BehrensG/ETH3CDAQ1/hardware/project/ETH3CADC1/ETH3CADC1.kicad_pcb

## KiCad design hardware/project/ETH3CADC1/ETH3CADC1.kicad_pcb (2021-01-28)

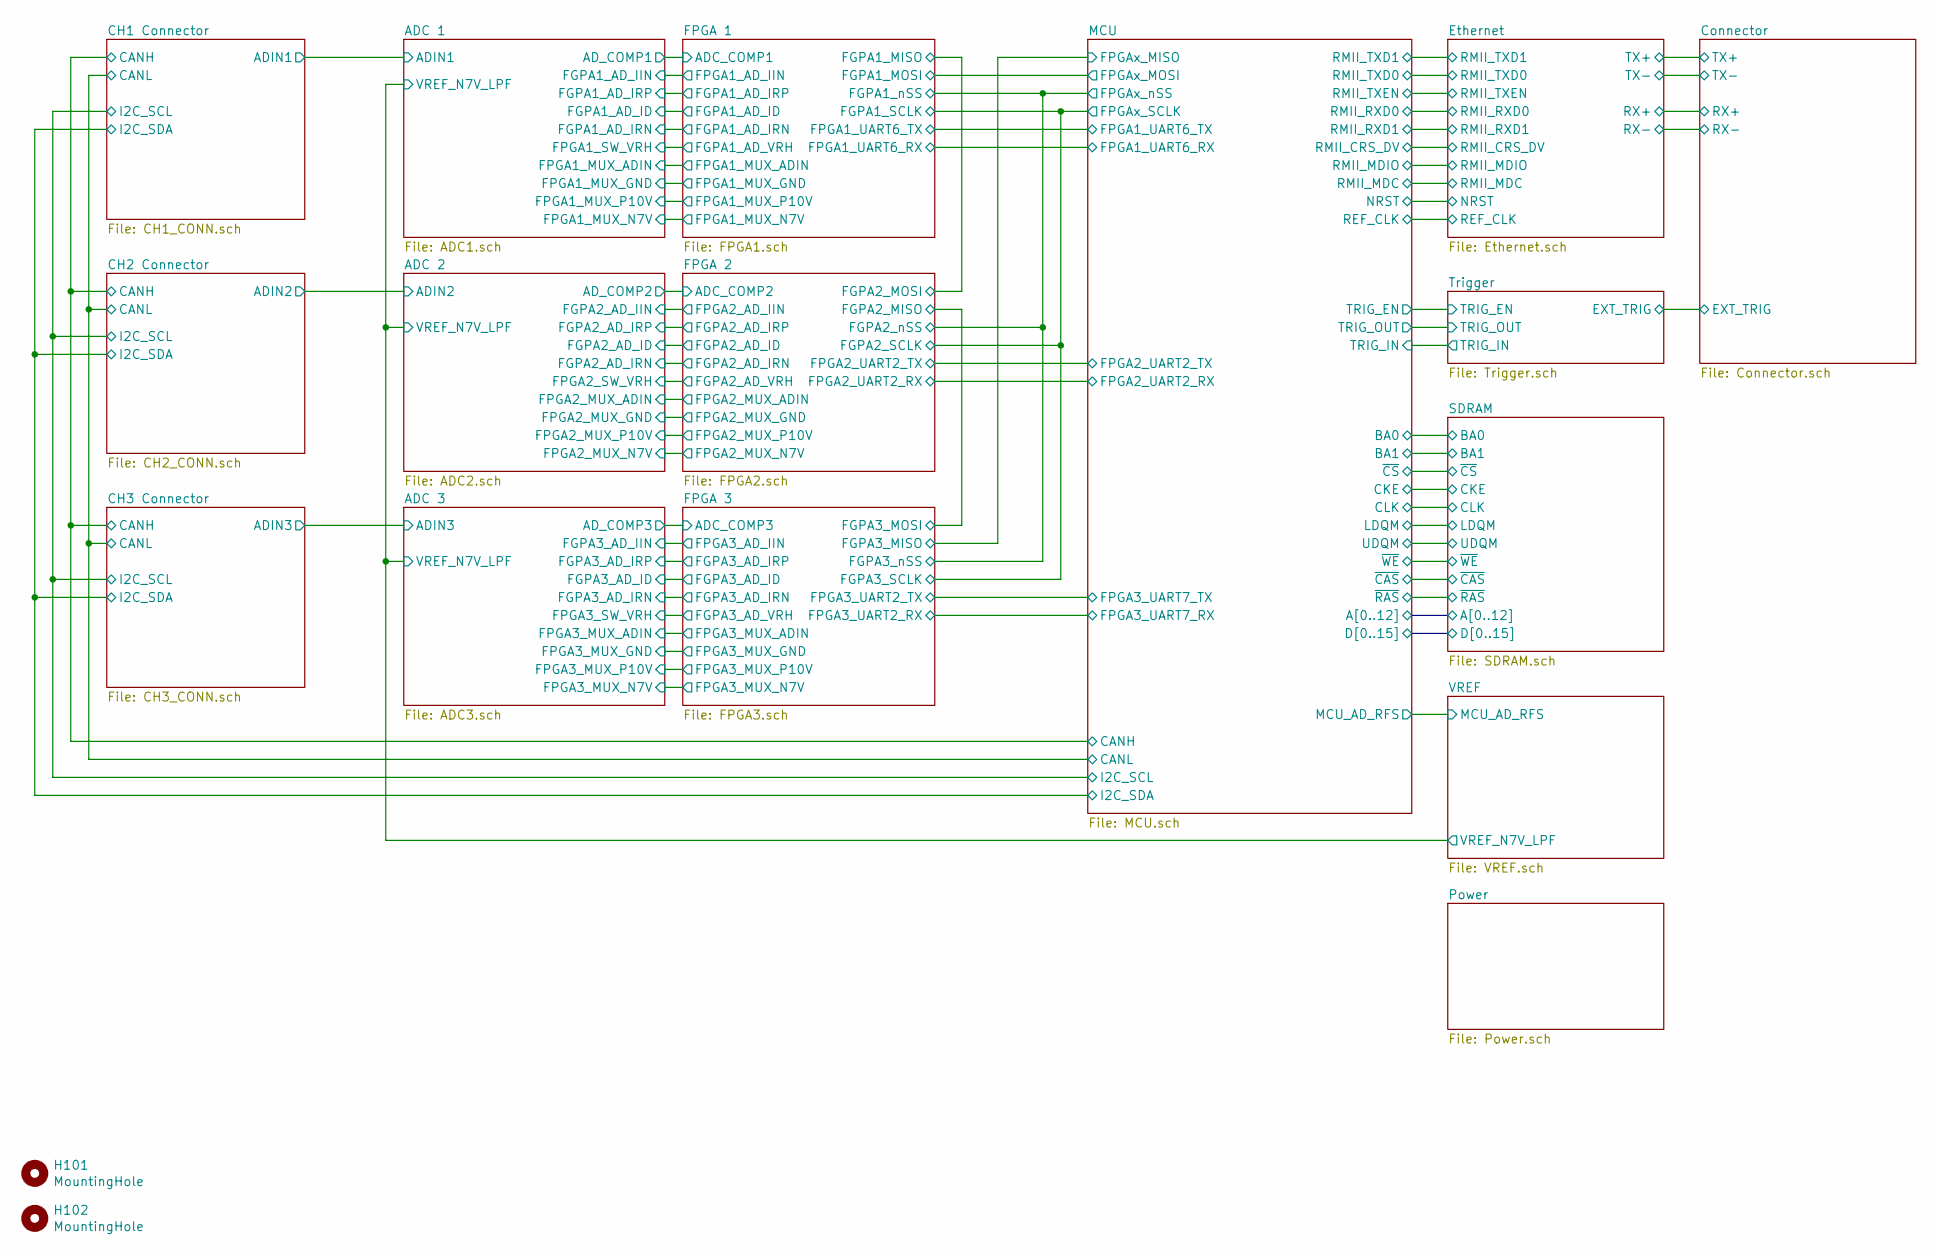
[picture p1: schematic ETH3CADC1.sch]

Parts:
H101, H102: MountingHole; MountingHole_3.2mm_M3_DIN965_Pad

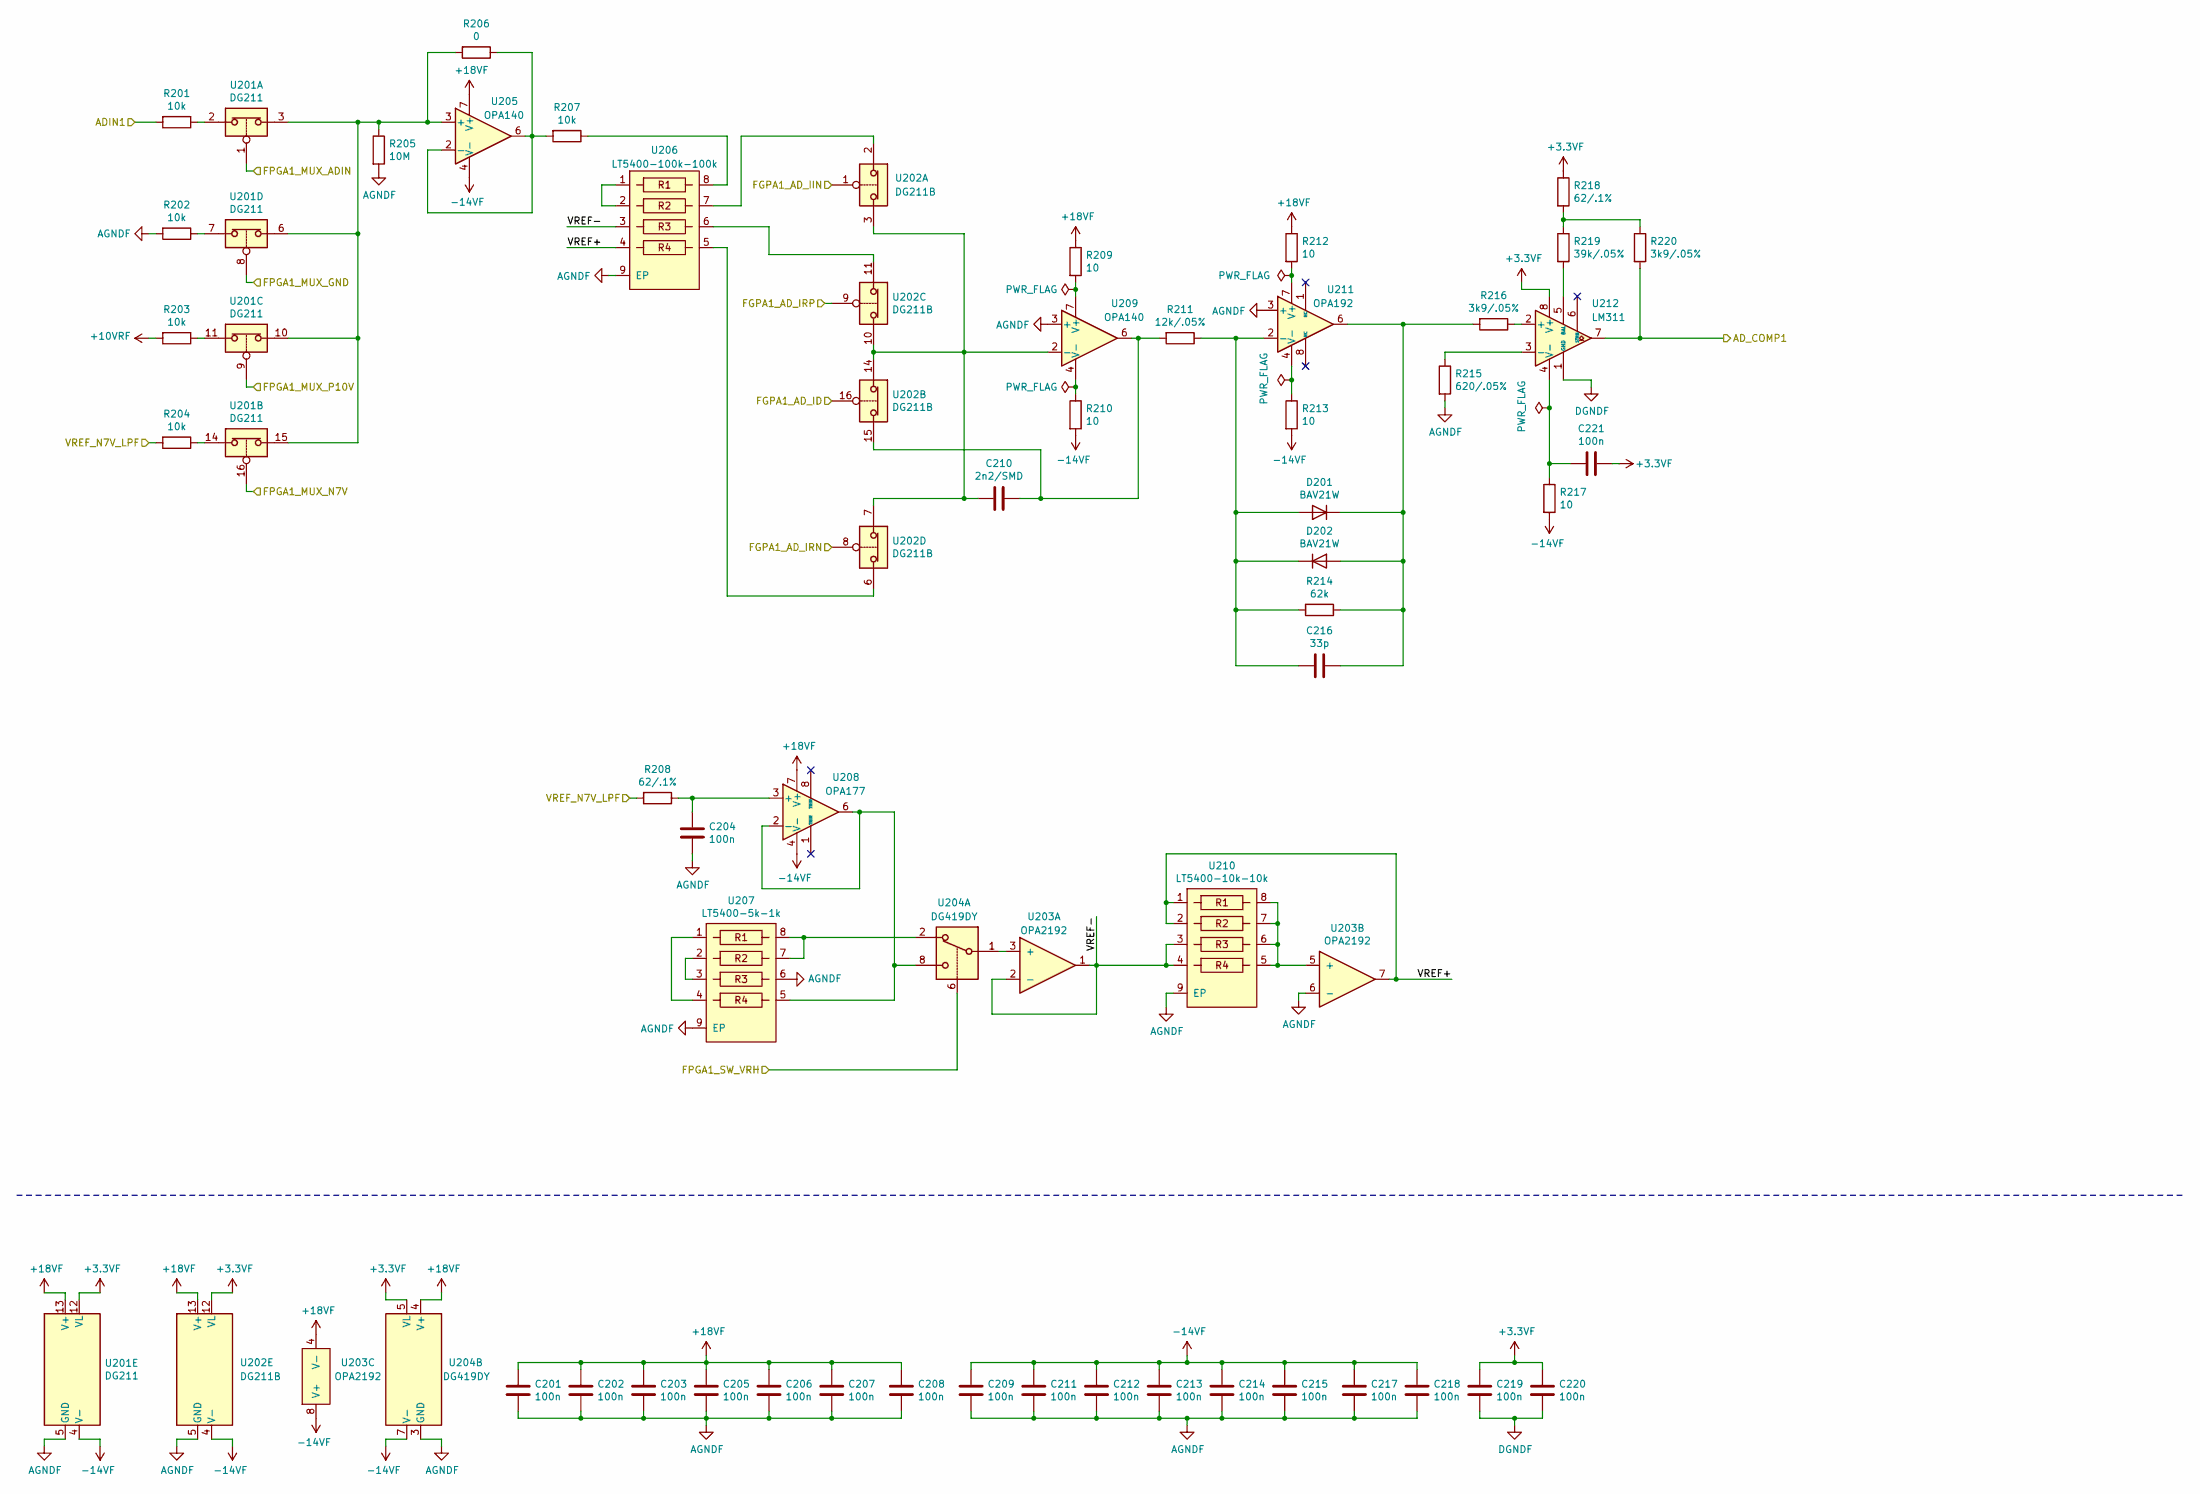
[picture p2: schematic ADC1.sch, ADC]

Parts:
C201, C202, C203, C204, C205, C206, C207, C208, C209, C211, C212, C213, C214, C215, C217, C218, C219, C220, C221: 100n; C_0402_1005Metric_Pad0.74x0.62mm_HandSolder
C210: 2n2/SMD; C_0603_1608Metric_Pad1.08x0.95mm_HandSolder
C216: 33p; C_0402_1005Metric_Pad0.74x0.62mm_HandSolder
D201, D202: BAV21W; D_SOD-123
R201, R202, R203, R204, R207: 10k; R_0402_1005Metric_Pad0.72x0.64mm_HandSolder
R205: 10M; R_0603_1608Metric_Pad0.98x0.95mm_HandSolder
R206: 0; R_0402_1005Metric_Pad0.72x0.64mm_HandSolder
R208, R218: 62/.1%; R_0603_1608Metric_Pad0.98x0.95mm_HandSolder
R209, R210, R212, R213, R217: 10; R_0402_1005Metric_Pad0.72x0.64mm_HandSolder
R211: 12k/.05%; R_0603_1608Metric_Pad0.98x0.95mm_HandSolder
R214: 62k; R_0402_1005Metric_Pad0.72x0.64mm_HandSolder
R215: 620/.05%; R_0603_1608Metric_Pad0.98x0.95mm_HandSolder
R216, R220: 3k9/.05%; R_0603_1608Metric_Pad0.98x0.95mm_HandSolder
R219: 39k/.05%; R_0603_1608Metric_Pad0.98x0.95mm_HandSolder
U201: DG211; TSSOP-16_4.4x5mm_P0.65mm
U202: DG211B; TSSOP-16_4.4x5mm_P0.65mm
U203: OPA2192; SOIC-8_3.9x4.9mm_P1.27mm
U204: DG419DY; SOIC-8_3.9x4.9mm_P1.27mm
U205, U209: OPA140; SOIC-8_3.9x4.9mm_P1.27mm
U206: LT5400-100k-100k; MSOP-8-1EP_3x3mm_P0.65mm_EP1.73x1.85mm_ThermalVias
U207: LT5400-5k-1k; MSOP-8-1EP_3x3mm_P0.65mm_EP1.73x1.85mm_ThermalVias
U208: OPA177; SOIC-8_3.9x4.9mm_P1.27mm
U210: LT5400-10k-10k; MSOP-8-1EP_3x3mm_P0.65mm_EP1.73x1.85mm_ThermalVias
U211: OPA192; SOIC-8_3.9x4.9mm_P1.27mm
U212: LM311; SOIC-8_3.9x4.9mm_P1.27mm

Connections:
+10VRF: R203.2; also elsewhere on the board
+18VF: C201.1, C202.1, C203.1, C205.1, C206.1, C207.1, C208.1, R209.1, R212.1, U201.13 (V+), U202.13 (V+), U203.4 (V-), U204.4 (V+), U205.7 (V+), U208.7 (V+); also elsewhere on the board
-14VF: C209.1, C211.1, C212.1, C213.1, C214.1, C215.1, C217.1, C218.1, R210.2, R213.2, R217.2, U201.4 (V-), U202.4 (V-), U203.8 (V+), U204.7 (V-), U205.4 (V-), U208.4 (V-); also elsewhere on the board
/ADC 1/ADIN1: R201.2; also elsewhere on the board
/ADC 1/FGPA1_AD_ID: U202.16; also elsewhere on the board
/ADC 1/FGPA1_AD_IIN: U202.1; also elsewhere on the board
/ADC 1/FGPA1_AD_IRN: U202.8; also elsewhere on the board
/ADC 1/FGPA1_AD_IRP: U202.9; also elsewhere on the board
/ADC 1/FPGA1_MUX_ADIN: U201.1; also elsewhere on the board
/ADC 1/FPGA1_MUX_GND: U201.8; also elsewhere on the board
/ADC 1/FPGA1_MUX_N7V: U201.16; also elsewhere on the board
/ADC 1/FPGA1_MUX_P10V: U201.9; also elsewhere on the board
/ADC 1/VREF+: U203.7, U206.4, U210.1, U210.2
/ADC 1/VREF-: U203.1, U203.2 (-), U206.3, U210.3, U210.4
/ADC 1/VREF_N7V_LPF: R204.2, R208.2; also elsewhere on the board
/FPGA 1/ADC_COMP1: R220.2, U212.7; also elsewhere on the board
/FPGA 1/FGPA1_AD_VRH: U204.6; also elsewhere on the board
AGNDF: C201.2, C202.2, C203.2, C204.2, C205.2, C206.2, C207.2, C208.2, C209.2, C211.2, C212.2, C213.2, C214.2, C215.2, C217.2, C218.2, C219.2, C220.2, R202.2, R205.2, R215.2, U201.5 (GND), U202.5 (GND), U203.6 (-), U204.3 (GND), U206.9 (EP), U207.6, U207.9 (EP), U209.3 (+), U210.9 (EP), U211.3 (+), U212.1 (GND); also elsewhere on the board
unnamed: C204.1, R208.1, U208.3 (+)
unnamed: C210.1, R211.2, U202.15, U209.6
unnamed: C210.2, U202.3, U202.7, U202.10, U202.14, U209.2 (-)
unnamed: C216.1, D201.1 (K), D202.2 (A), R214.1, R216.2, U211.6
unnamed: C216.2, D201.2 (A), D202.1 (K), R211.1, R214.2, U211.2 (-)
unnamed: C221.2, R217.1, U212.4 (V-)
unnamed: R201.1, U201.2
unnamed: R202.1, U201.7
unnamed: R203.1, U201.11
unnamed: R204.1, U201.14
unnamed: R205.1, R206.2, U201.3, U201.6, U201.10, U201.15, U205.3 (+)
unnamed: R206.1, R207.2, U205.2 (-), U205.6
unnamed: R207.1, U206.8
unnamed: R209.2, U209.7 (V+)
unnamed: R210.1, U209.4 (V-)
unnamed: R212.2, U211.7 (V+)
unnamed: R213.1, U211.4 (V-)
unnamed: R215.1, U212.3 (-)
unnamed: R216.1, U212.2 (+)
unnamed: R218.2, R219.1, R220.1
unnamed: R219.2, U212.5 (BAL)
unnamed: U202.2, U206.7
unnamed: U202.6, U206.5
unnamed: U202.11, U206.6
unnamed: U203.3 (+), U204.1
unnamed: U203.5 (+), U210.5, U210.6, U210.7, U210.8
unnamed: U204.2, U207.7, U207.8
unnamed: U204.8, U207.5, U208.2 (-), U208.6
unnamed: U206.1, U206.2
unnamed: U207.1, U207.4
unnamed: U207.2, U207.3

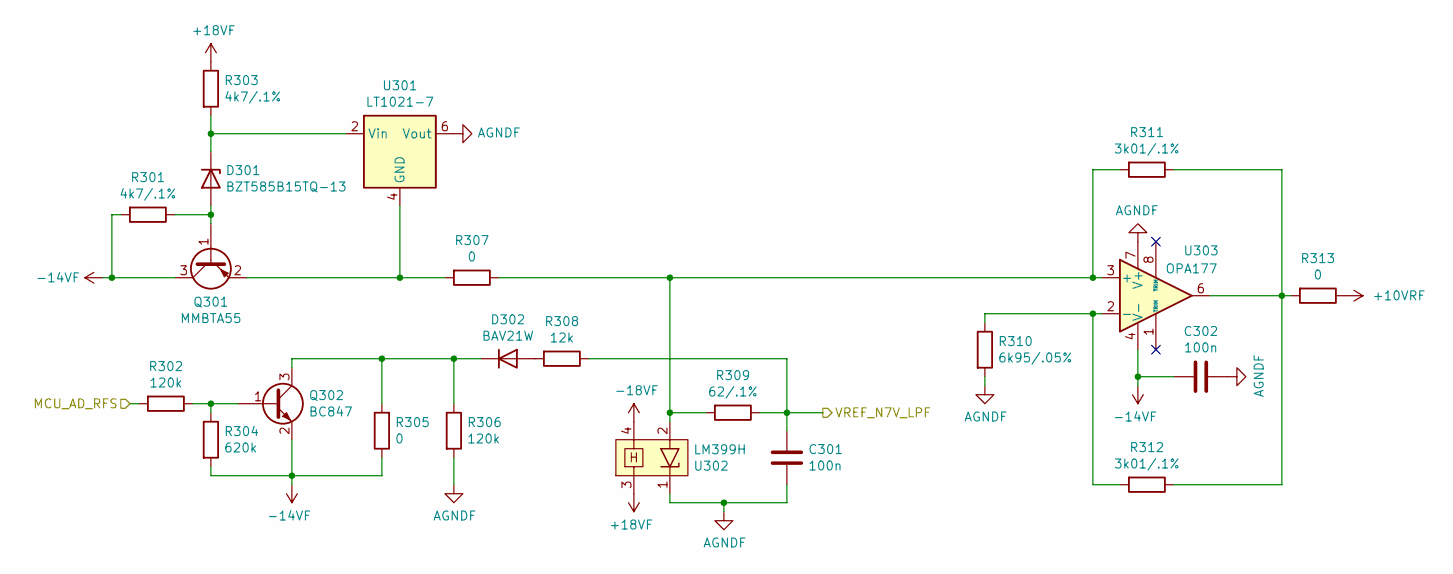
[picture p3: schematic VREF.sch]

Parts:
C301, C302: 100n; C_0402_1005Metric_Pad0.74x0.62mm_HandSolder
D301: BZT585B15TQ-13; D_SOD-523
D302: BAV21W; D_SOD-123
Q301: MMBTA55; SOT-23
Q302: BC847; SOT-23
R301, R303: 4k7/.1%; R_0603_1608Metric_Pad0.98x0.95mm_HandSolder
R302, R306: 120k; R_0402_1005Metric_Pad0.72x0.64mm_HandSolder
R304: 620k; R_0402_1005Metric_Pad0.72x0.64mm_HandSolder
R305, R307: 0; R_0402_1005Metric_Pad0.72x0.64mm_HandSolder
R308: 12k; R_0402_1005Metric_Pad0.72x0.64mm_HandSolder
R309: 62/.1%; R_0603_1608Metric_Pad0.98x0.95mm_HandSolder
R310: 6k95/.05%; R_0603_1608Metric_Pad0.98x0.95mm_HandSolder
R311, R312: 3k01/.1%; R_0603_1608Metric_Pad0.98x0.95mm_HandSolder
R313: 0; R_0603_1608Metric_Pad0.98x0.95mm_HandSolder
U301: LT1021-7; SOIC-8_3.9x4.9mm_P1.27mm
U302: LM399H; LMx99
U303: OPA177; SOIC-8_3.9x4.9mm_P1.27mm

Connections:
+10VRF: R313.1; also elsewhere on the board
+18VF: R303.1, U302.3; also elsewhere on the board
-14VF: C302.2, Q301.3 (C), Q302.2 (E), R301.2, R304.2, R305.1, U303.4 (V-); also elsewhere on the board
-18VF: U302.4; also elsewhere on the board
/ADC 1/VREF_N7V_LPF: C301.1, R308.1, R309.1; also elsewhere on the board
/MCU/MCU_AD_RFS: R302.2; also elsewhere on the board
AGNDF: C301.2, C302.1, R306.2, R310.2, U301.6 (Vout), U302.1, U303.7 (V+); also elsewhere on the board
unnamed: D301.1 (K), R303.2, U301.2 (Vin)
unnamed: D301.2 (A), Q301.1 (B), R301.1
unnamed: D302.1 (K), Q302.3 (C), R305.2, R306.1
unnamed: D302.2 (A), R308.2
unnamed: Q301.2 (E), R307.2, U301.4 (GND)
unnamed: Q302.1 (B), R302.1, R304.1
unnamed: R307.1, R309.2, R311.2, U302.2, U303.3 (+)
unnamed: R310.1, R312.2, U303.2 (-)
unnamed: R311.1, R312.1, R313.2, U303.6

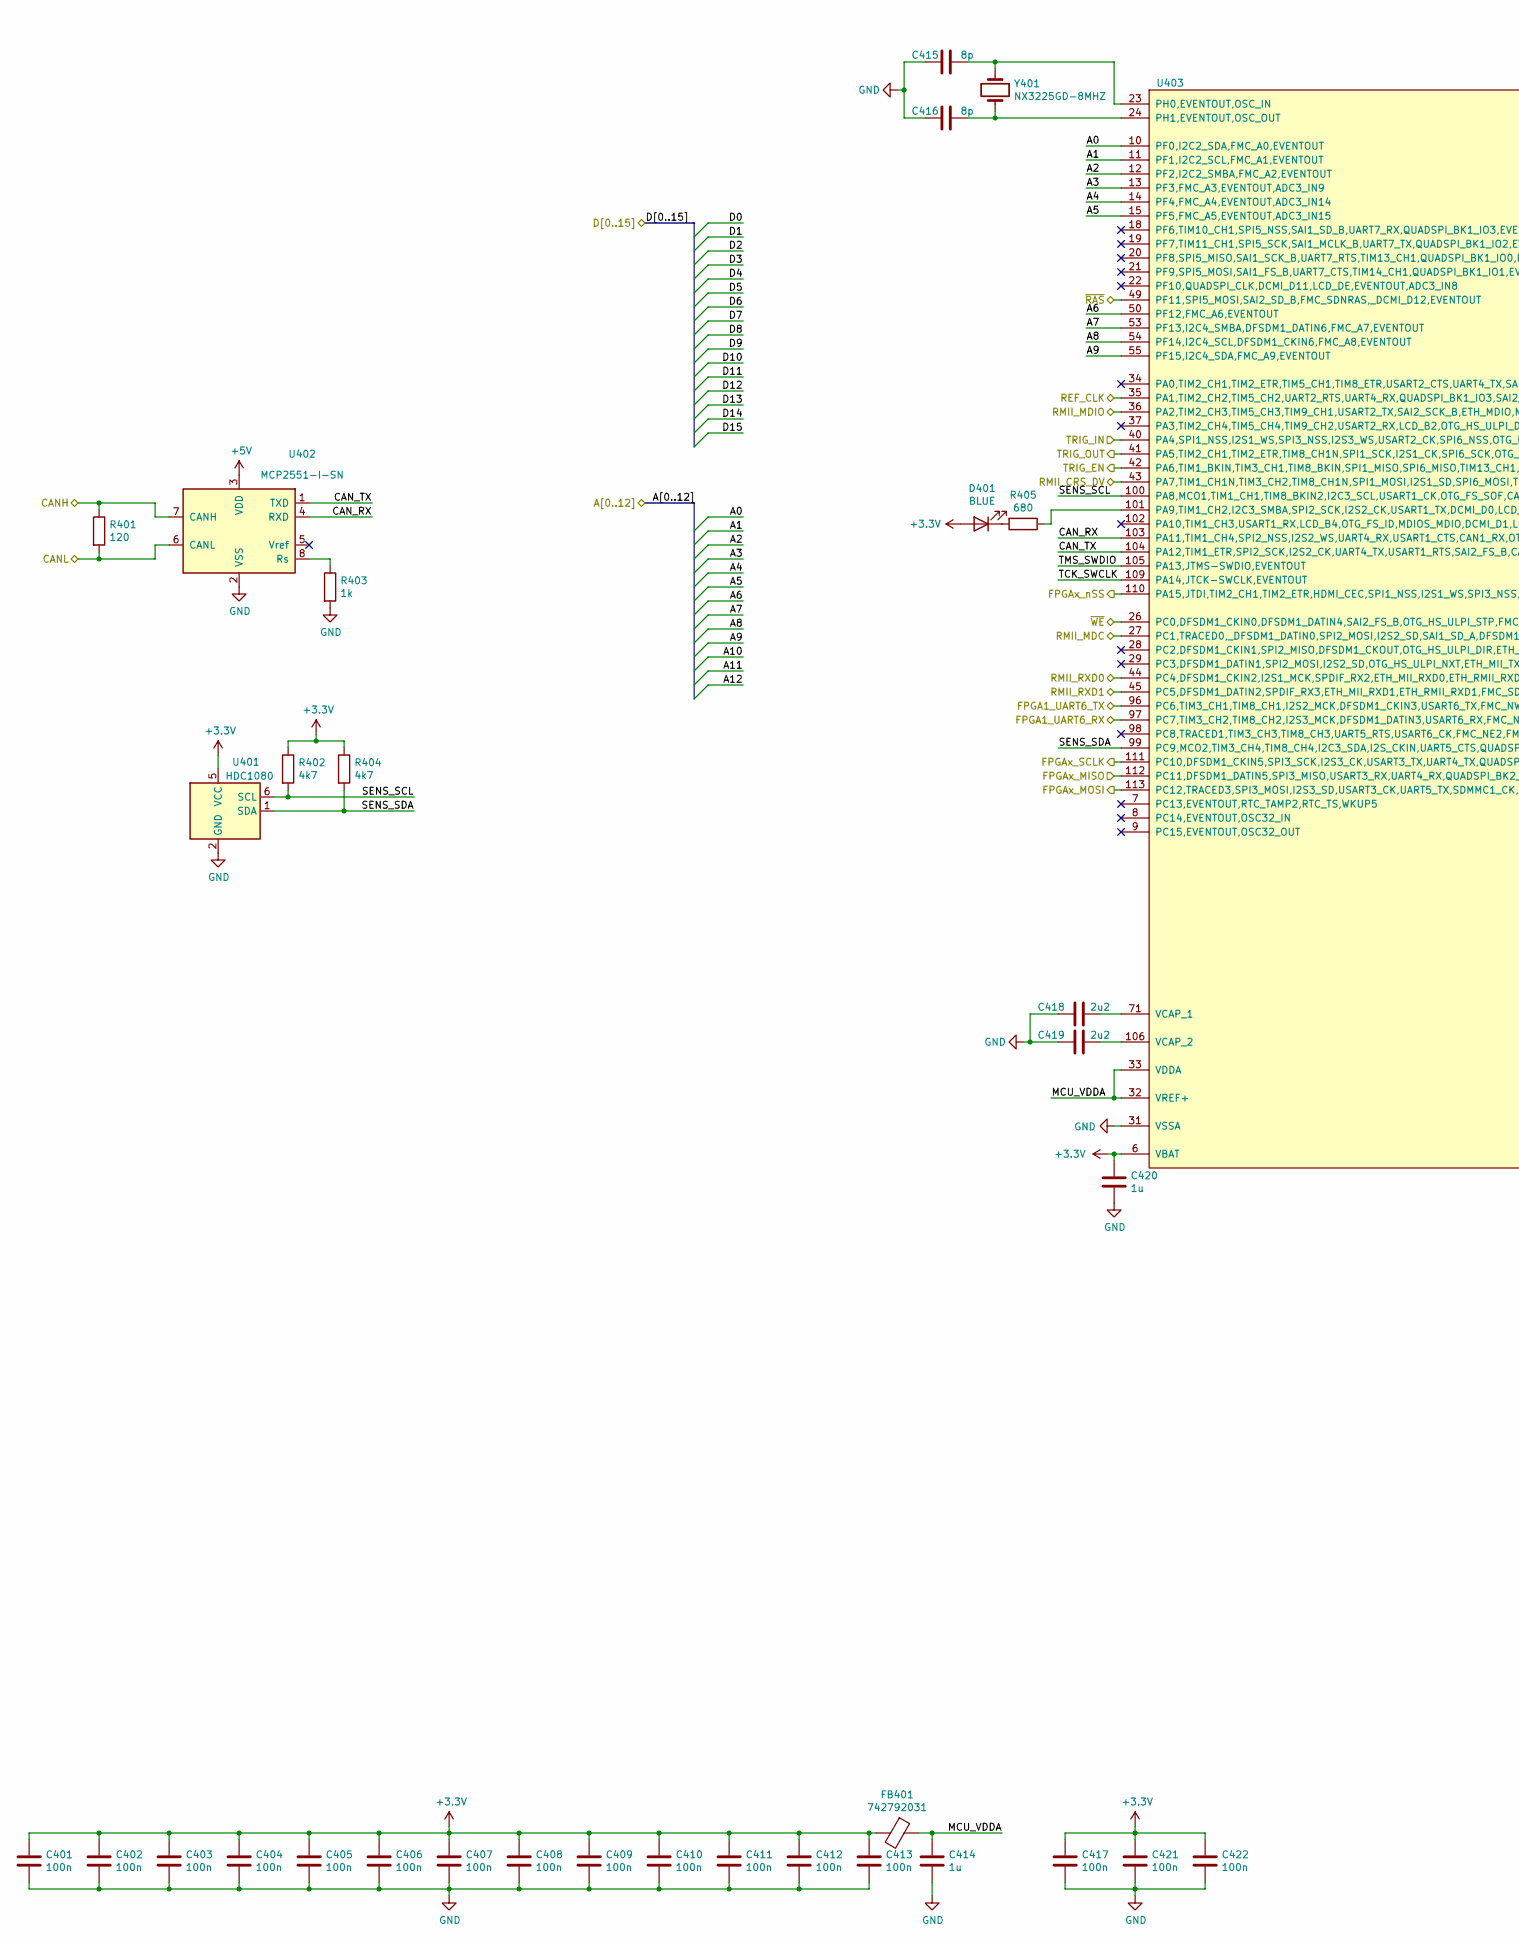
[picture p4: schematic MCU.sch, part in row 1, column 1]

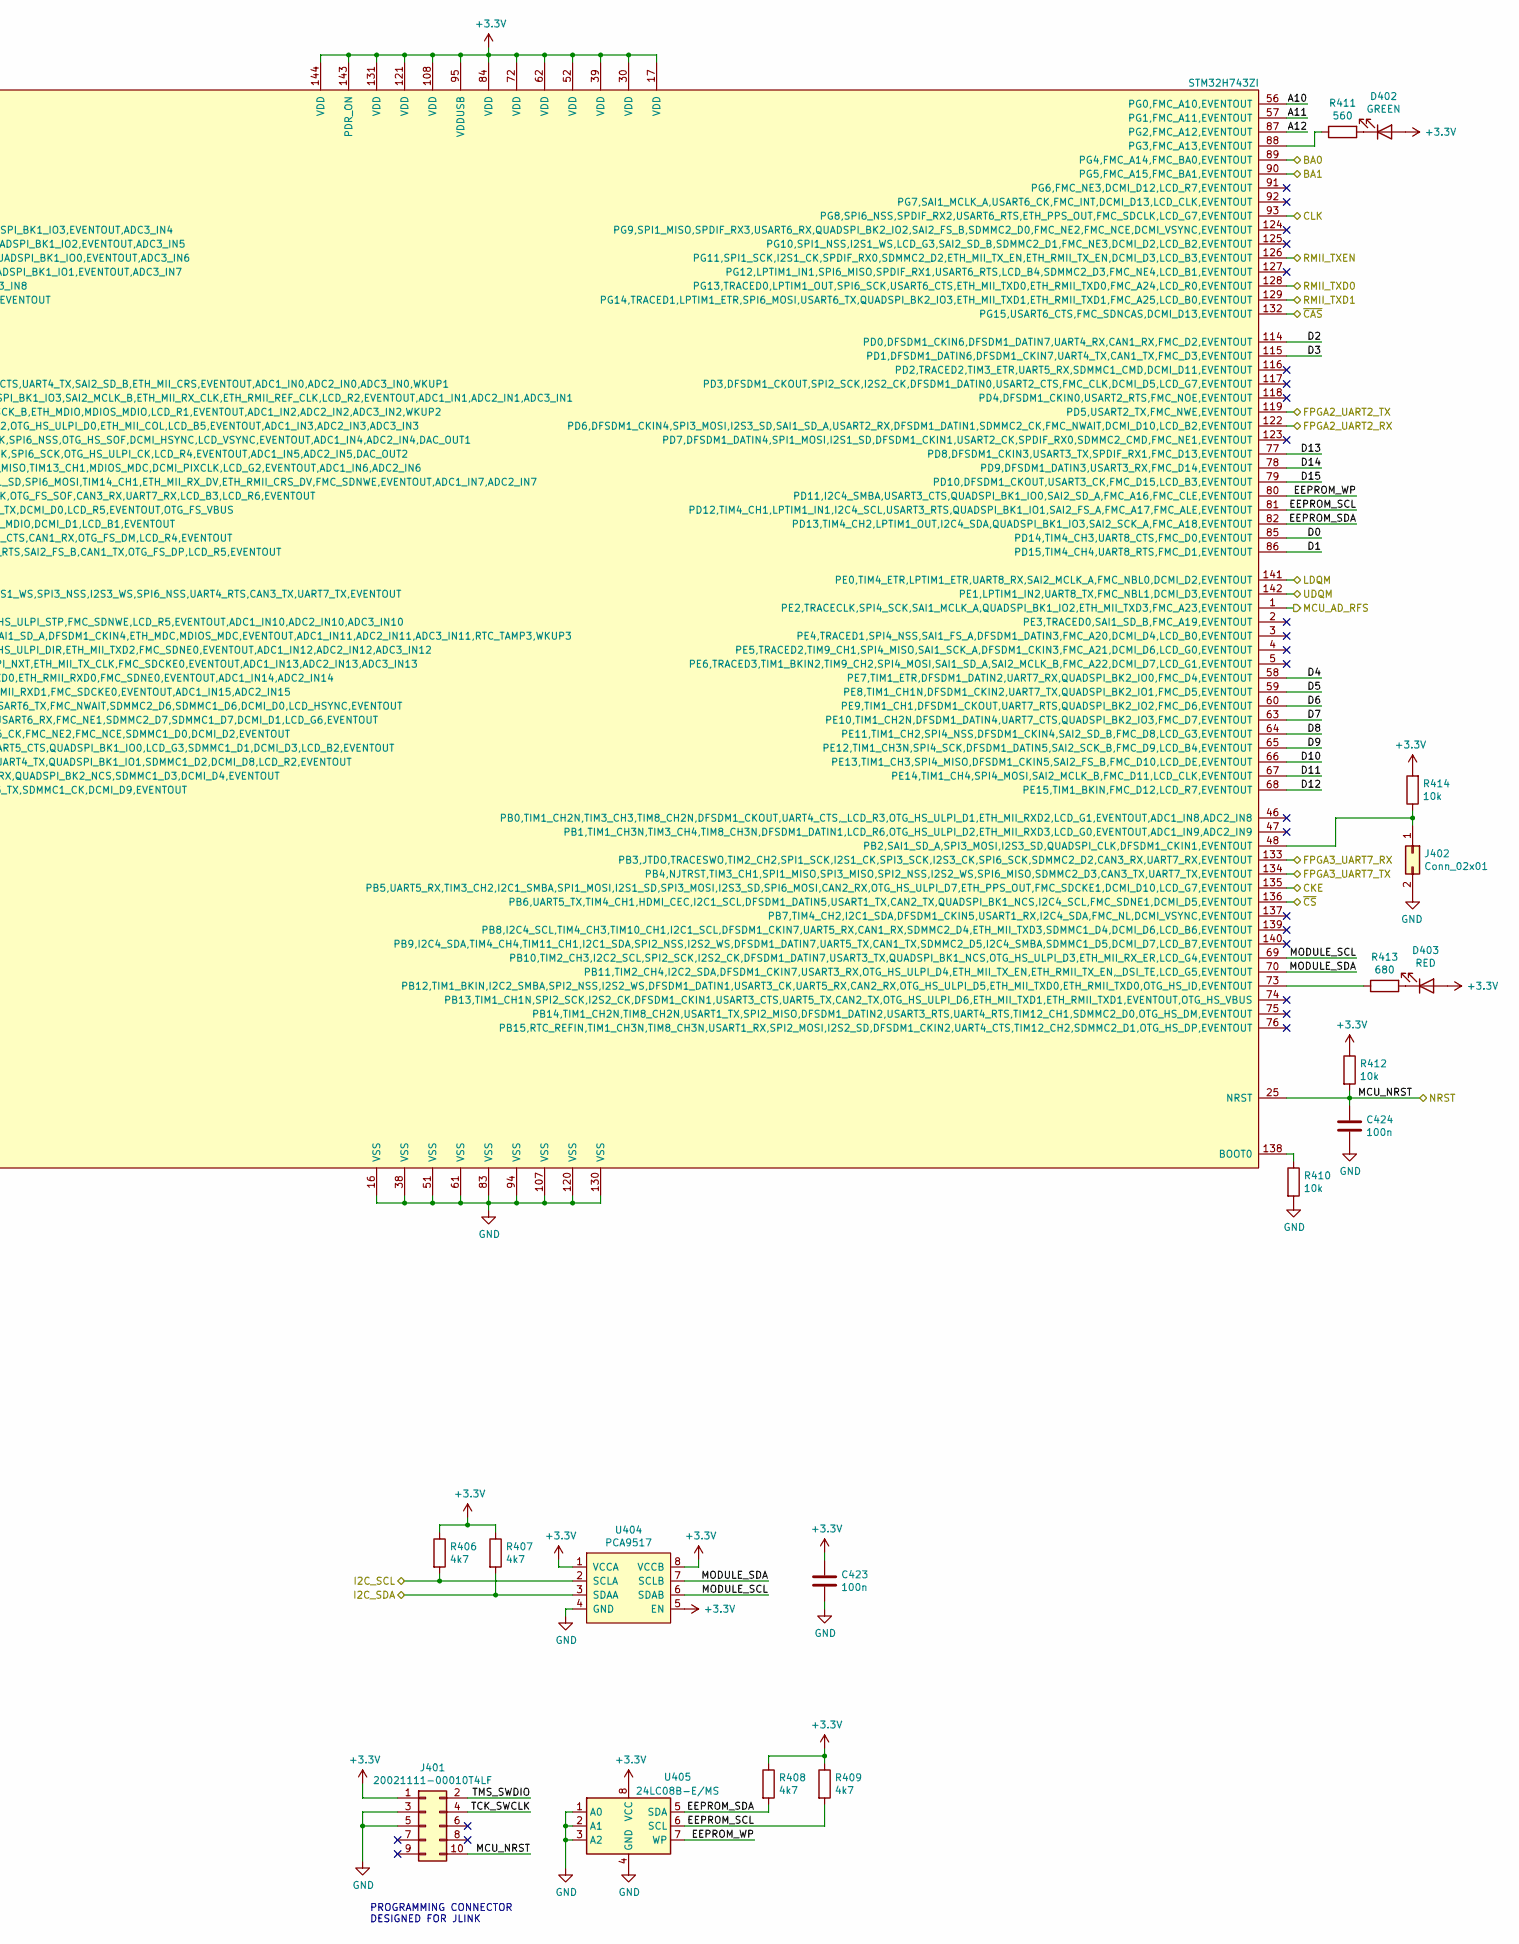
[picture p5: schematic MCU.sch, part in row 1, column 2]

Parts:
C401, C402, C403, C404, C405, C406, C407, C408, C409, C410, C411, C412, C413, C417, C421, C422, C423, C424: 100n; C_0402_1005Metric_Pad0.74x0.62mm_HandSolder
C414, C420: 1u; C_0402_1005Metric_Pad0.74x0.62mm_HandSolder
C415, C416: 8p; C_0402_1005Metric_Pad0.74x0.62mm_HandSolder
C418, C419: 2u2; C_0402_1005Metric_Pad0.74x0.62mm_HandSolder
D401: BLUE; LED_0603_1608Metric_Pad1.05x0.95mm_HandSolder
D402: GREEN; LED_0603_1608Metric_Pad1.05x0.95mm_HandSolder
D403: RED; LED_0603_1608Metric_Pad1.05x0.95mm_HandSolder
FB401: 742792031; L_0603_1608Metric_Pad1.05x0.95mm_HandSolder
J401: 20021111-00010T4LF; PinHeader_2x05_P1.27mm_Vertical
J402: Conn_02x01; PinHeader_1x02_P2.54mm_Vertical
R401: 120; R_0402_1005Metric_Pad0.72x0.64mm_HandSolder
R402, R404, R406, R407, R408, R409: 4k7; R_0402_1005Metric_Pad0.72x0.64mm_HandSolder
R403: 1k; R_0402_1005Metric_Pad0.72x0.64mm_HandSolder
R405, R413: 680; R_0402_1005Metric_Pad0.72x0.64mm_HandSolder
R410, R412, R414: 10k; R_0402_1005Metric_Pad0.72x0.64mm_HandSolder
R411: 560; R_0402_1005Metric_Pad0.72x0.64mm_HandSolder
U401: HDC1080; Texas_PWSON-N6
U402: MCP2551-I-SN; SOIC-8_3.9x4.9mm_P1.27mm
U403: STM32H743ZI; TQFP-144_20x20mm_P0.5mm
U404: PCA9517; MSOP-8_3x3mm_P0.65mm
U405: 24LC08B-E/MS; MSOP-8_3x3mm_P0.65mm
Y401: NX3225GD-8MHZ; NX3225GD

Connections:
+5V: U402.3 (VDD); also elsewhere on the board
/CH1 Connector/CANH: R401.1, U402.7 (CANH); also elsewhere on the board
/CH1 Connector/CANL: R401.2, U402.6 (CANL); also elsewhere on the board
/CH1 Connector/I2C_SCL: R406.2, U404.2 (SCLA); also elsewhere on the board
/CH1 Connector/I2C_SDA: R407.2, U404.3 (SDAA); also elsewhere on the board
/Ethernet/NRST: C424.1, J401.10, R412.2, U403.25 (NRST); also elsewhere on the board
/Ethernet/REF_CLK: U403.35 (PA1,TIM2_CH2,TIM5_CH2,UART2_RTS,UART4_R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); also elsewhere on the board
/Ethernet/RMII_CRS_DV: U403.43 (PA7,TIM1_CH1N,TIM3_CH2,TIM8_CH1N,SPI1_M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); also elsewhere on the board
/Ethernet/RMII_MDC: U403.27 (PC1,TRACED0,_DFSDM1_DATIN0,SPI2_MOSI,I2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); also elsewhere on the board
/Ethernet/RMII_MDIO: U403.36 (PA2,TIM2_CH3,TIM5_CH3,TIM9_CH1,USART2_T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); also elsewhere on the board
/Ethernet/RMII_RXD0: U403.44 (PC4,DFSDM1_CKIN2,I2S1_MCK,SPDIF_RX2,ETH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); also elsewhere on the board
/Ethernet/RMII_RXD1: U403.45 (PC5,DFSDM1_DATIN2,SPDIF_RX3,ETH_MII_RXD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); also elsewhere on the board
/Ethernet/RMII_TXD0: U403.128 (PG13,TRACED0,LPTIM1_OUT,SPI6_SCK,USART6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); also elsewhere on the board
/Ethernet/RMII_TXD1: U403.129 (PG14,TRACED1,LPTIM1_ETR,SPI6_MOSI,USART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); also elsewhere on the board
/Ethernet/RMII_TXEN: U403.126 (PG11,SPI1_SCK,I2S1_CK,SPDIF_RX0,SDMMC2_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); also elsewhere on the board
/FPGA 1/FGPA1_MOSI: U403.113 (PC12,TRACED3,SPI3_MOSI,I2S3_SD,USART3_C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); also elsewhere on the board
/FPGA 1/FGPA1_SCLK: U403.111 (PC10,DFSDM1_CKIN5,SPI3_SCK,I2S3_CK,USAR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); also elsewhere on the board
/FPGA 1/FGPA1_nSS: U403.110 (PA15,JTDI,TIM2_CH1,TIM2_ETR,HDMI_CEC,SP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); also elsewhere on the board
/FPGA 1/FPGA1_UART6_RX: U403.97 (PC7,TIM3_CH2,TIM8_CH2,I2S3_MCK,DFSDM1_D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); also elsewhere on the board
/FPGA 1/FPGA1_UART6_TX: U403.96 (PC6,TIM3_CH1,TIM8_CH1,I2S2_MCK,DFSDM1_C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); also elsewhere on the board
/FPGA 2/FPGA2_UART2_RX: U403.122 (PD6,DFSDM1_CKIN4,SPI3_MOSI,I2S3_SD,SAI1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); also elsewhere on the board
/FPGA 2/FPGA2_UART2_TX: U403.119 (PD5,USART2_TX,FMC_NWE,EVENTOUT); also elsewhere on the board
/FPGA 3/FGPA3_MISO: U403.112 (PC11,DFSDM1_DATIN5,SPI3_MISO,USART3_RX,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); also elsewhere on the board
/FPGA 3/FPGA3_UART2_RX: U403.133 (PB3,JTDO,TRACESWO,TIM2_CH2,SPI1_SCK,I2S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); also elsewhere on the board
/FPGA 3/FPGA3_UART2_TX: U403.134 (PB4,NJTRST,TIM3_CH1,SPI1_MISO,SPI3_MISO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); also elsewhere on the board
/MCU/A0: U403.10 (PF0,I2C2_SDA,FMC_A0,EVENTOUT); also elsewhere on the board
/MCU/A1: U403.11 (PF1,I2C2_SCL,FMC_A1,EVENTOUT); also elsewhere on the board
/MCU/A2: U403.12 (PF2,I2C2_SMBA,FMC_A2,EVENTOUT); also elsewhere on the board
/MCU/A3: U403.13 (PF3,FMC_A3,EVENTOUT,ADC3_IN9); also elsewhere on the board
/MCU/A4: U403.14 (PF4,FMC_A4,EVENTOUT,ADC3_IN14); also elsewhere on the board
/MCU/A5: U403.15 (PF5,FMC_A5,EVENTOUT,ADC3_IN15); also elsewhere on the board
/MCU/A6: U403.50 (PF12,FMC_A6,EVENTOUT); also elsewhere on the board
/MCU/A7: U403.53 (PF13,I2C4_SMBA,DFSDM1_DATIN6,FMC_A7,EVE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); also elsewhere on the board
/MCU/A8: U403.54 (PF14,I2C4_SCL,DFSDM1_CKIN6,FMC_A8,EVENT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); also elsewhere on the board
/MCU/A9: U403.55 (PF15,I2C4_SDA,FMC_A9,EVENTOUT); also elsewhere on the board
/MCU/A10: U403.56 (PG0,FMC_A10,EVENTOUT); also elsewhere on the board
/MCU/A11: U403.57 (PG1,FMC_A11,EVENTOUT); also elsewhere on the board
/MCU/A12: U403.87 (PG2,FMC_A12,EVENTOUT); also elsewhere on the board
/MCU/BA0: U403.89 (PG4,FMC_A14,FMC_BA0,EVENTOUT); also elsewhere on the board
/MCU/BA1: U403.90 (PG5,FMC_A15,FMC_BA1,EVENTOUT); also elsewhere on the board
/MCU/CAN_RX: U402.4 (RXD), U403.103 (PA11,TIM1_CH4,SPI2_NSS,I2S2_WS,UART4_RX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)
/MCU/CAN_TX: U402.1 (TXD), U403.104 (PA12,TIM1_ETR,SPI2_SCK,I2S2_CK,UART4_TX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)
/MCU/CKE: U403.135 (PB5,UART5_RX,TIM3_CH2,I2C1_SMBA,SPI1_MO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); also elsewhere on the board
/MCU/CLK: U403.93 (PG8,SPI6_NSS,SPDIF_RX2,USART6_RTS,ETH_P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); also elsewhere on the board
/MCU/D0: U403.85 (PD14,TIM4_CH3,UART8_CTS,FMC_D0,EVENTOUT); also elsewhere on the board
/MCU/D1: U403.86 (PD15,TIM4_CH4,UART8_RTS,FMC_D1,EVENTOUT); also elsewhere on the board
/MCU/D2: U403.114 (PD0,DFSDM1_CKIN6,DFSDM1_DATIN7,UART4_RX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); also elsewhere on the board
/MCU/D3: U403.115 (PD1,DFSDM1_DATIN6,DFSDM1_CKIN7,UART4_TX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); also elsewhere on the board
/MCU/D4: U403.58 (PE7,TIM1_ETR,DFSDM1_DATIN2,UART7_RX,QUA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); also elsewhere on the board
/MCU/D5: U403.59 (PE8,TIM1_CH1N,DFSDM1_CKIN2,UART7_TX,QUA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); also elsewhere on the board
/MCU/D6: U403.60 (PE9,TIM1_CH1,DFSDM1_CKOUT,UART7_RTS,QUA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); also elsewhere on the board
/MCU/D7: U403.63 (PE10,TIM1_CH2N,DFSDM1_DATIN4,UART7_CTS,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); also elsewhere on the board
/MCU/D8: U403.64 (PE11,TIM1_CH2,SPI4_NSS,DFSDM1_CKIN4,SAI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); also elsewhere on the board
/MCU/D9: U403.65 (PE12,TIM1_CH3N,SPI4_SCK,DFSDM1_DATIN5,S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); also elsewhere on the board
/MCU/D10: U403.66 (PE13,TIM1_CH3,SPI4_MISO,DFSDM1_CKIN5,SA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); also elsewhere on the board
/MCU/D11: U403.67 (PE14,TIM1_CH4,SPI4_MOSI,SAI2_MCLK_B,FMC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); also elsewhere on the board
/MCU/D12: U403.68 (PE15,TIM1_BKIN,FMC_D12,LCD_R7,EVENTOUT); also elsewhere on the board
/MCU/D13: U403.77 (PD8,DFSDM1_CKIN3,USART3_TX,SPDIF_RX1,FM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); also elsewhere on the board
/MCU/D14: U403.78 (PD9,DFSDM1_DATIN3,USART3_RX,FMC_D14,EVE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); also elsewhere on the board
/MCU/D15: U403.79 (PD10,DFSDM1_CKOUT,USART3_CK,FMC_D15,LCD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); also elsewhere on the board
/MCU/EEPROM_SCL: R409.2, U403.81 (PD12,TIM4_CH1,LPTIM1_IN1,I2C4_SCL,USART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), U405.6 (SCL)
/MCU/EEPROM_SDA: R408.2, U403.82 (PD13,TIM4_CH2,LPTIM1_OUT,I2C4_SDA,QUADS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), U405.5 (SDA)
/MCU/EEPROM_WP: U403.80 (PD11,I2C4_SMBA,USART3_CTS,QUADSPI_BK1_I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), U405.7 (WP)
/MCU/LDQM: U403.141 (PE0,TIM4_ETR,LPTIM1_ETR,UART8_RX,SAI2_M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); also elsewhere on the board
/MCU/MCU_AD_RFS: U403.1 (PE2,TRACECLK,SPI4_SCK,SAI1_MCLK_A,QUADS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); also elsewhere on the board
/MCU/MCU_VDDA: C414.1, FB401.1, U403.32 (VREF+), U403.33 (VDDA)
/MCU/MODULE_SCL: U403.69 (PB10,TIM2_CH3,I2C2_SCL,SPI2_SCK,I2S2_CK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), U404.6 (SDAB)
/MCU/MODULE_SDA: U403.70 (PB11,TIM2_CH4,I2C2_SDA,DFSDM1_CKIN7,USA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), U404.7 (SCLB)
/MCU/SENS_SCL: R402.2, U401.6 (SCL), U403.100 (PA8,MCO1,TIM1_CH1,TIM8_BKIN2,I2C3_SCL,U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)
/MCU/SENS_SDA: R404.2, U401.1 (SDA), U403.99 (PC9,MCO2,TIM3_CH4,TIM8_CH4,I2C3_SDA,I2S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)
/MCU/TCK_SWCLK: J401.4, U403.109 (PA14,JTCK-SWCLK,EVENTOUT)
/MCU/TMS_SWDIO: J401.2, U403.105 (PA13,JTMS-SWDIO,EVENTOUT)
/MCU/TRIG_EN: U403.42 (PA6,TIM1_BKIN,TIM3_CH1,TIM8_BKIN,SPI1_M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); also elsewhere on the board
/MCU/TRIG_IN: U403.40 (PA4,SPI1_NSS,I2S1_WS,SPI3_NSS,I2S3_WS,U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); also elsewhere on the board
/MCU/TRIG_OUT: U403.41 (PA5,TIM2_CH1,TIM2_ETR,TIM8_CH1N,SPI1_SC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); also elsewhere on the board
/MCU/UDQM: U403.142 (PE1,LPTIM1_IN2,UART8_TX,FMC_NBL1,DCMI_D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); also elsewhere on the board
/MCU/~CAS: U403.132 (PG15,USART6_CTS,FMC_SDNCAS,DCMI_D13,EVE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); also elsewhere on the board
/MCU/~CS: U403.136 (PB6,UART5_TX,TIM4_CH1,HDMI_CEC,I2C1_SCL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); also elsewhere on the board
/MCU/~RAS: U403.49 (PF11,SPI5_MOSI,SAI2_SD_B,FMC_SDNRAS,_DC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); also elsewhere on the board
/MCU/~WE: U403.26 (PC0,DFSDM1_CKIN0,DFSDM1_DATIN4,SAI2_FS_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); also elsewhere on the board
AGNDF: C401.2, C402.2, C403.2, C404.2, C405.2, C406.2, C407.2, C408.2, C409.2, C410.2, C411.2, C412.2, C413.2, C414.2, C415.2, C416.2, C417.2, C418.2, C419.2, C420.2, C421.2, C422.2, C423.2, C424.2, J401.3, J401.5, J402.2, R403.2, R410.2, U401.2 (GND), U402.2 (VSS), U403.16 (VSS), U403.31 (VSSA), U403.38 (VSS), U403.51 (VSS), U403.61 (VSS), U403.83 (VSS), U403.94 (VSS), U403.107 (VSS), U403.120 (VSS), U403.130 (VSS), U404.4 (GND), U405.1 (A0), U405.2 (A1), U405.3 (A2), U405.4 (GND); also elsewhere on the board
unnamed: C415.1, U403.23 (PH0,EVENTOUT,OSC_IN), Y401.1
unnamed: C416.1, U403.24 (PH1,EVENTOUT,OSC_OUT), Y401.2
unnamed: C418.1, U403.71 (VCAP_1)
unnamed: C419.1, U403.106 (VCAP_2)
unnamed: D401.1 (K), R405.2
unnamed: D402.1 (K), R411.2
unnamed: D403.1 (K), R413.2
unnamed: J402.1, R414.1, U403.48 (PB2,SAI1_SD_A,SPI3_MOSI,I2S3_SD,QUADSPI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)
unnamed: R403.1, U402.8 (Rs)
unnamed: R405.1, U403.101 (PA9,TIM1_CH2,I2C3_SMBA,SPI2_SCK,I2S2_CK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)
unnamed: R410.1, U403.138 (BOOT0)
unnamed: R411.1, U403.88 (PG3,FMC_A13,EVENTOUT)
unnamed: R413.1, U403.73 (PB12,TIM1_BKIN,I2C2_SMBA,SPI2_NSS,I2S2_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)

Notes on the sheet:
PROGRAMMING CONNECTOR DESIGNED FOR JLINK
