BehrensG/ETH3CDAQ1/hardware/project/ETH3CADC1/ETH3CADC1.kicad_pcb

## KiCad design hardware/project/ETH3CADC1/ETH3CADC1.kicad_pcb (continued)

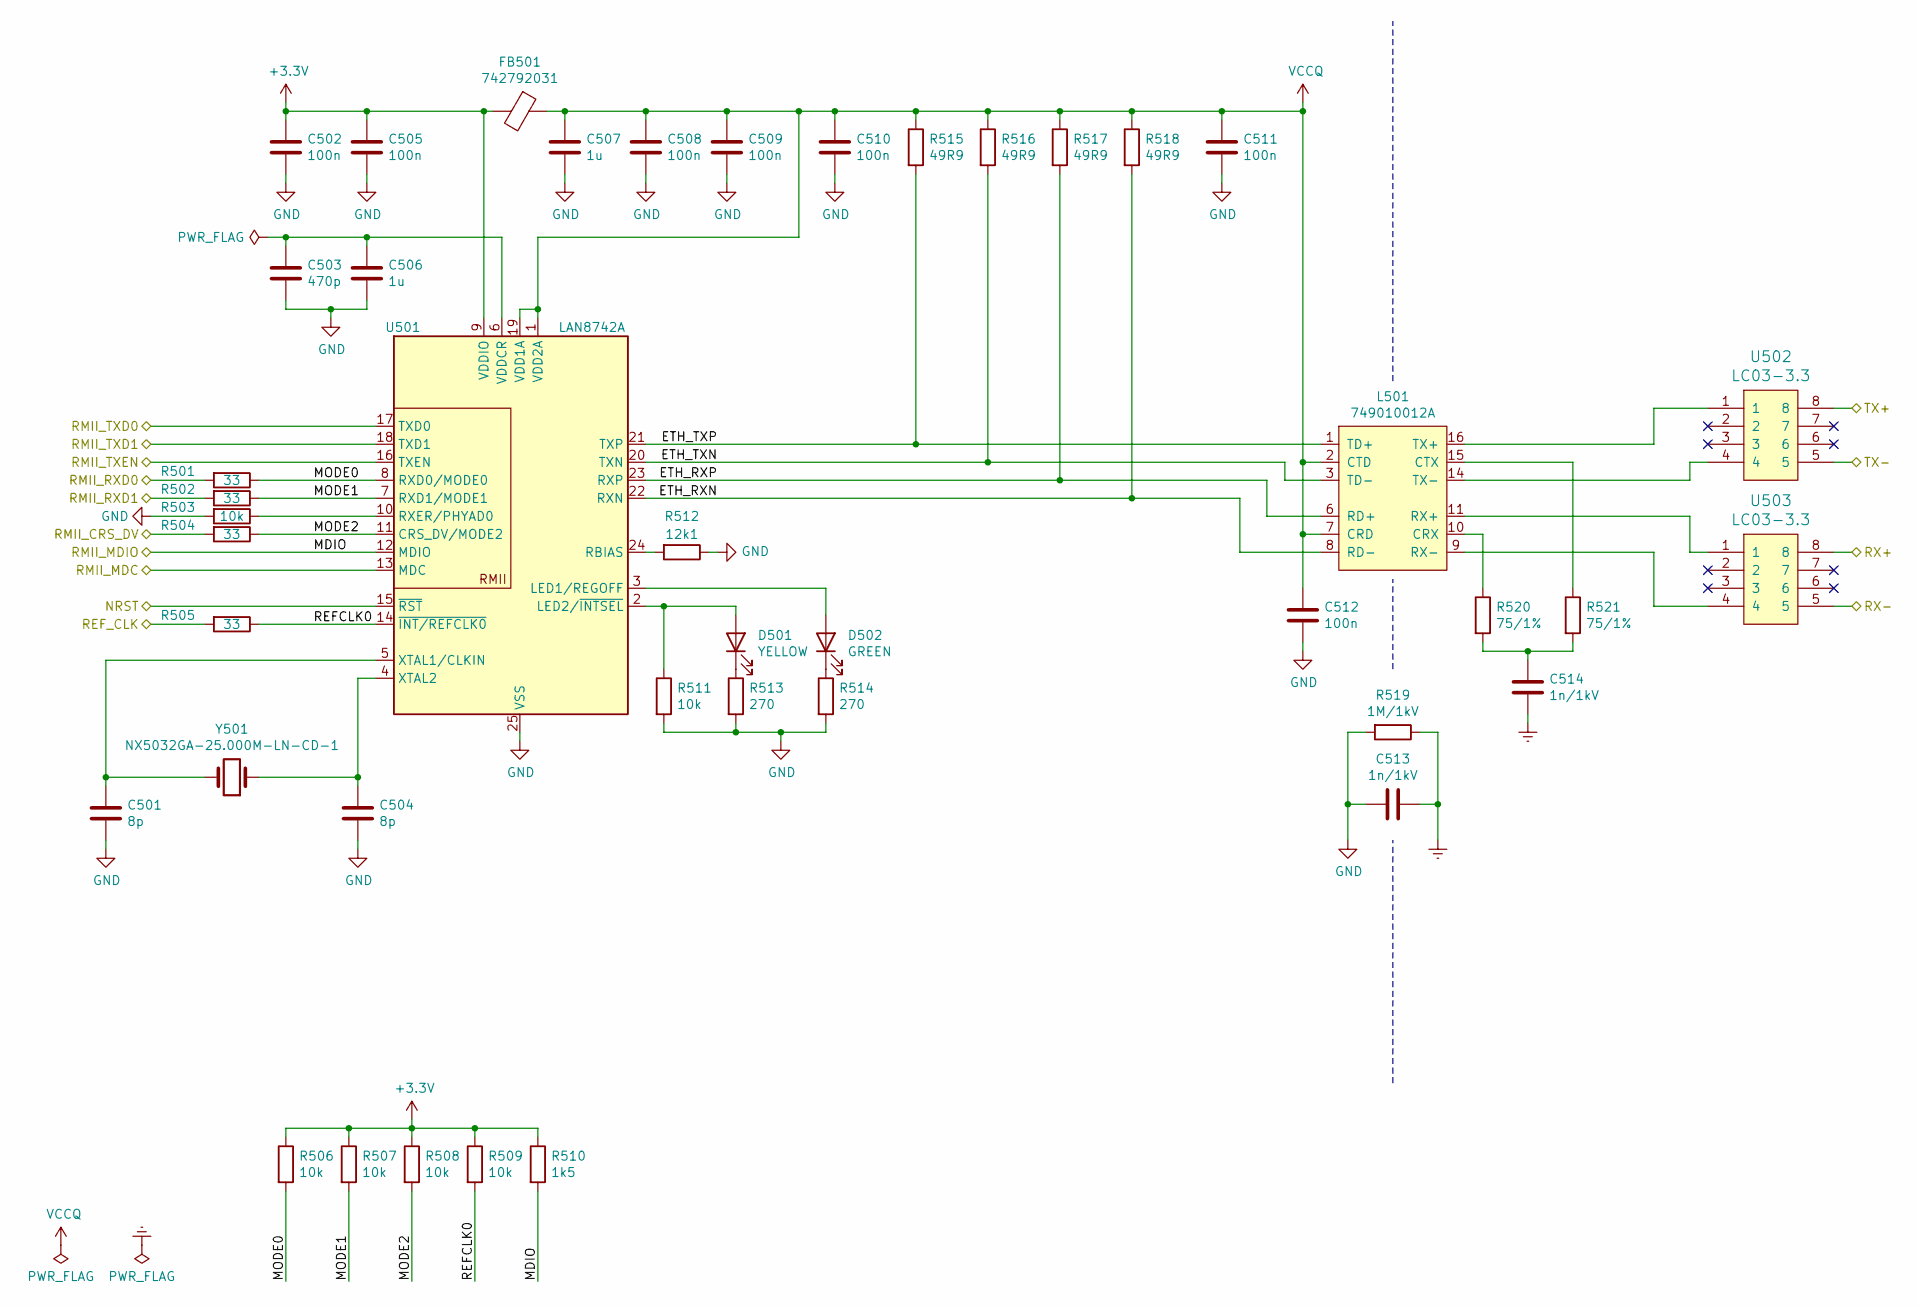
[picture p6: schematic Ethernet.sch]

Parts:
C501, C504: 8p; C_0402_1005Metric_Pad0.74x0.62mm_HandSolder
C502, C505, C508, C509, C510, C511, C512: 100n; C_0402_1005Metric_Pad0.74x0.62mm_HandSolder
C503: 470p; C_0402_1005Metric_Pad0.74x0.62mm_HandSolder
C506, C507: 1u; C_0402_1005Metric_Pad0.74x0.62mm_HandSolder
C513, C514: 1n/1kV; C_1206_3216Metric_Pad1.33x1.80mm_HandSolder
D501: YELLOW; LED_0603_1608Metric_Pad1.05x0.95mm_HandSolder
D502: GREEN; LED_0603_1608Metric_Pad1.05x0.95mm_HandSolder
FB501: 742792031; L_0603_1608Metric_Pad1.05x0.95mm_HandSolder
L501: 749010012A
R501, R502, R504, R505: 33; R_0402_1005Metric_Pad0.72x0.64mm_HandSolder
R503, R506, R507, R508, R509, R511: 10k; R_0402_1005Metric_Pad0.72x0.64mm_HandSolder
R510: 1k5; R_0402_1005Metric_Pad0.72x0.64mm_HandSolder
R512: 12k1; R_0402_1005Metric_Pad0.72x0.64mm_HandSolder
R513, R514: 270; R_0402_1005Metric_Pad0.72x0.64mm_HandSolder
R515, R516, R517, R518: 49R9; R_0402_1005Metric_Pad0.72x0.64mm_HandSolder
R519: 1M/1kV; R_1206_3216Metric_Pad1.30x1.75mm_HandSolder
R520, R521: 75/1%; R_0603_1608Metric_Pad0.98x0.95mm_HandSolder
U501: LAN8742A; QFN-24-1EP_4x4mm_P0.5mm_EP2.6x2.6mm_ThermalVias
U502, U503: LC03-3.3; SO8E
Y501: NX5032GA-25.000M-LN-CD-1; NX5032GA

Connections:
/Connector/RX+: U503.8; also elsewhere on the board
/Connector/RX-: U503.5; also elsewhere on the board
/Connector/TX+: U502.8; also elsewhere on the board
/Connector/TX-: U502.5; also elsewhere on the board
/Ethernet/ETH_RXN: L501.8 (RD-), R518.2, U501.22 (RXN)
/Ethernet/ETH_RXP: L501.6 (RD+), R517.2, U501.23 (RXP)
/Ethernet/ETH_TXN: L501.3 (TD-), R516.2, U501.20 (TXN)
/Ethernet/ETH_TXP: L501.1 (TD+), R515.2, U501.21 (TXP)
/Ethernet/MODE0: R501.1, R506.2, U501.8 (RXD0/MODE0)
/Ethernet/MODE1: R502.1, R507.2, U501.7 (RXD1/MODE1)
/Ethernet/MODE2: R504.1, R508.2, U501.11 (CRS_DV/MODE2)
/Ethernet/NRST: U501.15 (~RST); also elsewhere on the board
/Ethernet/REFCLK0: R505.1, R509.2, U501.14 (~INT/REFCLK0)
/Ethernet/REF_CLK: R505.2; also elsewhere on the board
/Ethernet/RMII_CRS_DV: R504.2; also elsewhere on the board
/Ethernet/RMII_MDC: U501.13 (MDC); also elsewhere on the board
/Ethernet/RMII_MDIO: R510.2, U501.12 (MDIO); also elsewhere on the board
/Ethernet/RMII_RXD0: R501.2; also elsewhere on the board
/Ethernet/RMII_RXD1: R502.2; also elsewhere on the board
/Ethernet/RMII_TXD0: U501.17 (TXD0); also elsewhere on the board
/Ethernet/RMII_TXD1: U501.18 (TXD1); also elsewhere on the board
/Ethernet/RMII_TXEN: U501.16 (TXEN); also elsewhere on the board
AGNDF: C501.2, C502.2, C503.2, C504.2, C505.2, C506.2, C507.2, C508.2, C509.2, C510.2, C511.2, C512.2, C513.2, R503.2, R511.2, R512.1, R513.2, R514.2, R519.2, U501.25 (VSS); also elsewhere on the board
Earth: C513.1, C514.2, R519.1; also elsewhere on the board
unnamed: C501.1, U501.5 (XTAL1/CLKIN), Y501.2
unnamed: C503.1, C506.1, U501.6 (VDDCR)
unnamed: C504.1, U501.4 (XTAL2), Y501.1
unnamed: C514.1, R520.2, R521.2
unnamed: D501.1 (K), R513.1
unnamed: D501.2 (A), R511.1, U501.2 (LED2/~INTSEL)
unnamed: D502.1 (K), R514.1
unnamed: D502.2 (A), U501.3 (LED1/REGOFF)
unnamed: L501.9 (RX-), U503.4
unnamed: L501.10 (CRX), R520.1
unnamed: L501.11 (RX+), U503.1
unnamed: L501.14 (TX-), U502.4
unnamed: L501.15 (CTX), R521.1
unnamed: L501.16 (TX+), U502.1
unnamed: R503.1, U501.10 (RXER/PHYAD0)
unnamed: R512.2, U501.24 (RBIAS)
VCCQ: C507.1, C508.1, C509.1, C510.1, C511.1, C512.1, FB501.1, L501.2 (CTD), L501.7 (CRD), R515.1, R516.1, R517.1, R518.1, U501.1 (VDD2A), U501.19 (VDD1A)

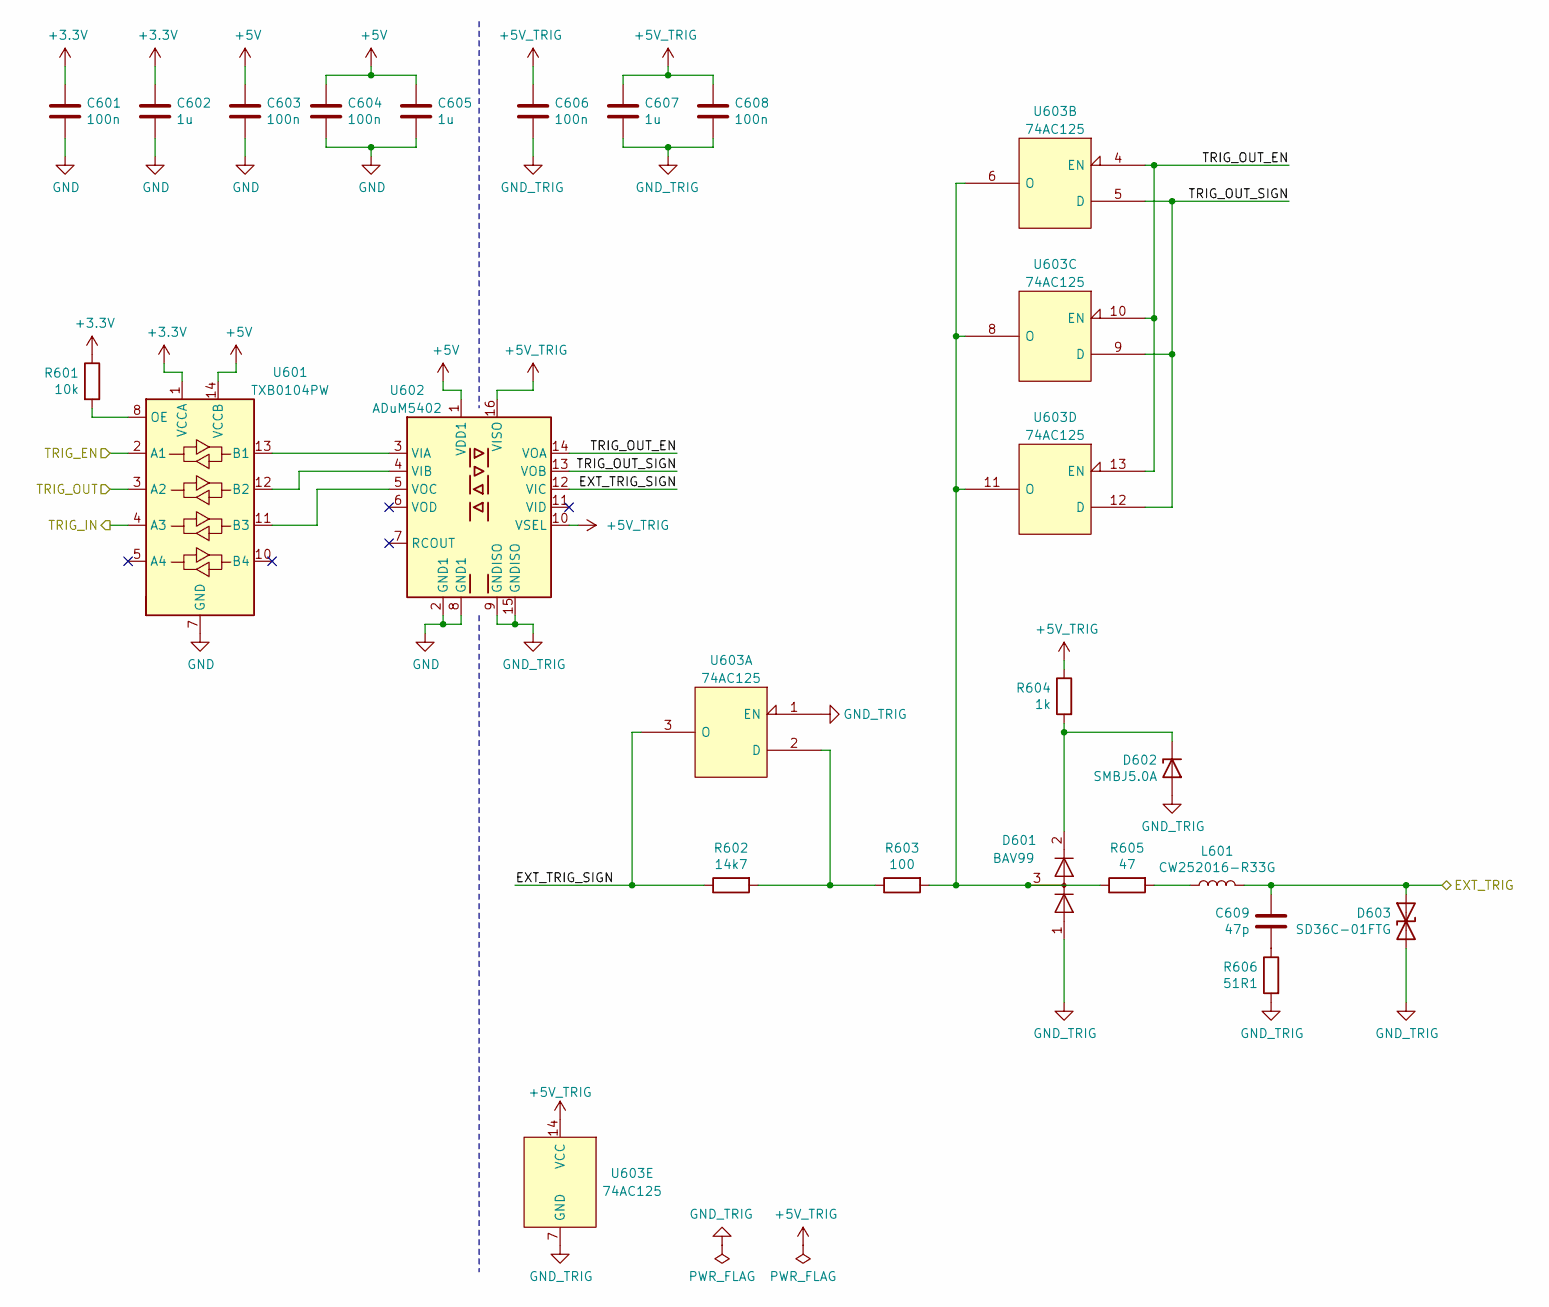
[picture p7: schematic Trigger.sch]

Parts:
C601, C603, C604, C606, C608: 100n; C_0402_1005Metric_Pad0.74x0.62mm_HandSolder
C602, C605, C607: 1u; C_0402_1005Metric_Pad0.74x0.62mm_HandSolder
C609: 47p; C_0603_1608Metric_Pad1.08x0.95mm_HandSolder
D601: BAV99; SOT-23
D602: SMBJ5.0A; D_SMB
D603: SD36C-01FTG; D_SOD-323_HandSoldering
L601: CW252016-R33G; CW252016
R601: 10k; R_0402_1005Metric_Pad0.72x0.64mm_HandSolder
R602: 14k7; R_0603_1608Metric_Pad0.98x0.95mm_HandSolder
R603: 100; R_0603_1608Metric_Pad0.98x0.95mm_HandSolder
R604: 1k; R_0603_1608Metric_Pad0.98x0.95mm_HandSolder
R605: 47; R_0603_1608Metric_Pad0.98x0.95mm_HandSolder
R606: 51R1; R_0603_1608Metric_Pad0.98x0.95mm_HandSolder
U601: TXB0104PW; TSSOP-14_4.4x5mm_P0.65mm
U602: ADuM5402; SOIC-16W_7.5x10.3mm_P1.27mm
U603: 74AC125; TSSOP-14_4.4x5mm_P0.65mm

Connections:
+5V: C603.1, C604.1, C605.1, U601.14 (VCCB), U602.1 (VDD1); also elsewhere on the board
+5V_TRIG: C606.1, C607.1, C608.1, R604.1, U602.10 (VSEL), U602.16 (VISO), U603.14 (VCC)
/Connector/EXT_TRIG: C609.1, D603.1 (A1), L601.1; also elsewhere on the board
/MCU/TRIG_EN: U601.2 (A1); also elsewhere on the board
/MCU/TRIG_IN: U601.4 (A3); also elsewhere on the board
/MCU/TRIG_OUT: U601.3 (A2); also elsewhere on the board
/Trigger/EXT_TRIG_SIGN: R602.1, U602.12 (VIC), U603.3 (O)
/Trigger/TRIG_OUT_EN: U602.14 (VOA), U603.4 (EN), U603.10 (EN), U603.13 (EN)
/Trigger/TRIG_OUT_SIGN: U602.13 (VOB), U603.5 (D), U603.9 (D), U603.12 (D)
AGNDF: C601.2, C602.2, C603.2, C604.2, C605.2, U601.7 (GND), U602.2 (GND1), U602.8 (GND1); also elsewhere on the board
GND_TRIG: C606.2, C607.2, C608.2, D601.1 (K), D602.2 (A), D603.2 (A2), R606.2, U602.9 (GNDISO), U602.15 (GNDISO), U603.1 (EN), U603.7 (GND); also elsewhere on the board
unnamed: C609.2, R606.1
unnamed: D601.2 (A), D602.1 (K), R604.2
unnamed: D601.3 (K), R603.2, R605.1, U603.6 (O), U603.8 (O), U603.11 (O)
unnamed: L601.2, R605.2
unnamed: R601.2, U601.8 (OE)
unnamed: R602.2, R603.1, U603.2 (D)
unnamed: U601.11 (B3), U602.5 (VOC)
unnamed: U601.12 (B2), U602.4 (VIB)
unnamed: U601.13 (B1), U602.3 (VIA)

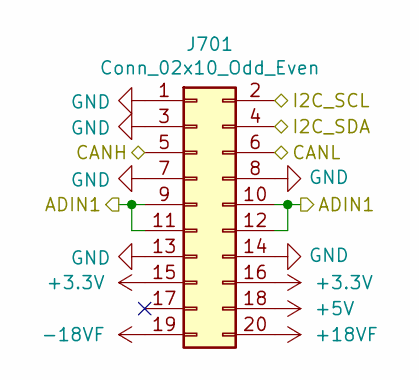
[picture p8: schematic CH1_CONN.sch]

Parts:
J701: Conn_02x10_Odd_Even; PinSocket_2x10_P2.54mm_Vertical

Connections:
+5V: J701.18; also elsewhere on the board
+18VF: J701.20; also elsewhere on the board
-18VF: J701.19; also elsewhere on the board
/ADC 1/ADIN1: J701.9, J701.10, J701.11, J701.12; also elsewhere on the board
/CH1 Connector/CANH: J701.5; also elsewhere on the board
/CH1 Connector/CANL: J701.6; also elsewhere on the board
/CH1 Connector/I2C_SCL: J701.2; also elsewhere on the board
/CH1 Connector/I2C_SDA: J701.4; also elsewhere on the board
AGNDF: J701.1, J701.3, J701.7, J701.8, J701.13, J701.14; also elsewhere on the board

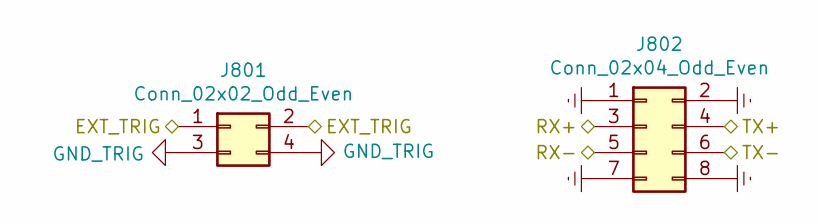
[picture p9: schematic Connector.sch]

Parts:
J801: Conn_02x02_Odd_Even; PinSocket_2x02_P2.54mm_Vertical
J802: Conn_02x04_Odd_Even; PinSocket_2x04_P2.54mm_Vertical

Connections:
/Connector/EXT_TRIG: J801.1, J801.2; also elsewhere on the board
/Connector/RX+: J802.3; also elsewhere on the board
/Connector/RX-: J802.5; also elsewhere on the board
/Connector/TX+: J802.4; also elsewhere on the board
/Connector/TX-: J802.6; also elsewhere on the board
Earth: J802.1, J802.2, J802.7, J802.8; also elsewhere on the board
GND_TRIG: J801.3, J801.4; also elsewhere on the board

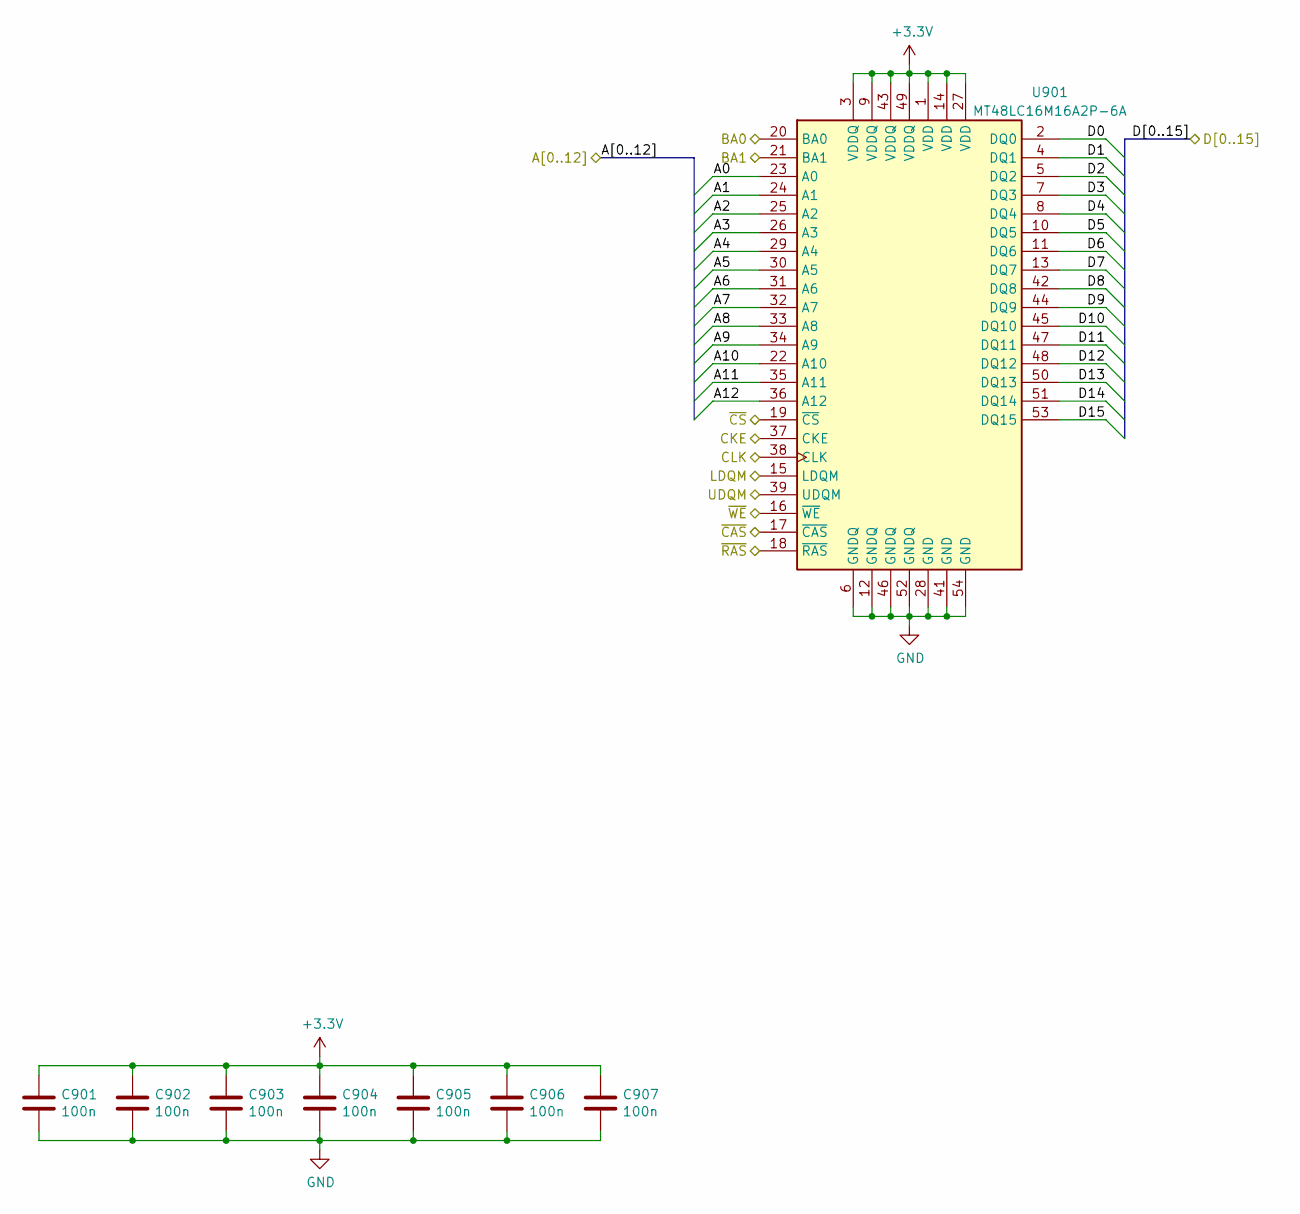
[picture p10: schematic SDRAM.sch]

Parts:
C901, C902, C903, C904, C905, C906, C907: 100n; C_0402_1005Metric_Pad0.74x0.62mm_HandSolder
U901: MT48LC16M16A2P-6A; TSSOP-54

Connections:
/MCU/A0: U901.23 (A0); also elsewhere on the board
/MCU/A1: U901.24 (A1); also elsewhere on the board
/MCU/A2: U901.25 (A2); also elsewhere on the board
/MCU/A3: U901.26 (A3); also elsewhere on the board
/MCU/A4: U901.29 (A4); also elsewhere on the board
/MCU/A5: U901.30 (A5); also elsewhere on the board
/MCU/A6: U901.31 (A6); also elsewhere on the board
/MCU/A7: U901.32 (A7); also elsewhere on the board
/MCU/A8: U901.33 (A8); also elsewhere on the board
/MCU/A9: U901.34 (A9); also elsewhere on the board
/MCU/A10: U901.22 (A10); also elsewhere on the board
/MCU/A11: U901.35 (A11); also elsewhere on the board
/MCU/A12: U901.36 (A12); also elsewhere on the board
/MCU/BA0: U901.20 (BA0); also elsewhere on the board
/MCU/BA1: U901.21 (BA1); also elsewhere on the board
/MCU/CKE: U901.37 (CKE); also elsewhere on the board
/MCU/CLK: U901.38 (CLK); also elsewhere on the board
/MCU/D0: U901.2 (DQ0); also elsewhere on the board
/MCU/D1: U901.4 (DQ1); also elsewhere on the board
/MCU/D2: U901.5 (DQ2); also elsewhere on the board
/MCU/D3: U901.7 (DQ3); also elsewhere on the board
/MCU/D4: U901.8 (DQ4); also elsewhere on the board
/MCU/D5: U901.10 (DQ5); also elsewhere on the board
/MCU/D6: U901.11 (DQ6); also elsewhere on the board
/MCU/D7: U901.13 (DQ7); also elsewhere on the board
/MCU/D8: U901.42 (DQ8); also elsewhere on the board
/MCU/D9: U901.44 (DQ9); also elsewhere on the board
/MCU/D10: U901.45 (DQ10); also elsewhere on the board
/MCU/D11: U901.47 (DQ11); also elsewhere on the board
/MCU/D12: U901.48 (DQ12); also elsewhere on the board
/MCU/D13: U901.50 (DQ13); also elsewhere on the board
/MCU/D14: U901.51 (DQ14); also elsewhere on the board
/MCU/D15: U901.53 (DQ15); also elsewhere on the board
/MCU/LDQM: U901.15 (LDQM); also elsewhere on the board
/MCU/UDQM: U901.39 (UDQM); also elsewhere on the board
/MCU/~CAS: U901.17 (~CAS); also elsewhere on the board
/MCU/~CS: U901.19 (~CS); also elsewhere on the board
/MCU/~RAS: U901.18 (~RAS); also elsewhere on the board
/MCU/~WE: U901.16 (~WE); also elsewhere on the board
AGNDF: C901.2, C902.2, C903.2, C904.2, C905.2, C906.2, C907.2, U901.6 (GNDQ), U901.12 (GNDQ), U901.28 (GND), U901.41 (GND), U901.46 (GNDQ), U901.52 (GNDQ), U901.54 (GND); also elsewhere on the board

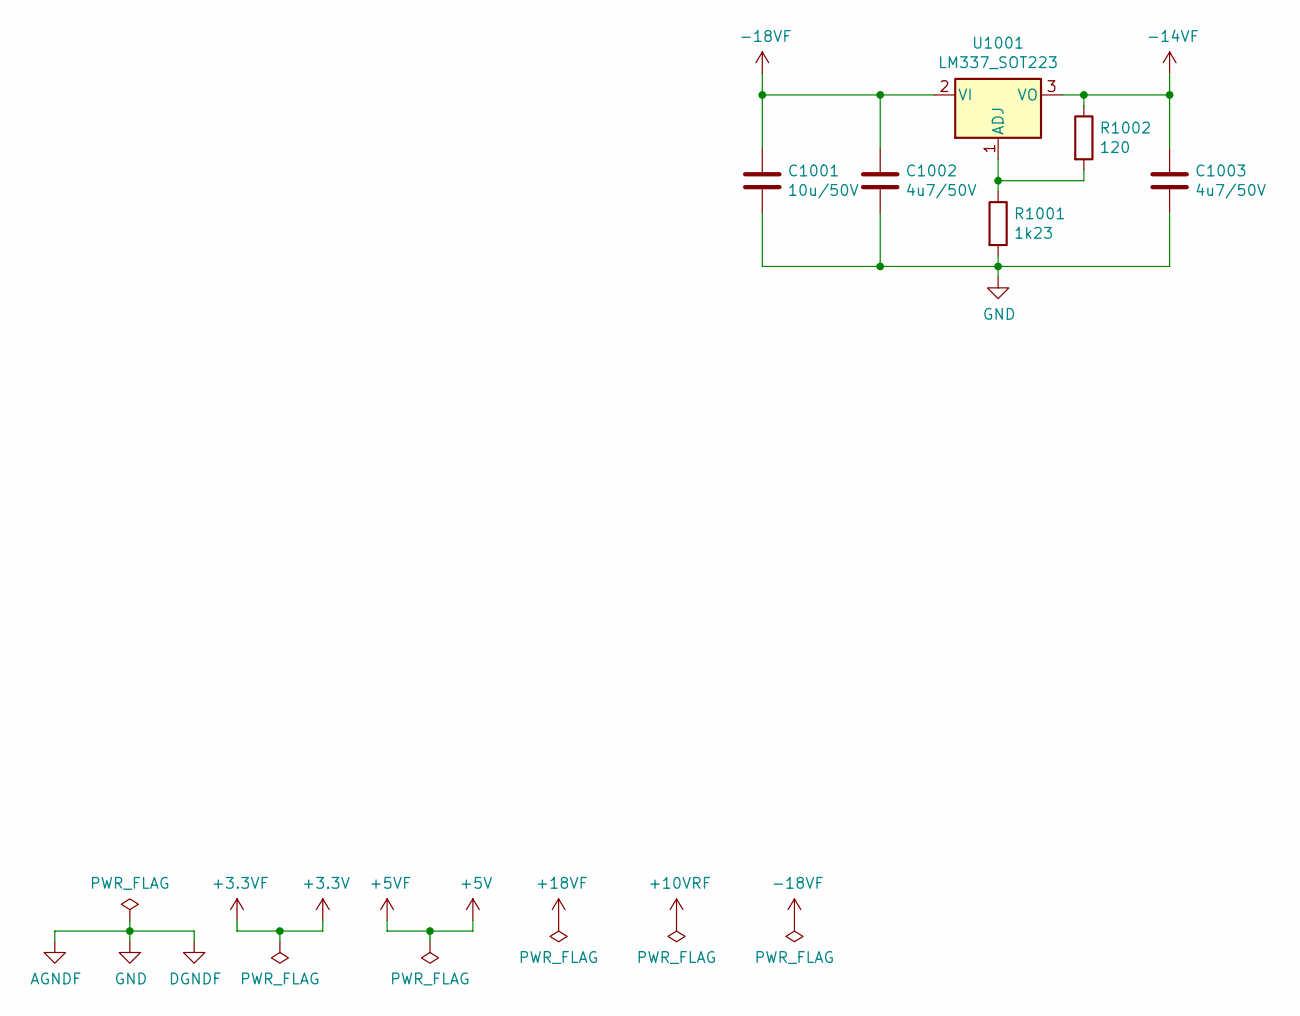
[picture p11: schematic Power.sch]

Parts:
C1001: 10u/50V; C_0805_2012Metric_Pad1.18x1.45mm_HandSolder
C1002, C1003: 4u7/50V; C_0805_2012Metric_Pad1.18x1.45mm_HandSolder
R1001: 1k23; R_0402_1005Metric_Pad0.72x0.64mm_HandSolder
R1002: 120; R_0402_1005Metric_Pad0.72x0.64mm_HandSolder
U1001: LM337_SOT223; SOT-223-3_TabPin2

Connections:
-14VF: C1003.1, R1002.1, U1001.3 (VO); also elsewhere on the board
-18VF: C1001.1, C1002.1, U1001.2 (VI); also elsewhere on the board
AGNDF: C1001.2, C1002.2, C1003.2, R1001.2; also elsewhere on the board
unnamed: R1001.1, R1002.2, U1001.1 (ADJ)

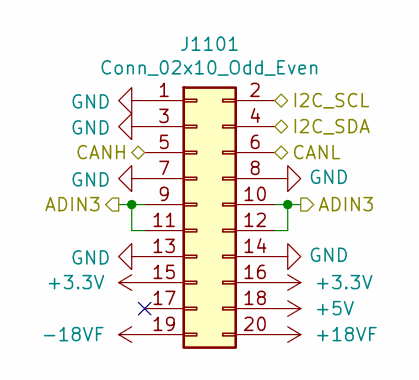
[picture p12: schematic CH3_CONN.sch]

Parts:
J1101: Conn_02x10_Odd_Even; PinSocket_2x10_P2.54mm_Vertical

Connections:
+5V: J1101.18; also elsewhere on the board
+18VF: J1101.20; also elsewhere on the board
-18VF: J1101.19; also elsewhere on the board
/ADC 3/ADIN3: J1101.9, J1101.10, J1101.11, J1101.12; also elsewhere on the board
/CH1 Connector/CANH: J1101.5; also elsewhere on the board
/CH1 Connector/CANL: J1101.6; also elsewhere on the board
/CH1 Connector/I2C_SCL: J1101.2; also elsewhere on the board
/CH1 Connector/I2C_SDA: J1101.4; also elsewhere on the board
AGNDF: J1101.1, J1101.3, J1101.7, J1101.8, J1101.13, J1101.14; also elsewhere on the board

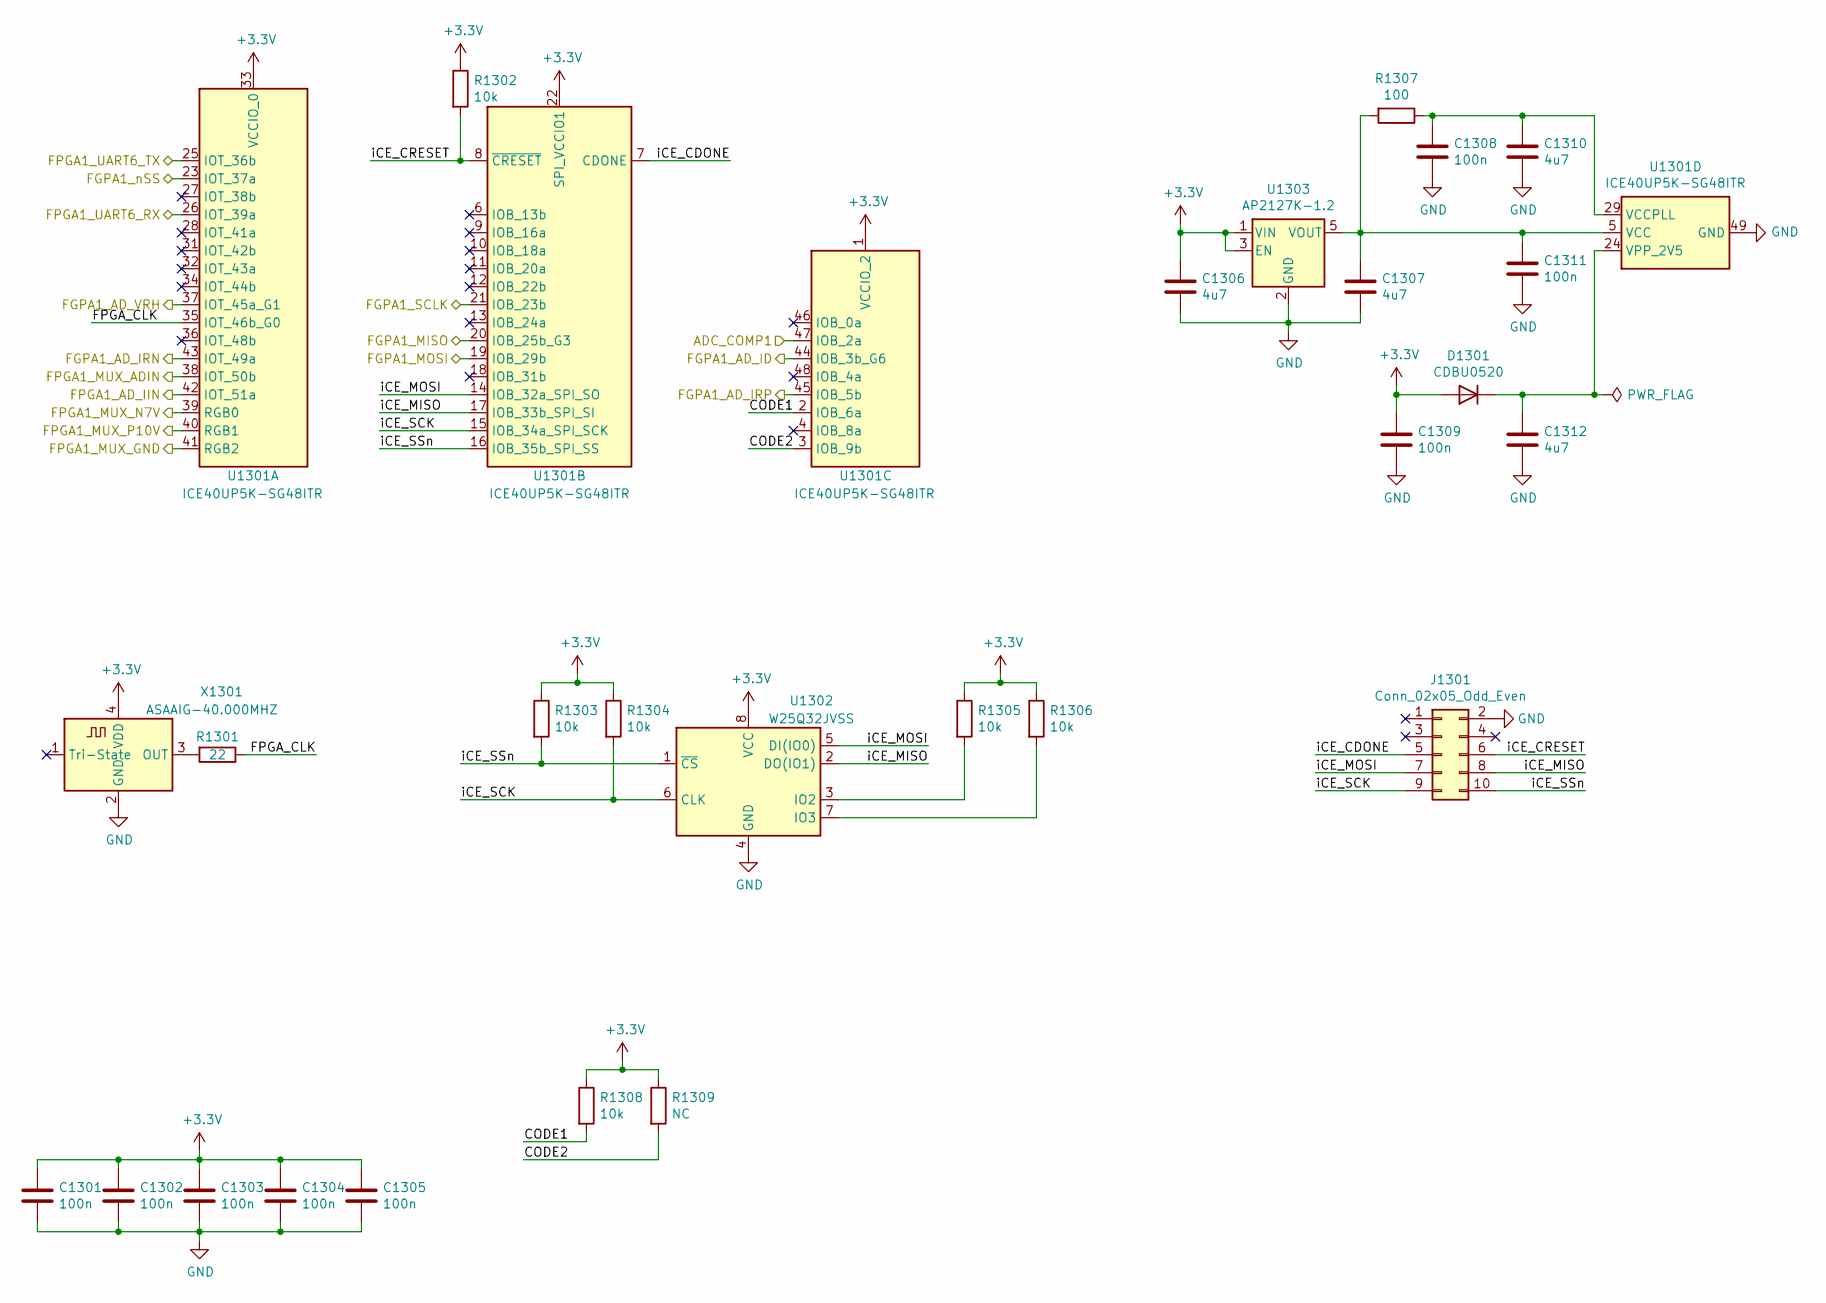
[picture p13: schematic FPGA1.sch]

Parts:
C1301, C1302, C1303, C1304, C1305, C1308, C1309, C1311: 100n; C_0402_1005Metric_Pad0.74x0.62mm_HandSolder
C1306, C1307, C1310, C1312: 4u7; C_0603_1608Metric_Pad1.08x0.95mm_HandSolder
D1301: CDBU0520; D_SOD-523
J1301: Conn_02x05_Odd_Even; PinHeader_2x05_P1.27mm_Vertical
R1301: 22; R_0402_1005Metric_Pad0.72x0.64mm_HandSolder
R1302, R1303, R1304, R1305, R1306, R1308: 10k; R_0402_1005Metric_Pad0.72x0.64mm_HandSolder
R1307: 100; R_0402_1005Metric_Pad0.72x0.64mm_HandSolder
R1309: NC; R_0402_1005Metric_Pad0.72x0.64mm_HandSolder
U1301: ICE40UP5K-SG48ITR; QFN-48-1EP_7x7mm_P0.5mm_EP5.6x5.6mm_ThermalVias
U1302: W25Q32JVSS; SOIC-8_5.23x5.23mm_P1.27mm
U1303: AP2127K-1.2; SOT-23-5
X1301: ASAAIG-40.000MHZ; ASAAIG

Connections:
/ADC 2/FGPA2_AD_ID: U1301.44 (IOB_3b_G6); also elsewhere on the board
/ADC 2/FGPA2_AD_IIN: U1301.42 (IOT_51a); also elsewhere on the board
/ADC 2/FGPA2_AD_IRN: U1301.43 (IOT_49a); also elsewhere on the board
/ADC 2/FGPA2_AD_IRP: U1301.45 (IOB_5b); also elsewhere on the board
/ADC 2/FPGA2_MUX_ADIN: U1301.38 (IOT_50b); also elsewhere on the board
/ADC 2/FPGA2_MUX_GND: U1301.41 (RGB2); also elsewhere on the board
/ADC 2/FPGA2_MUX_N7V: U1301.39 (RGB0); also elsewhere on the board
/ADC 2/FPGA2_MUX_P10V: U1301.40 (RGB1); also elsewhere on the board
/FPGA 1/FGPA1_MISO: U1301.19 (IOB_29b); also elsewhere on the board
/FPGA 1/FGPA1_SCLK: U1301.21 (IOB_23b); also elsewhere on the board
/FPGA 1/FGPA1_nSS: U1301.23 (IOT_37a); also elsewhere on the board
/FPGA 2/ADC_COMP2: U1301.47 (IOB_2a); also elsewhere on the board
/FPGA 2/FGPA2_AD_VRH: U1301.37 (IOT_45a_G1); also elsewhere on the board
/FPGA 2/FGPA2_MISO: U1301.20 (IOB_25b_G3); also elsewhere on the board
/FPGA 2/FPGA2_UART2_RX: U1301.26 (IOT_39a); also elsewhere on the board
/FPGA 2/FPGA2_UART2_TX: U1301.25 (IOT_36b); also elsewhere on the board
/FPGA 2/FPGA_CLK: R1301.1, U1301.35 (IOT_46b_G0)
/FPGA 2/iCE_CRESET: J1301.6, R1302.2, U1301.8 (~CRESET)
/FPGA 2/iCE_SSn: J1301.10, R1303.2, U1301.16 (IOB_35b_SPI_SS), U1302.1 (~CS)
AGNDF: C1301.2, C1302.2, C1303.2, C1304.2, C1305.2, C1306.2, C1307.2, C1308.2, C1309.2, C1310.2, C1311.2, C1312.2, J1301.2, U1301.49 (GND), U1302.4 (GND), U1303.2 (GND), X1301.2 (GND); also elsewhere on the board
unnamed: C1312.1, D1301.1 (K), U1301.24 (VPP_2V5)
unnamed: R1301.2, X1301.3 (OUT)

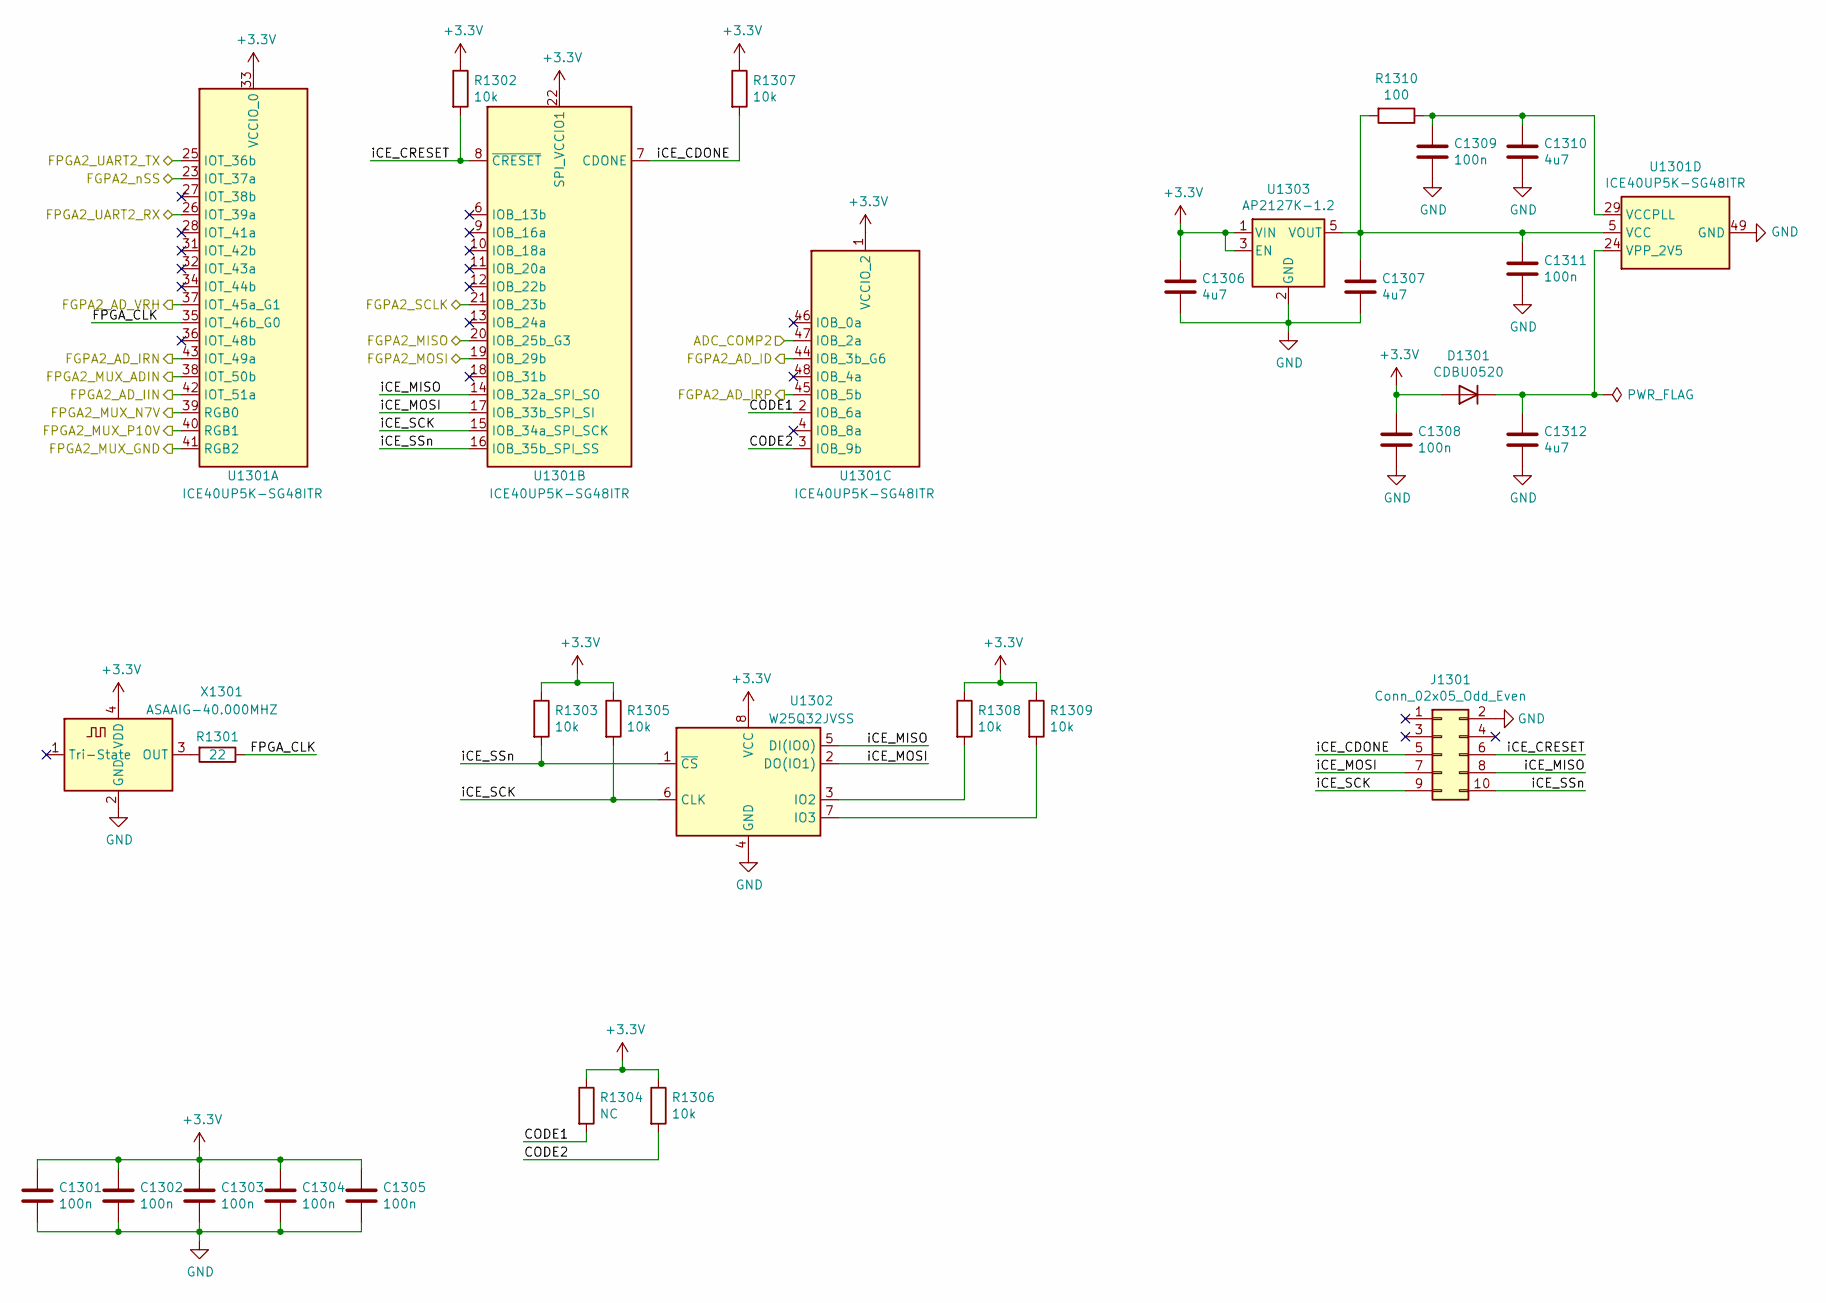
[picture p14: schematic FPGA2.sch]

Parts:
C1301, C1302, C1303, C1304, C1305, C1308, C1309, C1311: 100n; C_0402_1005Metric_Pad0.74x0.62mm_HandSolder
C1306, C1307, C1310, C1312: 4u7; C_0603_1608Metric_Pad1.08x0.95mm_HandSolder
D1301: CDBU0520; D_SOD-523
J1301: Conn_02x05_Odd_Even; PinHeader_2x05_P1.27mm_Vertical
R1301: 22; R_0402_1005Metric_Pad0.72x0.64mm_HandSolder
R1302, R1303, R1305, R1306, R1307, R1308, R1309: 10k; R_0402_1005Metric_Pad0.72x0.64mm_HandSolder
R1304: NC; R_0402_1005Metric_Pad0.72x0.64mm_HandSolder
R1310: 100; R_0402_1005Metric_Pad0.72x0.64mm_HandSolder
U1301: ICE40UP5K-SG48ITR; QFN-48-1EP_7x7mm_P0.5mm_EP5.6x5.6mm_ThermalVias
U1302: W25Q32JVSS; SOIC-8_5.23x5.23mm_P1.27mm
U1303: AP2127K-1.2; SOT-23-5
X1301: ASAAIG-40.000MHZ; ASAAIG

Connections:
/ADC 2/FGPA2_AD_ID: U1301.44 (IOB_3b_G6); also elsewhere on the board
/ADC 2/FGPA2_AD_IIN: U1301.42 (IOT_51a); also elsewhere on the board
/ADC 2/FGPA2_AD_IRN: U1301.43 (IOT_49a); also elsewhere on the board
/ADC 2/FGPA2_AD_IRP: U1301.45 (IOB_5b); also elsewhere on the board
/ADC 2/FPGA2_MUX_ADIN: U1301.38 (IOT_50b); also elsewhere on the board
/ADC 2/FPGA2_MUX_GND: U1301.41 (RGB2); also elsewhere on the board
/ADC 2/FPGA2_MUX_N7V: U1301.39 (RGB0); also elsewhere on the board
/ADC 2/FPGA2_MUX_P10V: U1301.40 (RGB1); also elsewhere on the board
/FPGA 1/FGPA1_MISO: U1301.19 (IOB_29b); also elsewhere on the board
/FPGA 1/FGPA1_SCLK: U1301.21 (IOB_23b); also elsewhere on the board
/FPGA 1/FGPA1_nSS: U1301.23 (IOT_37a); also elsewhere on the board
/FPGA 2/ADC_COMP2: U1301.47 (IOB_2a); also elsewhere on the board
/FPGA 2/FGPA2_AD_VRH: U1301.37 (IOT_45a_G1); also elsewhere on the board
/FPGA 2/FGPA2_MISO: U1301.20 (IOB_25b_G3); also elsewhere on the board
/FPGA 2/FPGA2_UART2_RX: U1301.26 (IOT_39a); also elsewhere on the board
/FPGA 2/FPGA2_UART2_TX: U1301.25 (IOT_36b); also elsewhere on the board
/FPGA 2/FPGA_CLK: R1301.1, U1301.35 (IOT_46b_G0)
/FPGA 2/iCE_CRESET: J1301.6, R1302.2, U1301.8 (~CRESET)
/FPGA 2/iCE_SSn: J1301.10, R1303.2, U1301.16 (IOB_35b_SPI_SS), U1302.1 (~CS)
AGNDF: C1301.2, C1302.2, C1303.2, C1304.2, C1305.2, C1306.2, C1307.2, C1308.2, C1309.2, C1310.2, C1311.2, C1312.2, J1301.2, U1301.49 (GND), U1302.4 (GND), U1303.2 (GND), X1301.2 (GND); also elsewhere on the board
unnamed: C1312.1, D1301.1 (K), U1301.24 (VPP_2V5)
unnamed: R1301.2, X1301.3 (OUT)
