BehrensG/ETH3CDAQ1/hardware/project/ETH3CADC1/ETH3CADC1.kicad_pcb

## KiCad design hardware/project/ETH3CADC1/ETH3CADC1.kicad_pcb (continued)

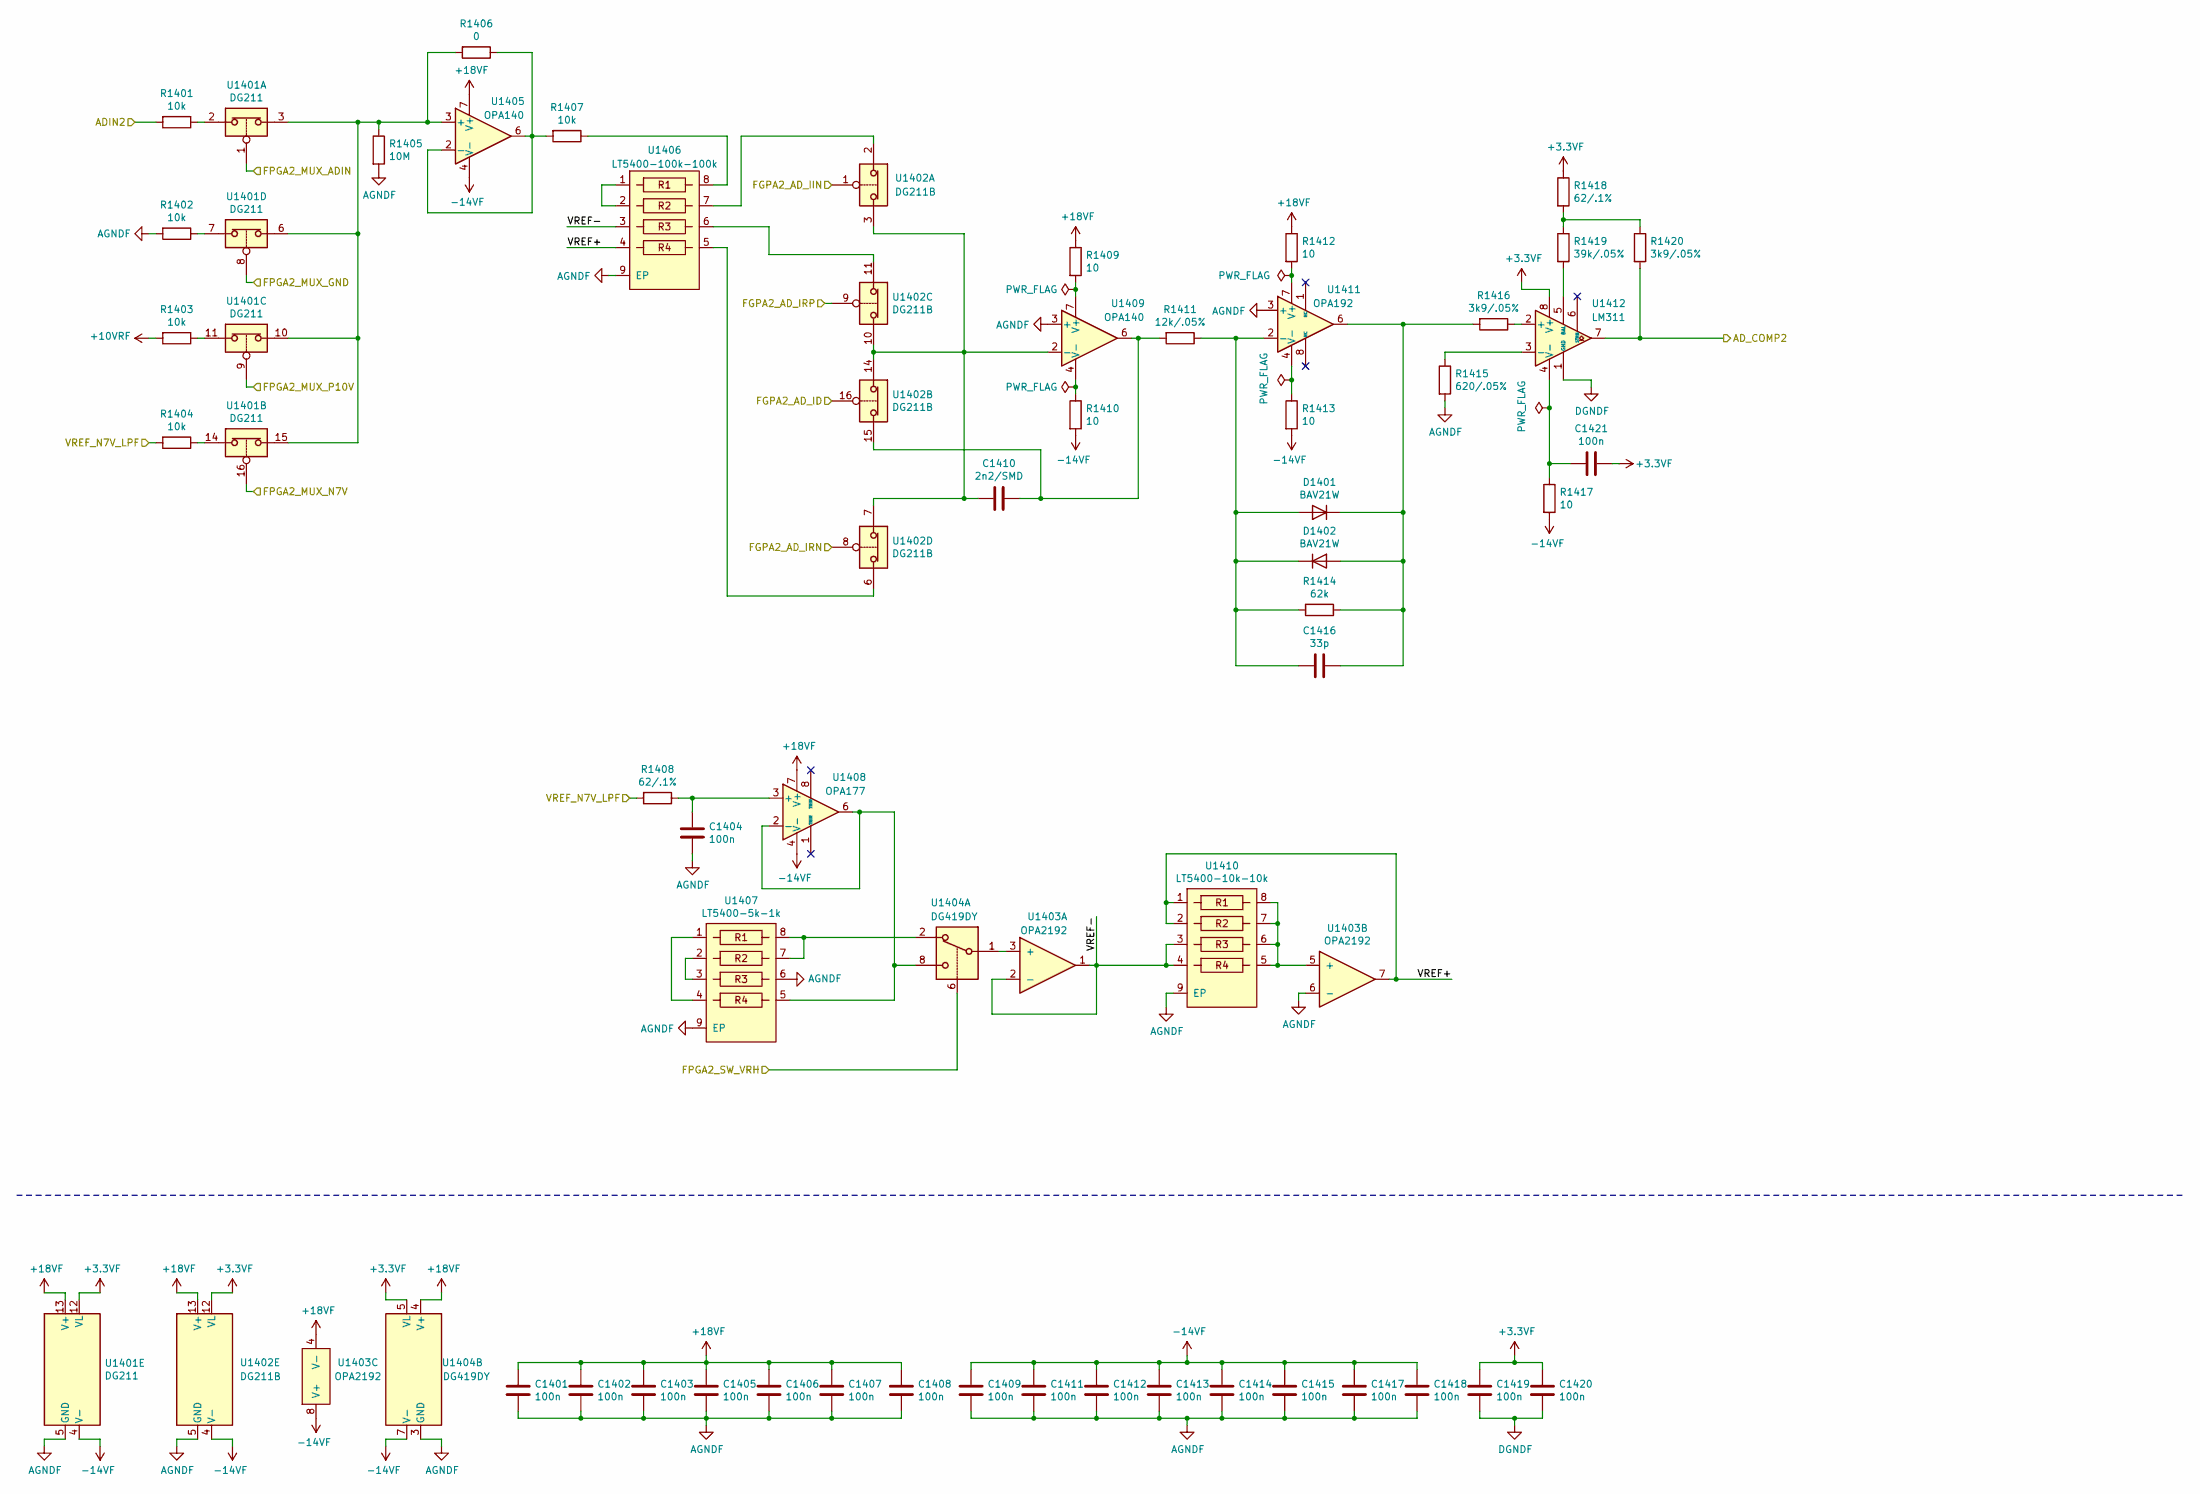
[picture p15: schematic ADC2.sch, ADC]

Parts:
C1401, C1402, C1403, C1404, C1405, C1406, C1407, C1408, C1409, C1411, C1412, C1413, C1414, C1415, C1417, C1418, C1419, C1420, C1421: 100n; C_0402_1005Metric_Pad0.74x0.62mm_HandSolder
C1410: 2n2/SMD; C_0603_1608Metric_Pad1.08x0.95mm_HandSolder
C1416: 33p; C_0402_1005Metric_Pad0.74x0.62mm_HandSolder
D1401, D1402: BAV21W; D_SOD-123
R1401, R1402, R1403, R1404, R1407: 10k; R_0402_1005Metric_Pad0.72x0.64mm_HandSolder
R1405: 10M; R_0603_1608Metric_Pad0.98x0.95mm_HandSolder
R1406: 0; R_0402_1005Metric_Pad0.72x0.64mm_HandSolder
R1408, R1418: 62/.1%; R_0603_1608Metric_Pad0.98x0.95mm_HandSolder
R1409, R1410, R1412, R1413, R1417: 10; R_0402_1005Metric_Pad0.72x0.64mm_HandSolder
R1411: 12k/.05%; R_0603_1608Metric_Pad0.98x0.95mm_HandSolder
R1414: 62k; R_0402_1005Metric_Pad0.72x0.64mm_HandSolder
R1415: 620/.05%; R_0603_1608Metric_Pad0.98x0.95mm_HandSolder
R1416, R1420: 3k9/.05%; R_0603_1608Metric_Pad0.98x0.95mm_HandSolder
R1419: 39k/.05%; R_0603_1608Metric_Pad0.98x0.95mm_HandSolder
U1401: DG211; TSSOP-16_4.4x5mm_P0.65mm
U1402: DG211B; TSSOP-16_4.4x5mm_P0.65mm
U1403: OPA2192; SOIC-8_3.9x4.9mm_P1.27mm
U1404: DG419DY; SOIC-8_3.9x4.9mm_P1.27mm
U1405, U1409: OPA140; SOIC-8_3.9x4.9mm_P1.27mm
U1406: LT5400-100k-100k; MSOP-8-1EP_3x3mm_P0.65mm_EP1.73x1.85mm_ThermalVias
U1407: LT5400-5k-1k; MSOP-8-1EP_3x3mm_P0.65mm_EP1.73x1.85mm_ThermalVias
U1408: OPA177; SOIC-8_3.9x4.9mm_P1.27mm
U1410: LT5400-10k-10k; MSOP-8-1EP_3x3mm_P0.65mm_EP1.73x1.85mm_ThermalVias
U1411: OPA192; SOIC-8_3.9x4.9mm_P1.27mm
U1412: LM311; SOIC-8_3.9x4.9mm_P1.27mm

Connections:
+10VRF: R1403.2; also elsewhere on the board
+18VF: C1401.1, C1402.1, C1403.1, C1405.1, C1406.1, C1407.1, C1408.1, R1409.1, R1412.1, U1401.13 (V+), U1402.13 (V+), U1403.4 (V-), U1404.4 (V+), U1405.7 (V+), U1408.7 (V+); also elsewhere on the board
-14VF: C1409.1, C1411.1, C1412.1, C1413.1, C1414.1, C1415.1, C1417.1, C1418.1, R1410.2, R1413.2, R1417.2, U1401.4 (V-), U1402.4 (V-), U1403.8 (V+), U1404.7 (V-), U1405.4 (V-), U1408.4 (V-); also elsewhere on the board
/ADC 1/VREF_N7V_LPF: R1404.2, R1408.2; also elsewhere on the board
/ADC 2/ADIN2: R1401.2; also elsewhere on the board
/ADC 2/FGPA2_AD_ID: U1402.16; also elsewhere on the board
/ADC 2/FGPA2_AD_IIN: U1402.1; also elsewhere on the board
/ADC 2/FGPA2_AD_IRN: U1402.8; also elsewhere on the board
/ADC 2/FGPA2_AD_IRP: U1402.9; also elsewhere on the board
/ADC 2/FPGA2_MUX_ADIN: U1401.1; also elsewhere on the board
/ADC 2/FPGA2_MUX_GND: U1401.8; also elsewhere on the board
/ADC 2/FPGA2_MUX_N7V: U1401.16; also elsewhere on the board
/ADC 2/FPGA2_MUX_P10V: U1401.9; also elsewhere on the board
/ADC 2/VREF+: U1403.7, U1406.4, U1410.1, U1410.2
/ADC 2/VREF-: U1403.1, U1403.2 (-), U1406.3, U1410.3, U1410.4
/FPGA 2/ADC_COMP2: R1420.2, U1412.7; also elsewhere on the board
/FPGA 2/FGPA2_AD_VRH: U1404.6; also elsewhere on the board
AGNDF: C1401.2, C1402.2, C1403.2, C1404.2, C1405.2, C1406.2, C1407.2, C1408.2, C1409.2, C1411.2, C1412.2, C1413.2, C1414.2, C1415.2, C1417.2, C1418.2, C1419.2, C1420.2, R1402.2, R1405.2, R1415.2, U1401.5 (GND), U1402.5 (GND), U1403.6 (-), U1404.3 (GND), U1406.9 (EP), U1407.6, U1407.9 (EP), U1409.3 (+), U1410.9 (EP), U1411.3 (+), U1412.1 (GND); also elsewhere on the board
unnamed: C1404.1, R1408.1, U1408.3 (+)
unnamed: C1410.1, R1411.2, U1402.15, U1409.6
unnamed: C1410.2, U1402.3, U1402.7, U1402.10, U1402.14, U1409.2 (-)
unnamed: C1416.1, D1401.1 (K), D1402.2 (A), R1414.1, R1416.2, U1411.6
unnamed: C1416.2, D1401.2 (A), D1402.1 (K), R1411.1, R1414.2, U1411.2 (-)
unnamed: C1421.2, R1417.1, U1412.4 (V-)
unnamed: R1401.1, U1401.2
unnamed: R1402.1, U1401.7
unnamed: R1403.1, U1401.11
unnamed: R1404.1, U1401.14
unnamed: R1405.1, R1406.2, U1401.3, U1401.6, U1401.10, U1401.15, U1405.3 (+)
unnamed: R1406.1, R1407.2, U1405.2 (-), U1405.6
unnamed: R1407.1, U1406.8
unnamed: R1409.2, U1409.7 (V+)
unnamed: R1410.1, U1409.4 (V-)
unnamed: R1412.2, U1411.7 (V+)
unnamed: R1413.1, U1411.4 (V-)
unnamed: R1415.1, U1412.3 (-)
unnamed: R1416.1, U1412.2 (+)
unnamed: R1418.2, R1419.1, R1420.1
unnamed: R1419.2, U1412.5 (BAL)
unnamed: U1402.2, U1406.7
unnamed: U1402.6, U1406.5
unnamed: U1402.11, U1406.6
unnamed: U1403.3 (+), U1404.1
unnamed: U1403.5 (+), U1410.5, U1410.6, U1410.7, U1410.8
unnamed: U1404.2, U1407.7, U1407.8
unnamed: U1404.8, U1407.5, U1408.2 (-), U1408.6
unnamed: U1406.1, U1406.2
unnamed: U1407.1, U1407.4
unnamed: U1407.2, U1407.3

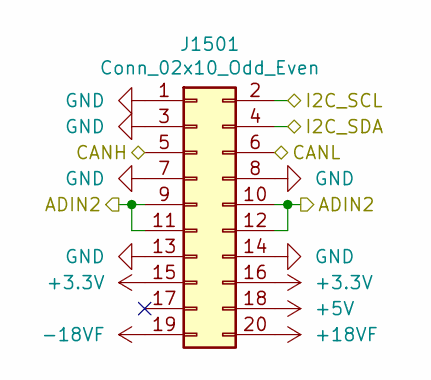
[picture p16: schematic CH2_CONN.sch]

Parts:
J1501: Conn_02x10_Odd_Even; PinSocket_2x10_P2.54mm_Vertical

Connections:
+5V: J1501.18; also elsewhere on the board
+18VF: J1501.20; also elsewhere on the board
-18VF: J1501.19; also elsewhere on the board
/ADC 2/ADIN2: J1501.9, J1501.10, J1501.11, J1501.12; also elsewhere on the board
/CH1 Connector/CANH: J1501.5; also elsewhere on the board
/CH1 Connector/CANL: J1501.6; also elsewhere on the board
/CH1 Connector/I2C_SCL: J1501.2; also elsewhere on the board
/CH1 Connector/I2C_SDA: J1501.4; also elsewhere on the board
AGNDF: J1501.1, J1501.3, J1501.7, J1501.8, J1501.13, J1501.14; also elsewhere on the board

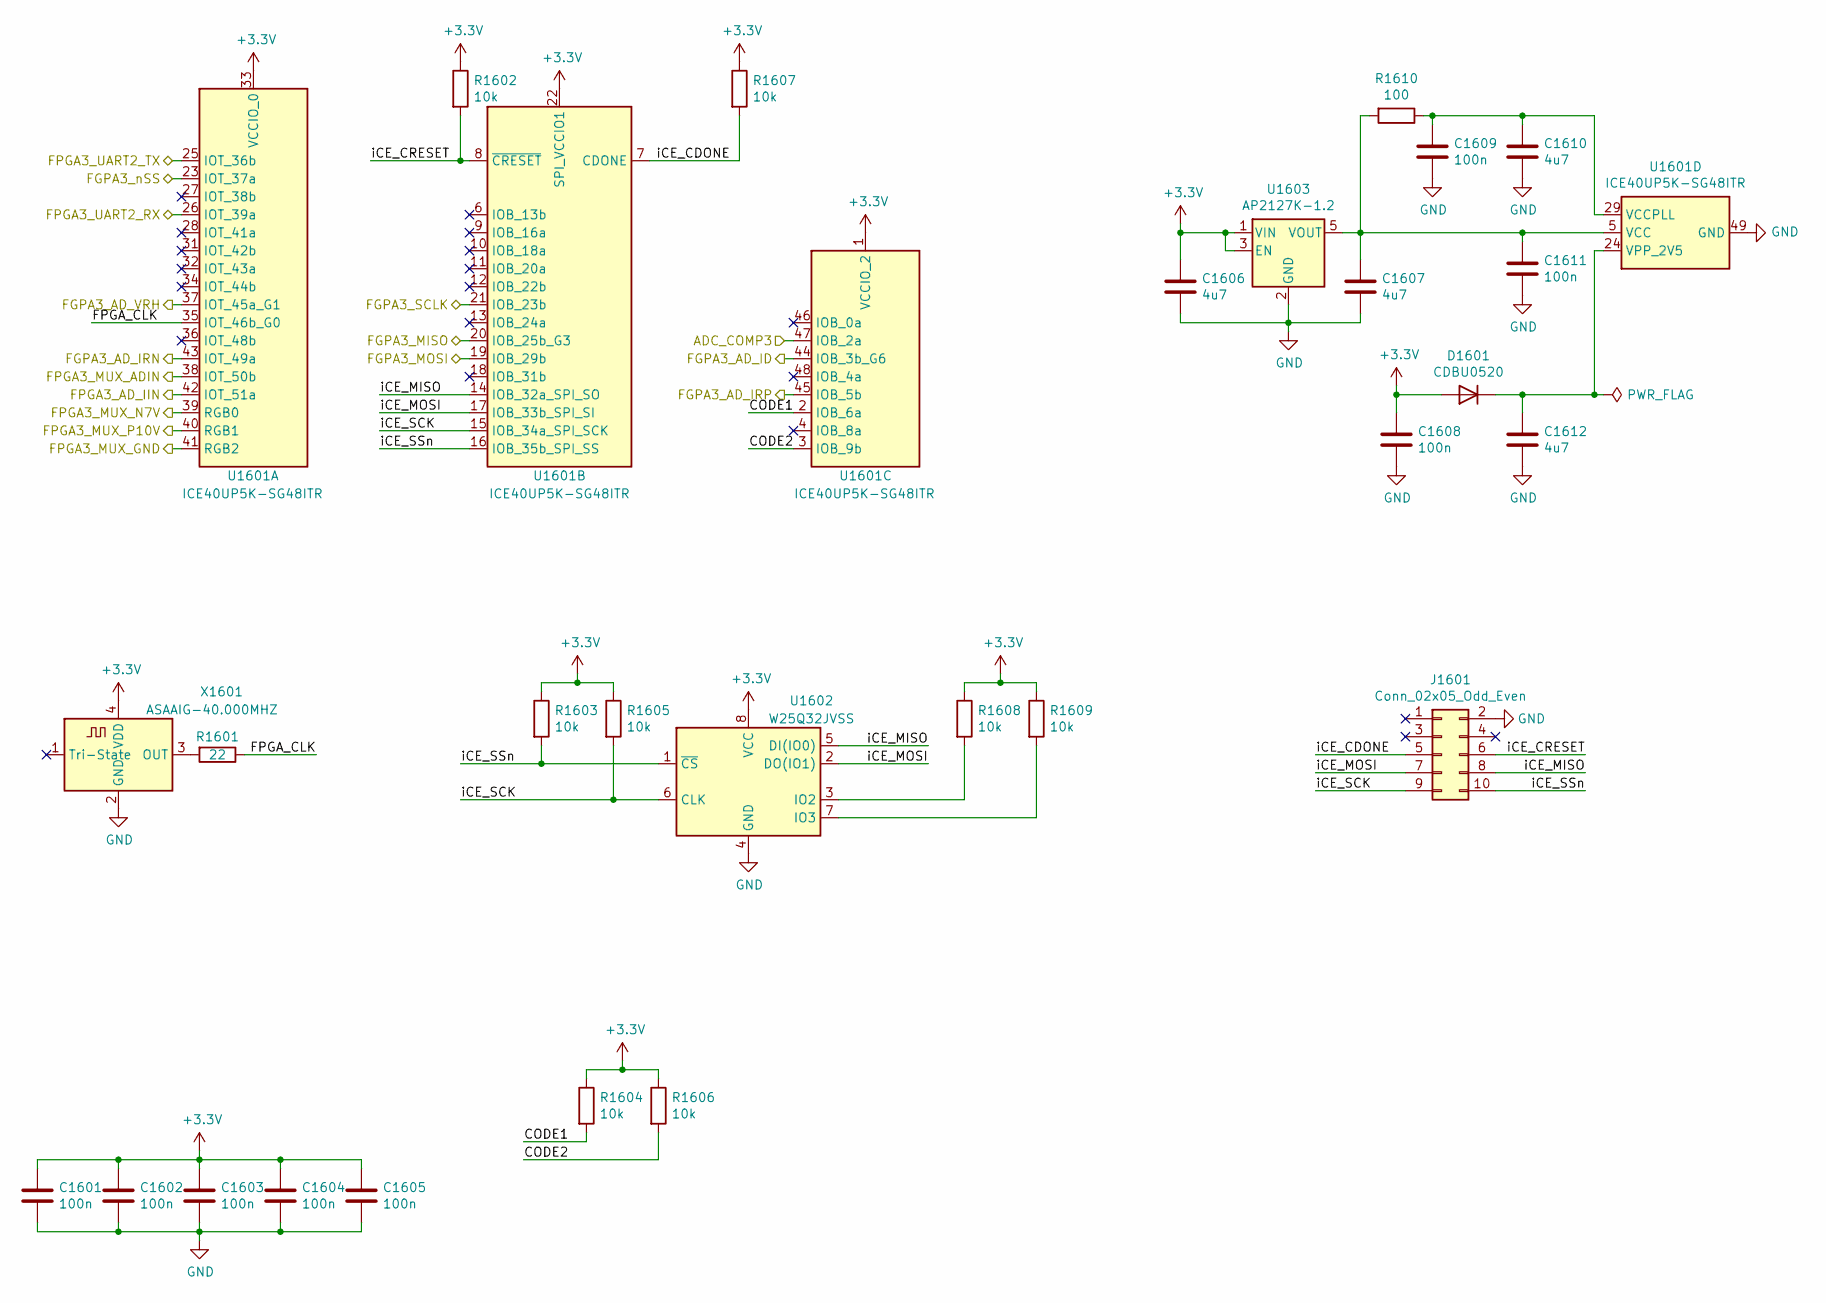
[picture p17: schematic FPGA3.sch]

Parts:
C1601, C1602, C1603, C1604, C1605, C1608, C1609, C1611: 100n; C_0402_1005Metric_Pad0.74x0.62mm_HandSolder
C1606, C1607, C1610, C1612: 4u7; C_0603_1608Metric_Pad1.08x0.95mm_HandSolder
D1601: CDBU0520; D_SOD-523
J1601: Conn_02x05_Odd_Even; PinHeader_2x05_P1.27mm_Vertical
R1601: 22; R_0402_1005Metric_Pad0.72x0.64mm_HandSolder
R1602, R1603, R1604, R1605, R1606, R1607, R1608, R1609: 10k; R_0402_1005Metric_Pad0.72x0.64mm_HandSolder
R1610: 100; R_0402_1005Metric_Pad0.72x0.64mm_HandSolder
U1601: ICE40UP5K-SG48ITR; QFN-48-1EP_7x7mm_P0.5mm_EP5.6x5.6mm_ThermalVias
U1602: W25Q32JVSS; SOIC-8_5.23x5.23mm_P1.27mm
U1603: AP2127K-1.2; SOT-23-5
X1601: ASAAIG-40.000MHZ; ASAAIG

Connections:
/ADC 3/FGPA3_AD_ID: U1601.44 (IOB_3b_G6); also elsewhere on the board
/ADC 3/FGPA3_AD_IIN: U1601.42 (IOT_51a); also elsewhere on the board
/ADC 3/FGPA3_AD_IRN: U1601.43 (IOT_49a); also elsewhere on the board
/ADC 3/FGPA3_AD_IRP: U1601.45 (IOB_5b); also elsewhere on the board
/ADC 3/FPGA3_MUX_ADIN: U1601.38 (IOT_50b); also elsewhere on the board
/ADC 3/FPGA3_MUX_GND: U1601.41 (RGB2); also elsewhere on the board
/ADC 3/FPGA3_MUX_N7V: U1601.39 (RGB0); also elsewhere on the board
/ADC 3/FPGA3_MUX_P10V: U1601.40 (RGB1); also elsewhere on the board
/FPGA 1/FGPA1_SCLK: U1601.21 (IOB_23b); also elsewhere on the board
/FPGA 1/FGPA1_nSS: U1601.23 (IOT_37a); also elsewhere on the board
/FPGA 2/FGPA2_MISO: U1601.19 (IOB_29b); also elsewhere on the board
/FPGA 3/ADC_COMP3: U1601.47 (IOB_2a); also elsewhere on the board
/FPGA 3/CODE1: R1604.2, U1601.2 (IOB_6a)
/FPGA 3/CODE2: R1606.2, U1601.3 (IOB_9b)
/FPGA 3/FGPA3_AD_VRH: U1601.37 (IOT_45a_G1); also elsewhere on the board
/FPGA 3/FGPA3_MISO: U1601.20 (IOB_25b_G3); also elsewhere on the board
/FPGA 3/FPGA3_UART2_RX: U1601.26 (IOT_39a); also elsewhere on the board
/FPGA 3/FPGA3_UART2_TX: U1601.25 (IOT_36b); also elsewhere on the board
/FPGA 3/FPGA_CLK: R1601.1, U1601.35 (IOT_46b_G0)
/FPGA 3/iCE_CDONE: J1601.5, R1607.2, U1601.7 (CDONE)
/FPGA 3/iCE_CRESET: J1601.6, R1602.2, U1601.8 (~CRESET)
/FPGA 3/iCE_MISO: J1601.8, U1601.14 (IOB_32a_SPI_SO), U1602.5 (DI(IO0))
/FPGA 3/iCE_MOSI: J1601.7, U1601.17 (IOB_33b_SPI_SI), U1602.2 (DO(IO1))
/FPGA 3/iCE_SCK: J1601.9, R1605.2, U1601.15 (IOB_34a_SPI_SCK), U1602.6 (CLK)
/FPGA 3/iCE_SSn: J1601.10, R1603.2, U1601.16 (IOB_35b_SPI_SS), U1602.1 (~CS)
AGNDF: C1601.2, C1602.2, C1603.2, C1604.2, C1605.2, C1606.2, C1607.2, C1608.2, C1609.2, C1610.2, C1611.2, C1612.2, J1601.2, U1601.49 (GND), U1602.4 (GND), U1603.2 (GND), X1601.2 (GND); also elsewhere on the board
unnamed: C1607.1, C1611.1, R1610.2, U1601.5 (VCC), U1601.30 (VCC), U1603.5 (VOUT)
unnamed: C1609.1, C1610.1, R1610.1, U1601.29 (VCCPLL)
unnamed: C1612.1, D1601.1 (K), U1601.24 (VPP_2V5)
unnamed: R1601.2, X1601.3 (OUT)
unnamed: R1608.2, U1602.3 (IO2)
unnamed: R1609.2, U1602.7 (IO3)

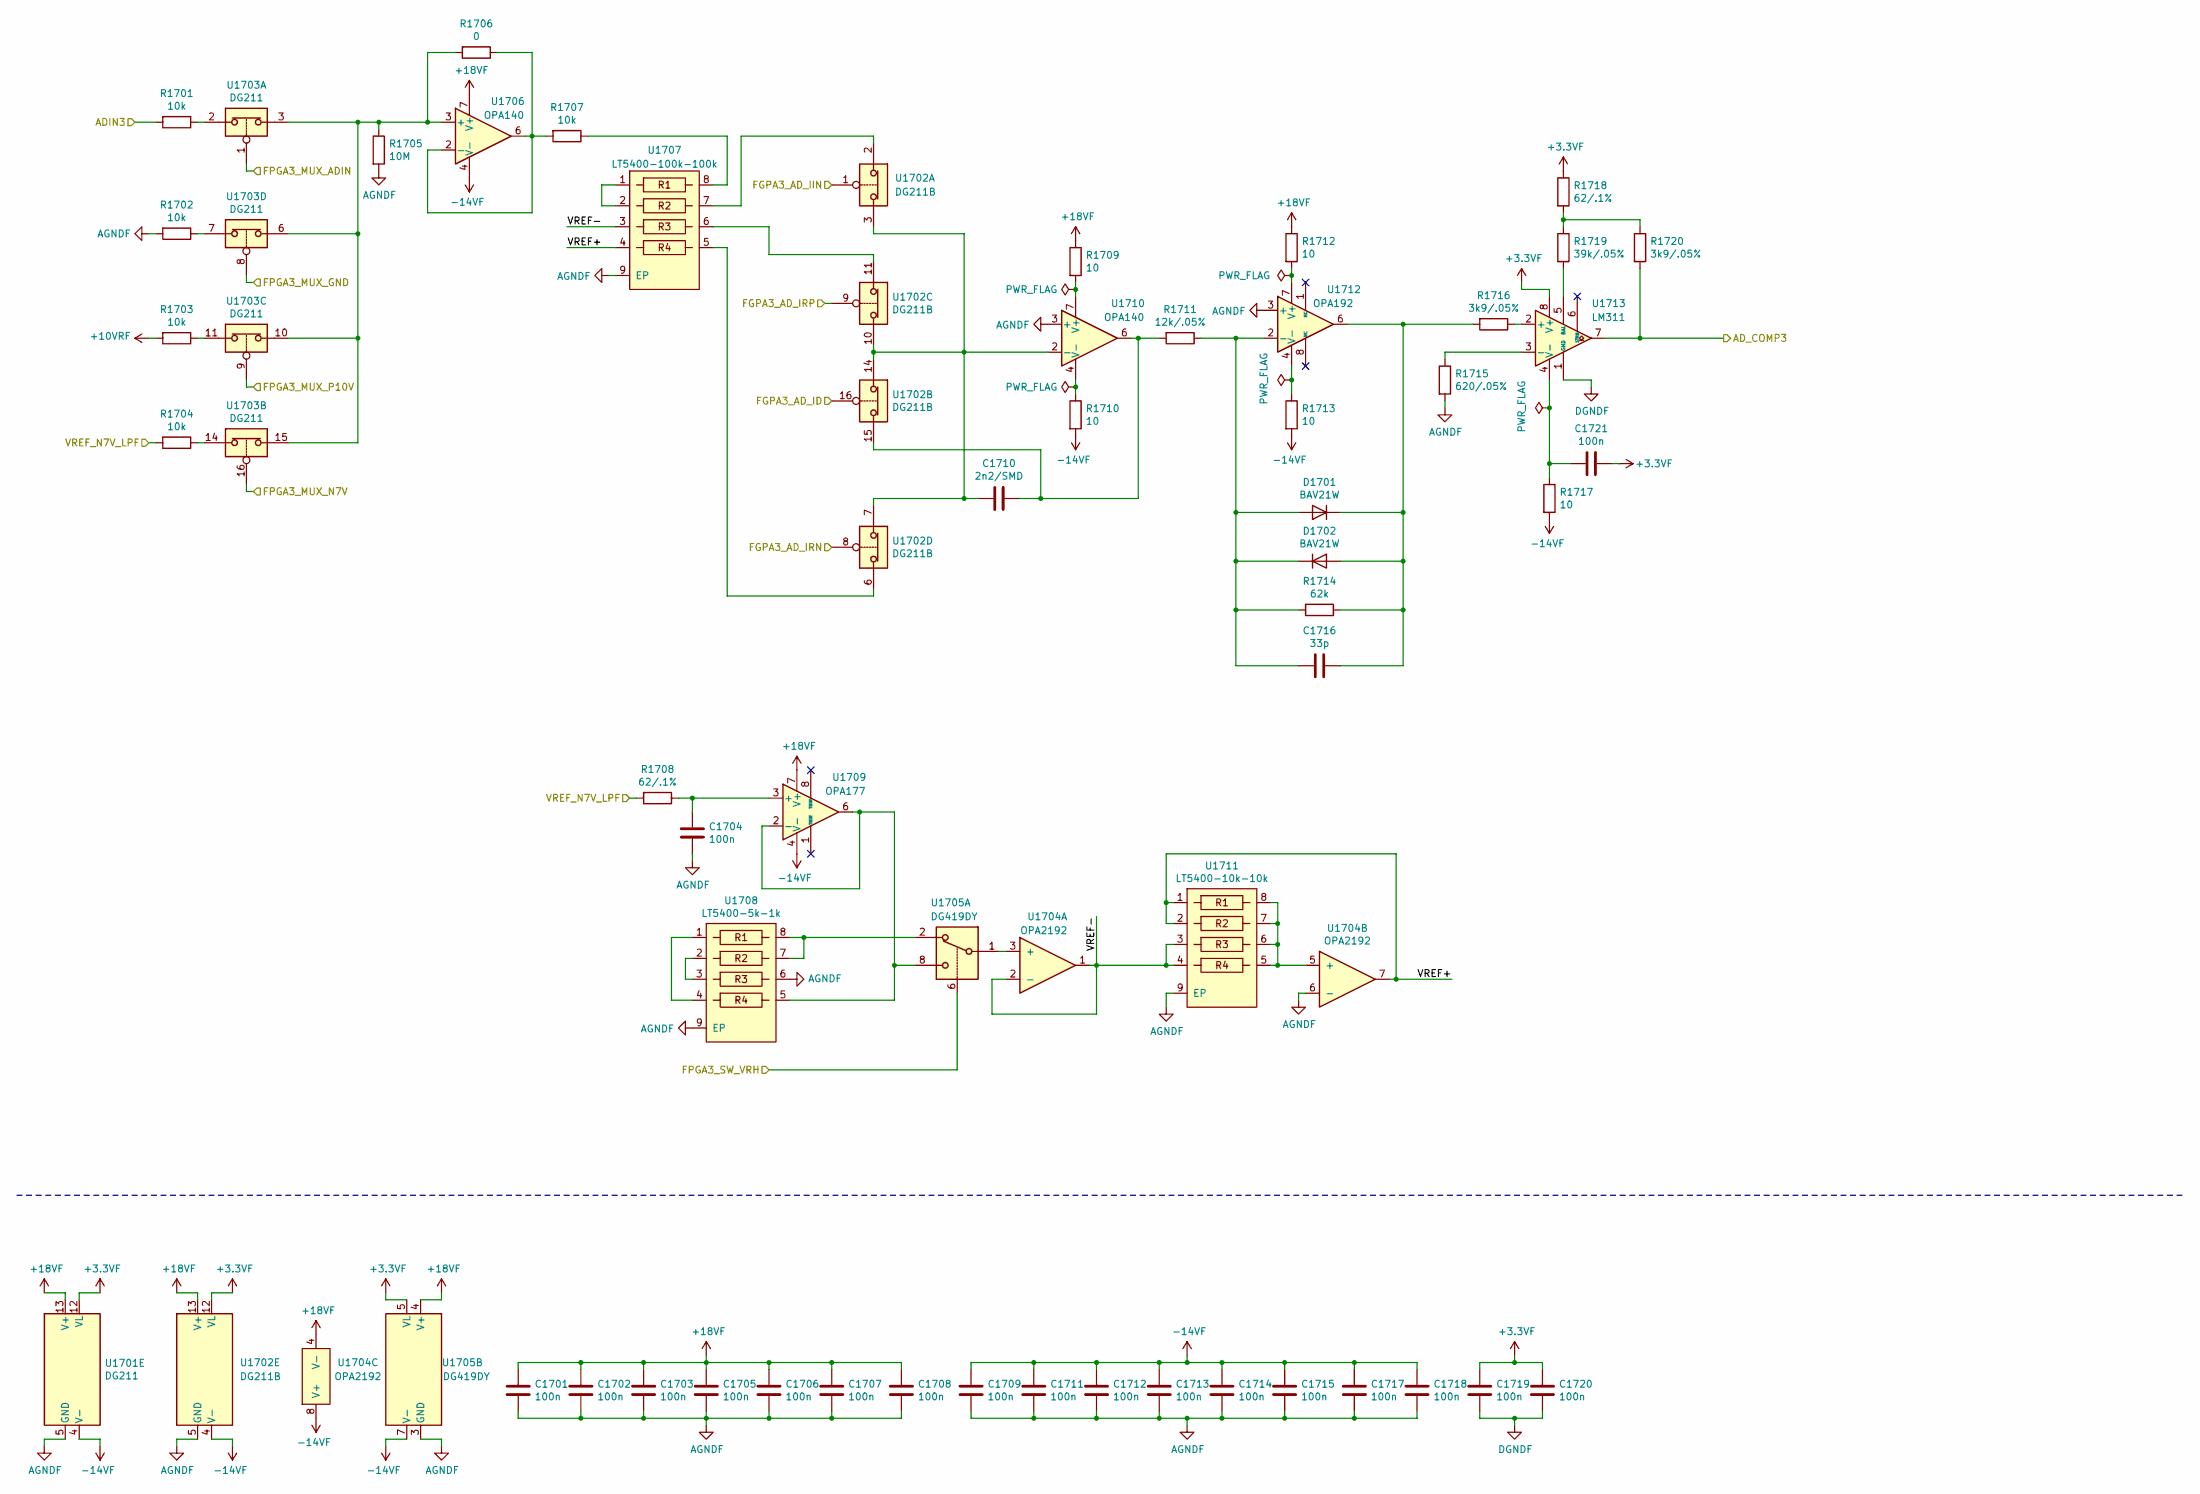
[picture p18: schematic ADC3.sch, ADC]

Parts:
C1701, C1702, C1703, C1704, C1705, C1706, C1707, C1708, C1709, C1711, C1712, C1713, C1714, C1715, C1717, C1718, C1719, C1720, C1721: 100n; C_0402_1005Metric_Pad0.74x0.62mm_HandSolder
C1710: 2n2/SMD; C_0603_1608Metric_Pad1.08x0.95mm_HandSolder
C1716: 33p; C_0402_1005Metric_Pad0.74x0.62mm_HandSolder
D1701, D1702: BAV21W; D_SOD-123
R1701, R1702, R1703, R1704, R1707: 10k; R_0402_1005Metric_Pad0.72x0.64mm_HandSolder
R1705: 10M; R_0603_1608Metric_Pad0.98x0.95mm_HandSolder
R1706: 0; R_0402_1005Metric_Pad0.72x0.64mm_HandSolder
R1708, R1718: 62/.1%; R_0603_1608Metric_Pad0.98x0.95mm_HandSolder
R1709, R1710, R1712, R1713, R1717: 10; R_0402_1005Metric_Pad0.72x0.64mm_HandSolder
R1711: 12k/.05%; R_0603_1608Metric_Pad0.98x0.95mm_HandSolder
R1714: 62k; R_0402_1005Metric_Pad0.72x0.64mm_HandSolder
R1715: 620/.05%; R_0603_1608Metric_Pad0.98x0.95mm_HandSolder
R1716, R1720: 3k9/.05%; R_0603_1608Metric_Pad0.98x0.95mm_HandSolder
R1719: 39k/.05%; R_0603_1608Metric_Pad0.98x0.95mm_HandSolder
U1701, U1703: DG211; TSSOP-16_4.4x5mm_P0.65mm
U1702: DG211B; TSSOP-16_4.4x5mm_P0.65mm
U1704: OPA2192; SOIC-8_3.9x4.9mm_P1.27mm
U1705: DG419DY; SOIC-8_3.9x4.9mm_P1.27mm
U1706, U1710: OPA140; SOIC-8_3.9x4.9mm_P1.27mm
U1707: LT5400-100k-100k; MSOP-8-1EP_3x3mm_P0.65mm_EP1.73x1.85mm_ThermalVias
U1708: LT5400-5k-1k; MSOP-8-1EP_3x3mm_P0.65mm_EP1.73x1.85mm_ThermalVias
U1709: OPA177; SOIC-8_3.9x4.9mm_P1.27mm
U1711: LT5400-10k-10k; MSOP-8-1EP_3x3mm_P0.65mm_EP1.73x1.85mm_ThermalVias
U1712: OPA192; SOIC-8_3.9x4.9mm_P1.27mm
U1713: LM311; SOIC-8_3.9x4.9mm_P1.27mm

Connections:
+10VRF: R1703.2; also elsewhere on the board
+18VF: C1701.1, C1702.1, C1703.1, C1705.1, C1706.1, C1707.1, C1708.1, R1709.1, R1712.1, U1701.13 (V+), U1702.13 (V+), U1704.4 (V-), U1705.4 (V+), U1706.7 (V+), U1709.7 (V+); also elsewhere on the board
-14VF: C1709.1, C1711.1, C1712.1, C1713.1, C1714.1, C1715.1, C1717.1, C1718.1, R1710.2, R1713.2, R1717.2, U1701.4 (V-), U1702.4 (V-), U1704.8 (V+), U1705.7 (V-), U1706.4 (V-), U1709.4 (V-); also elsewhere on the board
/ADC 1/VREF_N7V_LPF: R1704.2, R1708.2; also elsewhere on the board
/ADC 3/ADIN3: R1701.2; also elsewhere on the board
/ADC 3/FGPA3_AD_ID: U1702.16; also elsewhere on the board
/ADC 3/FGPA3_AD_IIN: U1702.1; also elsewhere on the board
/ADC 3/FGPA3_AD_IRN: U1702.8; also elsewhere on the board
/ADC 3/FGPA3_AD_IRP: U1702.9; also elsewhere on the board
/ADC 3/FPGA3_MUX_ADIN: U1703.1; also elsewhere on the board
/ADC 3/FPGA3_MUX_GND: U1703.8; also elsewhere on the board
/ADC 3/FPGA3_MUX_N7V: U1703.16; also elsewhere on the board
/ADC 3/FPGA3_MUX_P10V: U1703.9; also elsewhere on the board
/ADC 3/VREF+: U1704.7, U1707.4, U1711.1, U1711.2
/ADC 3/VREF-: U1704.1, U1704.2 (-), U1707.3, U1711.3, U1711.4
/FPGA 3/ADC_COMP3: R1720.2, U1713.7; also elsewhere on the board
/FPGA 3/FGPA3_AD_VRH: U1705.6; also elsewhere on the board
AGNDF: C1701.2, C1702.2, C1703.2, C1704.2, C1705.2, C1706.2, C1707.2, C1708.2, C1709.2, C1711.2, C1712.2, C1713.2, C1714.2, C1715.2, C1717.2, C1718.2, C1719.2, C1720.2, R1702.2, R1705.2, R1715.2, U1701.5 (GND), U1702.5 (GND), U1704.6 (-), U1705.3 (GND), U1707.9 (EP), U1708.6, U1708.9 (EP), U1710.3 (+), U1711.9 (EP), U1712.3 (+), U1713.1 (GND); also elsewhere on the board
unnamed: C1704.1, R1708.1, U1709.3 (+)
unnamed: C1710.1, R1711.2, U1702.15, U1710.6
unnamed: C1710.2, U1702.3, U1702.7, U1702.10, U1702.14, U1710.2 (-)
unnamed: C1716.1, D1701.1 (K), D1702.2 (A), R1714.1, R1716.2, U1712.6
unnamed: C1716.2, D1701.2 (A), D1702.1 (K), R1711.1, R1714.2, U1712.2 (-)
unnamed: C1721.2, R1717.1, U1713.4 (V-)
unnamed: R1701.1, U1703.2
unnamed: R1702.1, U1703.7
unnamed: R1703.1, U1703.11
unnamed: R1704.1, U1703.14
unnamed: R1705.1, R1706.2, U1703.3, U1703.6, U1703.10, U1703.15, U1706.3 (+)
unnamed: R1706.1, R1707.2, U1706.2 (-), U1706.6
unnamed: R1707.1, U1707.8
unnamed: R1709.2, U1710.7 (V+)
unnamed: R1710.1, U1710.4 (V-)
unnamed: R1712.2, U1712.7 (V+)
unnamed: R1713.1, U1712.4 (V-)
unnamed: R1715.1, U1713.3 (-)
unnamed: R1716.1, U1713.2 (+)
unnamed: R1718.2, R1719.1, R1720.1
unnamed: R1719.2, U1713.5 (BAL)
unnamed: U1702.2, U1707.7
unnamed: U1702.6, U1707.5
unnamed: U1702.11, U1707.6
unnamed: U1704.3 (+), U1705.1
unnamed: U1704.5 (+), U1711.5, U1711.6, U1711.7, U1711.8
unnamed: U1705.2, U1708.7, U1708.8
unnamed: U1705.8, U1708.5, U1709.2 (-), U1709.6
unnamed: U1707.1, U1707.2
unnamed: U1708.1, U1708.4
unnamed: U1708.2, U1708.3

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
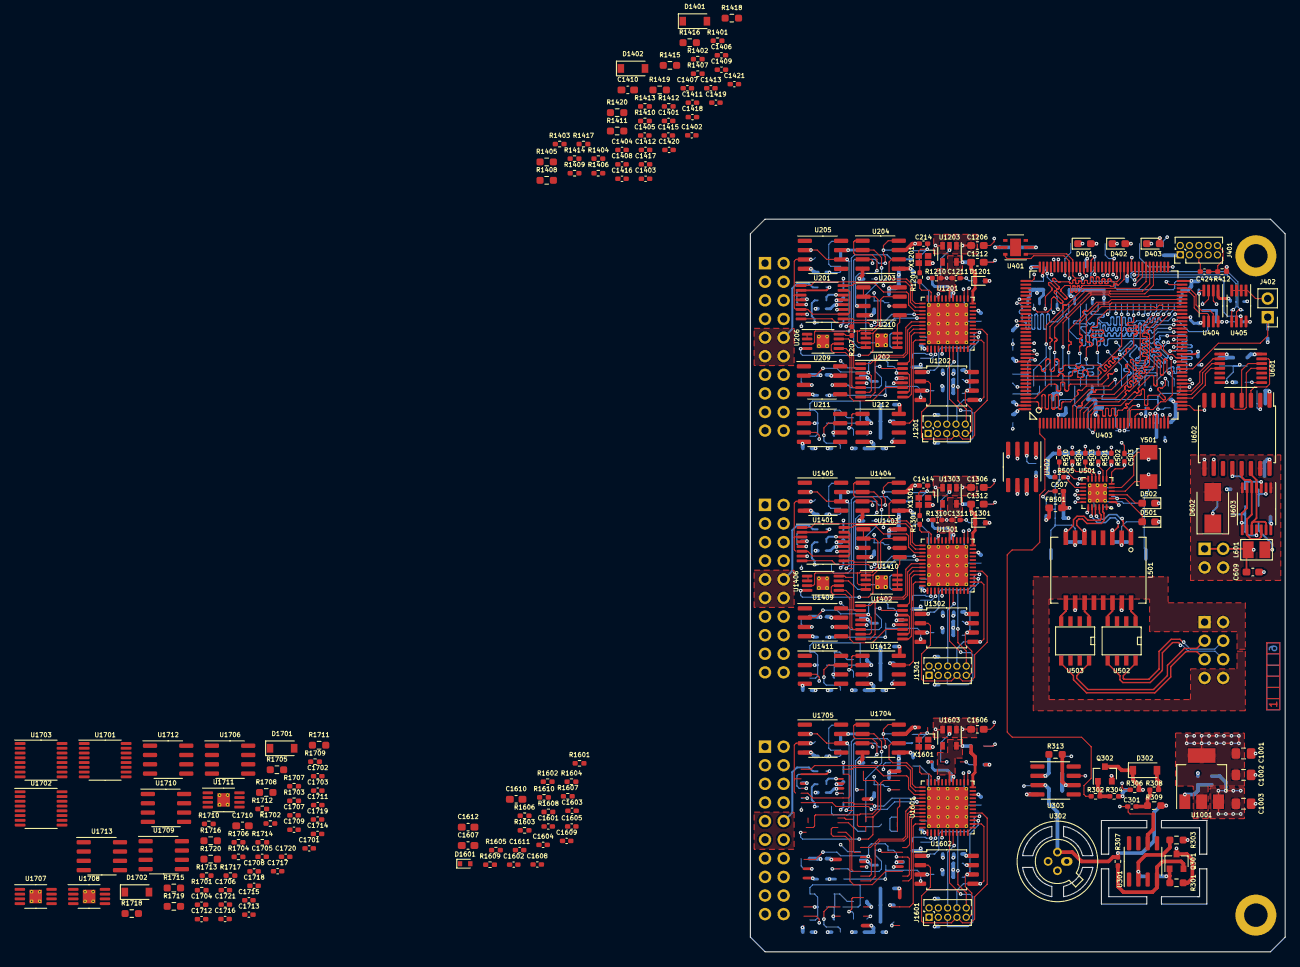
[picture p19: board ETH3CADC1.kicad_pcb from above]

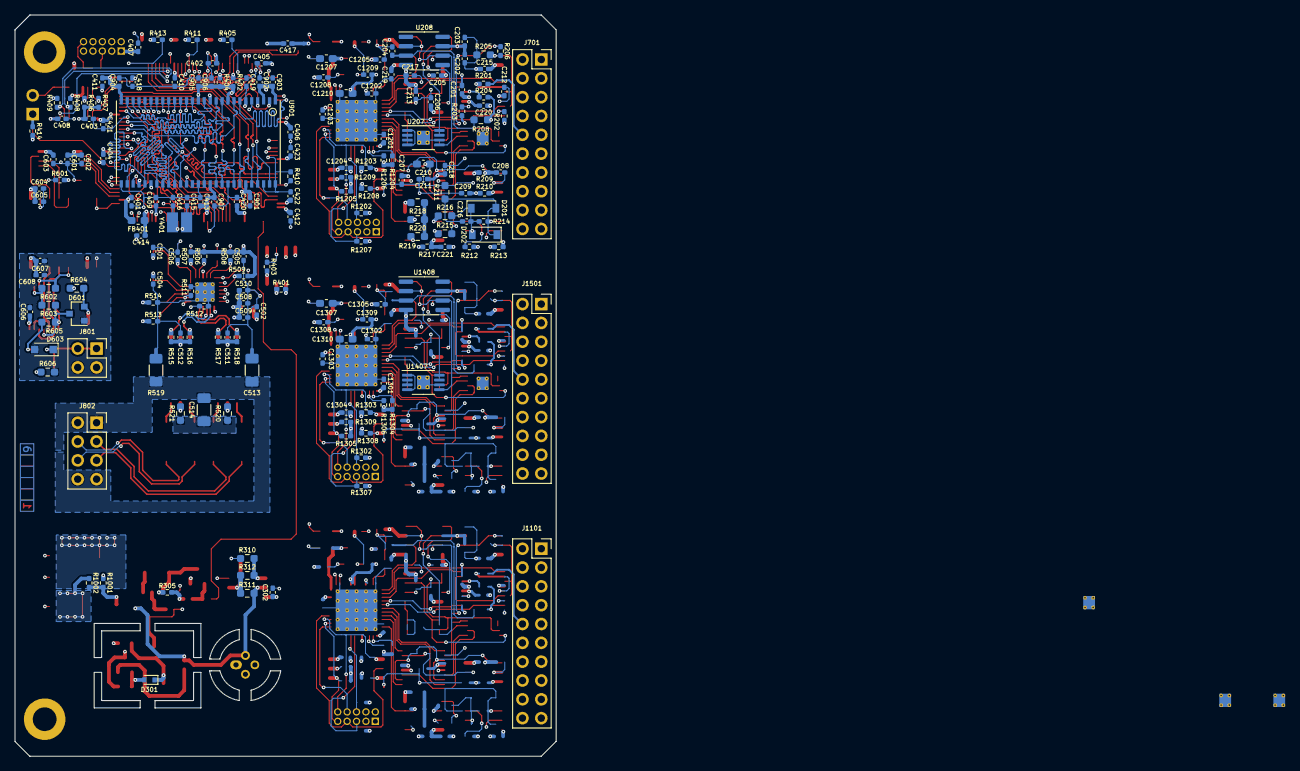
[picture p20: board ETH3CADC1.kicad_pcb from below]

Board: 6 copper layers, 73.0 x 100.0 mm, 408 parts (181 on the bottom side), 334 nets.

Other parts of the board:
C1201, C1202, C1203, C1204, C1205, C1208, C1209, C1211: 100n; C_0402_1005Metric_Pad0.74x0.62mm_HandSolder
C1206, C1207, C1210, C1212: 4u7; C_0603_1608Metric_Pad1.08x0.95mm_HandSolder
D1201: CDBU0520; D_SOD-523
J1201: Conn_02x05_Odd_Even; PinHeader_2x05_P1.27mm_Vertical
R1201: 22; R_0402_1005Metric_Pad0.72x0.64mm_HandSolder
R1202, R1203, R1204, R1205, R1207, R1208, R1209: 10k; R_0402_1005Metric_Pad0.72x0.64mm_HandSolder
R1206: NC; R_0402_1005Metric_Pad0.72x0.64mm_HandSolder
R1210: 100; R_0402_1005Metric_Pad0.72x0.64mm_HandSolder
U1201: ICE40UP5K-SG48ITR; QFN-48-1EP_7x7mm_P0.5mm_EP5.6x5.6mm_ThermalVias
U1202: W25Q32JVSS; SOIC-8_5.23x5.23mm_P1.27mm
U1203: AP2127K-1.2; SOT-23-5
X1201: ASAAIG-40.000MHZ; ASAAIG

Their connections:
/ADC 1/FGPA1_AD_ID: U1201.44; also elsewhere on the board
/ADC 1/FGPA1_AD_IIN: U1201.42; also elsewhere on the board
/ADC 1/FGPA1_AD_IRN: U1201.43; also elsewhere on the board
/ADC 1/FGPA1_AD_IRP: U1201.45; also elsewhere on the board
/ADC 1/FPGA1_MUX_ADIN: U1201.38; also elsewhere on the board
/ADC 1/FPGA1_MUX_GND: U1201.41; also elsewhere on the board
/ADC 1/FPGA1_MUX_N7V: U1201.39; also elsewhere on the board
/ADC 1/FPGA1_MUX_P10V: U1201.40; also elsewhere on the board
/FPGA 1/ADC_COMP1: U1201.47; also elsewhere on the board
/FPGA 1/CODE1: R1204.2, U1201.2
/FPGA 1/CODE2: R1206.2, U1201.3
/FPGA 1/FGPA1_AD_VRH: U1201.37; also elsewhere on the board
/FPGA 1/FGPA1_MISO: U1201.20; also elsewhere on the board
/FPGA 1/FGPA1_MOSI: U1201.19; also elsewhere on the board
/FPGA 1/FGPA1_SCLK: U1201.21; also elsewhere on the board
/FPGA 1/FGPA1_nSS: U1201.23; also elsewhere on the board
/FPGA 1/FPGA1_UART6_RX: U1201.26; also elsewhere on the board
/FPGA 1/FPGA1_UART6_TX: U1201.25; also elsewhere on the board
/FPGA 1/FPGA_CLK: R1201.1, U1201.35
/FPGA 1/iCE_CDONE: J1201.5, R1207.2, U1201.7
/FPGA 1/iCE_CRESET: J1201.6, R1202.2, U1201.8
/FPGA 1/iCE_MISO: J1201.8, U1201.14, U1202.5
/FPGA 1/iCE_MOSI: J1201.7, U1201.17, U1202.2
/FPGA 1/iCE_SCK: J1201.9, R1205.2, U1201.15, U1202.6
/FPGA 1/iCE_SSn: J1201.10, R1203.2, U1201.16, U1202.1
AGNDF: C1201.2, C1202.2, C1203.2, C1204.2, C1205.2, C1206.2, C1207.2, C1208.2, C1209.2, C1210.2, C1211.2, C1212.2, J1201.2, U1201.49, U1202.4, U1203.2, X1201.2; also elsewhere on the board
unnamed: C1207.1, C1211.1, R1210.2, U1201.5, U1201.30, U1203.5
unnamed: C1209.1, C1210.1, R1210.1, U1201.29
unnamed: C1212.1, D1201.1, U1201.24
unnamed: R1201.2, X1201.3
unnamed: R1208.2, U1202.3
unnamed: R1209.2, U1202.7
