BehrensG/ETH3CDAQ1/hardware/project/ETH3CDAQ1_BASE/ETH3CDAQ1_BASE.kicad_pcb

## KiCad design hardware/project/ETH3CDAQ1_BASE/ETH3CDAQ1_BASE.kicad_pcb (2021-01-10)

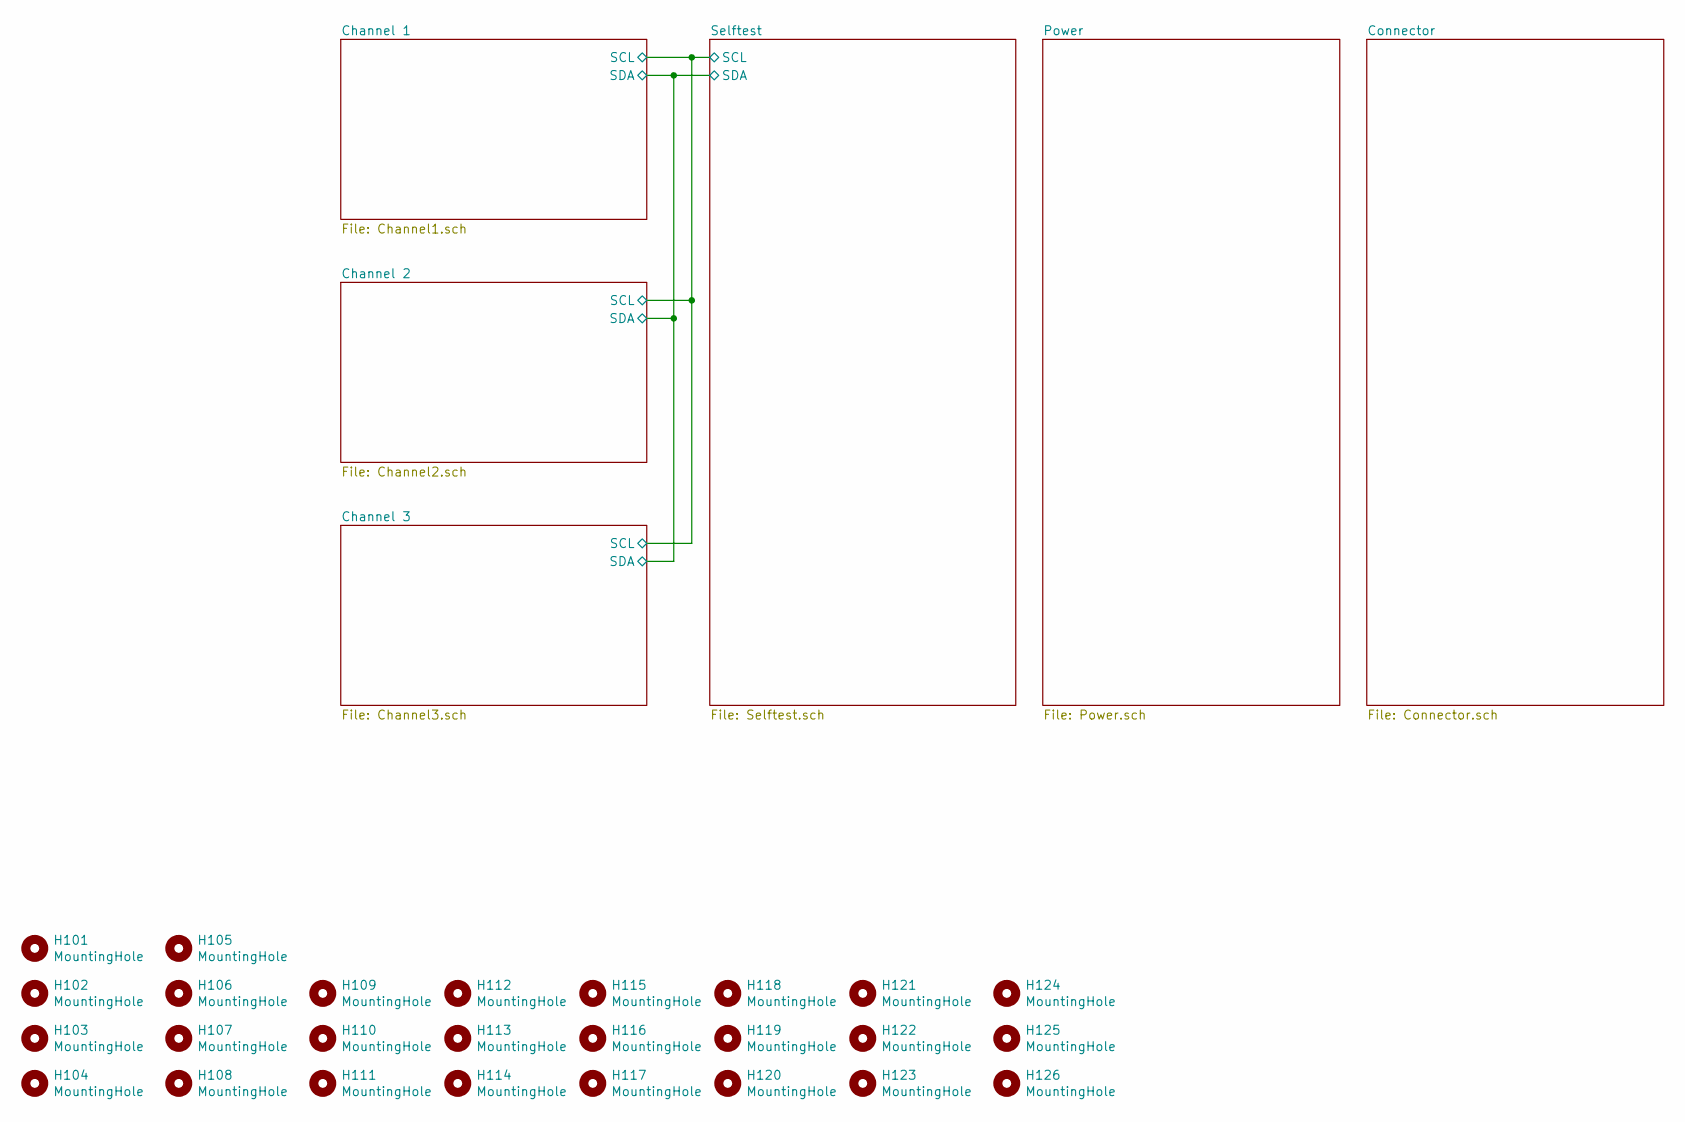
[picture p21: schematic ETH3CDAQ1_BASE.sch]

Parts:
H101, H105: MountingHole; MountingHole_3.2mm_M3_DIN965_Pad
H102, H103, H104, H106, H107, H108, H109, H110, H111, H112, H113, H114, H115, H116, H117, H118, H119, H120, H121, H122, H123, H124, H125, H126: MountingHole; MountingHole_2.7mm_M2.5_DIN965_Pad
