BehrensG/ETH3CDAQ1/hardware/project/ETH3CDAQ1_BASE/ETH3CDAQ1_BASE.kicad_pcb

## KiCad design hardware/project/ETH3CDAQ1_BASE/ETH3CDAQ1_BASE.kicad_pcb (continued)

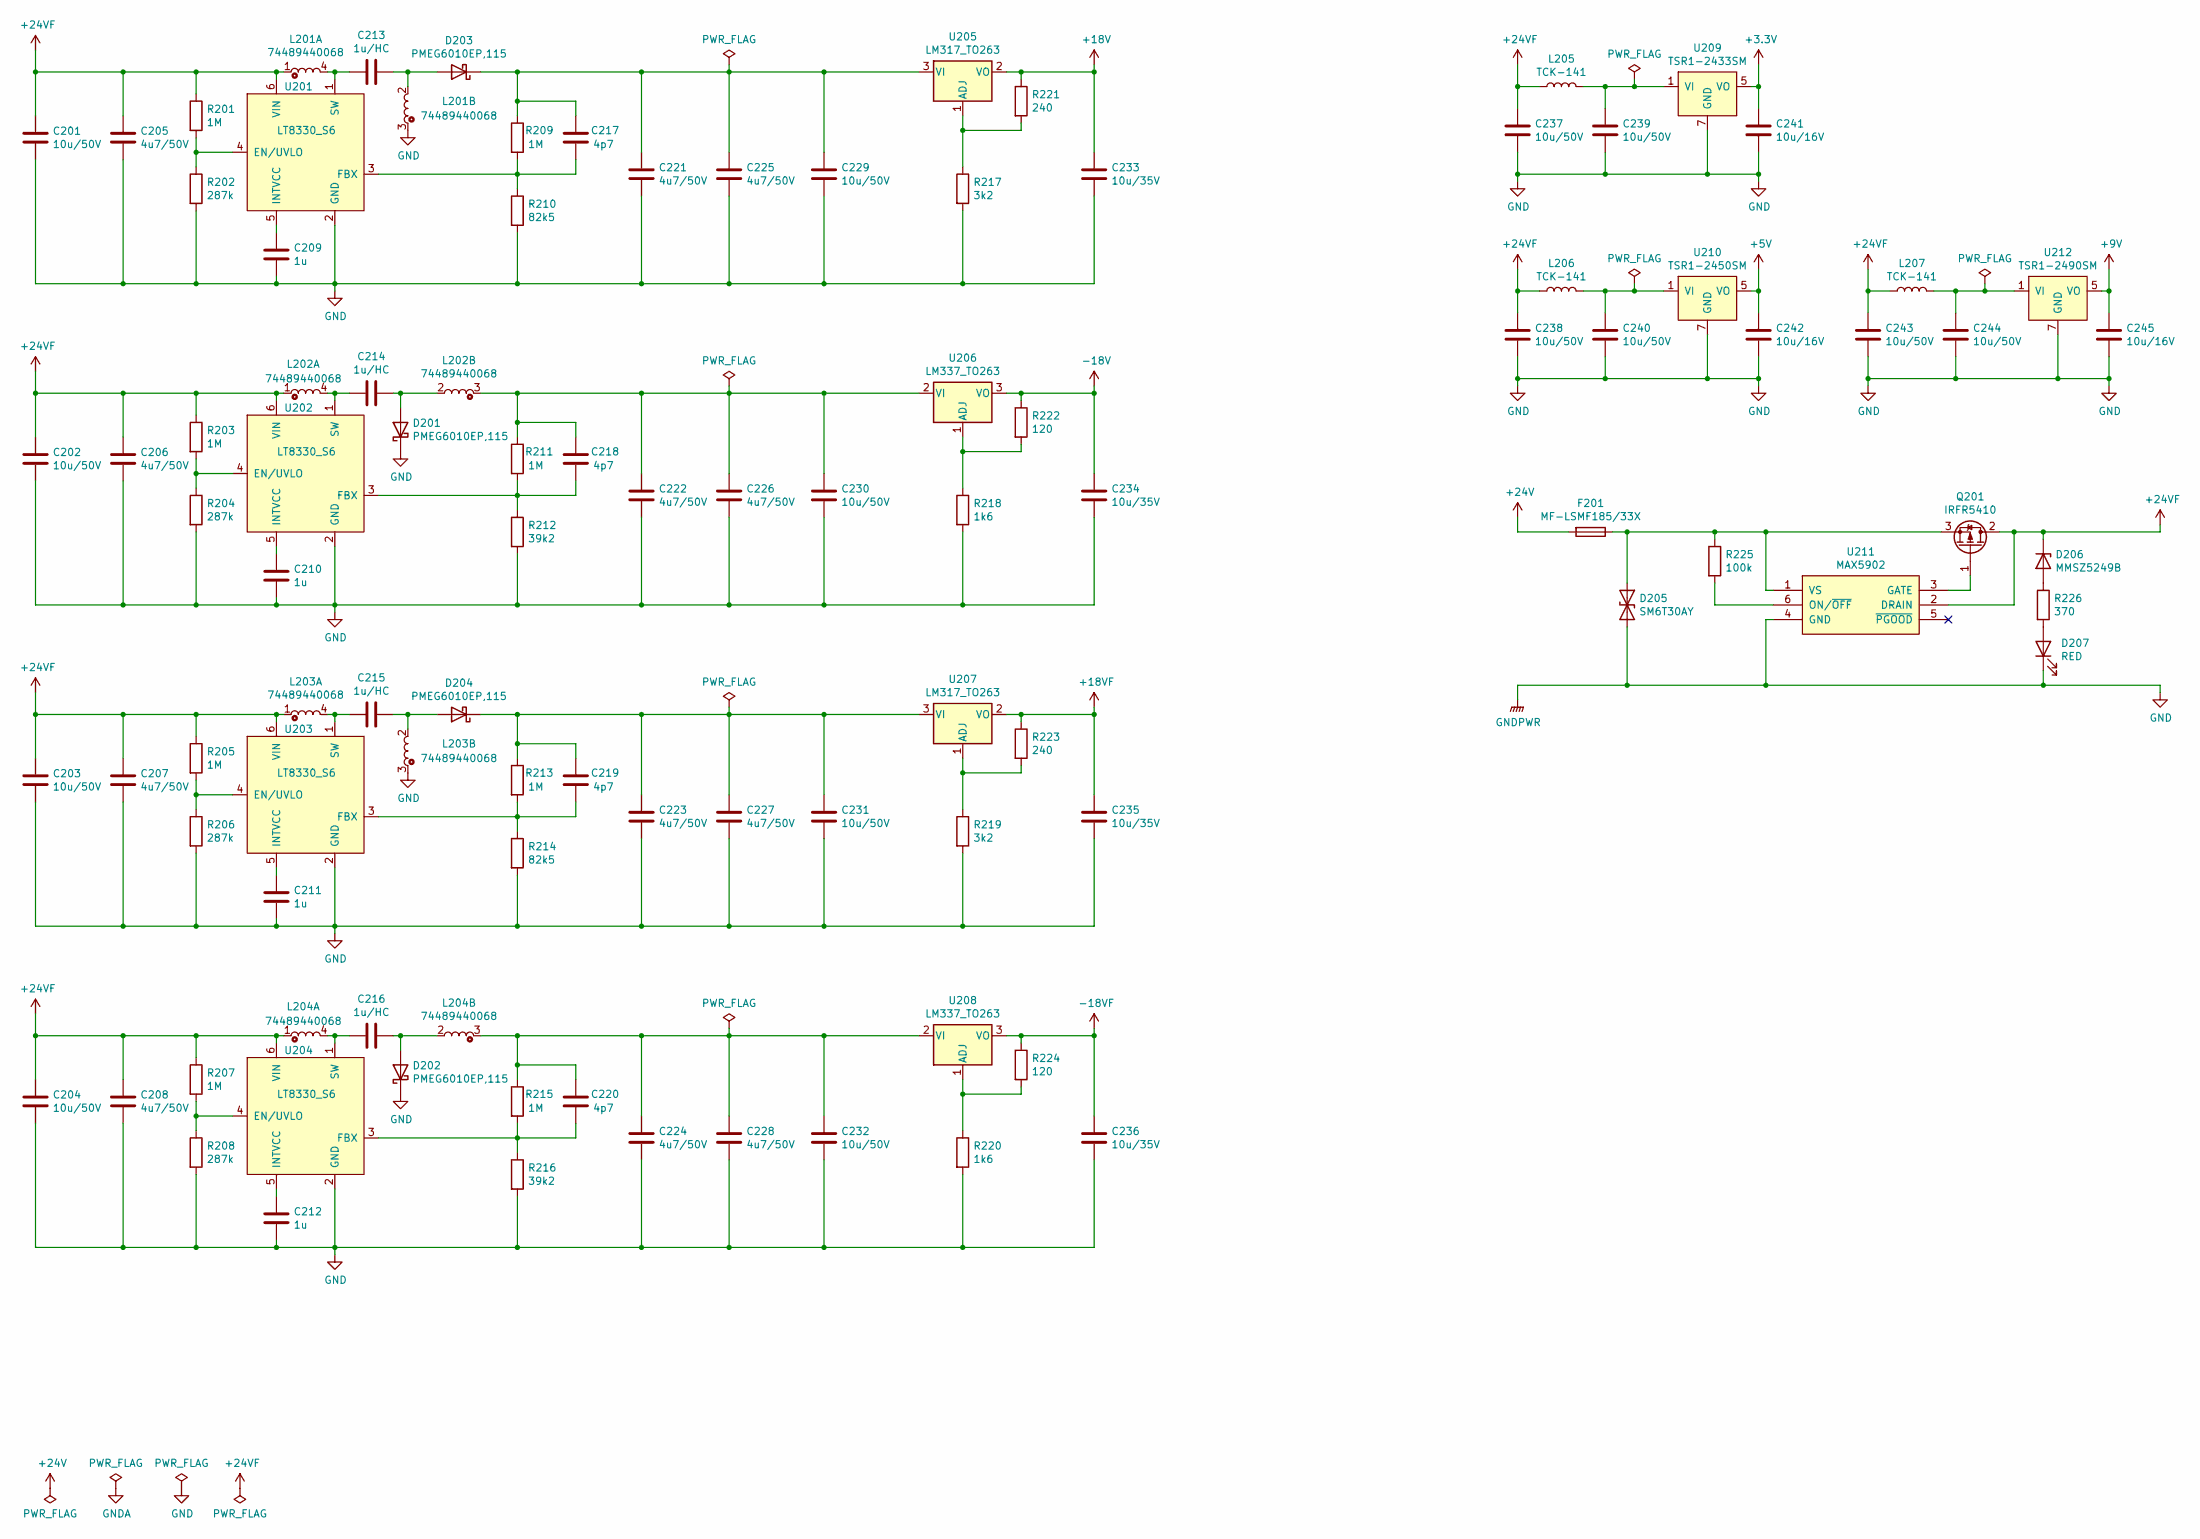
[picture p22: schematic Power.sch, Power float]

Parts:
C201, C202, C203, C204, C229, C230, C231, C232, C237, C238, C239, C240, C243, C244: 10u/50V; C_1206_3216Metric_Pad1.33x1.80mm_HandSolder
C205, C206, C207, C208, C221, C222, C223, C224, C225, C226, C227, C228: 4u7/50V; C_1206_3216Metric_Pad1.33x1.80mm_HandSolder
C209, C210, C211, C212: 1u; C_0603_1608Metric_Pad1.08x0.95mm_HandSolder
C213, C214, C215, C216: 1u/HC; C_1206_3216Metric_Pad1.33x1.80mm_HandSolder
C217, C218, C219, C220: 4p7; C_0603_1608Metric_Pad1.08x0.95mm_HandSolder
C233, C234, C235, C236: 10u/35V; C_1206_3216Metric_Pad1.33x1.80mm_HandSolder
C241, C242, C245: 10u/16V; C_1206_3216Metric_Pad1.33x1.80mm_HandSolder
D201, D202, D203, D204: PMEG6010EP,115; D_SOD-128
D205: SM6T30AY; DO_214AA_REV
D206: MMSZ5249B; D_SOD-123
D207: RED; LED_0603_1608Metric_Pad1.05x0.95mm_HandSolder
F201: MF-LSMF185/33X; Fuse_SMD2920
L201, L202, L203, L204: 74489440068
L205, L206, L207: TCK-141
Q201: IRFR5410; TO-252-2_Rectifier
R201, R203, R205, R207, R209, R211, R213, R215: 1M; R_0603_1608Metric_Pad0.98x0.95mm_HandSolder
R202, R204, R206, R208: 287k; R_0603_1608Metric_Pad0.98x0.95mm_HandSolder
R210, R214: 82k5; R_0603_1608Metric_Pad0.98x0.95mm_HandSolder
R212, R216: 39k2; R_0603_1608Metric_Pad0.98x0.95mm_HandSolder
R217, R219: 3k2; R_0603_1608Metric_Pad1.05x0.95mm_HandSolder
R218, R220: 1k6; R_0603_1608Metric_Pad1.05x0.95mm_HandSolder
R221, R223: 240; R_0603_1608Metric_Pad1.05x0.95mm_HandSolder
R222, R224: 120; R_0603_1608Metric_Pad1.05x0.95mm_HandSolder
R225: 100k; R_0603_1608Metric_Pad0.98x0.95mm_HandSolder
R226: 370; R_0603_1608Metric_Pad0.98x0.95mm_HandSolder
U201, U202, U203, U204: LT8330_S6; TSOT-23-6_HandSoldering
U205, U207: LM317_TO263; TO-263-3_TabPin2
U206, U208: LM337_TO263; TO-263-2
U209: TSR1-2433SM; TSR1SM
U210: TSR1-2450SM; TSR1SM
U211: MAX5902; SOT-23-6_Handsoldering
U212: TSR1-2490SM; TSR1SM

Connections:
+3V3: C241.1, U209.5 (VO); also elsewhere on the board
+5V: C242.1, U210.5 (VO); also elsewhere on the board
+9V: C245.1, U212.5 (VO); also elsewhere on the board
+18V: C233.1, R221.1, U205.2 (VO); also elsewhere on the board
+18VF: C235.1, R223.1, U207.2 (VO); also elsewhere on the board
+24V: F201.2; also elsewhere on the board
+24VF: C201.1, C202.1, C203.1, C204.1, C205.1, C206.1, C207.1, C208.1, C237.1, C238.1, C243.1, D206.1 (K), L201.1, L202.1, L203.1, L204.1, L205.1, L206.1, L207.1, Q201.2 (D), R201.1, R203.1, R205.1, R207.1, U201.6 (VIN), U202.6 (VIN), U203.6 (VIN), U204.6 (VIN), U211.2 (DRAIN)
-18V: C234.1, R222.1, U206.3 (VO); also elsewhere on the board
-18VF: C236.1, R224.1, U208.3 (VO); also elsewhere on the board
GND: C201.2, C202.2, C203.2, C204.2, C205.2, C206.2, C207.2, C208.2, C209.2, C210.2, C211.2, C212.2, C221.2, C222.2, C223.2, C224.2, C225.2, C226.2, C227.2, C228.2, C229.2, C230.2, C231.2, C232.2, C233.2, C234.2, C235.2, C236.2, C237.2, C238.2, C239.2, C240.2, C241.2, C242.2, C243.2, C244.2, C245.2, D201.1 (K), D202.1 (K), D205.2 (A2), D207.1 (K), L201.3, L203.3, R202.2, R204.2, R206.2, R208.2, R210.2, R212.2, R214.2, R216.2, R217.2, R218.2, R219.2, R220.2, U201.2 (GND), U202.2 (GND), U203.2 (GND), U204.2 (GND), U209.7 (GND), U209.9 (GND), U210.7 (GND), U210.9 (GND), U211.4 (GND), U212.7 (GND), U212.9 (GND); also elsewhere on the board
unnamed: C209.1, U201.5 (INTVCC)
unnamed: C210.1, U202.5 (INTVCC)
unnamed: C211.1, U203.5 (INTVCC)
unnamed: C212.1, U204.5 (INTVCC)
unnamed: C213.1, D203.2 (A), L201.2
unnamed: C213.2, L201.4, U201.1 (SW)
unnamed: C214.1, D201.2 (A), L202.2
unnamed: C214.2, L202.4, U202.1 (SW)
unnamed: C215.1, D204.2 (A), L203.2
unnamed: C215.2, L203.4, U203.1 (SW)
unnamed: C216.1, D202.2 (A), L204.2
unnamed: C216.2, L204.4, U204.1 (SW)
unnamed: C217.1, C221.1, C225.1, C229.1, D203.1 (K), R209.1, U205.3 (VI)
unnamed: C217.2, R209.2, R210.1, U201.3 (FBX)
unnamed: C218.1, C222.1, C226.1, C230.1, L202.3, R211.1, U206.2 (VI)
unnamed: C218.2, R211.2, R212.1, U202.3 (FBX)
unnamed: C219.1, C223.1, C227.1, C231.1, D204.1 (K), R213.1, U207.3 (VI)
unnamed: C219.2, R213.2, R214.1, U203.3 (FBX)
unnamed: C220.1, C224.1, C228.1, C232.1, L204.3, R215.1, U208.2 (VI)
unnamed: C220.2, R215.2, R216.1, U204.3 (FBX)
unnamed: C239.1, L205.2, U209.1 (VI)
unnamed: C240.1, L206.2, U210.1 (VI)
unnamed: C244.1, L207.2, U212.1 (VI)
unnamed: D205.1 (A1), F201.1, Q201.3 (S), R225.1, U211.1 (VS)
unnamed: D206.2 (A), R226.1
unnamed: D207.2 (A), R226.2
unnamed: Q201.1 (G), U211.3 (GATE)
unnamed: R201.2, R202.1, U201.4 (EN/UVLO)
unnamed: R203.2, R204.1, U202.4 (EN/UVLO)
unnamed: R205.2, R206.1, U203.4 (EN/UVLO)
unnamed: R207.2, R208.1, U204.4 (EN/UVLO)
unnamed: R217.1, R221.2, U205.1 (ADJ)
unnamed: R218.1, R222.2, U206.1 (ADJ)
unnamed: R219.1, R223.2, U207.1 (ADJ)
unnamed: R220.1, R224.2, U208.1 (ADJ)
unnamed: R225.2, U211.6 (ON/~OFF)

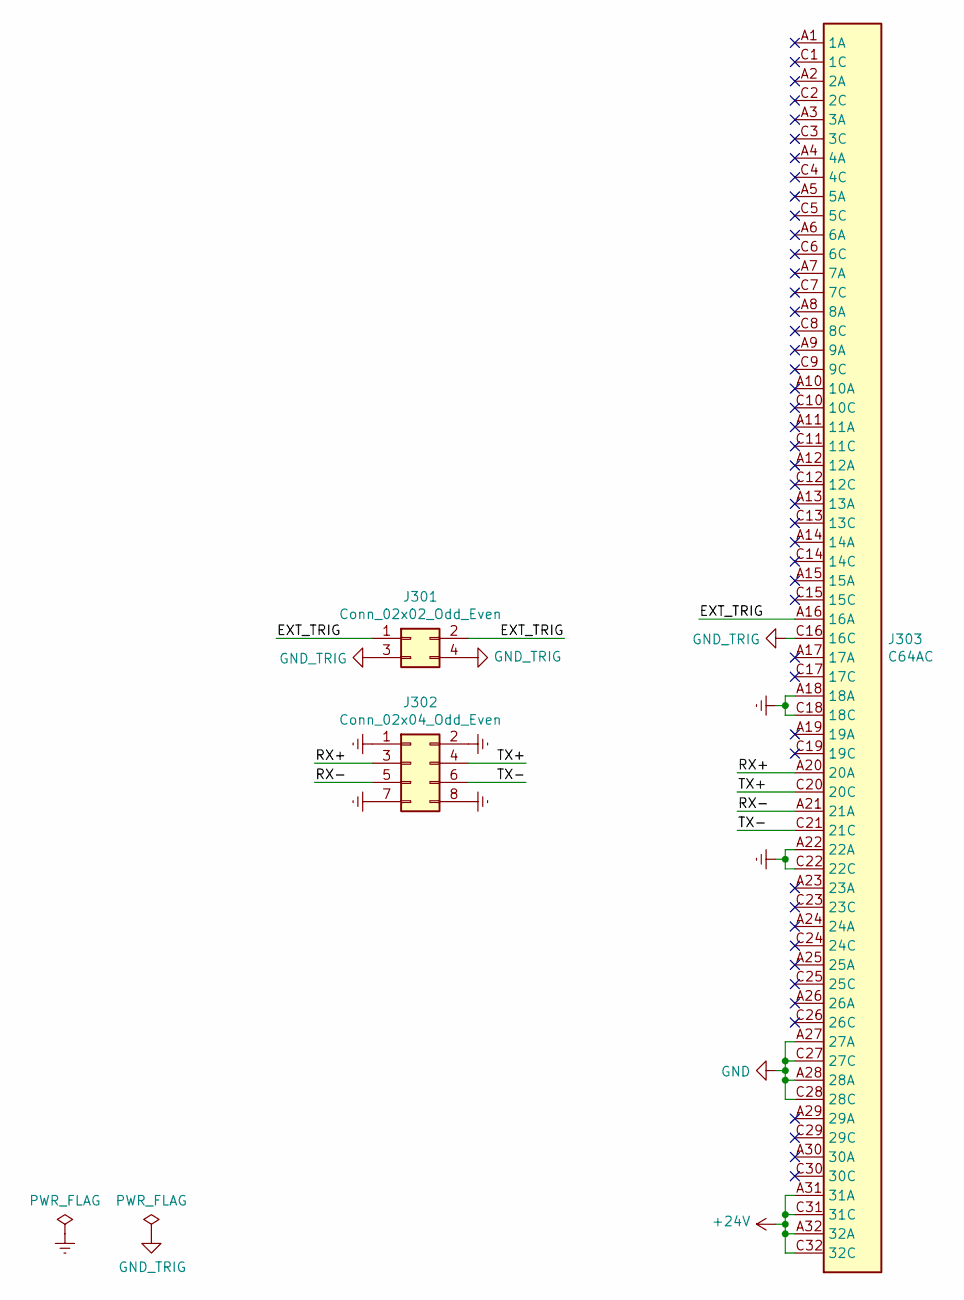
[picture p23: schematic Connector.sch]

Parts:
J301: Conn_02x02_Odd_Even; PinHeader_2x02_P2.54mm_Vertical
J302: Conn_02x04_Odd_Even; PinHeader_2x04_P2.54mm_Vertical
J303: C64AC; Socket_DIN41612-CaseC1-AC-Male-64Pin-2rows

Connections:
+24V: J303.A31 (31A), J303.A32 (32A), J303.C31 (31C), J303.C32 (32C); also elsewhere on the board
/Connector/EXT_TRIG: J301.1, J301.2, J303.A16 (16A)
/Connector/RX+: J302.3, J303.A20 (20A)
/Connector/RX-: J302.5, J303.A21 (21A)
/Connector/TX+: J302.4, J303.C20 (20C)
/Connector/TX-: J302.6, J303.C21 (21C)
Earth: J302.1, J302.2, J302.7, J302.8, J303.A18 (18A), J303.A22 (22A), J303.C18 (18C), J303.C22 (22C)
GND: J303.A27 (27A), J303.A28 (28A), J303.C27 (27C), J303.C28 (28C); also elsewhere on the board
GND_TRIG: J301.3, J301.4, J303.C16 (16C)

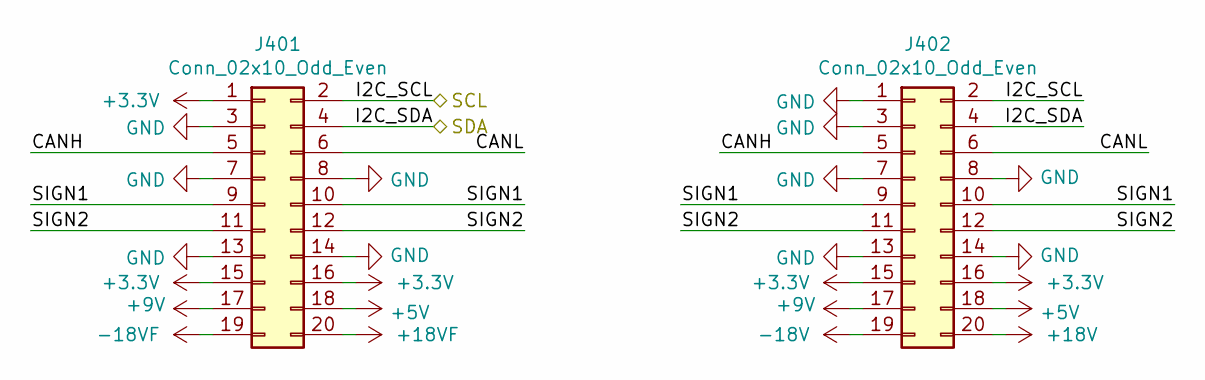
[picture p24: schematic Channel1.sch]

Parts:
J401, J402: Conn_02x10_Odd_Even; PinHeader_2x10_P2.54mm_Vertical

Connections:
+3V3: J401.1, J401.15, J401.16, J402.15, J402.16; also elsewhere on the board
+5V: J401.18, J402.18; also elsewhere on the board
+9V: J401.17, J402.17; also elsewhere on the board
+18V: J402.20; also elsewhere on the board
+18VF: J401.20; also elsewhere on the board
-18V: J402.19; also elsewhere on the board
-18VF: J401.19; also elsewhere on the board
/Channel 1/CANH: J401.5, J402.5
/Channel 1/CANL: J401.6, J402.6
/Channel 1/SCL: J401.2, J402.2; also elsewhere on the board
/Channel 1/SDA: J401.4, J402.4; also elsewhere on the board
/Channel 1/SIGN1: J401.9, J401.10, J402.9, J402.10
/Channel 1/SIGN2: J401.11, J401.12, J402.11, J402.12
GND: J401.3, J401.7, J401.8, J401.13, J401.14, J402.1, J402.3, J402.7, J402.8, J402.13, J402.14; also elsewhere on the board

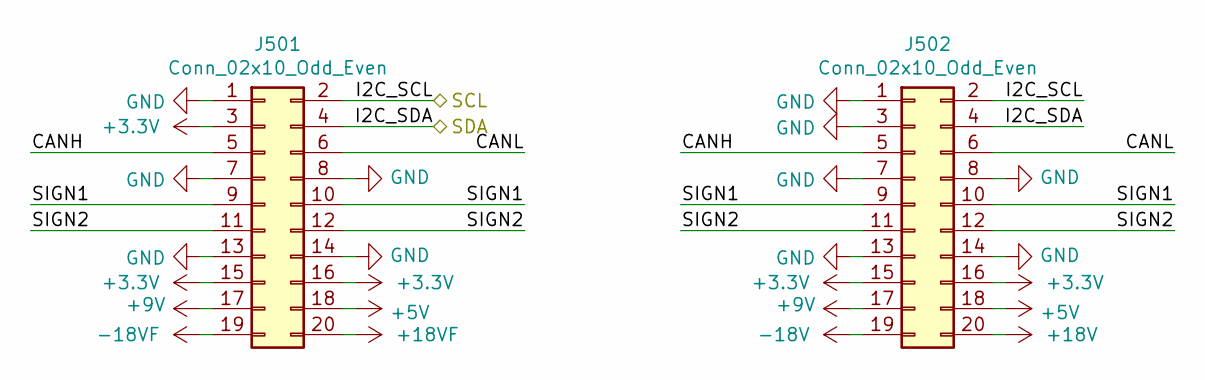
[picture p25: schematic Channel2.sch]

Parts:
J501, J502: Conn_02x10_Odd_Even; PinHeader_2x10_P2.54mm_Vertical

Connections:
+3V3: J501.3, J501.15, J501.16, J502.15, J502.16; also elsewhere on the board
+5V: J501.18, J502.18; also elsewhere on the board
+9V: J501.17, J502.17; also elsewhere on the board
+18V: J502.20; also elsewhere on the board
+18VF: J501.20; also elsewhere on the board
-18V: J502.19; also elsewhere on the board
-18VF: J501.19; also elsewhere on the board
/Channel 1/SCL: J501.2, J502.2; also elsewhere on the board
/Channel 1/SDA: J501.4, J502.4; also elsewhere on the board
/Channel 2/CANH: J501.5, J502.5
/Channel 2/CANL: J501.6, J502.6
/Channel 2/SIGN1: J501.9, J501.10, J502.9, J502.10
/Channel 2/SIGN2: J501.11, J501.12, J502.11, J502.12
GND: J501.1, J501.7, J501.8, J501.13, J501.14, J502.1, J502.3, J502.7, J502.8, J502.13, J502.14; also elsewhere on the board

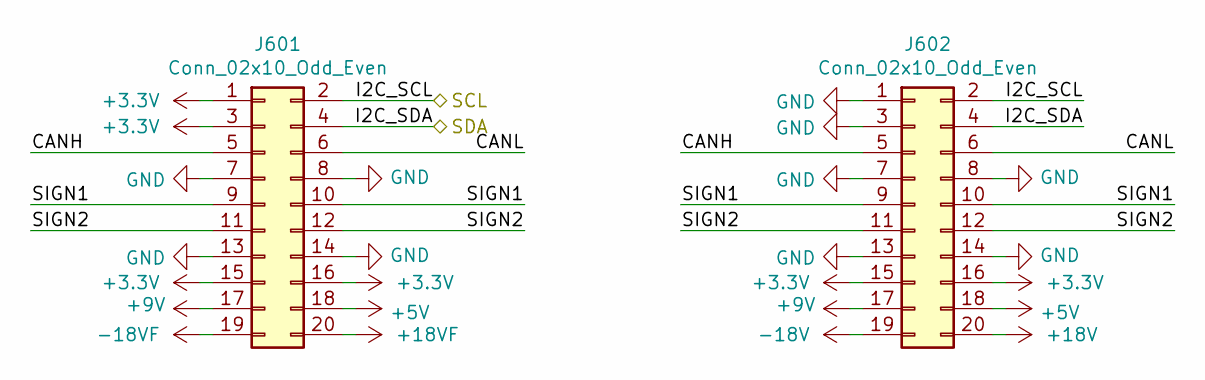
[picture p26: schematic Channel3.sch]

Parts:
J601, J602: Conn_02x10_Odd_Even; PinHeader_2x10_P2.54mm_Vertical

Connections:
+3V3: J601.1, J601.3, J601.15, J601.16, J602.15, J602.16; also elsewhere on the board
+5V: J601.18, J602.18; also elsewhere on the board
+9V: J601.17, J602.17; also elsewhere on the board
+18V: J602.20; also elsewhere on the board
+18VF: J601.20; also elsewhere on the board
-18V: J602.19; also elsewhere on the board
-18VF: J601.19; also elsewhere on the board
/Channel 1/SCL: J601.2, J602.2; also elsewhere on the board
/Channel 1/SDA: J601.4, J602.4; also elsewhere on the board
/Channel 3/CANH: J601.5, J602.5
/Channel 3/CANL: J601.6, J602.6
/Channel 3/SIGN1: J601.9, J601.10, J602.9, J602.10
/Channel 3/SIGN2: J601.11, J601.12, J602.11, J602.12
GND: J601.7, J601.8, J601.13, J601.14, J602.1, J602.3, J602.7, J602.8, J602.13, J602.14; also elsewhere on the board

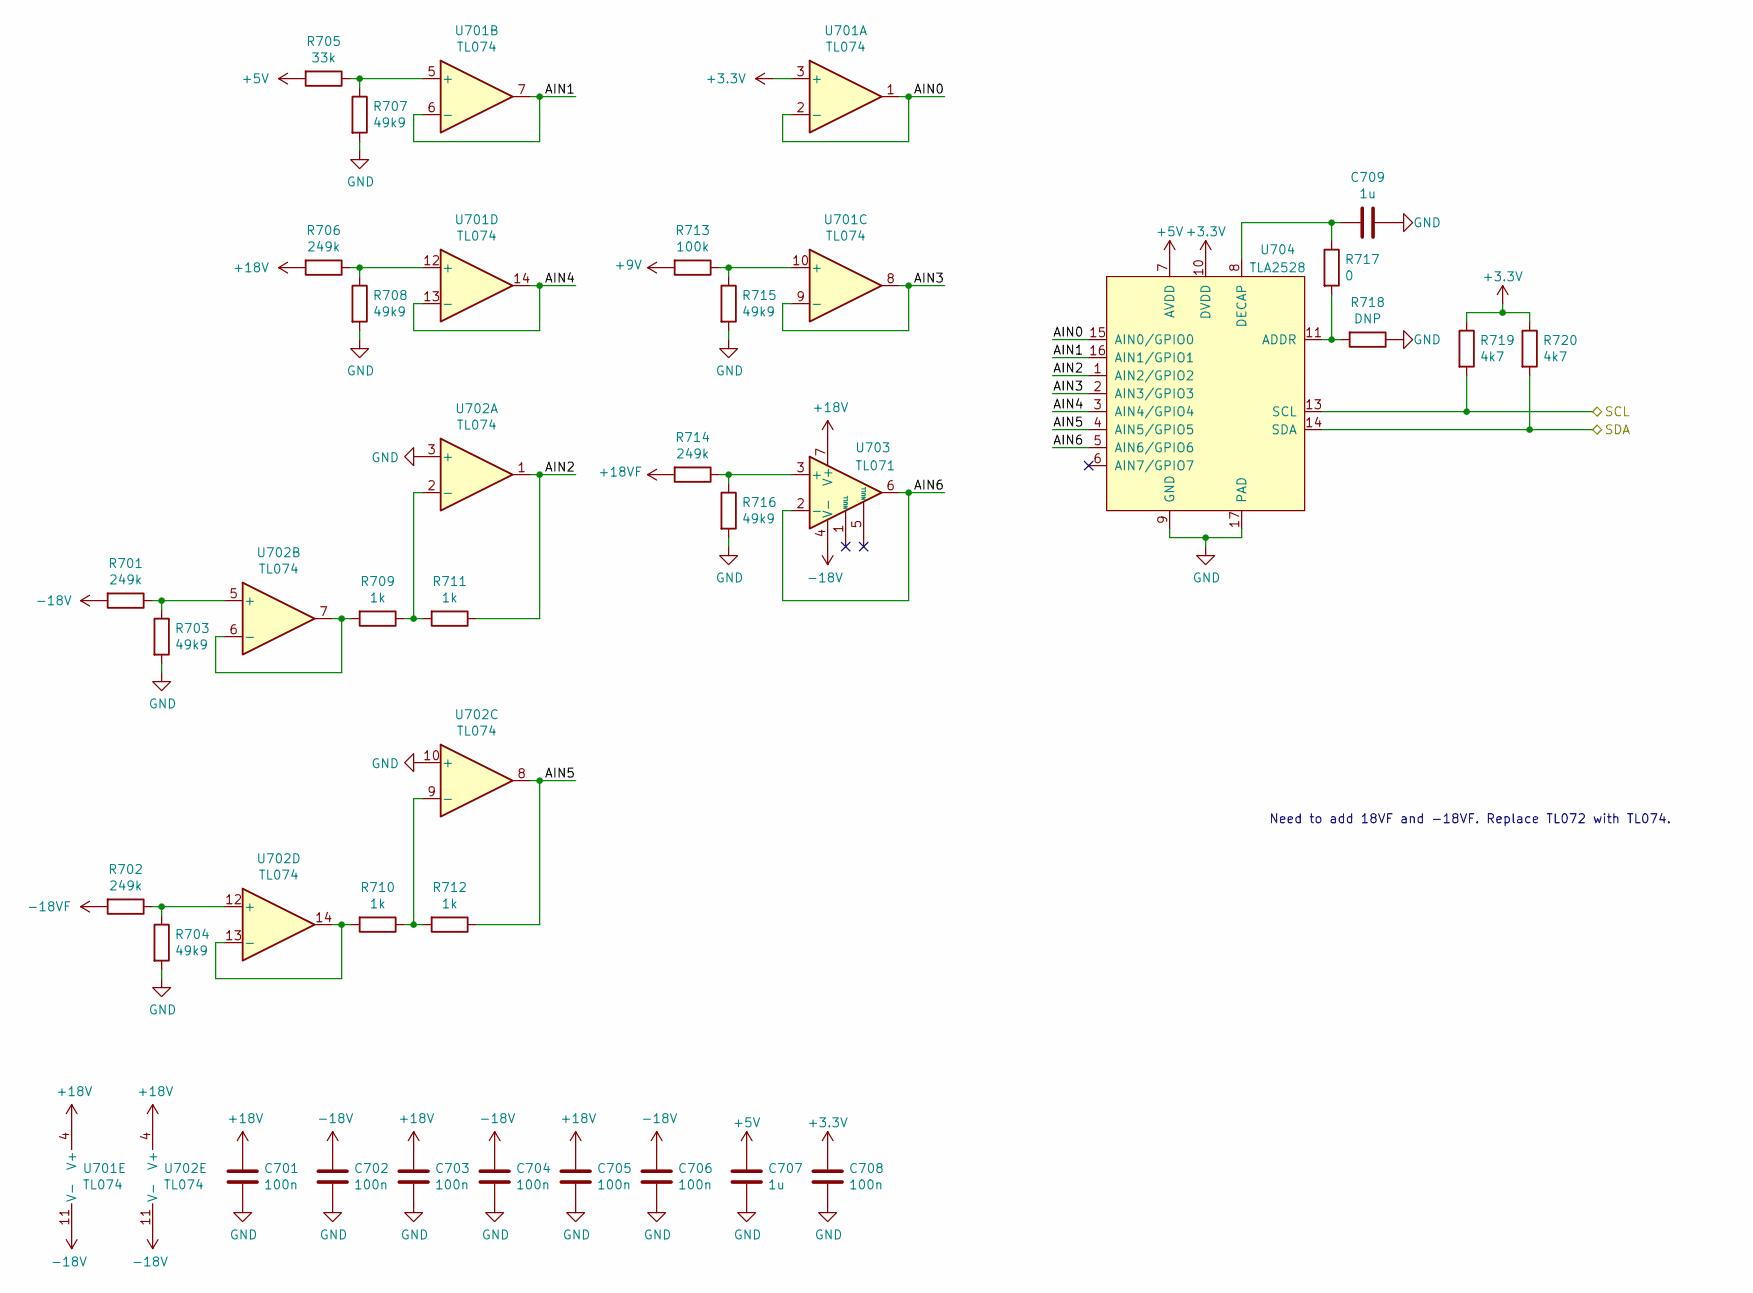
[picture p27: schematic Selftest.sch]

Parts:
C701, C702, C703, C704, C705, C706, C708: 100n; C_0603_1608Metric_Pad1.08x0.95mm_HandSolder
C707, C709: 1u; C_0603_1608Metric_Pad1.08x0.95mm_HandSolder
R701, R702, R706, R714: 249k; R_0603_1608Metric_Pad0.98x0.95mm_HandSolder
R703, R704, R707, R708, R715, R716: 49k9; R_0603_1608Metric_Pad0.98x0.95mm_HandSolder
R705: 33k; R_0603_1608Metric_Pad0.98x0.95mm_HandSolder
R709, R710, R711, R712: 1k; R_0603_1608Metric_Pad0.98x0.95mm_HandSolder
R713: 100k; R_0603_1608Metric_Pad0.98x0.95mm_HandSolder
R717: 0; R_0603_1608Metric_Pad0.98x0.95mm_HandSolder
R718: DNP; R_0603_1608Metric_Pad0.98x0.95mm_HandSolder
R719, R720: 4k7; R_0603_1608Metric_Pad0.98x0.95mm_HandSolder
U701, U702: TL074; TSSOP-14_4.4x5mm_P0.65mm
U703: TL071; SOIC-8_3.9x4.9mm_P1.27mm
U704: TLA2528; WQFN-16-1EP_3x3mm_P0.5mm_EP1.6x1.6mm_ThermalVias

Connections:
+3V3: C708.2, R719.1, R720.1, U701.3 (+), U704.10 (DVDD); also elsewhere on the board
+5V: C707.2, R705.2, U704.7 (AVDD); also elsewhere on the board
+9V: R713.2; also elsewhere on the board
+18V: C701.2, C703.2, C705.2, R706.2, U701.4 (V+), U702.4 (V+), U703.7 (V+); also elsewhere on the board
+18VF: R714.2; also elsewhere on the board
-18V: C702.2, C704.2, C706.2, R701.2, U701.11 (V-), U702.11 (V-), U703.4 (V-); also elsewhere on the board
-18VF: R702.2; also elsewhere on the board
/Channel 1/SCL: R719.2, U704.13 (SCL); also elsewhere on the board
/Channel 1/SDA: R720.2, U704.14 (SDA); also elsewhere on the board
/Selftest/AIN0: U701.1, U701.2 (-), U704.15 (AIN0/GPIO0)
/Selftest/AIN1: U701.6 (-), U701.7, U704.16 (AIN1/GPIO1)
/Selftest/AIN2: R711.1, U702.1, U704.1 (AIN2/GPIO2)
/Selftest/AIN3: U701.8, U701.9 (-), U704.2 (AIN3/GPIO3)
/Selftest/AIN4: U701.13 (-), U701.14, U704.3 (AIN4/GPIO4)
/Selftest/AIN5: R712.1, U702.8, U704.4 (AIN5/GPIO5)
/Selftest/AIN6: U703.2 (-), U703.6, U704.5 (AIN6/GPIO6)
GND: C701.1, C702.1, C703.1, C704.1, C705.1, C706.1, C707.1, C708.1, C709.1, R703.2, R704.2, R707.2, R708.2, R715.2, R716.2, R718.1, U702.3 (+), U702.10 (+), U704.9 (GND), U704.17 (PAD); also elsewhere on the board
unnamed: C709.2, R717.1, U704.8 (DECAP)
unnamed: R701.1, R703.1, U702.5 (+)
unnamed: R702.1, R704.1, U702.12 (+)
unnamed: R705.1, R707.1, U701.5 (+)
unnamed: R706.1, R708.1, U701.12 (+)
unnamed: R709.1, R711.2, U702.2 (-)
unnamed: R709.2, U702.6 (-), U702.7
unnamed: R710.1, R712.2, U702.9 (-)
unnamed: R710.2, U702.13 (-), U702.14
unnamed: R713.1, R715.1, U701.10 (+)
unnamed: R714.1, R716.1, U703.3 (+)
unnamed: R717.2, R718.2, U704.11 (ADDR)

Notes on the sheet:
Need to add 18VF and -18VF. Replace TL072 with TL074.

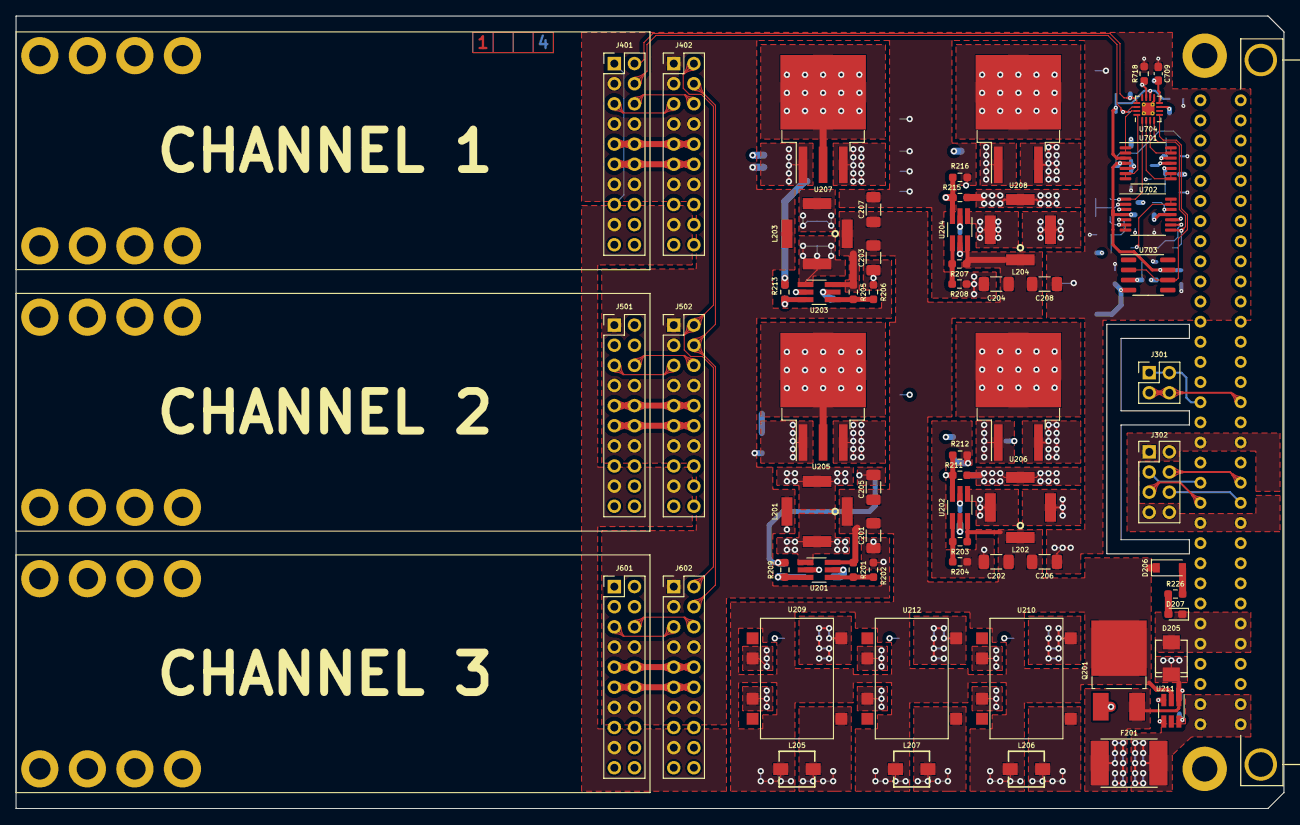
[picture p28: board ETH3CDAQ1_BASE.kicad_pcb from above]

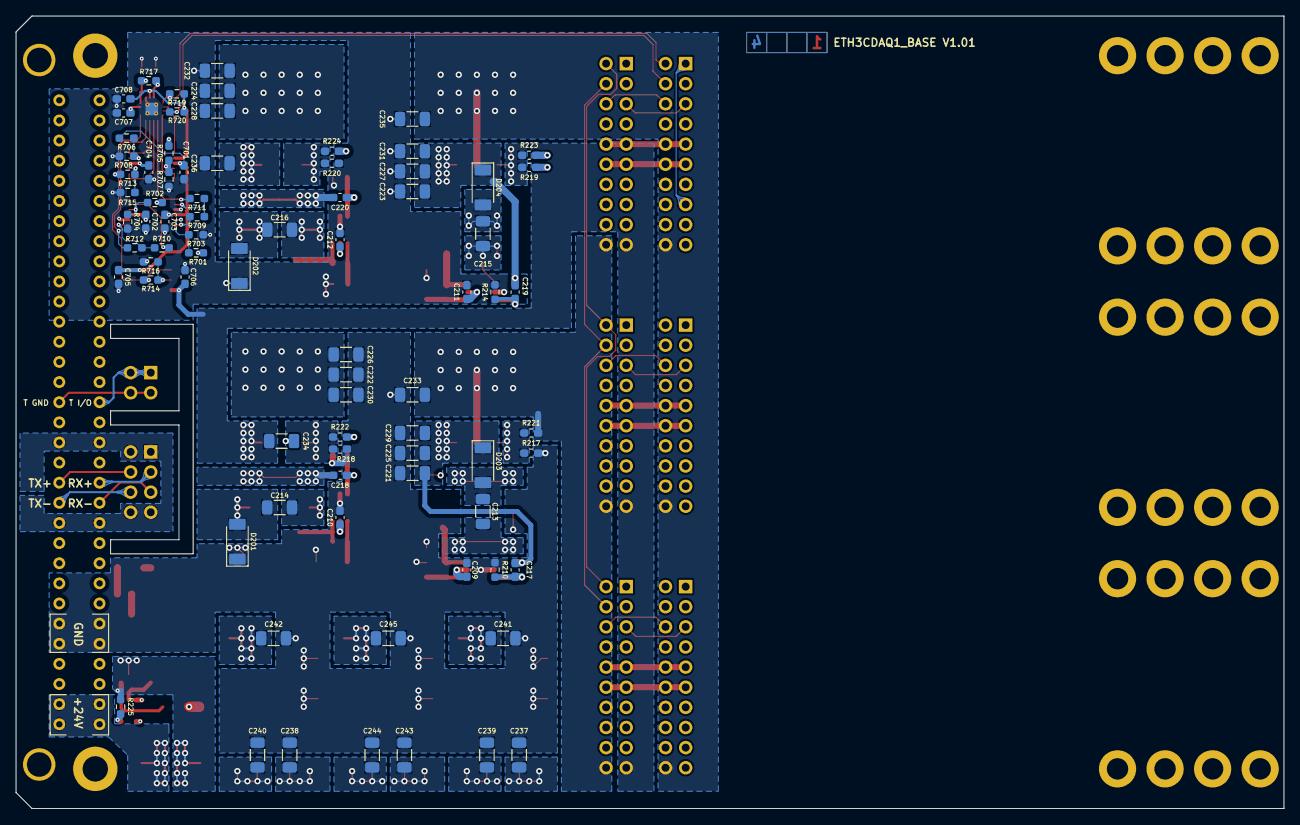
[picture p29: board ETH3CDAQ1_BASE.kicad_pcb from below]

Board: 4 copper layers, 160.0 x 100.0 mm, 167 parts (79 on the bottom side), 86 nets.
