BehrensG/ETH3CDAQ1/hardware/project/ETH3CDAQ1_VOLTAGE_ISO_T1/ETH3CDAQ1_VOLTAGE_ISO_T1.kicad_pcb

## KiCad design hardware/project/ETH3CDAQ1_VOLTAGE_ISO_T1/ETH3CDAQ1_VOLTAGE_ISO_T1.kicad_pcb (2021-01-05)

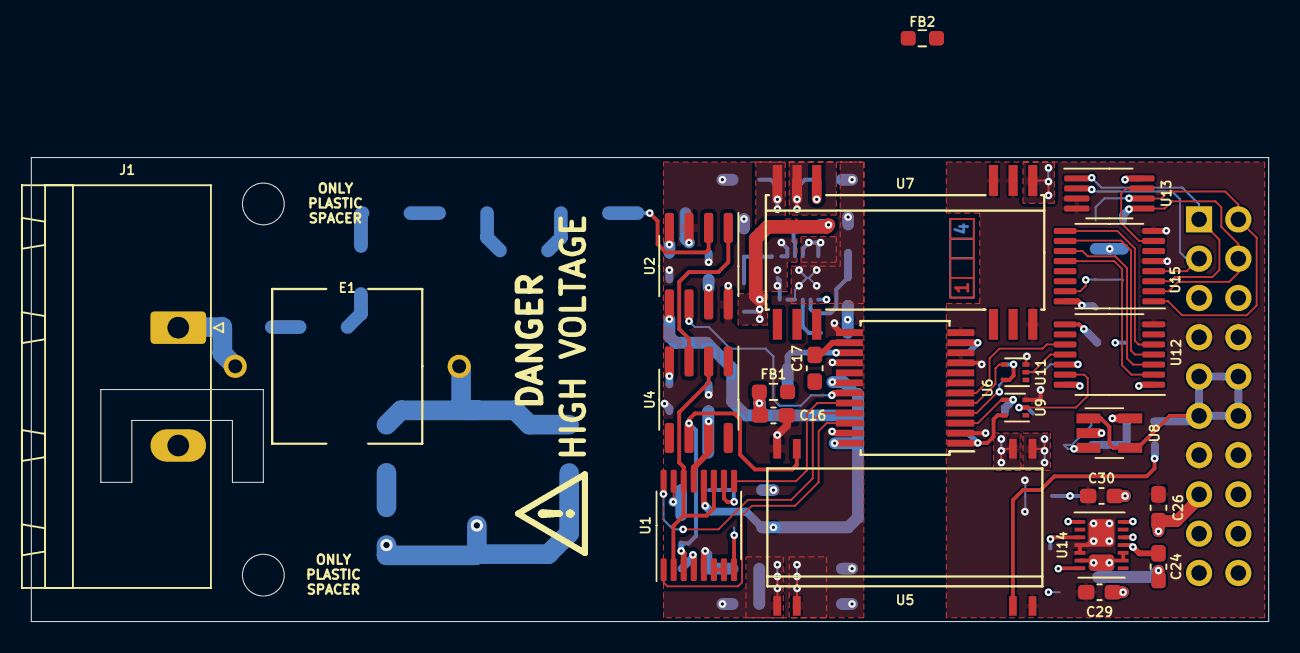
[picture p30: board ETH3CDAQ1_VOLTAGE_ISO_T1.kicad_pcb from above]

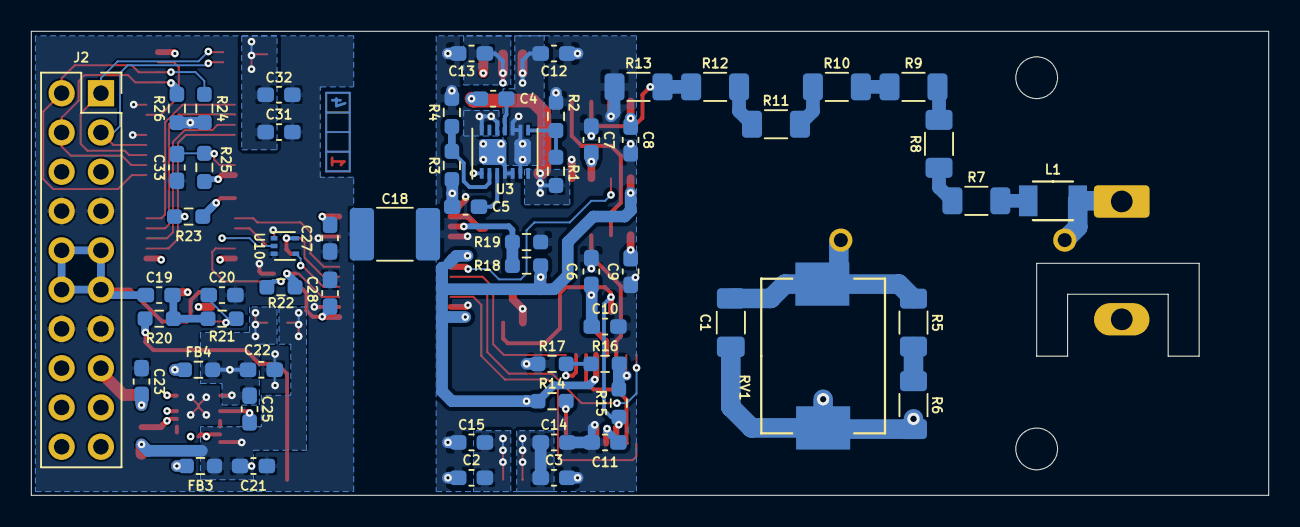
[picture p31: board ETH3CDAQ1_VOLTAGE_ISO_T1.kicad_pcb from below]

Board: 4 copper layers, 80.0 x 30.0 mm, 86 parts (60 on the bottom side), 65 nets.

Parts:
C1: 10n; C_1206_3216Metric_Pad1.33x1.80mm_HandSolder
C2, C3, C14, C15, C16, C21, C22, C23, C27, C31: 10u; C_0603_1608Metric_Pad1.08x0.95mm_HandSolder
C4, C5, C24, C25: 10n; C_0603_1608Metric_Pad1.08x0.95mm_HandSolder
C6, C7, C8, C9, C10, C11, C17, C26, C28, C32, C33: 100n; C_0603_1608Metric_Pad1.08x0.95mm_HandSolder
C12, C13, C29, C30: 2u2; C_0603_1608Metric_Pad1.08x0.95mm_HandSolder
C18: C; C_1812_4532Metric_Pad1.57x3.40mm_HandSolder
C19: 1n; C_0603_1608Metric_Pad1.08x0.95mm_HandSolder
C20: 220p; C_0603_1608Metric_Pad1.08x0.95mm_HandSolder
E1: CG3-1.5L; GDT
FB1, FB2: FB; R_0603_1608Metric_Pad0.98x0.95mm_HandSolder
FB3, FB4: Ferrite_Bead_Small; R_0603_1608Metric_Pad0.98x0.95mm_HandSolder
H1, H2: MountingHole; MountingHole_2.7mm_M2.5_DIN965
J1: GMSTB2,5/2-GF-7,62; PhoenixContact_GMSTB_2,5_2-GF-7,62_1x02_P7.62mm_Horizontal_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
J2: Conn_02x10_Odd_Even; PinSocket_2x10_P2.54mm_Vertical
L1: NLFV32T-100K-EF; NLV32
R1, R3: 536k; R_0603_1608Metric_Pad0.98x0.95mm_HandSolder
R2, R4: 49k3; R_0603_1608Metric_Pad0.98x0.95mm_HandSolder
R5, R6: 1M; R_1206_3216Metric_Pad1.30x1.75mm_HandSolder
R7: 6k19; R_1206_3216Metric_Pad1.30x1.75mm_HandSolder
R8, R9, R10, R11: 2M2; R_1206_3216Metric_Pad1.30x1.75mm_HandSolder
R12: 1M1; R_1206_3216Metric_Pad1.30x1.75mm_HandSolder
R13: 100k; R_1206_3216Metric_Pad1.30x1.75mm_HandSolder
R14, R19, R23, R25: 10k; R_0603_1608Metric_Pad0.98x0.95mm_HandSolder
R15: 180k/0.05%; R_0603_1608Metric_Pad0.98x0.95mm_HandSolder
R16: 18k/0.05%; R_0603_1608Metric_Pad0.98x0.95mm_HandSolder
R17: 2k/0.05%; R_0603_1608Metric_Pad0.98x0.95mm_HandSolder
R18: 30k9; R_0603_1608Metric_Pad0.98x0.95mm_HandSolder
R20: 4k75; R_0603_1608Metric_Pad0.98x0.95mm_HandSolder
R21: 9k76; R_0603_1608Metric_Pad0.98x0.95mm_HandSolder
R22: 0; R_0603_1608Metric_Pad0.98x0.95mm_HandSolder
R24, R26: 4k7; R_0603_1608Metric_Pad0.98x0.95mm_HandSolder
RV1: B72660M0301; 4032
SYM1: SYM_Flash_Large; Symbol_HighVoltage_Type2_CopperTop_VerySmall
U1: DG211; TSSOP-16_4.4x5mm_P0.65mm
U2: DG419xY; SOIC-8_3.9x4.9mm_P1.27mm
U3: LT3032; Linear_DE14MA
U4: OPA140; SOIC-8_3.9x4.9mm_P1.27mm
U5: ISO124; DVA
U6: ADuM5410; SSOP-24_5.3x8.2mm_P0.65mm
U7: DCP020515DU; DVB
U8: OPA237_SOT23; SOT-23-5_HandSoldering
U9, U10, U11: 74LVC1GU04DRL; SOT-553
U12: TXB0104PW; TSSOP-14_4.4x5mm_P0.65mm
U13: 24LC08B-E/MS; MSOP-8_3x3mm_P0.65mm
U14: LT3032-15; Linear_DE14MA
U15: PCA9557PW; TSSOP-16_4.4x5mm_P0.65mm

Connections:
+3V3: C23.1, C26.1, J2.15, J2.16, R23.1, R24.1, R25.1, R26.1, U12.1, U13.8, U15.16
+5V: C27.1, C28.1, C31.1, C32.1, J2.18, U6.1, U6.11, U7.1, U9.5, U10.5, U11.5, U12.14
+5VF: C16.1, FB1.2, R14.2, R18.1, U1.12, U2.5, U6.18, U6.24
+15V: C22.1, C25.1, FB4.2, U5.9, U8.5, U14.1
+15VF: C3.1, C5.1, C6.1, C8.1, C10.1, C14.1, R3.1, U1.13, U2.4, U3.1, U4.7, U5.1
+18V: C30.1, FB4.1, J2.20, U14.12, U14.14
-15V: C21.1, C24.1, FB3.2, U5.10, U8.2, U14.7
-15VF: C2.1, C4.1, C7.1, C9.1, C11.1, C15.1, R1.1, U1.4, U2.7, U3.7, U4.4, U5.2
-18V: C29.1, FB3.1, J2.19, U14.6, U14.9, U14.10
/A0: J2.1, U13.1, U15.3
/A1: J2.3, U13.2, U15.4
/AOUT: C19.1, J2.9, J2.10, J2.11, J2.12, U8.1, U8.4
/AZ: U2.6, U6.19
/G1: U1.1, U6.22
/G10: U1.16, U6.21
/G100: U1.9, U6.20
/IO2: U12.5, U15.9
/IO3: U12.4, U15.10
/IO4: U12.3, U15.11
/IO5: U12.2, U15.12
/IO_AZ: U6.6, U12.10
/IO_G1: R22.2, U6.3, U9.4
/IO_G10: U6.4, U10.4
/IO_G100: U6.5, U11.4
/NADJ: R1.2, R2.1, U3.8
/PADJ: R3.2, R4.1, U3.2
/SCL: J2.2, R24.2, U13.6, U15.1
/SDA: J2.4, R26.2, U13.5, U15.2
/WP: U13.7, U15.7
AGNDF: C1.2, C2.2, C3.2, C6.2, C7.2, C8.2, C9.2, C10.2, C11.2, C12.2, C13.2, C14.2, C15.2, C16.2, C18.2, FB2.2, J1.2, R2.2, R4.2, R6.2, R13.1, R17.2, R19.2, RV1.2, U1.5, U2.3, U2.8, U3.4, U3.5, U5.16, U6.13, U6.16, U6.23, U7.12
GND: C18.1, C20.2, C21.2, C22.2, C23.2, C26.2, C27.2, C28.2, C29.2, C30.2, C31.2, C32.2, C33.2, J2.7, J2.8, J2.13, J2.14, U5.8, U6.2, U6.9, U6.10, U6.12, U7.2, U7.3, U7.28, U9.3, U10.3, U11.3, U12.7, U13.3, U13.4, U14.4, U14.5, U15.5, U15.8
unnamed: C1.1, E1.2, R5.1, RV1.1
unnamed: C4.2, U3.11
unnamed: C5.2, U3.3
unnamed: C17.1, FB1.1, U6.14
unnamed: C17.2, FB2.1
unnamed: C19.2, R20.1, R21.2
unnamed: C20.1, R21.1, U8.3
unnamed: C24.2, U14.11
unnamed: C25.2, U14.3
unnamed: C33.1, R25.2, U15.15
unnamed: E1.1, J1.1, L1.1
unnamed: L1.2, R7.2
unnamed: R5.2, R6.1
unnamed: R7.1, R8.2
unnamed: R8.1, R9.2
unnamed: R10.1, R11.2
unnamed: R9.1, R10.2
unnamed: R11.1, R12.2
unnamed: R12.1, R13.2, U2.2
unnamed: R14.1, U1.8
unnamed: R15.1, U1.3, U4.6, U5.15
unnamed: R15.2, R16.1, U1.15
unnamed: R16.2, R17.1, U1.10
unnamed: R18.2, R19.1, U6.15
unnamed: R20.2, U5.7
unnamed: R22.1, U9.2, U12.13
unnamed: R23.2, U12.8
unnamed: U1.6, U1.7
unnamed: U1.2, U1.11, U1.14, U4.2
unnamed: U2.1, U4.3
unnamed: U10.2, U12.12
unnamed: U11.2, U12.11
VCC: C13.1, U3.12, U3.14, U7.13
VDD: C12.1, U3.6, U3.9, U3.10, U7.14
