BehrensG/ETH3CDAQ1/hardware/project/ETH3CDAQ1_CURRENT_ISO_T1/ETH3CDAQ1_CURRENT_ISO_T1.kicad_pcb

## KiCad design hardware/project/ETH3CDAQ1_CURRENT_ISO_T1/ETH3CDAQ1_CURRENT_ISO_T1.kicad_pcb (2021-01-02)

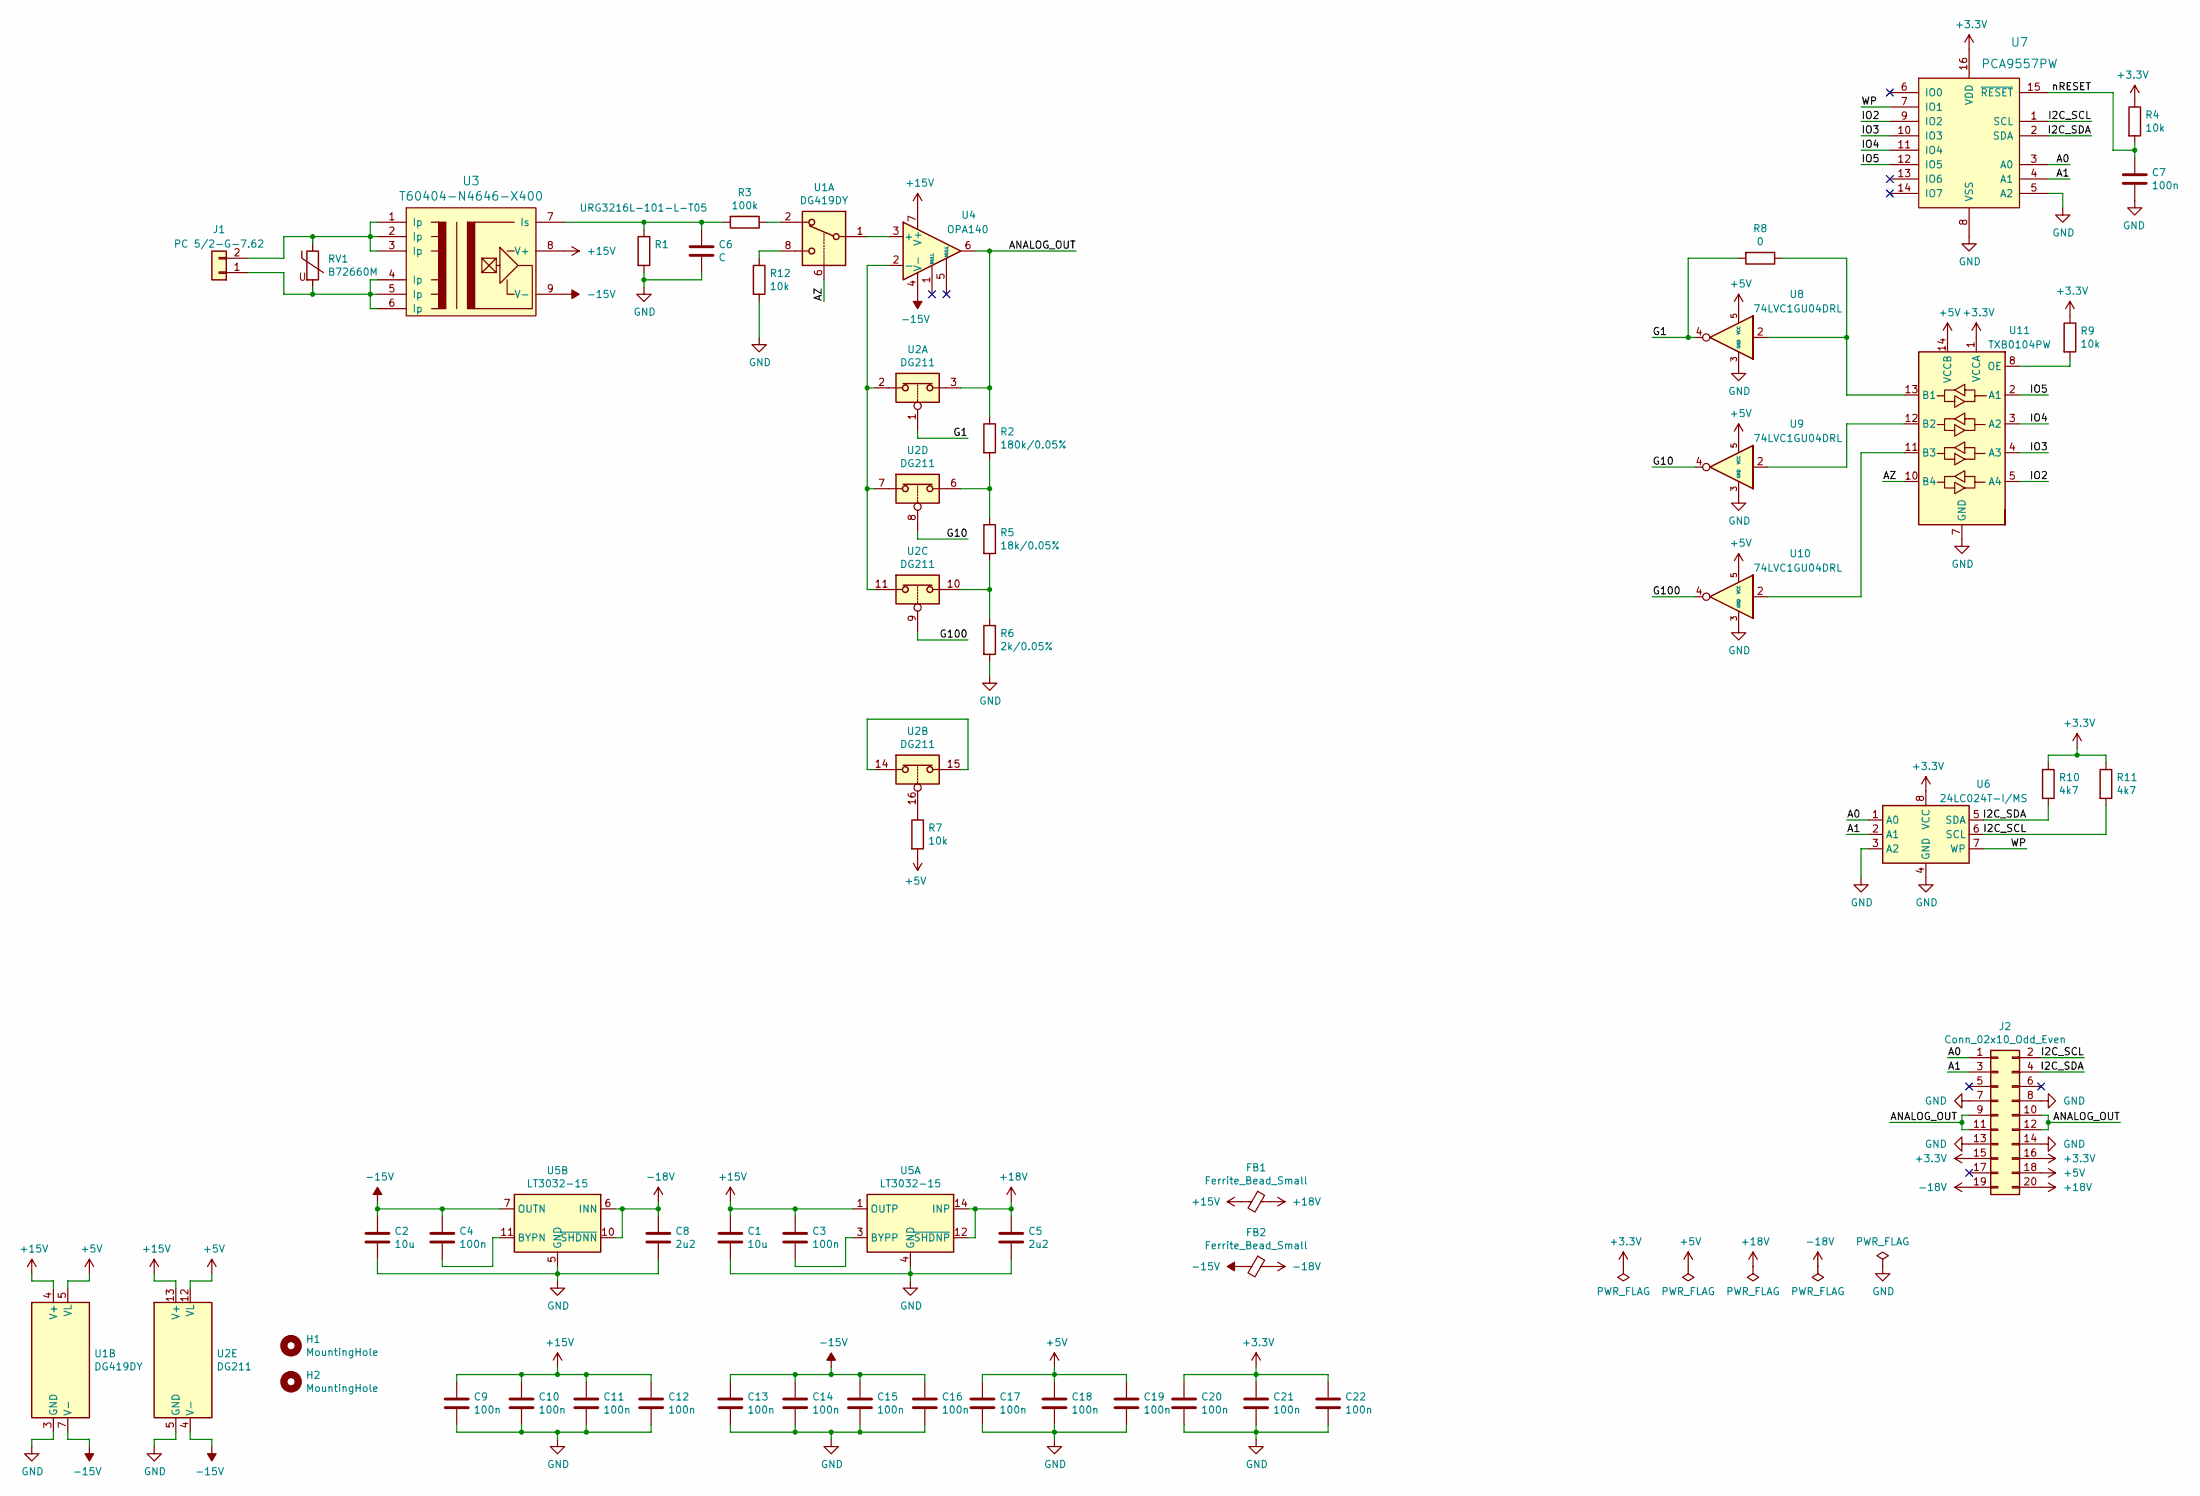
[picture p32: schematic ETH3CDAQ1_CURRENT_ISO_T1.sch]

Parts:
C1, C2: 10u; C_0603_1608Metric_Pad1.08x0.95mm_HandSolder
C3, C4, C7, C9, C10, C11, C12, C13, C14, C15, C16, C17, C18, C19, C20, C21, C22: 100n; C_0603_1608Metric_Pad1.08x0.95mm_HandSolder
C5, C8: 2u2; C_0603_1608Metric_Pad1.08x0.95mm_HandSolder
C6: C; C_1206_3216Metric_Pad1.33x1.80mm_HandSolder
FB1, FB2: Ferrite_Bead_Small; R_0603_1608Metric_Pad0.98x0.95mm_HandSolder
H1, H2: MountingHole; MountingHole_2.7mm_M2.5_DIN965_Pad
J1: PC 5/2-G-7.62; PC5_2-G-7_62
J2: Conn_02x10_Odd_Even; PinSocket_2x10_P2.54mm_Vertical
R1: URG3216L-101-L-T05; R_1206_3216Metric_Pad1.30x1.75mm_HandSolder
R2: 180k/0.05%; R_0603_1608Metric_Pad0.98x0.95mm_HandSolder
R3: 100k; R_0603_1608Metric_Pad0.98x0.95mm_HandSolder
R4, R7, R9, R12: 10k; R_0603_1608Metric_Pad0.98x0.95mm_HandSolder
R5: 18k/0.05%; R_0603_1608Metric_Pad0.98x0.95mm_HandSolder
R6: 2k/0.05%; R_0603_1608Metric_Pad0.98x0.95mm_HandSolder
R8: 0; R_0603_1608Metric_Pad0.98x0.95mm_HandSolder
R10, R11: 4k7; R_0603_1608Metric_Pad0.98x0.95mm_HandSolder
RV1: B72660M; 4032
U1: DG419DY; SOIC-8_3.9x4.9mm_P1.27mm
U2: DG211; TSSOP-16_4.4x5mm_P0.65mm
U3: T60404-N4646-X400
U4: OPA140; SOIC-8_3.9x4.9mm_P1.27mm
U5: LT3032-15; Linear_DE14MA
U6: 24LC024T-I/MS; MSOP-8_3x3mm_P0.65mm
U7: PCA9557PW; TSSOP-16_4.4x5mm_P0.65mm
U8, U9, U10: 74LVC1GU04DRL; SOT-553
U11: TXB0104PW; TSSOP-14_4.4x5mm_P0.65mm

Connections:
+3V3: C20.1, C21.1, C22.1, J2.15, J2.16, R4.1, R9.1, R10.1, R11.1, U6.8 (VCC), U7.16 (VDD), U11.1 (VCCA)
+5V: C17.1, C18.1, C19.1, J2.18, R7.2, U1.5 (VL), U2.12 (VL), U8.5 (VCC), U9.5 (VCC), U10.5 (VCC), U11.14 (VCCB)
+15V: C1.1, C3.1, C9.1, C10.1, C11.1, C12.1, FB1.2, U1.4 (V+), U2.13 (V+), U3.8 (V+), U4.7 (V+), U5.1 (OUTP)
+18V: C5.1, FB1.1, J2.20, U5.12 (~SHDNP), U5.14 (INP)
-15V: C2.1, C4.1, C13.1, C14.1, C15.1, C16.1, FB2.2, U1.7 (V-), U2.4 (V-), U3.9 (V-), U4.4 (V-), U5.7 (OUTN)
-18V: C8.1, FB2.1, J2.19, U5.6 (INN), U5.9 (INN), U5.10 (~SHDNN)
/A0: J2.1, U6.1 (A0), U7.3 (A0)
/A1: J2.3, U6.2 (A1), U7.4 (A1)
/ANALOG_OUT: J2.9, J2.10, J2.11, J2.12, R2.1, U2.3, U4.6
/AZ: U1.6, U11.10 (B4)
/G1: R8.2, U2.1, U8.4
/G10: U2.8, U9.4
/G100: U2.9, U10.4
/I2C_SCL: J2.2, R11.2, U6.6 (SCL), U7.1 (SCL)
/I2C_SDA: J2.4, R10.2, U6.5 (SDA), U7.2 (SDA)
/IO2: U7.9 (IO2), U11.5 (A4)
/IO3: U7.10 (IO3), U11.4 (A3)
/IO4: U7.11 (IO4), U11.3 (A2)
/IO5: U7.12 (IO5), U11.2 (A1)
/WP: U6.7 (WP), U7.7 (IO1)
/nRESET: C7.1, R4.2, U7.15 (~RESET)
GND: C1.2, C2.2, C5.2, C6.2, C7.2, C8.2, C9.2, C10.2, C11.2, C12.2, C13.2, C14.2, C15.2, C16.2, C17.2, C18.2, C19.2, C20.2, C21.2, C22.2, J2.7, J2.8, J2.13, J2.14, R1.2, R6.2, R12.2, U1.3 (GND), U2.5 (GND), U5.4 (GND), U5.5 (GND), U6.3 (A2), U6.4 (GND), U7.5 (A2), U7.8 (VSS), U8.3 (GND), U9.3 (GND), U10.3 (GND), U11.7 (GND)
unnamed: C3.2, U5.3 (BYPP)
unnamed: C4.2, U5.11 (BYPN)
unnamed: C6.1, R1.1, R3.2, U3.7 (Is)
unnamed: J1.1, RV1.2, U3.4 (Ip), U3.5 (Ip), U3.6 (Ip)
unnamed: J1.2, RV1.1, U3.1 (Ip), U3.2 (Ip), U3.3 (Ip)
unnamed: R2.2, R5.1, U2.6
unnamed: R3.1, U1.2
unnamed: R5.2, R6.1, U2.10
unnamed: R7.1, U2.16
unnamed: R8.1, U8.2, U11.13 (B1)
unnamed: R9.2, U11.8 (OE)
unnamed: R12.1, U1.8
unnamed: U1.1, U4.3 (+)
unnamed: U2.2, U2.7, U2.11, U4.2 (-)
unnamed: U2.14, U2.15
unnamed: U10.2, U11.11 (B3)
unnamed: U9.2, U11.12 (B2)

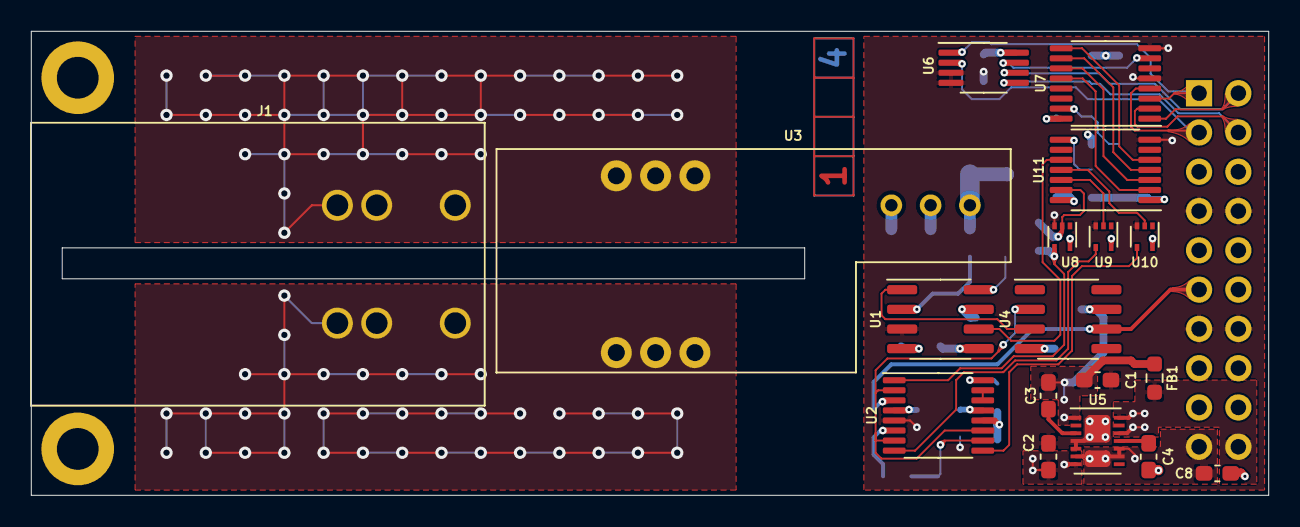
[picture p33: board ETH3CDAQ1_CURRENT_ISO_T1.kicad_pcb from above]

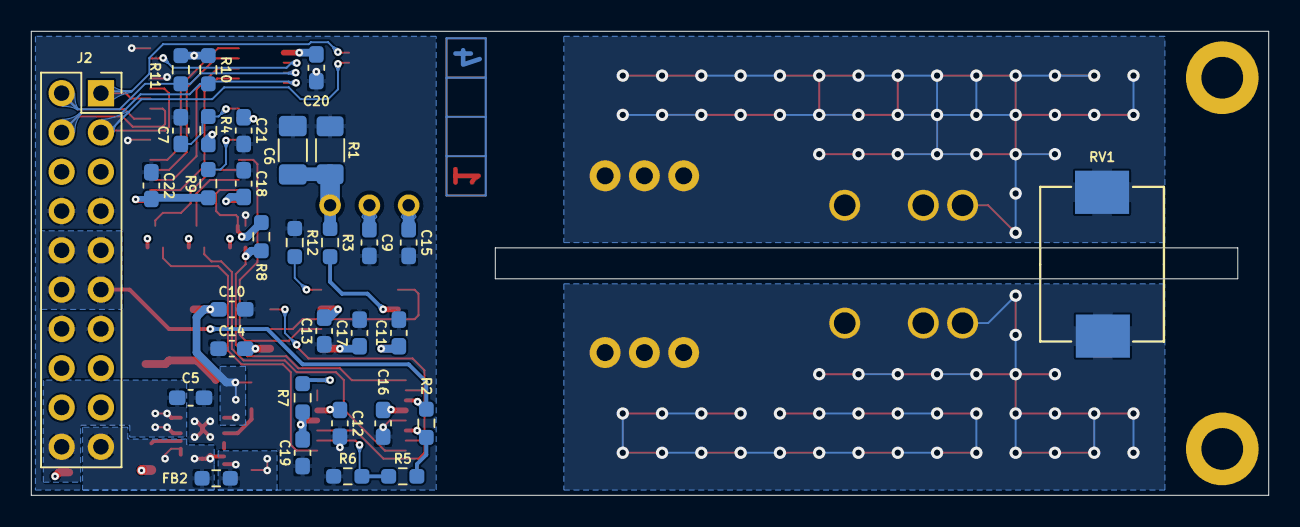
[picture p34: board ETH3CDAQ1_CURRENT_ISO_T1.kicad_pcb from below]

Board: 4 copper layers, 80.0 x 30.0 mm, 52 parts (32 on the bottom side), 39 nets.
