BehrensG/ETH3CDAQ1/hardware/project/ETH3CDAQ1_MEASURE/ETH3CDAQ1_MEASURE.kicad_pcb

## KiCad design hardware/project/ETH3CDAQ1_MEASURE/ETH3CDAQ1_MEASURE.kicad_pcb (2020-12-06)

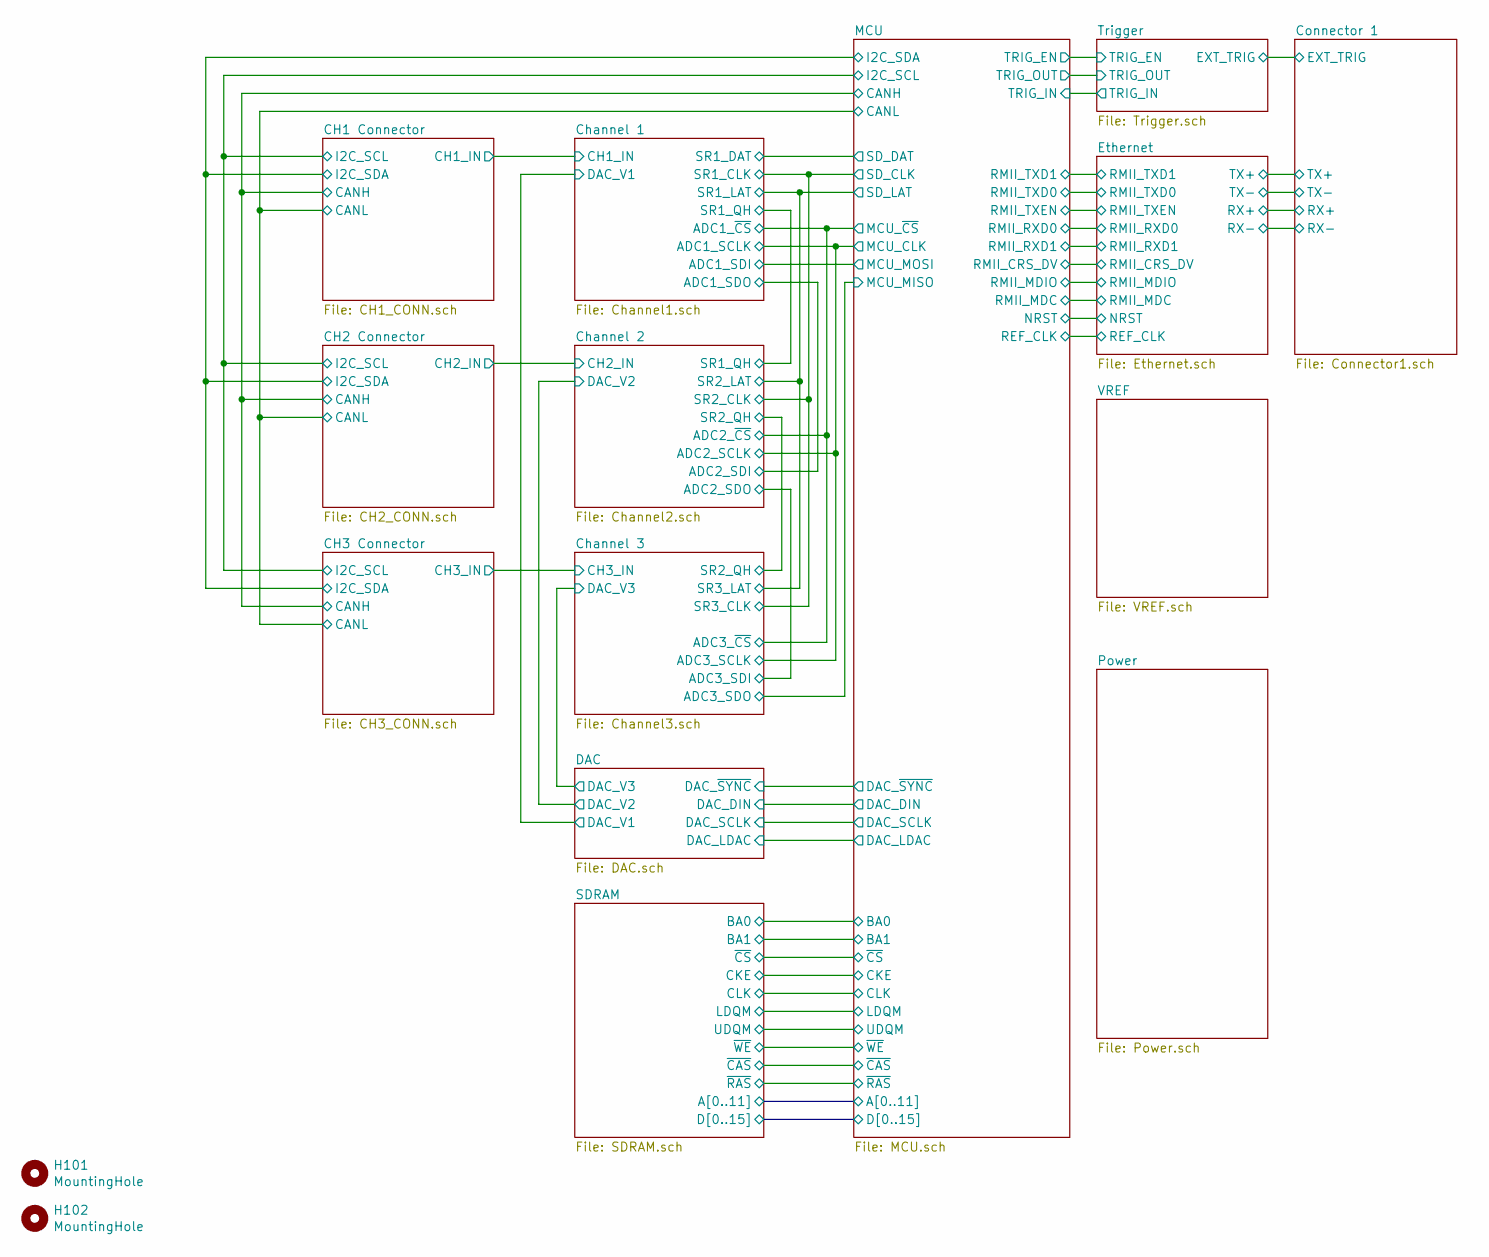
[picture p35: schematic ETH3CDAQ1_MEASURE.sch]

Parts:
H101, H102: MountingHole; MountingHole_3.2mm_M3_DIN965_Pad

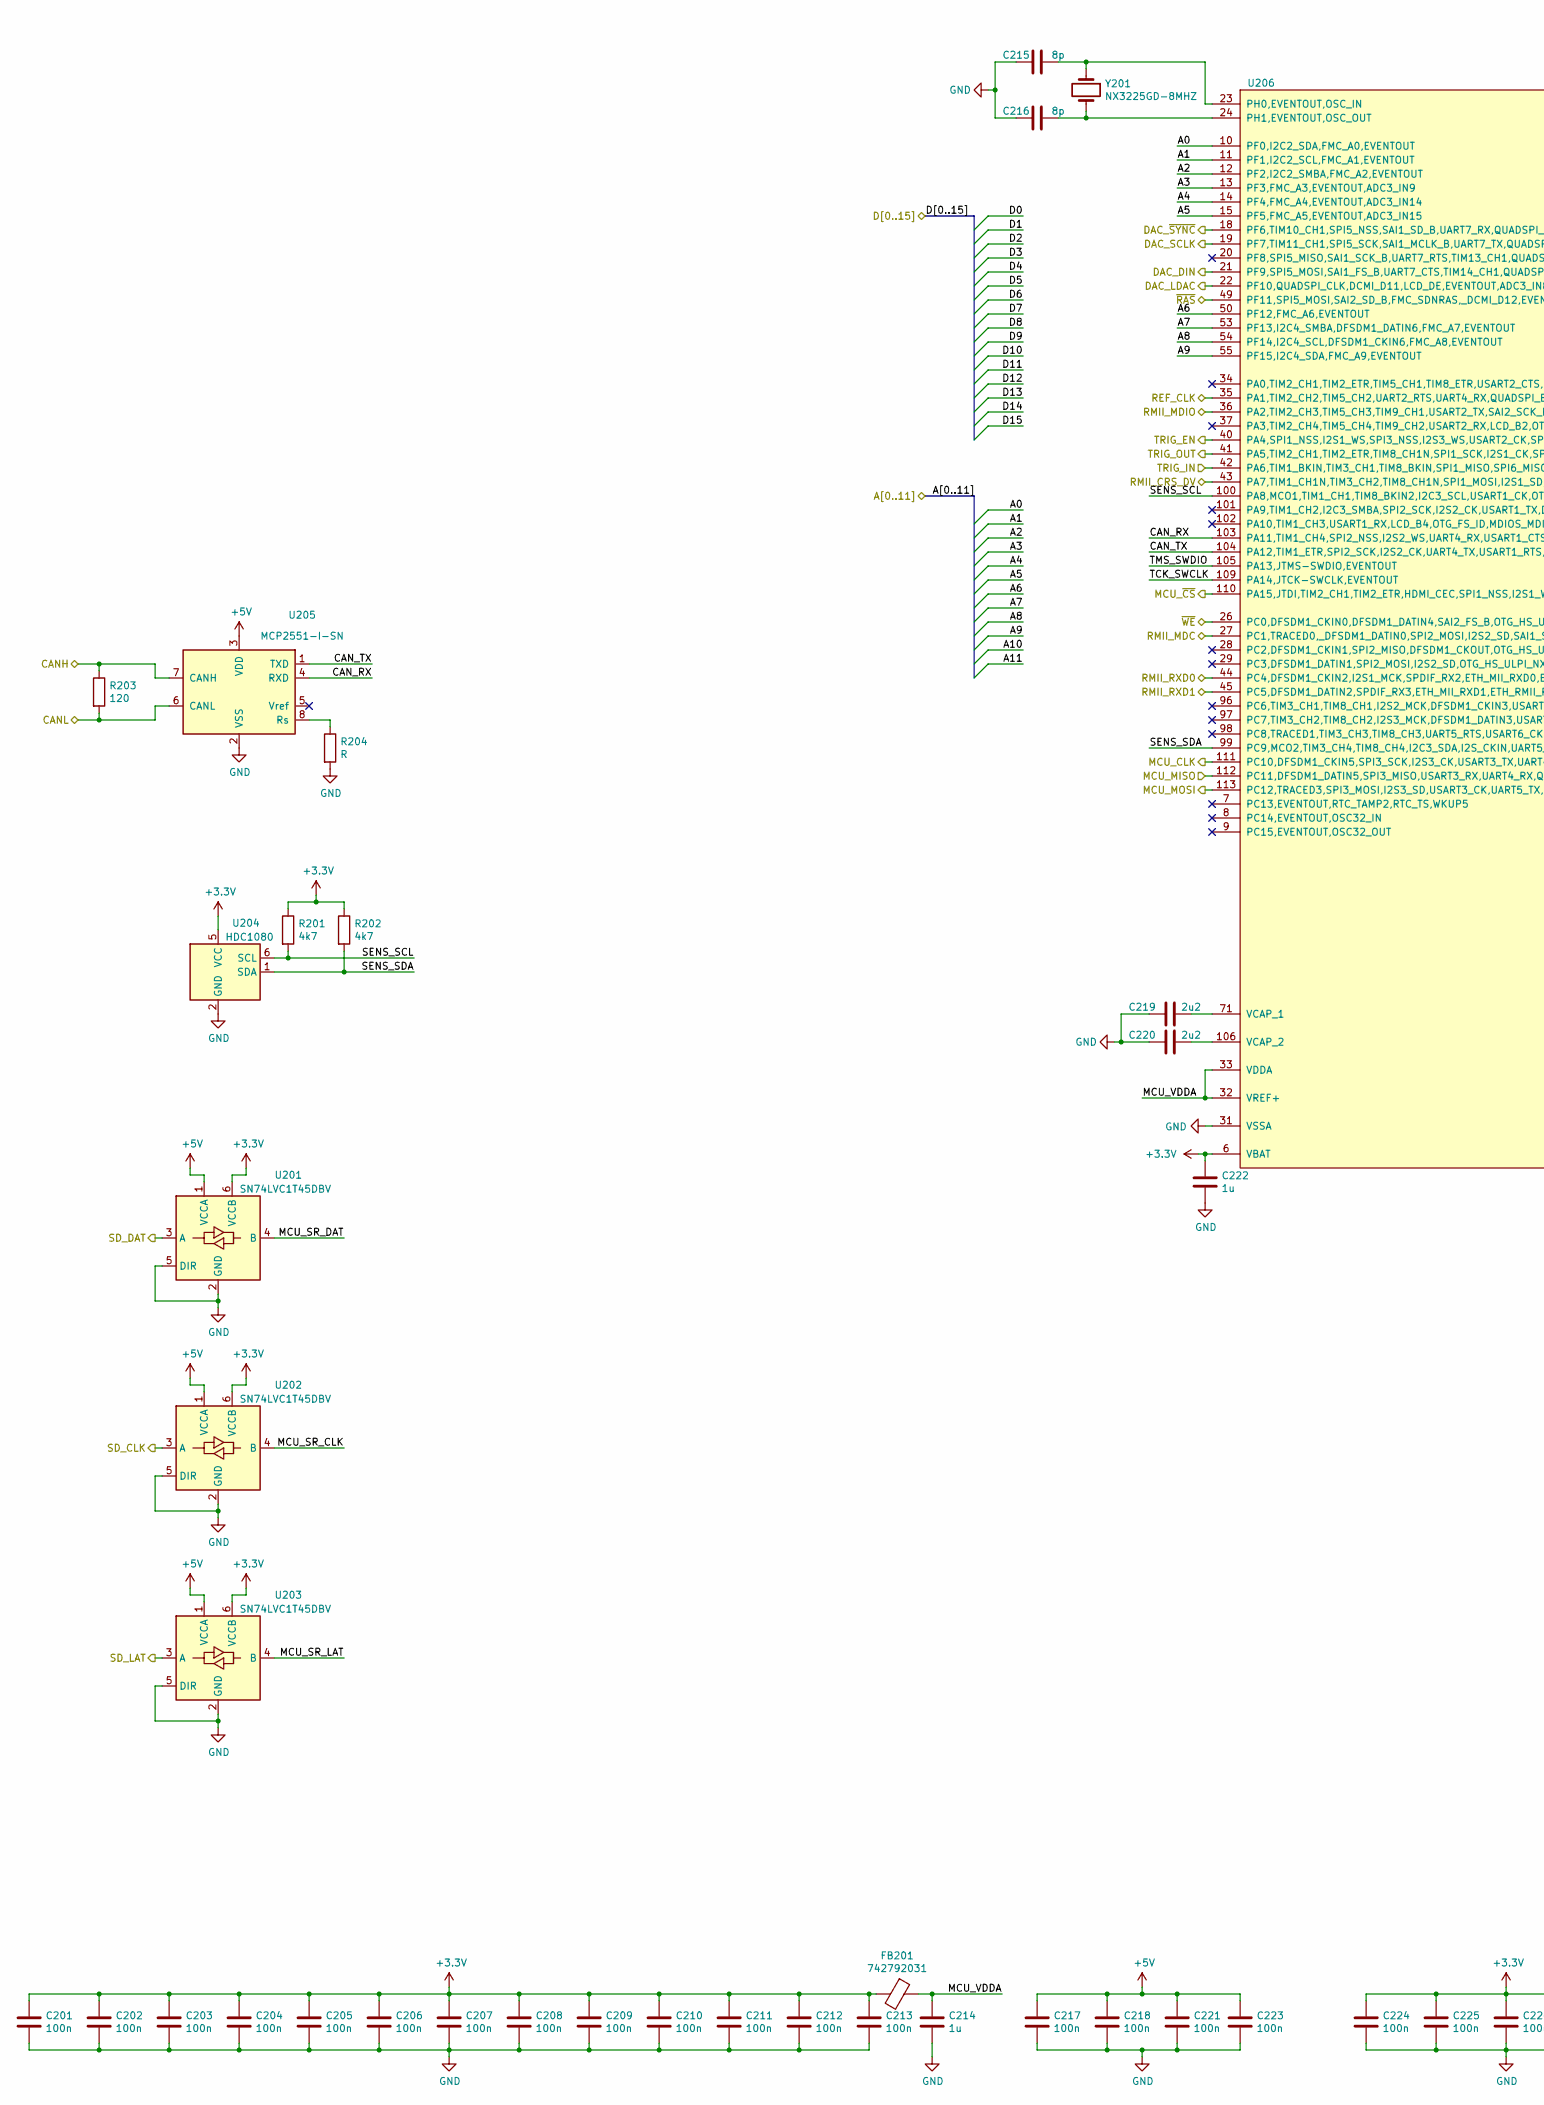
[picture p36: schematic MCU.sch, part in row 1, column 1]

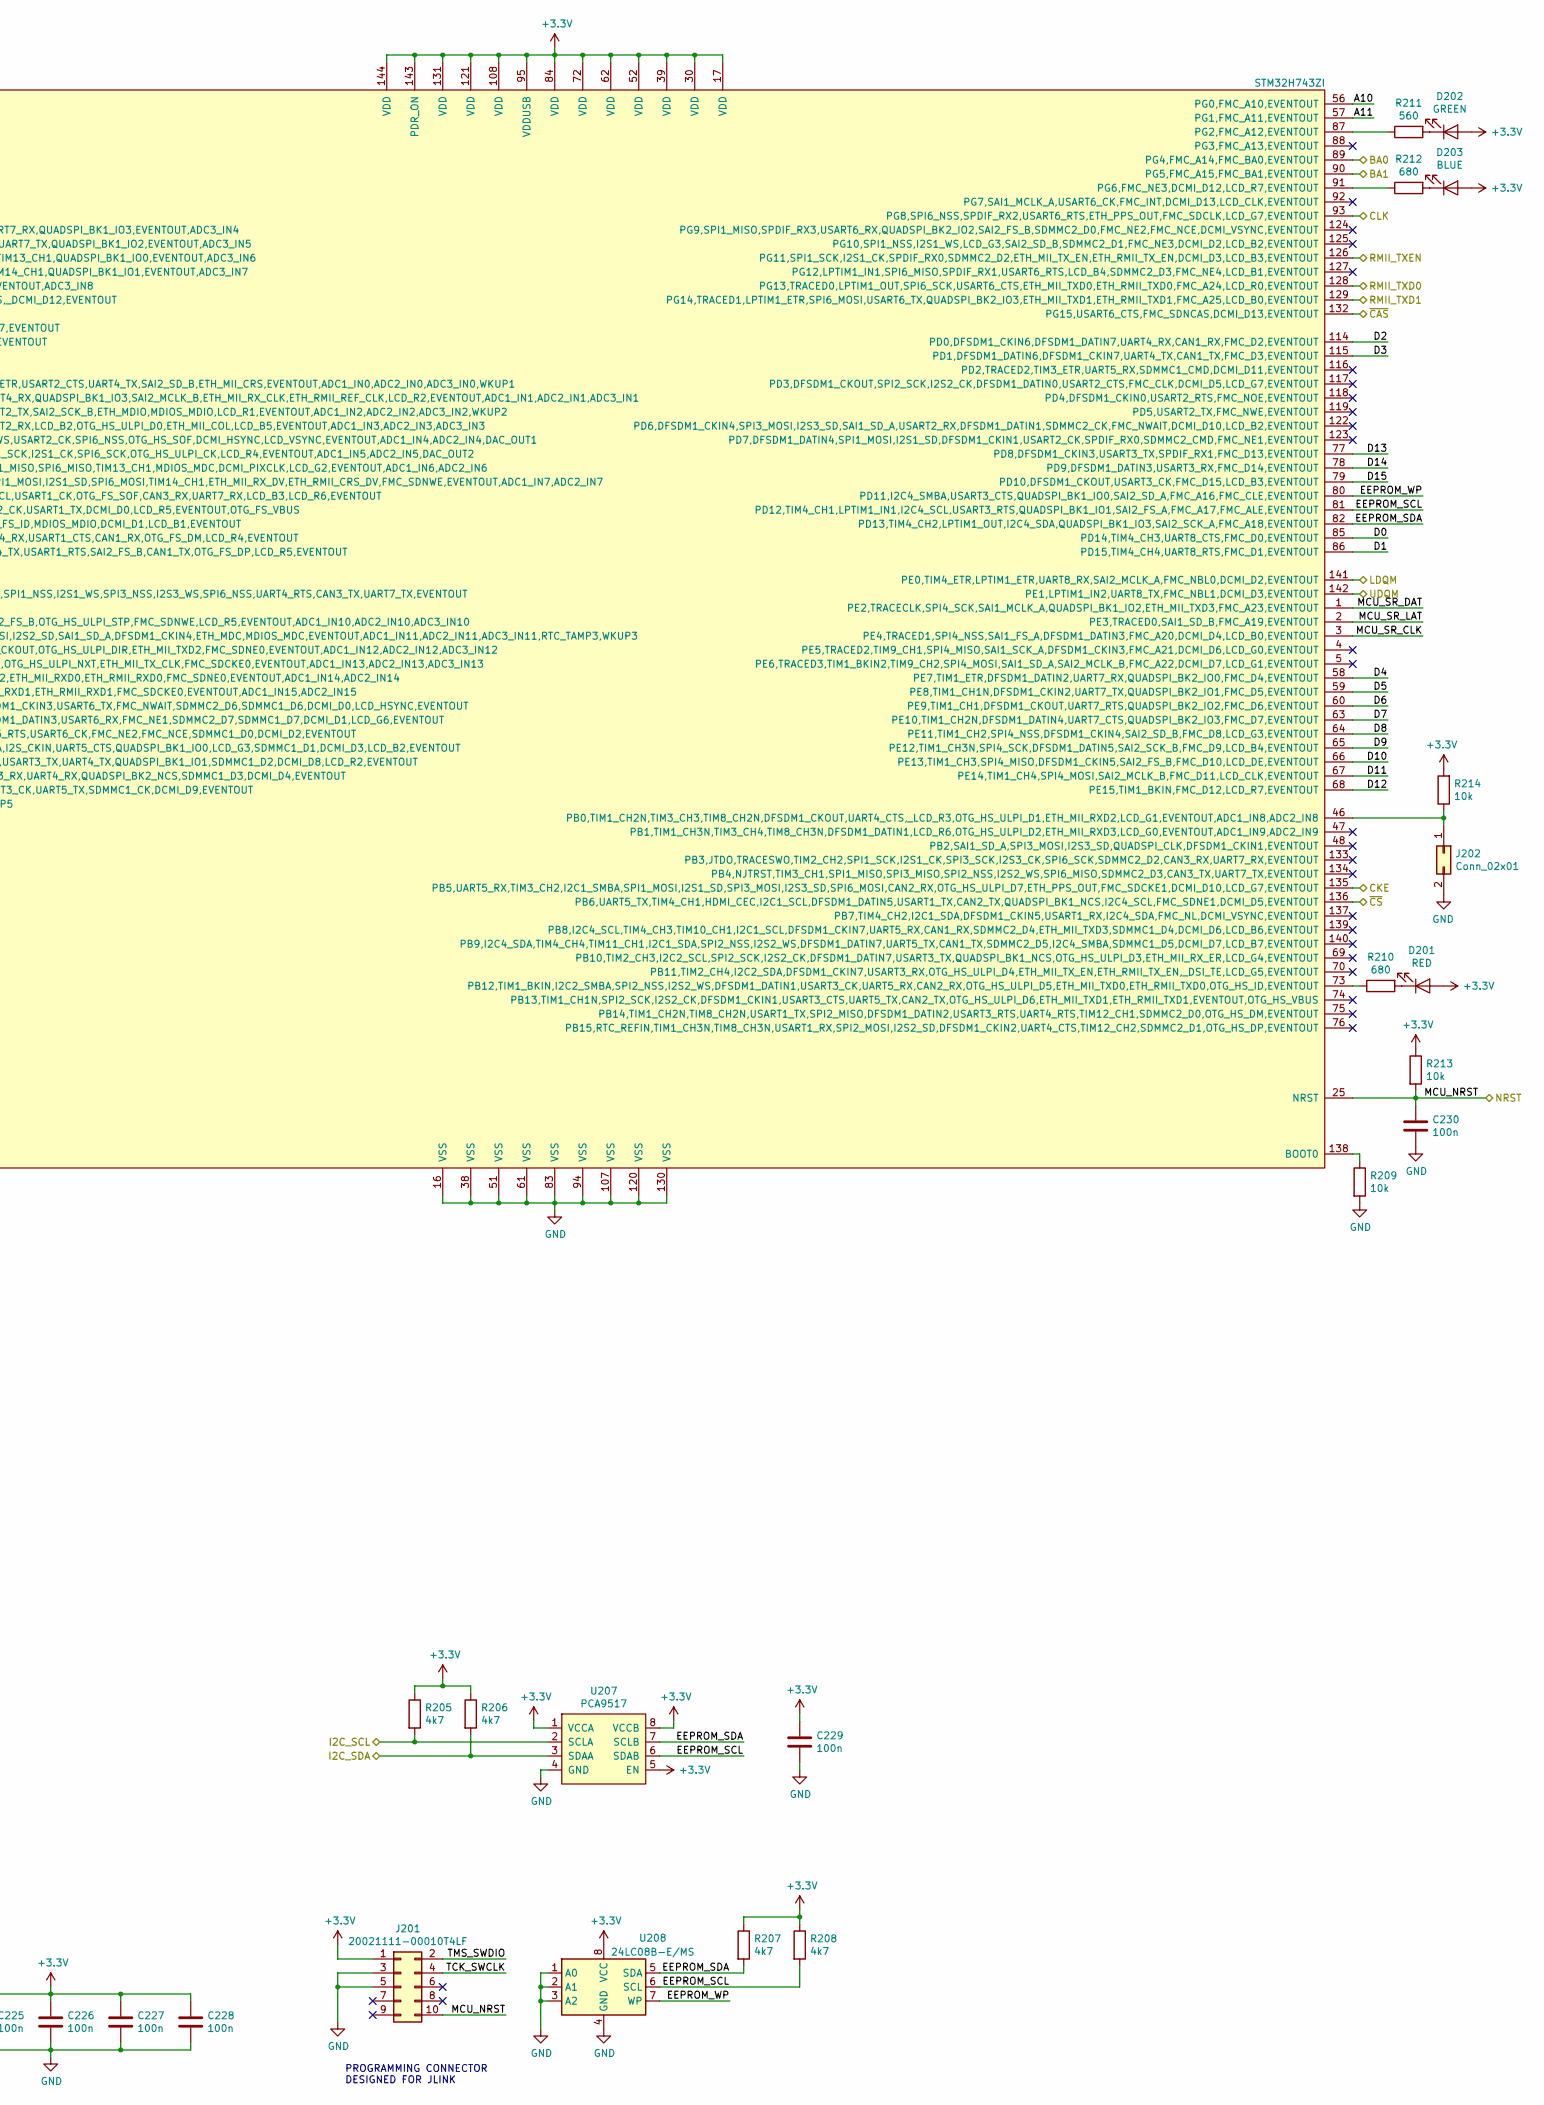
[picture p37: schematic MCU.sch, part in row 1, column 2]

Parts:
C201, C202, C203, C204, C205, C206, C207, C208, C209, C210, C211, C212, C213, C217, C218, C221, C223, C224, C225, C226, C227, C228, C229, C230: 100n; C_0603_1608Metric_Pad1.08x0.95mm_HandSolder
C214, C222: 1u; C_0603_1608Metric_Pad1.08x0.95mm_HandSolder
C215, C216: 8p; C_0603_1608Metric_Pad1.08x0.95mm_HandSolder
C219, C220: 2u2; C_0603_1608Metric_Pad1.08x0.95mm_HandSolder
D201: RED; LED_0603_1608Metric_Pad1.05x0.95mm_HandSolder
D202: GREEN; LED_0603_1608Metric_Pad1.05x0.95mm_HandSolder
D203: BLUE; LED_0603_1608Metric_Pad1.05x0.95mm_HandSolder
FB201: 742792031; L_0805_2012Metric_Pad1.15x1.40mm_HandSolder
J201: 20021111-00010T4LF; PinHeader_2x05_P1.27mm_Vertical
J202: Conn_02x01; PinHeader_1x02_P2.54mm_Vertical
R201, R202, R205, R206, R207, R208: 4k7; R_0603_1608Metric_Pad0.98x0.95mm_HandSolder
R203: 120; R_0603_1608Metric_Pad0.98x0.95mm_HandSolder
R204: R; R_0603_1608Metric_Pad0.98x0.95mm_HandSolder
R209, R213, R214: 10k; R_0603_1608Metric_Pad0.98x0.95mm_HandSolder
R210, R212: 680; R_0603_1608Metric_Pad0.98x0.95mm_HandSolder
R211: 560; R_0603_1608Metric_Pad0.98x0.95mm_HandSolder
U201, U202, U203: SN74LVC1T45DBV; SOT-23-6
U204: HDC1080; Texas_PWSON-N6
U205: MCP2551-I-SN; SOIC-8_3.9x4.9mm_P1.27mm
U206: STM32H743ZI; TQFP-144_20x20mm_P0.5mm
U207: PCA9517; TSSOP-8_3x3mm_P0.65mm
U208: 24LC08B-E/MS; MSOP-8_3x3mm_P0.65mm
Y201: NX3225GD-8MHZ; NX3225GD

Connections:
+3V3: C201.1, C202.1, C203.1, C204.1, C205.1, C206.1, C207.1, C208.1, C209.1, C210.1, C211.1, C212.1, C213.1, C222.1, C224.1, C225.1, C226.1, C227.1, C228.1, C229.1, D201.2 (A), D202.2 (A), D203.2 (A), FB201.2, J201.1, R201.1, R202.1, R205.1, R206.1, R207.1, R208.1, R213.1, R214.2, U201.6 (VCCB), U202.6 (VCCB), U203.6 (VCCB), U204.5 (VCC), U206.6 (VBAT), U206.17 (VDD), U206.30 (VDD), U206.39 (VDD), U206.52 (VDD), U206.62 (VDD), U206.72 (VDD), U206.84 (VDD), U206.95 (VDDUSB), U206.108 (VDD), U206.121 (VDD), U206.131 (VDD), U206.143 (PDR_ON), U206.144 (VDD), U207.1 (VCCA), U207.5 (EN), U207.8 (VCCB), U208.8 (VCC); also elsewhere on the board
+5V: C217.1, C218.1, C221.1, C223.1, U201.1 (VCCA), U202.1 (VCCA), U203.1 (VCCA), U205.3 (VDD); also elsewhere on the board
/CH1 Connector/CANH: R203.1, U205.7 (CANH); also elsewhere on the board
/CH1 Connector/CANL: R203.2, U205.6 (CANL); also elsewhere on the board
/CH1 Connector/I2C_SCL: R205.2, U207.2 (SCLA); also elsewhere on the board
/CH1 Connector/I2C_SDA: R206.2, U207.3 (SDAA); also elsewhere on the board
/Channel 1/ADC1_SCLK: U206.111 (PC10,DFSDM1_CKIN5,SPI3_SCK,I2S3_CK,USAR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); also elsewhere on the board
/Channel 1/ADC1_SDI: U206.113 (PC12,TRACED3,SPI3_MOSI,I2S3_SD,USART3_C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); also elsewhere on the board
/Channel 1/ADC1_~CS: U206.110 (PA15,JTDI,TIM2_CH1,TIM2_ETR,HDMI_CEC,SP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); also elsewhere on the board
/Channel 3/ADC3_SDO: U206.112 (PC11,DFSDM1_DATIN5,SPI3_MISO,USART3_RX,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); also elsewhere on the board
/DAC/DAC_DIN: U206.21 (PF9,SPI5_MOSI,SAI1_FS_B,UART7_CTS,TIM14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); also elsewhere on the board
/DAC/DAC_LDAC: U206.22 (PF10,QUADSPI_CLK,DCMI_D11,LCD_DE,EVENTO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); also elsewhere on the board
/DAC/DAC_SCLK: U206.19 (PF7,TIM11_CH1,SPI5_SCK,SAI1_MCLK_B,UART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); also elsewhere on the board
/DAC/DAC_~SYNC: U206.18 (PF6,TIM10_CH1,SPI5_NSS,SAI1_SD_B,UART7_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); also elsewhere on the board
/Ethernet/NRST: C230.1, J201.10, R213.2, U206.25 (NRST); also elsewhere on the board
/Ethernet/REF_CLK: U206.35 (PA1,TIM2_CH2,TIM5_CH2,UART2_RTS,UART4_R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); also elsewhere on the board
/Ethernet/RMII_CRS_DV: U206.43 (PA7,TIM1_CH1N,TIM3_CH2,TIM8_CH1N,SPI1_M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); also elsewhere on the board
/Ethernet/RMII_MDC: U206.27 (PC1,TRACED0,_DFSDM1_DATIN0,SPI2_MOSI,I2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); also elsewhere on the board
/Ethernet/RMII_MDIO: U206.36 (PA2,TIM2_CH3,TIM5_CH3,TIM9_CH1,USART2_T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); also elsewhere on the board
/Ethernet/RMII_RXD0: U206.44 (PC4,DFSDM1_CKIN2,I2S1_MCK,SPDIF_RX2,ETH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); also elsewhere on the board
/Ethernet/RMII_RXD1: U206.45 (PC5,DFSDM1_DATIN2,SPDIF_RX3,ETH_MII_RXD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); also elsewhere on the board
/Ethernet/RMII_TXD0: U206.128 (PG13,TRACED0,LPTIM1_OUT,SPI6_SCK,USART6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); also elsewhere on the board
/Ethernet/RMII_TXD1: U206.129 (PG14,TRACED1,LPTIM1_ETR,SPI6_MOSI,USART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); also elsewhere on the board
/Ethernet/RMII_TXEN: U206.126 (PG11,SPI1_SCK,I2S1_CK,SPDIF_RX0,SDMMC2_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); also elsewhere on the board
/MCU/A0: U206.10 (PF0,I2C2_SDA,FMC_A0,EVENTOUT); also elsewhere on the board
/MCU/A1: U206.11 (PF1,I2C2_SCL,FMC_A1,EVENTOUT); also elsewhere on the board
/MCU/A2: U206.12 (PF2,I2C2_SMBA,FMC_A2,EVENTOUT); also elsewhere on the board
/MCU/A3: U206.13 (PF3,FMC_A3,EVENTOUT,ADC3_IN9); also elsewhere on the board
/MCU/A4: U206.14 (PF4,FMC_A4,EVENTOUT,ADC3_IN14); also elsewhere on the board
/MCU/A5: U206.15 (PF5,FMC_A5,EVENTOUT,ADC3_IN15); also elsewhere on the board
/MCU/A6: U206.50 (PF12,FMC_A6,EVENTOUT); also elsewhere on the board
/MCU/A7: U206.53 (PF13,I2C4_SMBA,DFSDM1_DATIN6,FMC_A7,EVE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); also elsewhere on the board
/MCU/A8: U206.54 (PF14,I2C4_SCL,DFSDM1_CKIN6,FMC_A8,EVENT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); also elsewhere on the board
/MCU/A9: U206.55 (PF15,I2C4_SDA,FMC_A9,EVENTOUT); also elsewhere on the board
/MCU/A10: U206.56 (PG0,FMC_A10,EVENTOUT); also elsewhere on the board
/MCU/A11: U206.57 (PG1,FMC_A11,EVENTOUT); also elsewhere on the board
/MCU/BA0: U206.89 (PG4,FMC_A14,FMC_BA0,EVENTOUT); also elsewhere on the board
/MCU/BA1: U206.90 (PG5,FMC_A15,FMC_BA1,EVENTOUT); also elsewhere on the board
/MCU/CAN_RX: U205.4 (RXD), U206.103 (PA11,TIM1_CH4,SPI2_NSS,I2S2_WS,UART4_RX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)
/MCU/CAN_TX: U205.1 (TXD), U206.104 (PA12,TIM1_ETR,SPI2_SCK,I2S2_CK,UART4_TX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)
/MCU/CKE: U206.135 (PB5,UART5_RX,TIM3_CH2,I2C1_SMBA,SPI1_MO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); also elsewhere on the board
/MCU/CLK: U206.93 (PG8,SPI6_NSS,SPDIF_RX2,USART6_RTS,ETH_P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); also elsewhere on the board
/MCU/D0: U206.85 (PD14,TIM4_CH3,UART8_CTS,FMC_D0,EVENTOUT); also elsewhere on the board
/MCU/D1: U206.86 (PD15,TIM4_CH4,UART8_RTS,FMC_D1,EVENTOUT); also elsewhere on the board
/MCU/D2: U206.114 (PD0,DFSDM1_CKIN6,DFSDM1_DATIN7,UART4_RX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); also elsewhere on the board
/MCU/D3: U206.115 (PD1,DFSDM1_DATIN6,DFSDM1_CKIN7,UART4_TX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); also elsewhere on the board
/MCU/D4: U206.58 (PE7,TIM1_ETR,DFSDM1_DATIN2,UART7_RX,QUA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); also elsewhere on the board
/MCU/D5: U206.59 (PE8,TIM1_CH1N,DFSDM1_CKIN2,UART7_TX,QUA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); also elsewhere on the board
/MCU/D6: U206.60 (PE9,TIM1_CH1,DFSDM1_CKOUT,UART7_RTS,QUA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); also elsewhere on the board
/MCU/D7: U206.63 (PE10,TIM1_CH2N,DFSDM1_DATIN4,UART7_CTS,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); also elsewhere on the board
/MCU/D8: U206.64 (PE11,TIM1_CH2,SPI4_NSS,DFSDM1_CKIN4,SAI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); also elsewhere on the board
/MCU/D9: U206.65 (PE12,TIM1_CH3N,SPI4_SCK,DFSDM1_DATIN5,S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); also elsewhere on the board
/MCU/D10: U206.66 (PE13,TIM1_CH3,SPI4_MISO,DFSDM1_CKIN5,SA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); also elsewhere on the board
/MCU/D11: U206.67 (PE14,TIM1_CH4,SPI4_MOSI,SAI2_MCLK_B,FMC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); also elsewhere on the board
/MCU/D12: U206.68 (PE15,TIM1_BKIN,FMC_D12,LCD_R7,EVENTOUT); also elsewhere on the board
/MCU/D13: U206.77 (PD8,DFSDM1_CKIN3,USART3_TX,SPDIF_RX1,FM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); also elsewhere on the board
/MCU/D14: U206.78 (PD9,DFSDM1_DATIN3,USART3_RX,FMC_D14,EVE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); also elsewhere on the board
/MCU/D15: U206.79 (PD10,DFSDM1_CKOUT,USART3_CK,FMC_D15,LCD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); also elsewhere on the board
/MCU/EEPROM_SCL: R208.2, U206.81 (PD12,TIM4_CH1,LPTIM1_IN1,I2C4_SCL,USART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), U207.6 (SDAB), U208.6 (SCL)
/MCU/EEPROM_SDA: R207.2, U206.82 (PD13,TIM4_CH2,LPTIM1_OUT,I2C4_SDA,QUADS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), U207.7 (SCLB), U208.5 (SDA)
/MCU/EEPROM_WP: U206.80 (PD11,I2C4_SMBA,USART3_CTS,QUADSPI_BK1_I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), U208.7 (WP)
/MCU/LDQM: U206.141 (PE0,TIM4_ETR,LPTIM1_ETR,UART8_RX,SAI2_M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); also elsewhere on the board
/MCU/MCU_SR_CLK: U202.4 (B), U206.3 (PE4,TRACED1,SPI4_NSS,SAI1_FS_A,DFSDM1_D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)
/MCU/MCU_SR_DAT: U201.4 (B), U206.1 (PE2,TRACECLK,SPI4_SCK,SAI1_MCLK_A,QUADS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)
/MCU/MCU_SR_LAT: U203.4 (B), U206.2 (PE3,TRACED0,SAI1_SD_B,FMC_A19,EVENTOUT)
/MCU/MCU_VDDA: C214.1, FB201.1, U206.32 (VREF+), U206.33 (VDDA)
/MCU/SD_CLK: U202.3 (A); also elsewhere on the board
/MCU/SD_DAT: U201.3 (A); also elsewhere on the board
/MCU/SD_LAT: U203.3 (A); also elsewhere on the board
/MCU/SENS_SCL: R201.2, U204.6 (SCL), U206.100 (PA8,MCO1,TIM1_CH1,TIM8_BKIN2,I2C3_SCL,U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)
/MCU/SENS_SDA: R202.2, U204.1 (SDA), U206.99 (PC9,MCO2,TIM3_CH4,TIM8_CH4,I2C3_SDA,I2S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)
/MCU/TCK_SWCLK: J201.4, U206.109 (PA14,JTCK-SWCLK,EVENTOUT)
/MCU/TMS_SWDIO: J201.2, U206.105 (PA13,JTMS-SWDIO,EVENTOUT)
/MCU/TRIG_EN: U206.40 (PA4,SPI1_NSS,I2S1_WS,SPI3_NSS,I2S3_WS,U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); also elsewhere on the board
/MCU/TRIG_IN: U206.42 (PA6,TIM1_BKIN,TIM3_CH1,TIM8_BKIN,SPI1_M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); also elsewhere on the board
/MCU/TRIG_OUT: U206.41 (PA5,TIM2_CH1,TIM2_ETR,TIM8_CH1N,SPI1_SC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); also elsewhere on the board
/MCU/UDQM: U206.142 (PE1,LPTIM1_IN2,UART8_TX,FMC_NBL1,DCMI_D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); also elsewhere on the board
/MCU/~CAS: U206.132 (PG15,USART6_CTS,FMC_SDNCAS,DCMI_D13,EVE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); also elsewhere on the board
/MCU/~CS: U206.136 (PB6,UART5_TX,TIM4_CH1,HDMI_CEC,I2C1_SCL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); also elsewhere on the board
/MCU/~RAS: U206.49 (PF11,SPI5_MOSI,SAI2_SD_B,FMC_SDNRAS,_DC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); also elsewhere on the board
/MCU/~WE: U206.26 (PC0,DFSDM1_CKIN0,DFSDM1_DATIN4,SAI2_FS_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); also elsewhere on the board
GND: C201.2, C202.2, C203.2, C204.2, C205.2, C206.2, C207.2, C208.2, C209.2, C210.2, C211.2, C212.2, C213.2, C214.2, C215.2, C216.2, C217.2, C218.2, C219.2, C220.2, C221.2, C222.2, C223.2, C224.2, C225.2, C226.2, C227.2, C228.2, C229.2, C230.2, J201.3, J201.5, J202.2, R204.2, R209.2, U201.2 (GND), U201.5 (DIR), U202.2 (GND), U202.5 (DIR), U203.2 (GND), U203.5 (DIR), U204.2 (GND), U205.2 (VSS), U206.16 (VSS), U206.31 (VSSA), U206.38 (VSS), U206.51 (VSS), U206.61 (VSS), U206.83 (VSS), U206.94 (VSS), U206.107 (VSS), U206.120 (VSS), U206.130 (VSS), U207.4 (GND), U208.1 (A0), U208.2 (A1), U208.3 (A2), U208.4 (GND); also elsewhere on the board
unnamed: C215.1, U206.23 (PH0,EVENTOUT,OSC_IN), Y201.1
unnamed: C216.1, U206.24 (PH1,EVENTOUT,OSC_OUT), Y201.2
unnamed: C219.1, U206.71 (VCAP_1)
unnamed: C220.1, U206.106 (VCAP_2)
unnamed: D201.1 (K), R210.2
unnamed: D202.1 (K), R211.2
unnamed: D203.1 (K), R212.2
unnamed: J202.1, R214.1, U206.46 (PB0,TIM1_CH2N,TIM3_CH3,TIM8_CH2N,DFSDM1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)
unnamed: R204.1, U205.8 (Rs)
unnamed: R209.1, U206.138 (BOOT0)
unnamed: R210.1, U206.73 (PB12,TIM1_BKIN,I2C2_SMBA,SPI2_NSS,I2S2_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)
unnamed: R211.1, U206.87 (PG2,FMC_A12,EVENTOUT)
unnamed: R212.1, U206.91 (PG6,FMC_NE3,DCMI_D12,LCD_R7,EVENTOUT)

Notes on the sheet:
PROGRAMMING CONNECTOR DESIGNED FOR JLINK
