BehrensG/ETH3CDAQ1/hardware/project/ETH3CDAQ1_MEASURE/ETH3CDAQ1_MEASURE.kicad_pcb

## KiCad design hardware/project/ETH3CDAQ1_MEASURE/ETH3CDAQ1_MEASURE.kicad_pcb (continued)

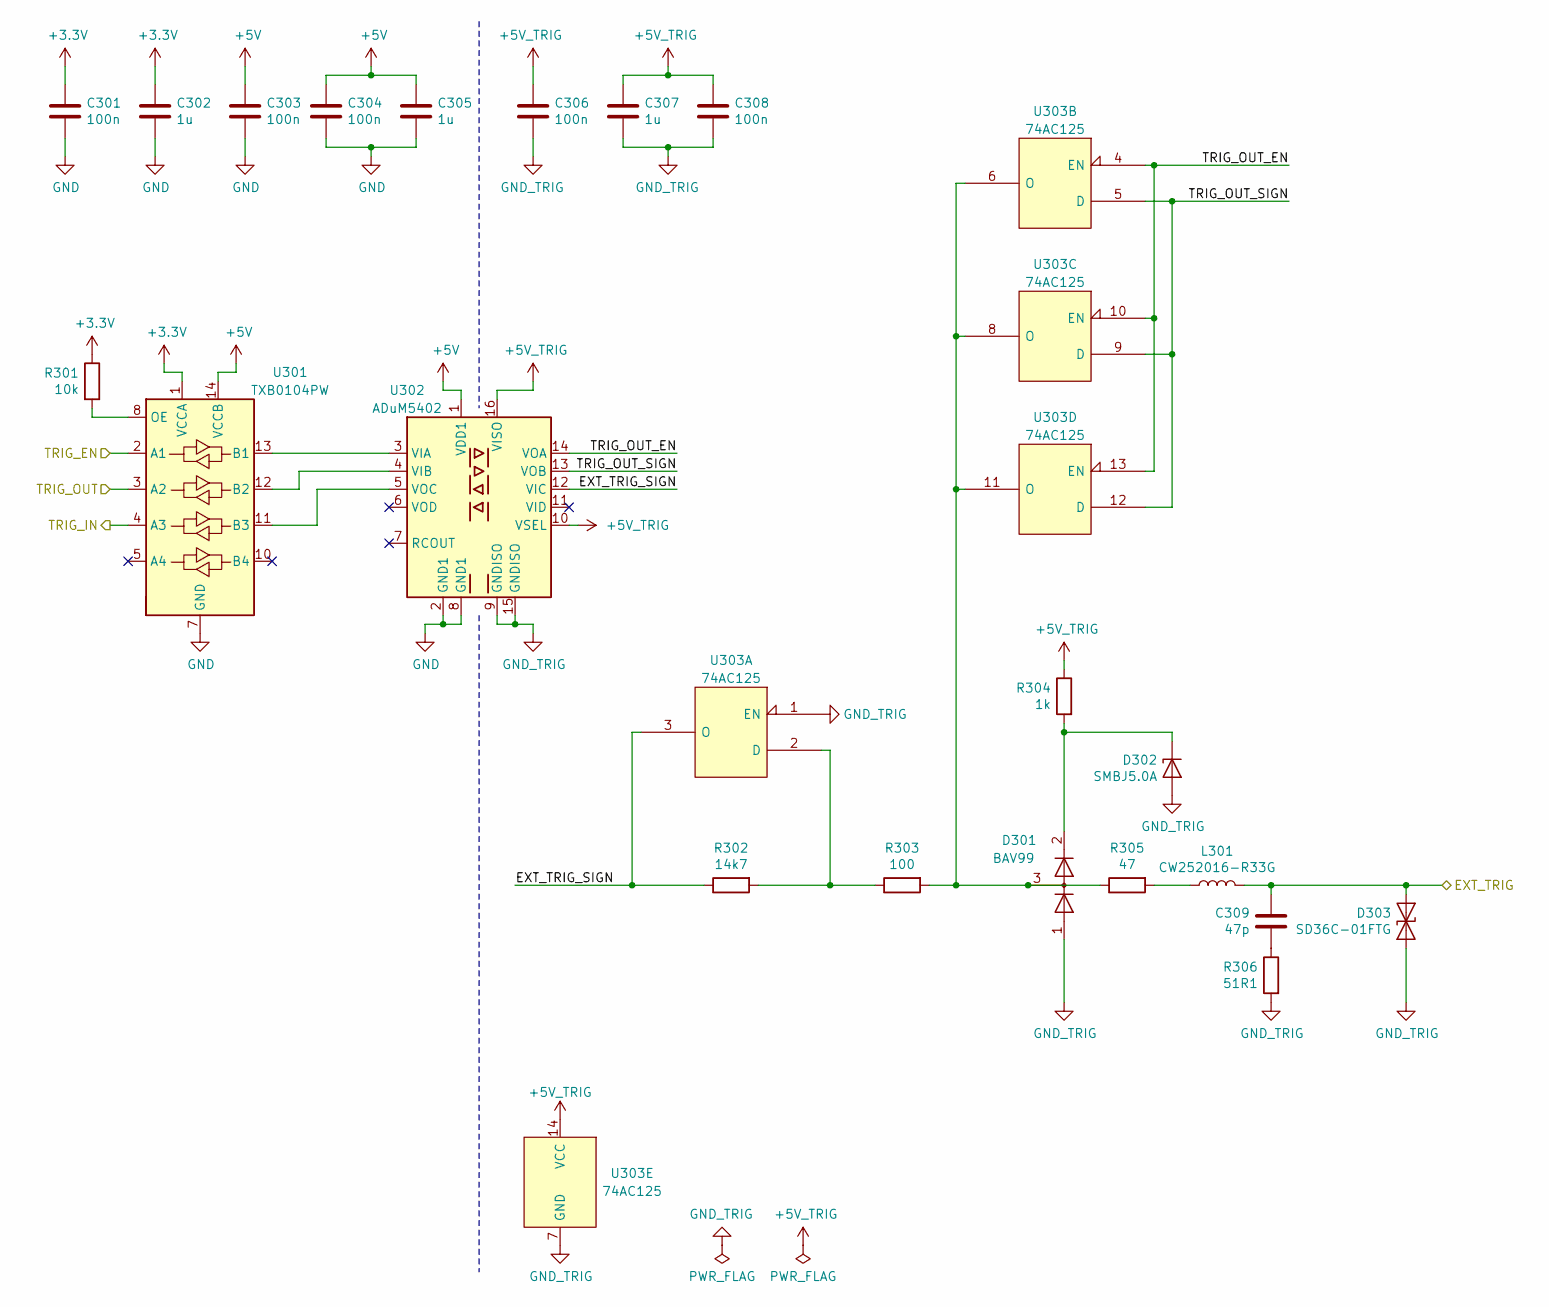
[picture p38: schematic Trigger.sch]

Parts:
C301, C303, C304, C306, C308: 100n; C_0603_1608Metric_Pad1.08x0.95mm_HandSolder
C302, C305, C307: 1u; C_0603_1608Metric_Pad1.08x0.95mm_HandSolder
C309: 47p; C_0603_1608Metric_Pad1.08x0.95mm_HandSolder
D301: BAV99; SOT-23
D302: SMBJ5.0A; D_SMB
D303: SD36C-01FTG; D_SOD-323_HandSoldering
L301: CW252016-R33G; CW252016
R301: 10k; R_0603_1608Metric_Pad0.98x0.95mm_HandSolder
R302: 14k7; R_0603_1608Metric_Pad0.98x0.95mm_HandSolder
R303: 100; R_0603_1608Metric_Pad0.98x0.95mm_HandSolder
R304: 1k; R_0603_1608Metric_Pad0.98x0.95mm_HandSolder
R305: 47; R_0603_1608Metric_Pad0.98x0.95mm_HandSolder
R306: 51R1; R_0603_1608Metric_Pad0.98x0.95mm_HandSolder
U301: TXB0104PW; TSSOP-14_4.4x5mm_P0.65mm
U302: ADuM5402; SOIC-16W_7.5x10.3mm_P1.27mm
U303: 74AC125; TSSOP-14_4.4x5mm_P0.65mm

Connections:
+3V3: C301.1, C302.1, R301.1, U301.1 (VCCA); also elsewhere on the board
+5V: C303.1, C304.1, C305.1, U301.14 (VCCB), U302.1 (VDD1); also elsewhere on the board
+5V_TRIG: C306.1, C307.1, C308.1, R304.1, U302.10 (VSEL), U302.16 (VISO), U303.14 (VCC)
/Connector 1/EXT_TRIG: C309.1, D303.1 (A1), L301.1; also elsewhere on the board
/MCU/TRIG_EN: U301.2 (A1); also elsewhere on the board
/MCU/TRIG_IN: U301.4 (A3); also elsewhere on the board
/MCU/TRIG_OUT: U301.3 (A2); also elsewhere on the board
/Trigger/EXT_TRIG_SIGN: R302.1, U302.12 (VIC), U303.3 (O)
/Trigger/TRIG_OUT_EN: U302.14 (VOA), U303.4 (EN), U303.10 (EN), U303.13 (EN)
/Trigger/TRIG_OUT_SIGN: U302.13 (VOB), U303.5 (D), U303.9 (D), U303.12 (D)
GND: C301.2, C302.2, C303.2, C304.2, C305.2, U301.7 (GND), U302.2 (GND1), U302.8 (GND1); also elsewhere on the board
GND_TRIG: C306.2, C307.2, C308.2, D301.1 (K), D302.2 (A), D303.2 (A2), R306.2, U302.9 (GNDISO), U302.15 (GNDISO), U303.1 (EN), U303.7 (GND); also elsewhere on the board
unnamed: C309.2, R306.1
unnamed: D301.2 (A), D302.1 (K), R304.2
unnamed: D301.3 (K), R303.2, R305.1, U303.6 (O), U303.8 (O), U303.11 (O)
unnamed: L301.2, R305.2
unnamed: R301.2, U301.8 (OE)
unnamed: R302.2, R303.1, U303.2 (D)
unnamed: U301.11 (B3), U302.5 (VOC)
unnamed: U301.12 (B2), U302.4 (VIB)
unnamed: U301.13 (B1), U302.3 (VIA)

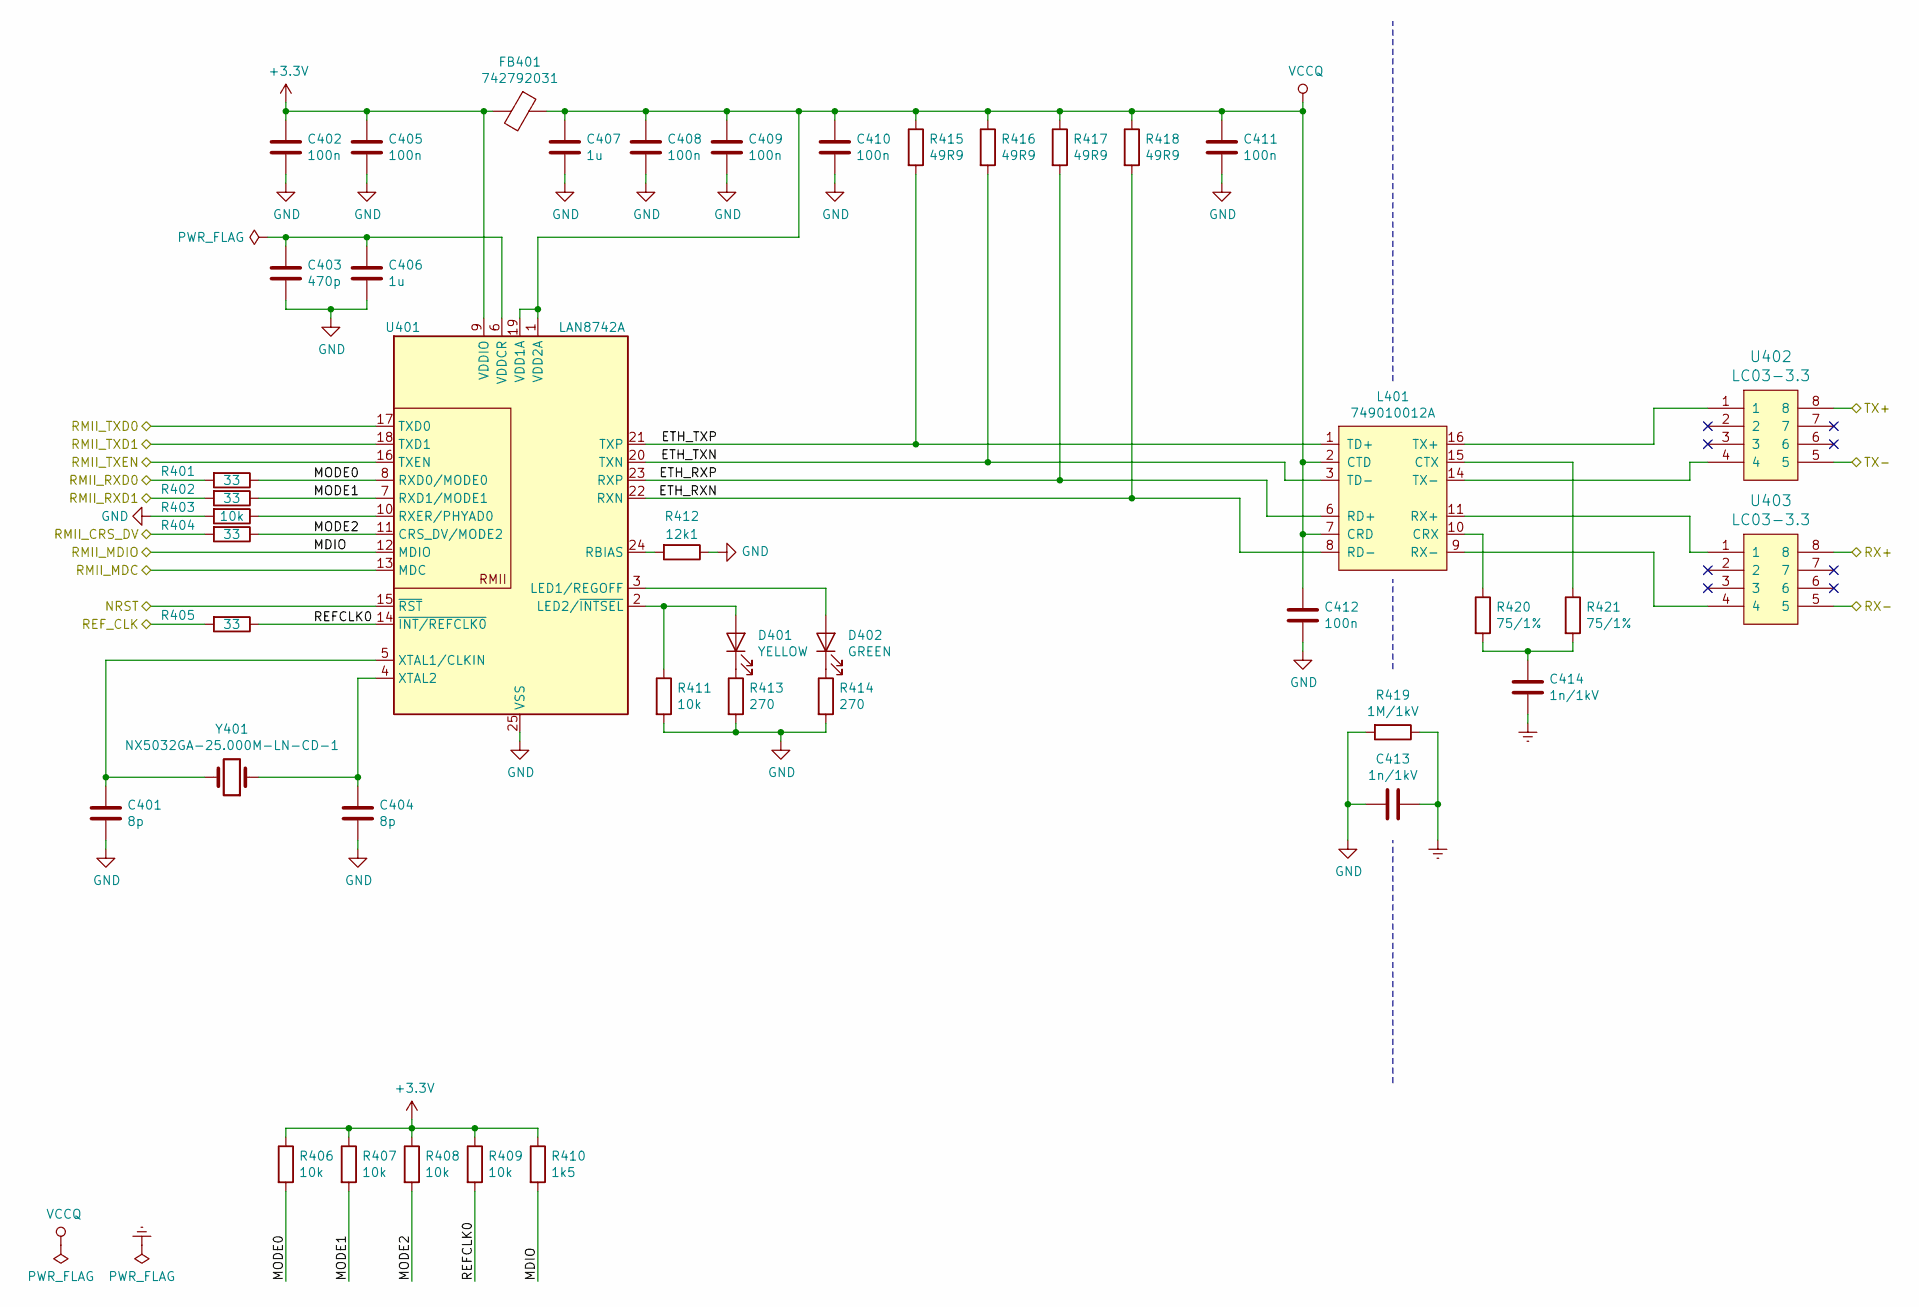
[picture p39: schematic Ethernet.sch]

Parts:
C401, C404: 8p; C_0603_1608Metric_Pad1.08x0.95mm_HandSolder
C402, C405, C408, C409, C410, C411, C412: 100n; C_0603_1608Metric_Pad1.08x0.95mm_HandSolder
C403: 470p; C_0603_1608Metric_Pad1.08x0.95mm_HandSolder
C406, C407: 1u; C_0603_1608Metric_Pad1.08x0.95mm_HandSolder
C413, C414: 1n/1kV; C_1206_3216Metric_Pad1.33x1.80mm_HandSolder
D401: YELLOW; LED_0603_1608Metric_Pad1.05x0.95mm_HandSolder
D402: GREEN; LED_0603_1608Metric_Pad1.05x0.95mm_HandSolder
FB401: 742792031; L_0805_2012Metric_Pad1.15x1.40mm_HandSolder
L401: 749010012A
R401, R402, R404, R405: 33; R_0603_1608Metric_Pad0.98x0.95mm_HandSolder
R403, R406, R407, R408, R409, R411: 10k; R_0603_1608Metric_Pad0.98x0.95mm_HandSolder
R410: 1k5; R_0603_1608Metric_Pad0.98x0.95mm_HandSolder
R412: 12k1; R_0603_1608Metric_Pad0.98x0.95mm_HandSolder
R413, R414: 270; R_0603_1608Metric_Pad0.98x0.95mm_HandSolder
R415, R416, R417, R418: 49R9; R_0603_1608Metric_Pad0.98x0.95mm_HandSolder
R419: 1M/1kV; R_1206_3216Metric_Pad1.30x1.75mm_HandSolder
R420, R421: 75/1%; R_0603_1608Metric_Pad0.98x0.95mm_HandSolder
U401: LAN8742A; QFN-24-1EP_4x4mm_P0.5mm_EP2.6x2.6mm_ThermalVias
U402, U403: LC03-3.3; SO8E
Y401: NX5032GA-25.000M-LN-CD-1; NX5032GA

Connections:
+3V3: C402.1, C405.1, FB401.2, R406.1, R407.1, R408.1, R409.1, R410.1, U401.9 (VDDIO); also elsewhere on the board
/Connector 1/RX+: U403.8; also elsewhere on the board
/Connector 1/RX-: U403.5; also elsewhere on the board
/Connector 1/TX+: U402.8; also elsewhere on the board
/Connector 1/TX-: U402.5; also elsewhere on the board
/Ethernet/ETH_RXN: L401.8 (RD-), R418.2, U401.22 (RXN)
/Ethernet/ETH_RXP: L401.6 (RD+), R417.2, U401.23 (RXP)
/Ethernet/ETH_TXN: L401.3 (TD-), R416.2, U401.20 (TXN)
/Ethernet/ETH_TXP: L401.1 (TD+), R415.2, U401.21 (TXP)
/Ethernet/MODE0: R401.1, R406.2, U401.8 (RXD0/MODE0)
/Ethernet/MODE1: R402.1, R407.2, U401.7 (RXD1/MODE1)
/Ethernet/MODE2: R404.1, R408.2, U401.11 (CRS_DV/MODE2)
/Ethernet/NRST: U401.15 (~RST); also elsewhere on the board
/Ethernet/REFCLK0: R405.1, R409.2, U401.14 (~INT/REFCLK0)
/Ethernet/REF_CLK: R405.2; also elsewhere on the board
/Ethernet/RMII_CRS_DV: R404.2; also elsewhere on the board
/Ethernet/RMII_MDC: U401.13 (MDC); also elsewhere on the board
/Ethernet/RMII_MDIO: R410.2, U401.12 (MDIO); also elsewhere on the board
/Ethernet/RMII_RXD0: R401.2; also elsewhere on the board
/Ethernet/RMII_RXD1: R402.2; also elsewhere on the board
/Ethernet/RMII_TXD0: U401.17 (TXD0); also elsewhere on the board
/Ethernet/RMII_TXD1: U401.18 (TXD1); also elsewhere on the board
/Ethernet/RMII_TXEN: U401.16 (TXEN); also elsewhere on the board
Earth: C413.1, C414.2, R419.1; also elsewhere on the board
GND: C401.2, C402.2, C403.2, C404.2, C405.2, C406.2, C407.2, C408.2, C409.2, C410.2, C411.2, C412.2, C413.2, R403.2, R411.2, R412.1, R413.2, R414.2, R419.2, U401.25 (VSS); also elsewhere on the board
unnamed: C401.1, U401.5 (XTAL1/CLKIN), Y401.2
unnamed: C403.1, C406.1, U401.6 (VDDCR)
unnamed: C404.1, U401.4 (XTAL2), Y401.1
unnamed: C414.1, R420.2, R421.2
unnamed: D401.1 (K), R413.1
unnamed: D401.2 (A), R411.1, U401.2 (LED2/~INTSEL)
unnamed: D402.1 (K), R414.1
unnamed: D402.2 (A), U401.3 (LED1/REGOFF)
unnamed: L401.9 (RX-), U403.4
unnamed: L401.10 (CRX), R420.1
unnamed: L401.11 (RX+), U403.1
unnamed: L401.14 (TX-), U402.4
unnamed: L401.15 (CTX), R421.1
unnamed: L401.16 (TX+), U402.1
unnamed: R403.1, U401.10 (RXER/PHYAD0)
unnamed: R412.2, U401.24 (RBIAS)
VCCQ: C407.1, C408.1, C409.1, C410.1, C411.1, C412.1, FB401.1, L401.2 (CTD), L401.7 (CRD), R415.1, R416.1, R417.1, R418.1, U401.1 (VDD2A), U401.19 (VDD1A)

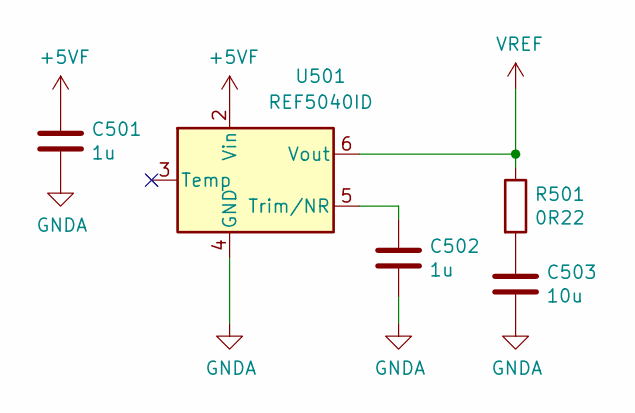
[picture p40: schematic VREF.sch]

Parts:
C501, C502: 1u; C_0603_1608Metric_Pad1.08x0.95mm_HandSolder
C503: 10u; C_0805_2012Metric_Pad1.18x1.45mm_HandSolder
R501: 0R22; R_0603_1608Metric_Pad0.98x0.95mm_HandSolder
U501: REF5040ID; SOIC-8_3.9x4.9mm_P1.27mm

Connections:
+5VF: C501.1, U501.2 (Vin); also elsewhere on the board
GND: C501.2, C502.2, C503.2, U501.4 (GND); also elsewhere on the board
unnamed: C502.1, U501.5 (Trim/NR)
unnamed: C503.1, R501.2
VREF: R501.1, U501.6 (Vout); also elsewhere on the board

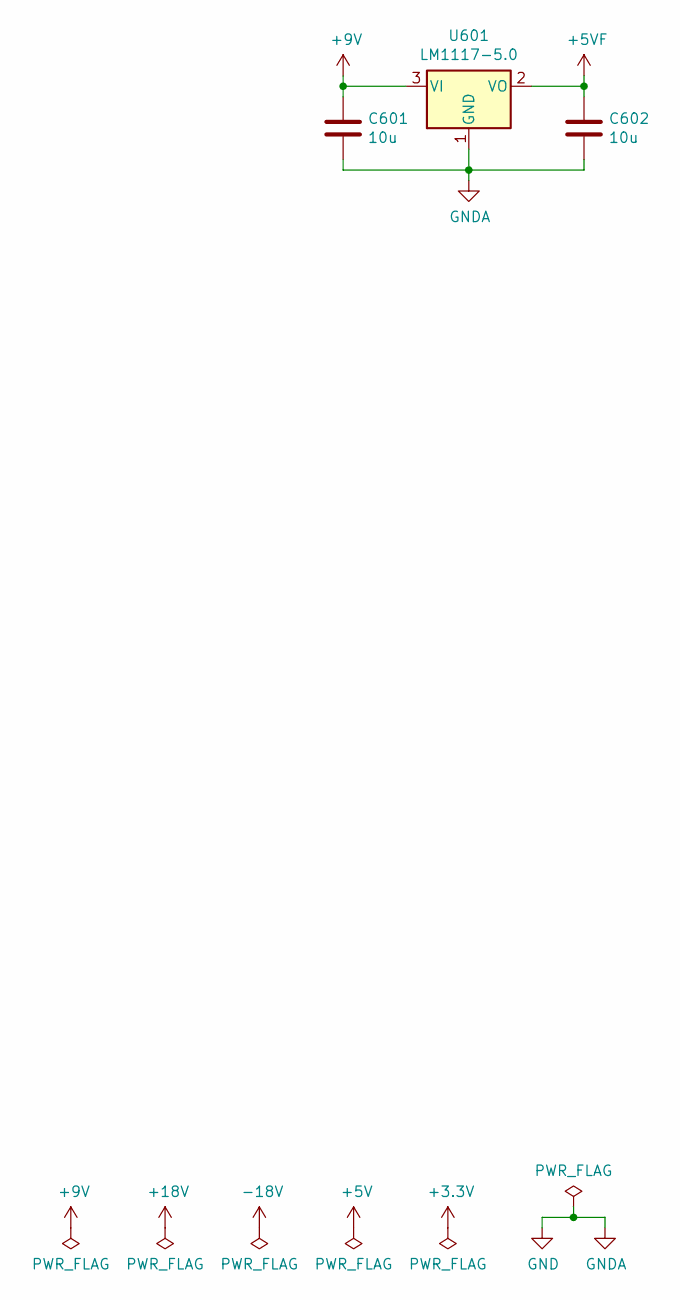
[picture p41: schematic Power.sch]

Parts:
C601, C602: 10u; C_1206_3216Metric_Pad1.33x1.80mm_HandSolder
U601: LM1117-5.0; SOT-223-3_TabPin2

Connections:
+5VF: C602.1, U601.2 (VO); also elsewhere on the board
+9V: C601.1, U601.3 (VI); also elsewhere on the board
GND: C601.2, C602.2, U601.1 (GND); also elsewhere on the board

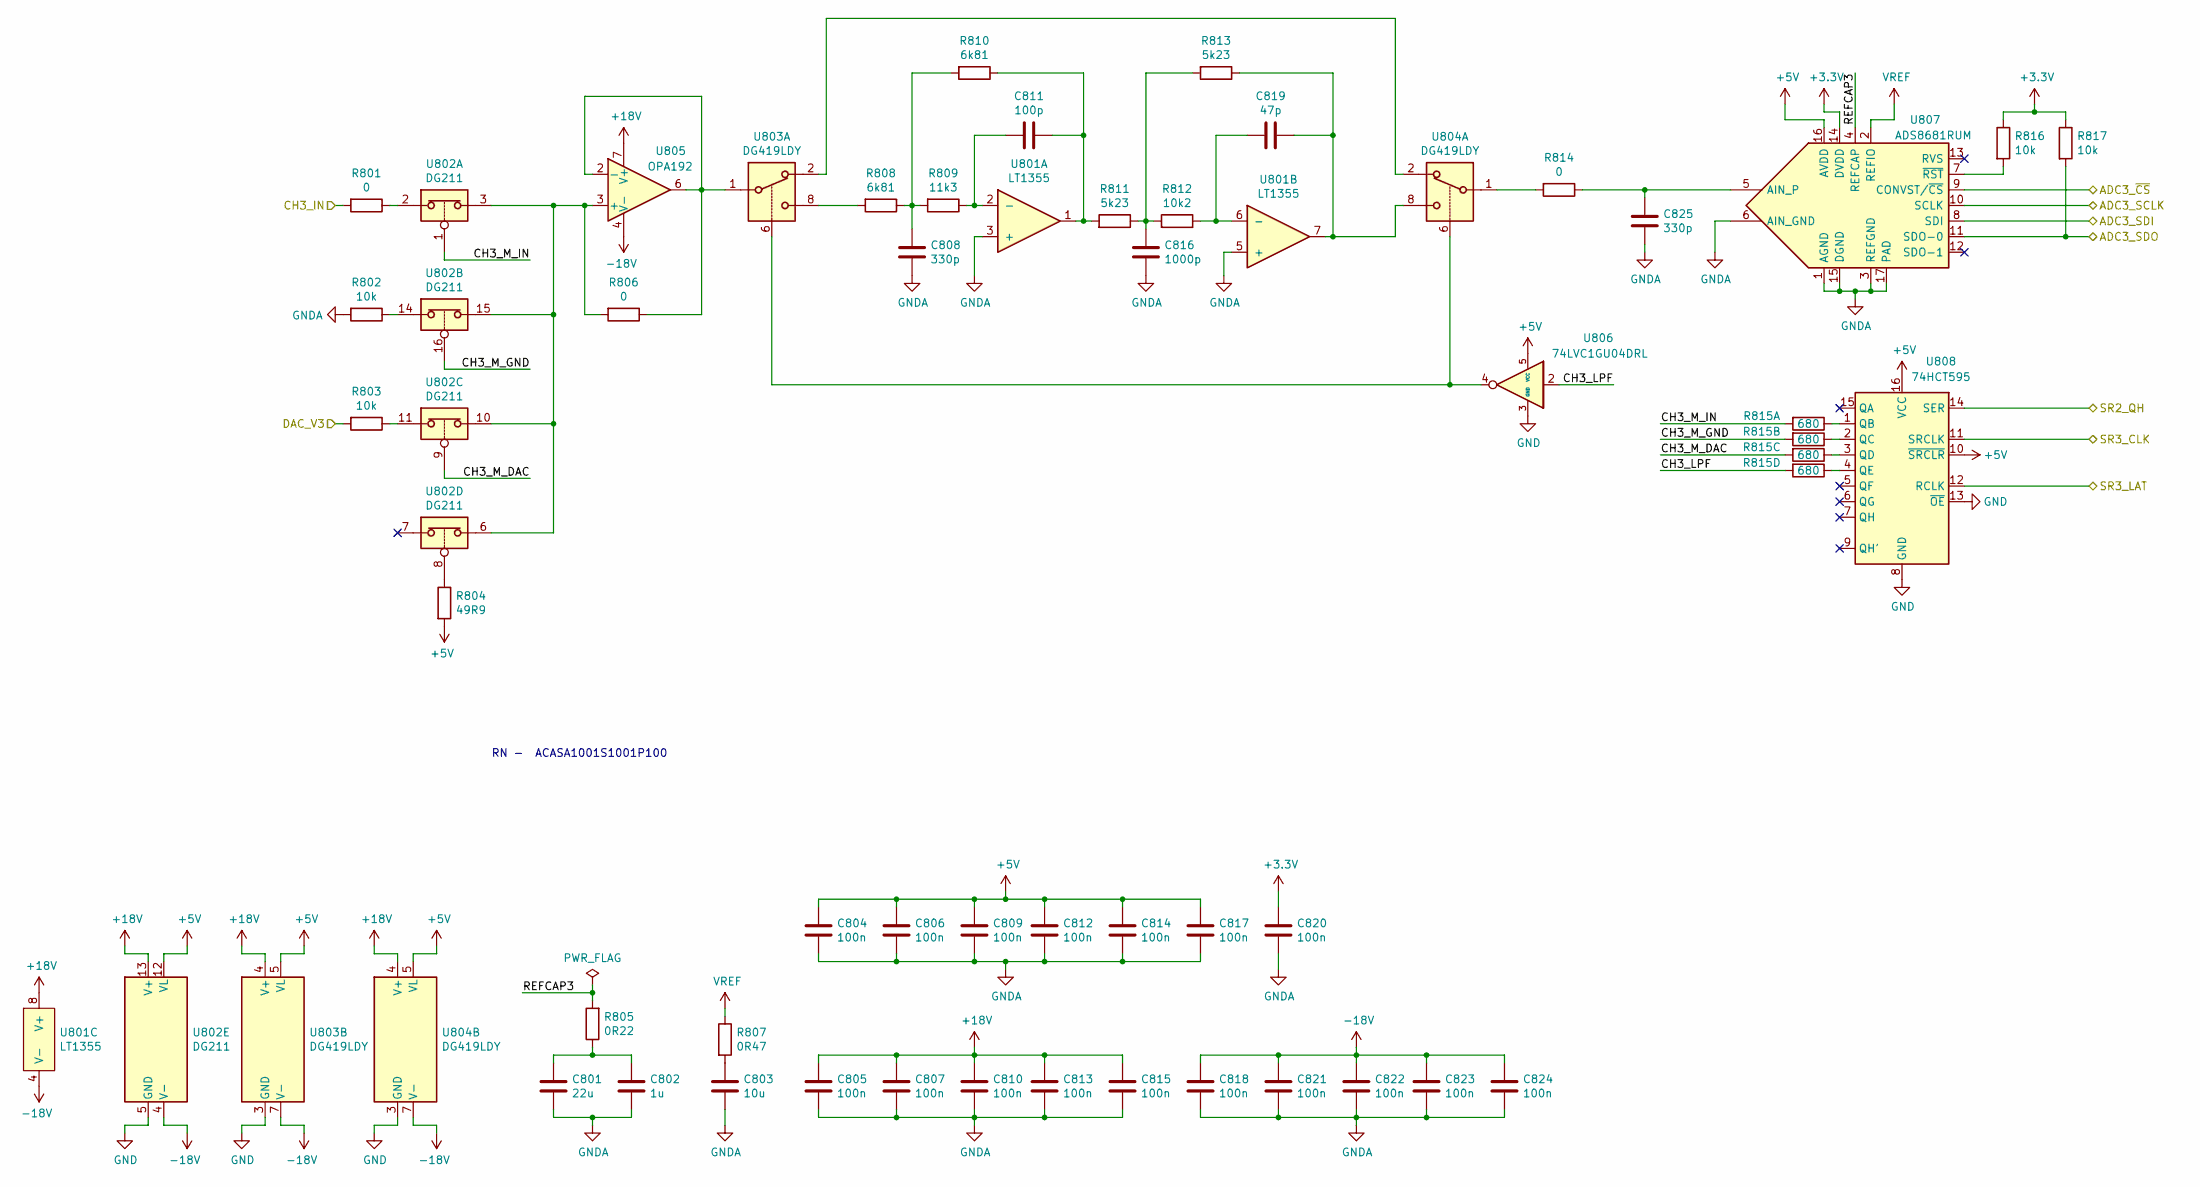
[picture p42: schematic Channel3.sch]

Parts:
C801: 22u; C_0805_2012Metric_Pad1.18x1.45mm_HandSolder
C802: 1u; C_0603_1608Metric_Pad1.08x0.95mm_HandSolder
C803: 10u; C_0805_2012Metric_Pad1.18x1.45mm_HandSolder
C804, C805, C806, C807, C809, C810, C812, C813, C814, C815, C817, C818, C820, C821, C822, C823, C824: 100n; C_0603_1608Metric_Pad1.08x0.95mm_HandSolder
C808, C825: 330p; C_0603_1608Metric_Pad1.08x0.95mm_HandSolder
C811: 100p; C_0603_1608Metric_Pad1.08x0.95mm_HandSolder
C816: 1000p; C_0603_1608Metric_Pad1.08x0.95mm_HandSolder
C819: 47p; C_0603_1608Metric_Pad1.08x0.95mm_HandSolder
R801, R806, R814: 0; R_0603_1608Metric_Pad0.98x0.95mm_HandSolder
R802, R803, R816, R817: 10k; R_0603_1608Metric_Pad0.98x0.95mm_HandSolder
R804: 49R9; R_0603_1608Metric_Pad0.98x0.95mm_HandSolder
R805: 0R22; R_0603_1608Metric_Pad0.98x0.95mm_HandSolder
R807: 0R47; R_0603_1608Metric_Pad0.98x0.95mm_HandSolder
R808, R810: 6k81; R_0603_1608Metric_Pad0.98x0.95mm_HandSolder
R809: 11k3; R_0603_1608Metric_Pad0.98x0.95mm_HandSolder
R811, R813: 5k23; R_0603_1608Metric_Pad0.98x0.95mm_HandSolder
R812: 10k2; R_0603_1608Metric_Pad0.98x0.95mm_HandSolder
R815: 680; R_Array_Convex_4x0603
U801: LT1355; SOIC-8_3.9x4.9mm_P1.27mm
U802: DG211; TSSOP-16_4.4x5mm_P0.65mm
U803, U804: DG419LDY; SOIC-8_3.9x4.9mm_P1.27mm
U805: OPA192; SOIC-8_3.9x4.9mm_P1.27mm
U806: 74LVC1GU04DRL; SOT-553
U807: ADS8681RUM; QFN-16-1EP_4x4mm_P0.65mm_EP2.7x2.7mm
U808: 74HCT595; TSSOP-16_4.4x5mm_P0.65mm

Connections:
+3V3: C820.1, R816.1, R817.1, U807.14 (DVDD); also elsewhere on the board
+5V: C804.1, C806.1, C809.1, C812.1, C814.1, C817.1, R804.2, U802.12 (VL), U803.5 (VL), U804.5 (VL), U806.5 (VCC), U807.16 (AVDD), U808.10 (~SRCLR), U808.16 (VCC); also elsewhere on the board
+18V: C805.1, C807.1, C810.1, C813.1, C815.1, U801.8 (V+), U802.13 (V+), U803.4 (V+), U804.4 (V+), U805.7 (V+); also elsewhere on the board
-18V: C818.1, C821.1, C822.1, C823.1, C824.1, U801.4 (V-), U802.4 (V-), U803.7 (V-), U804.7 (V-), U805.4 (V-); also elsewhere on the board
/CH3 Connector/CH3_IN: R801.2; also elsewhere on the board
/Channel 1/ADC1_SCLK: U807.10 (SCLK); also elsewhere on the board
/Channel 1/ADC1_~CS: U807.9 (CONVST/~CS); also elsewhere on the board
/Channel 2/ADC2_SDO: U807.8 (SDI); also elsewhere on the board
/Channel 2/SR2_QH: U808.14 (SER); also elsewhere on the board
/Channel 3/ADC3_SDO: R817.2, U807.11 (SDO-0); also elsewhere on the board
/Channel 3/CH3_LPF: R815.4, U806.2
/Channel 3/CH3_M_DAC: R815.3, U802.9
/Channel 3/CH3_M_GND: R815.2, U802.16
/Channel 3/CH3_M_IN: R815.1, U802.1
/Channel 3/DAC_V3: R803.2; also elsewhere on the board
/Channel 3/REFCAP3: R805.2, U807.4 (REFCAP)
/MCU/SD_CLK: U808.11 (SRCLK); also elsewhere on the board
/MCU/SD_LAT: U808.12 (RCLK); also elsewhere on the board
GND: C801.2, C802.2, C803.2, C804.2, C805.2, C806.2, C807.2, C808.2, C809.2, C810.2, C812.2, C813.2, C814.2, C815.2, C816.2, C817.2, C818.2, C820.2, C821.2, C822.2, C823.2, C824.2, C825.2, R802.2, U801.3 (+), U801.5 (+), U802.5 (GND), U803.3 (GND), U804.3 (GND), U806.3 (GND), U807.1 (AGND), U807.3 (REFGND), U807.6 (AIN_GND), U807.15 (DGND), U807.17 (PAD), U808.8 (GND), U808.13 (~OE); also elsewhere on the board
unnamed: C801.1, C802.1, R805.1
unnamed: C803.1, R807.2
unnamed: C808.1, R808.1, R809.2, R810.2
unnamed: C811.1, R810.1, R811.2, U801.1
unnamed: C811.2, R809.1, U801.2 (-)
unnamed: C816.1, R811.1, R812.2, R813.2
unnamed: C819.1, R813.1, U801.7, U804.8
unnamed: C819.2, R812.1, U801.6 (-)
unnamed: C825.1, R814.1, U807.5 (AIN_P)
unnamed: R801.1, U802.2
unnamed: R802.1, U802.14
unnamed: R803.1, U802.11
unnamed: R804.1, U802.8
unnamed: R806.1, U803.1, U805.2 (-), U805.6
unnamed: R806.2, U802.3, U802.6, U802.10, U802.15, U805.3 (+)
unnamed: R808.2, U803.8
unnamed: R814.2, U804.1
unnamed: R815.5, U808.4 (QE)
unnamed: R815.6, U808.3 (QD)
unnamed: R815.7, U808.2 (QC)
unnamed: R815.8, U808.1 (QB)
unnamed: R816.2, U807.7 (~RST)
unnamed: U803.2, U804.2
unnamed: U803.6, U804.6, U806.4
VREF: R807.1, U807.2 (REFIO); also elsewhere on the board

Notes on the sheet:
RN - ACASA1001S1001P100

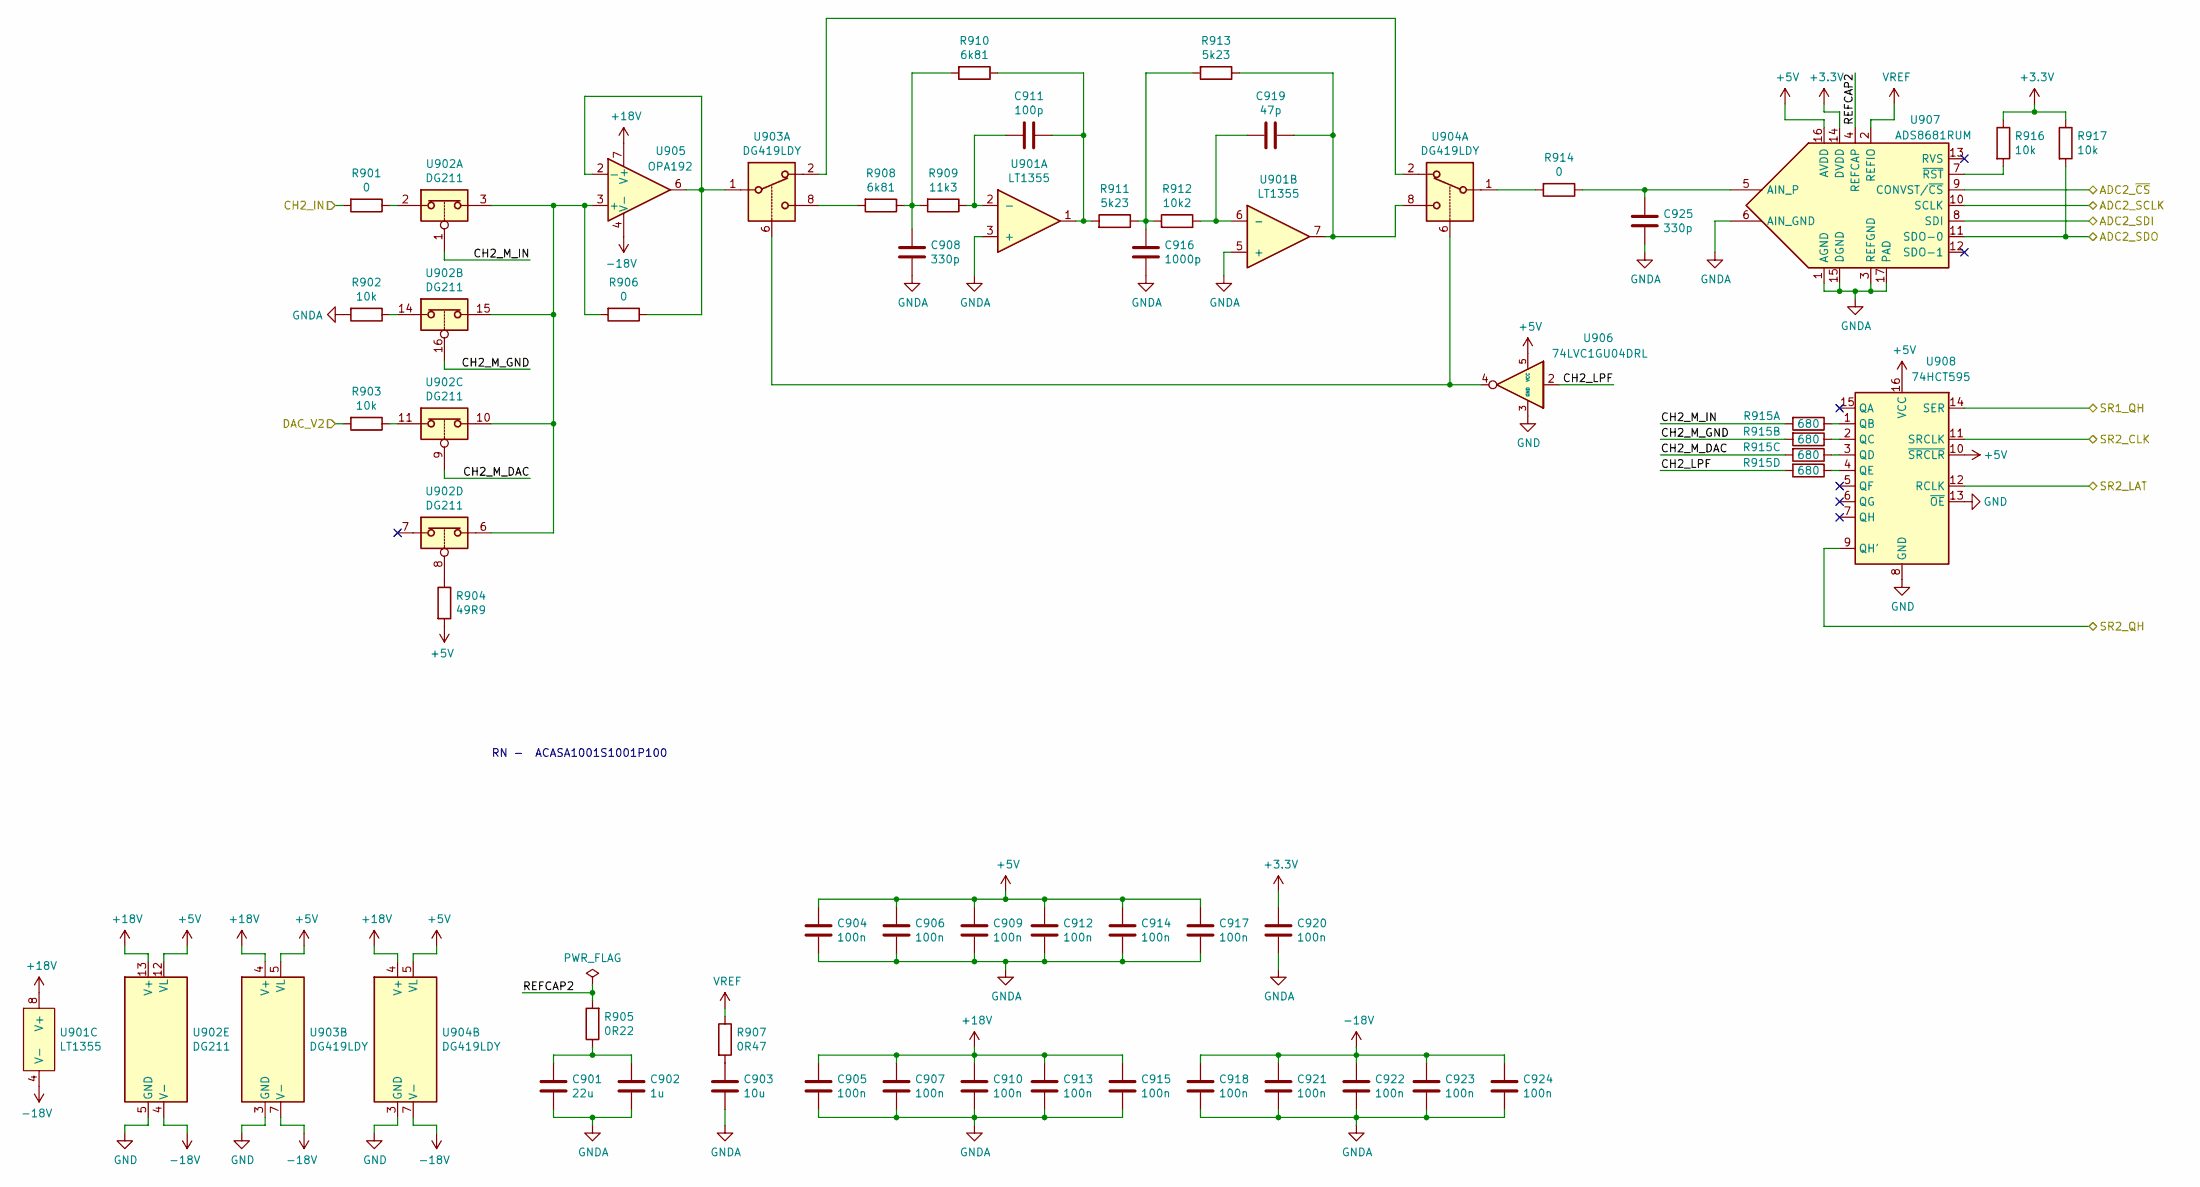
[picture p43: schematic Channel2.sch]

Parts:
C901: 22u; C_0805_2012Metric_Pad1.18x1.45mm_HandSolder
C902: 1u; C_0603_1608Metric_Pad1.08x0.95mm_HandSolder
C903: 10u; C_0805_2012Metric_Pad1.18x1.45mm_HandSolder
C904, C905, C906, C907, C909, C910, C912, C913, C914, C915, C917, C918, C920, C921, C922, C923, C924: 100n; C_0603_1608Metric_Pad1.08x0.95mm_HandSolder
C908, C925: 330p; C_0603_1608Metric_Pad1.08x0.95mm_HandSolder
C911: 100p; C_0603_1608Metric_Pad1.08x0.95mm_HandSolder
C916: 1000p; C_0603_1608Metric_Pad1.08x0.95mm_HandSolder
C919: 47p; C_0603_1608Metric_Pad1.08x0.95mm_HandSolder
R901, R906, R914: 0; R_0603_1608Metric_Pad0.98x0.95mm_HandSolder
R902, R903, R916, R917: 10k; R_0603_1608Metric_Pad0.98x0.95mm_HandSolder
R904: 49R9; R_0603_1608Metric_Pad0.98x0.95mm_HandSolder
R905: 0R22; R_0603_1608Metric_Pad0.98x0.95mm_HandSolder
R907: 0R47; R_0603_1608Metric_Pad0.98x0.95mm_HandSolder
R908, R910: 6k81; R_0603_1608Metric_Pad0.98x0.95mm_HandSolder
R909: 11k3; R_0603_1608Metric_Pad0.98x0.95mm_HandSolder
R911, R913: 5k23; R_0603_1608Metric_Pad0.98x0.95mm_HandSolder
R912: 10k2; R_0603_1608Metric_Pad0.98x0.95mm_HandSolder
R915: 680; R_Array_Convex_4x0603
U901: LT1355; SOIC-8_3.9x4.9mm_P1.27mm
U902: DG211; TSSOP-16_4.4x5mm_P0.65mm
U903, U904: DG419LDY; SOIC-8_3.9x4.9mm_P1.27mm
U905: OPA192; SOIC-8_3.9x4.9mm_P1.27mm
U906: 74LVC1GU04DRL; SOT-553
U907: ADS8681RUM; QFN-16-1EP_4x4mm_P0.65mm_EP2.7x2.7mm
U908: 74HCT595; TSSOP-16_4.4x5mm_P0.65mm

Connections:
+3V3: C920.1, R916.1, R917.1, U907.14 (DVDD); also elsewhere on the board
+5V: C904.1, C906.1, C909.1, C912.1, C914.1, C917.1, R904.2, U902.12 (VL), U903.5 (VL), U904.5 (VL), U906.5 (VCC), U907.16 (AVDD), U908.10 (~SRCLR), U908.16 (VCC); also elsewhere on the board
+18V: C905.1, C907.1, C910.1, C913.1, C915.1, U901.8 (V+), U902.13 (V+), U903.4 (V+), U904.4 (V+), U905.7 (V+); also elsewhere on the board
-18V: C918.1, C921.1, C922.1, C923.1, C924.1, U901.4 (V-), U902.4 (V-), U903.7 (V-), U904.7 (V-), U905.4 (V-); also elsewhere on the board
/CH2 Connector/CH2_IN: R901.2; also elsewhere on the board
/Channel 1/ADC1_SCLK: U907.10 (SCLK); also elsewhere on the board
/Channel 1/ADC1_SDO: U907.8 (SDI); also elsewhere on the board
/Channel 1/ADC1_~CS: U907.9 (CONVST/~CS); also elsewhere on the board
/Channel 1/SR1_QH: U908.14 (SER); also elsewhere on the board
/Channel 2/ADC2_SDO: R917.2, U907.11 (SDO-0); also elsewhere on the board
/Channel 2/CH2_LPF: R915.4, U906.2
/Channel 2/CH2_M_DAC: R915.3, U902.9
/Channel 2/CH2_M_GND: R915.2, U902.16
/Channel 2/CH2_M_IN: R915.1, U902.1
/Channel 2/DAC_V2: R903.2; also elsewhere on the board
/Channel 2/REFCAP2: R905.2, U907.4 (REFCAP)
/Channel 2/SR2_QH: U908.9 (QH'); also elsewhere on the board
/MCU/SD_CLK: U908.11 (SRCLK); also elsewhere on the board
/MCU/SD_LAT: U908.12 (RCLK); also elsewhere on the board
GND: C901.2, C902.2, C903.2, C904.2, C905.2, C906.2, C907.2, C908.2, C909.2, C910.2, C912.2, C913.2, C914.2, C915.2, C916.2, C917.2, C918.2, C920.2, C921.2, C922.2, C923.2, C924.2, C925.2, R902.2, U901.3 (+), U901.5 (+), U902.5 (GND), U903.3 (GND), U904.3 (GND), U906.3 (GND), U907.1 (AGND), U907.3 (REFGND), U907.6 (AIN_GND), U907.15 (DGND), U907.17 (PAD), U908.8 (GND), U908.13 (~OE); also elsewhere on the board
unnamed: C901.1, C902.1, R905.1
unnamed: C903.1, R907.2
unnamed: C908.1, R908.1, R909.2, R910.2
unnamed: C911.1, R910.1, R911.2, U901.1
unnamed: C911.2, R909.1, U901.2 (-)
unnamed: C916.1, R911.1, R912.2, R913.2
unnamed: C919.1, R913.1, U901.7, U904.8
unnamed: C919.2, R912.1, U901.6 (-)
unnamed: C925.1, R914.1, U907.5 (AIN_P)
unnamed: R901.1, U902.2
unnamed: R902.1, U902.14
unnamed: R903.1, U902.11
unnamed: R904.1, U902.8
unnamed: R906.1, U903.1, U905.2 (-), U905.6
unnamed: R906.2, U902.3, U902.6, U902.10, U902.15, U905.3 (+)
unnamed: R908.2, U903.8
unnamed: R914.2, U904.1
unnamed: R915.5, U908.4 (QE)
unnamed: R915.6, U908.3 (QD)
unnamed: R915.7, U908.2 (QC)
unnamed: R915.8, U908.1 (QB)
unnamed: R916.2, U907.7 (~RST)
unnamed: U903.2, U904.2
unnamed: U903.6, U904.6, U906.4
VREF: R907.1, U907.2 (REFIO); also elsewhere on the board

Notes on the sheet:
RN - ACASA1001S1001P100

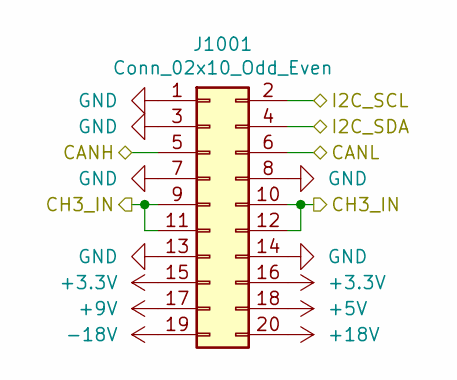
[picture p44: schematic CH3_CONN.sch]

Parts:
J1001: Conn_02x10_Odd_Even; PinSocket_2x10_P2.54mm_Vertical

Connections:
+3V3: J1001.15, J1001.16; also elsewhere on the board
+5V: J1001.18; also elsewhere on the board
+9V: J1001.17; also elsewhere on the board
+18V: J1001.20; also elsewhere on the board
-18V: J1001.19; also elsewhere on the board
/CH1 Connector/CANH: J1001.5; also elsewhere on the board
/CH1 Connector/CANL: J1001.6; also elsewhere on the board
/CH1 Connector/I2C_SCL: J1001.2; also elsewhere on the board
/CH1 Connector/I2C_SDA: J1001.4; also elsewhere on the board
/CH3 Connector/CH3_IN: J1001.9, J1001.10, J1001.11, J1001.12; also elsewhere on the board
GND: J1001.1, J1001.3, J1001.7, J1001.8, J1001.13, J1001.14; also elsewhere on the board

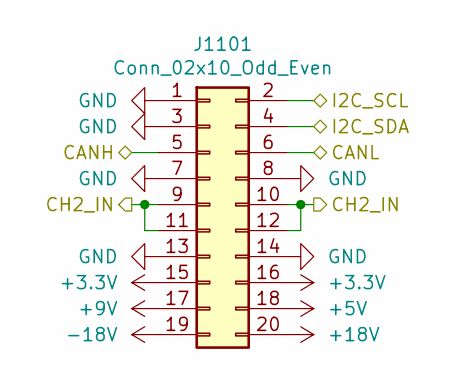
[picture p45: schematic CH2_CONN.sch]

Parts:
J1101: Conn_02x10_Odd_Even; PinSocket_2x10_P2.54mm_Vertical

Connections:
+3V3: J1101.15, J1101.16; also elsewhere on the board
+5V: J1101.18; also elsewhere on the board
+9V: J1101.17; also elsewhere on the board
+18V: J1101.20; also elsewhere on the board
-18V: J1101.19; also elsewhere on the board
/CH1 Connector/CANH: J1101.5; also elsewhere on the board
/CH1 Connector/CANL: J1101.6; also elsewhere on the board
/CH1 Connector/I2C_SCL: J1101.2; also elsewhere on the board
/CH1 Connector/I2C_SDA: J1101.4; also elsewhere on the board
/CH2 Connector/CH2_IN: J1101.9, J1101.10, J1101.11, J1101.12; also elsewhere on the board
GND: J1101.1, J1101.3, J1101.7, J1101.8, J1101.13, J1101.14; also elsewhere on the board

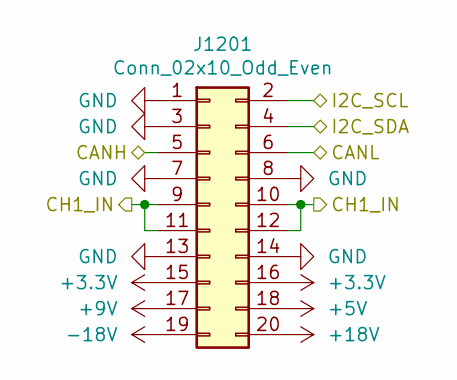
[picture p46: schematic CH1_CONN.sch]

Parts:
J1201: Conn_02x10_Odd_Even; PinSocket_2x10_P2.54mm_Vertical

Connections:
+3V3: J1201.15, J1201.16; also elsewhere on the board
+5V: J1201.18; also elsewhere on the board
+9V: J1201.17; also elsewhere on the board
+18V: J1201.20; also elsewhere on the board
-18V: J1201.19; also elsewhere on the board
/CH1 Connector/CANH: J1201.5; also elsewhere on the board
/CH1 Connector/CANL: J1201.6; also elsewhere on the board
/CH1 Connector/CH1_IN: J1201.9, J1201.10, J1201.11, J1201.12; also elsewhere on the board
/CH1 Connector/I2C_SCL: J1201.2; also elsewhere on the board
/CH1 Connector/I2C_SDA: J1201.4; also elsewhere on the board
GND: J1201.1, J1201.3, J1201.7, J1201.8, J1201.13, J1201.14; also elsewhere on the board
