BehrensG/ETH3CDAQ1/hardware/project/ETH3CDAQ1_MEASURE/ETH3CDAQ1_MEASURE.kicad_pcb

## KiCad design hardware/project/ETH3CDAQ1_MEASURE/ETH3CDAQ1_MEASURE.kicad_pcb (continued)

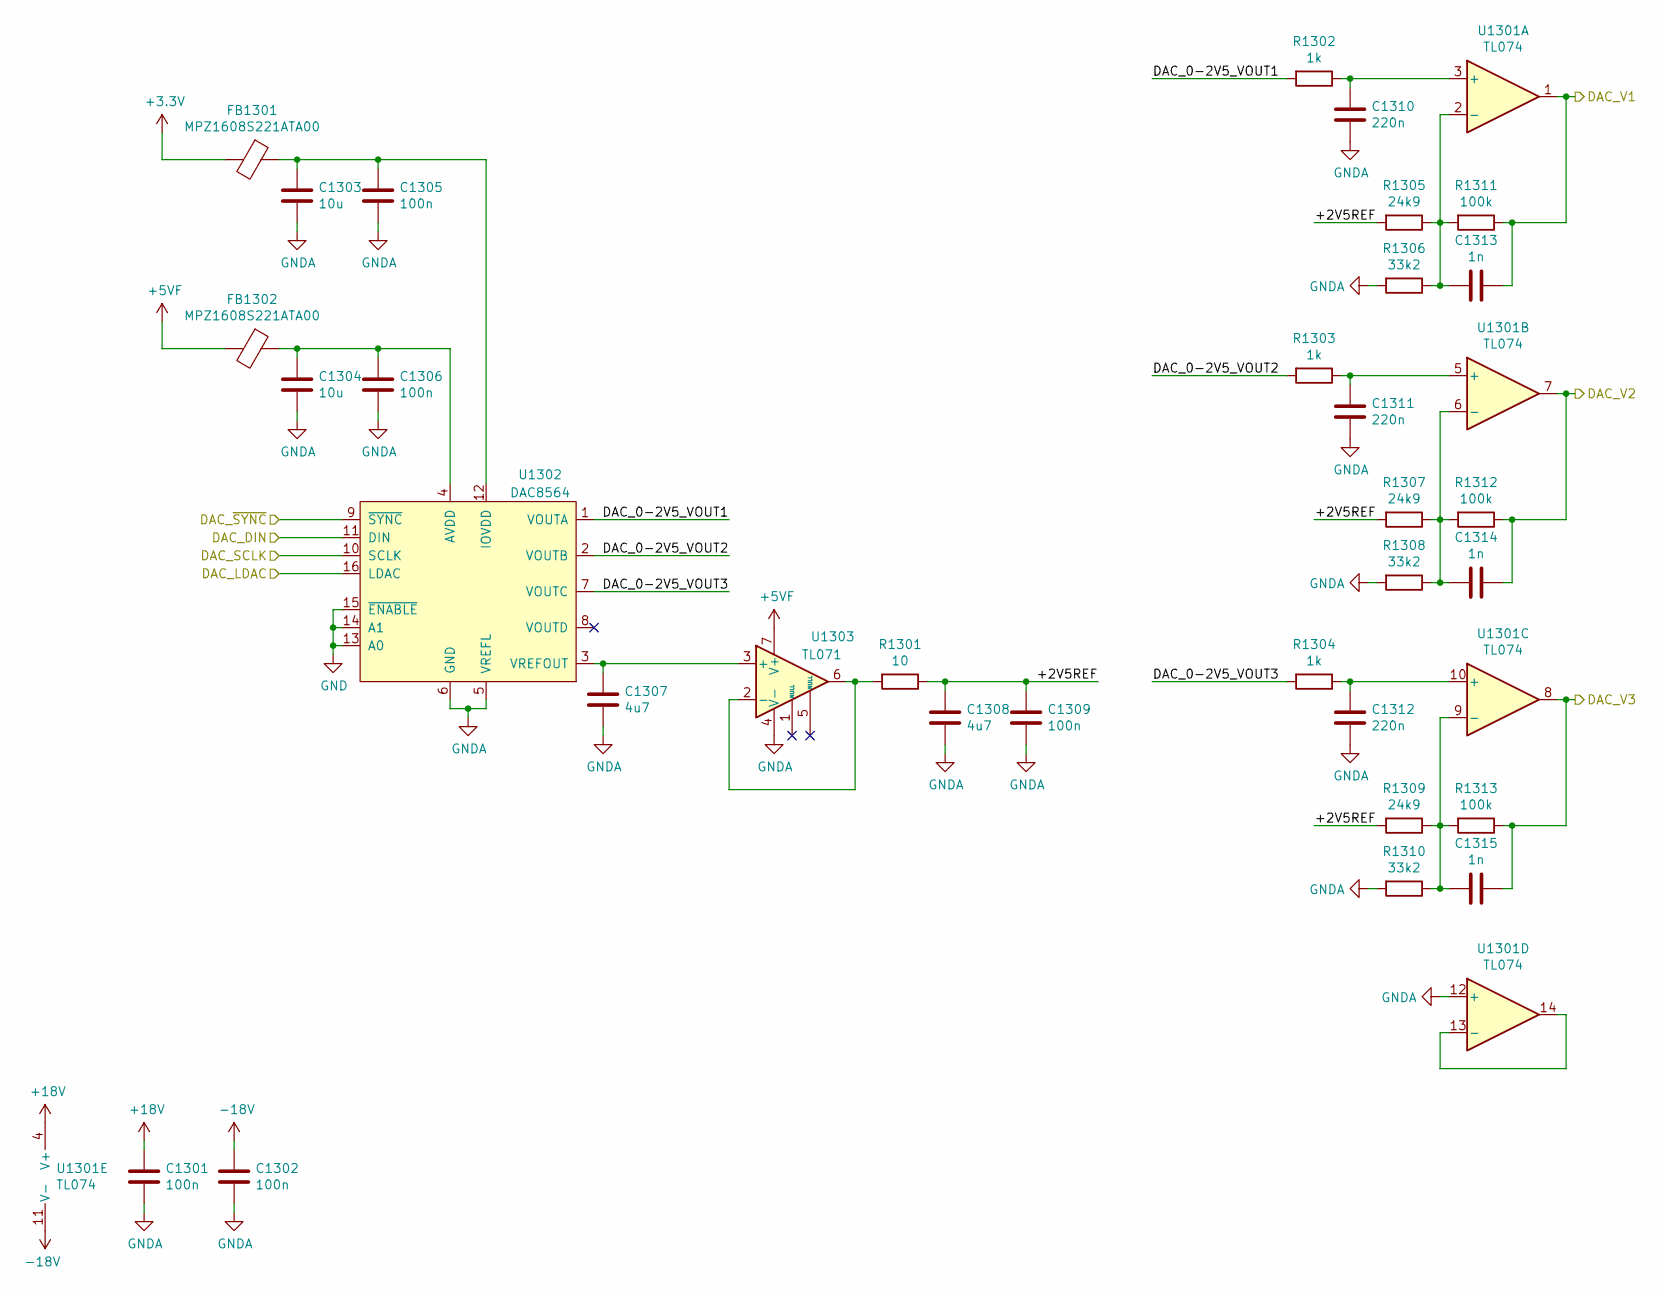
[picture p47: schematic DAC.sch]

Parts:
C1301, C1302, C1305, C1306, C1309: 100n; C_0603_1608Metric_Pad1.08x0.95mm_HandSolder
C1303, C1304: 10u; C_0805_2012Metric_Pad1.18x1.45mm_HandSolder
C1307, C1308: 4u7; C_0805_2012Metric_Pad1.18x1.45mm_HandSolder
C1310, C1311, C1312: 220n; C_0603_1608Metric_Pad1.08x0.95mm_HandSolder
C1313, C1314, C1315: 1n; C_0603_1608Metric_Pad1.08x0.95mm_HandSolder
FB1301, FB1302: MPZ1608S221ATA00; R_0603_1608Metric_Pad0.98x0.95mm_HandSolder
R1301: 10; R_0603_1608Metric_Pad0.98x0.95mm_HandSolder
R1302, R1303, R1304: 1k; R_0603_1608Metric_Pad0.98x0.95mm_HandSolder
R1305, R1307, R1309: 24k9; R_0603_1608Metric_Pad0.98x0.95mm_HandSolder
R1306, R1308, R1310: 33k2; R_0603_1608Metric_Pad0.98x0.95mm_HandSolder
R1311, R1312, R1313: 100k; R_0603_1608Metric_Pad0.98x0.95mm_HandSolder
U1301: TL074; SOIC-14_3.9x8.7mm_P1.27mm
U1302: DAC8564; TSSOP-16_4.4x5mm_P0.65mm
U1303: TL071; SOIC-8_3.9x4.9mm_P1.27mm

Connections:
+3V3: FB1301.2; also elsewhere on the board
+5VF: FB1302.2, U1303.7 (V+); also elsewhere on the board
+18V: C1301.1, U1301.4 (V+); also elsewhere on the board
-18V: C1302.1, U1301.11 (V-); also elsewhere on the board
/Channel 1/DAC_V1: C1313.1, R1311.1, U1301.1; also elsewhere on the board
/Channel 2/DAC_V2: C1314.1, R1312.1, U1301.7; also elsewhere on the board
/Channel 3/DAC_V3: C1315.1, R1313.1, U1301.8; also elsewhere on the board
/DAC/+2V5REF: C1308.1, C1309.1, R1301.1, R1305.2, R1307.2, R1309.2
/DAC/DAC_0-2V5_VOUT1: R1302.2, U1302.1 (VOUTA)
/DAC/DAC_0-2V5_VOUT2: R1303.2, U1302.2 (VOUTB)
/DAC/DAC_0-2V5_VOUT3: R1304.2, U1302.7 (VOUTC)
/DAC/DAC_DIN: U1302.11 (DIN); also elsewhere on the board
/DAC/DAC_LDAC: U1302.16 (LDAC); also elsewhere on the board
/DAC/DAC_SCLK: U1302.10 (SCLK); also elsewhere on the board
/DAC/DAC_~SYNC: U1302.9 (~SYNC); also elsewhere on the board
GND: C1301.2, C1302.2, C1303.2, C1304.2, C1305.2, C1306.2, C1307.2, C1308.2, C1309.2, C1310.2, C1311.2, C1312.2, R1306.2, R1308.2, R1310.2, U1301.12 (+), U1302.5 (VREFL), U1302.6 (GND), U1302.13 (A0), U1302.14 (A1), U1302.15 (~ENABLE), U1303.4 (V-); also elsewhere on the board
unnamed: C1303.1, C1305.1, FB1301.1, U1302.12 (IOVDD)
unnamed: C1304.1, C1306.1, FB1302.1, U1302.4 (AVDD)
unnamed: C1307.1, U1302.3 (VREFOUT), U1303.3 (+)
unnamed: C1310.1, R1302.1, U1301.3 (+)
unnamed: C1311.1, R1303.1, U1301.5 (+)
unnamed: C1312.1, R1304.1, U1301.10 (+)
unnamed: C1313.2, R1305.1, R1306.1, R1311.2, U1301.2 (-)
unnamed: C1314.2, R1307.1, R1308.1, R1312.2, U1301.6 (-)
unnamed: C1315.2, R1309.1, R1310.1, R1313.2, U1301.9 (-)
unnamed: R1301.2, U1303.2 (-), U1303.6
unnamed: U1301.13 (-), U1301.14

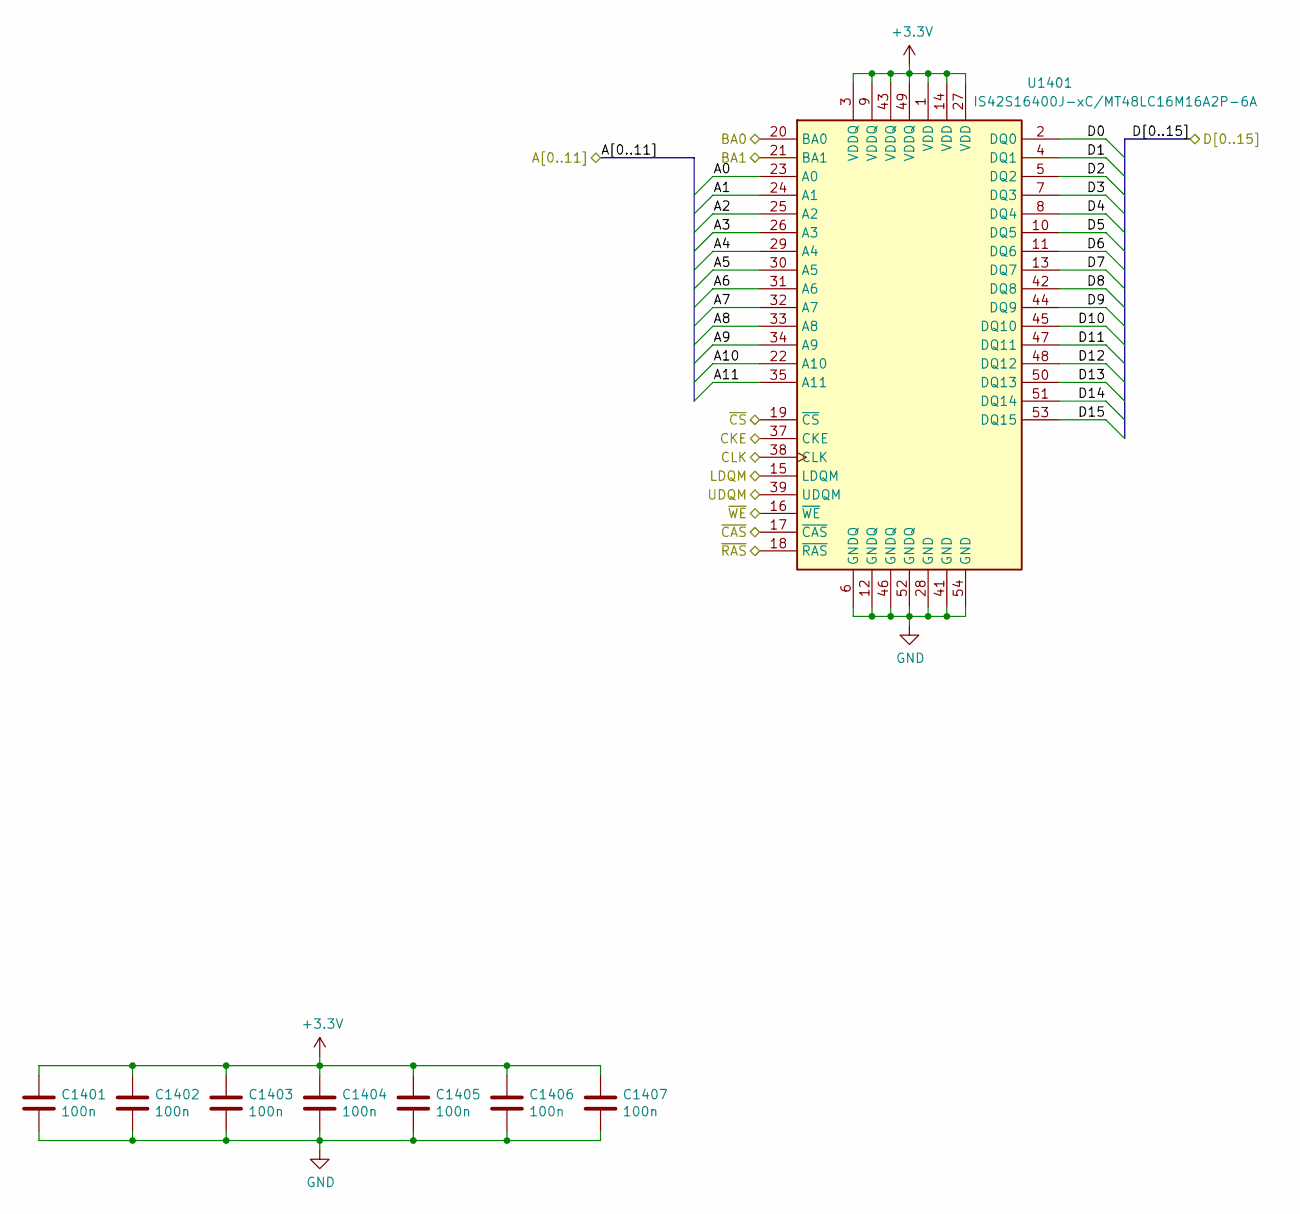
[picture p48: schematic SDRAM.sch]

Parts:
C1401, C1402, C1403, C1404, C1405, C1406, C1407: 100n; C_0603_1608Metric_Pad1.08x0.95mm_HandSolder
U1401: IS42S16400J-xC/MT48LC16M16A2P-6A; TSSOP-54

Connections:
+3V3: C1401.1, C1402.1, C1403.1, C1404.1, C1405.1, C1406.1, C1407.1, U1401.1 (VDD), U1401.3 (VDDQ), U1401.9 (VDDQ), U1401.14 (VDD), U1401.27 (VDD), U1401.43 (VDDQ), U1401.49 (VDDQ); also elsewhere on the board
/MCU/A0: U1401.23 (A0); also elsewhere on the board
/MCU/A1: U1401.24 (A1); also elsewhere on the board
/MCU/A2: U1401.25 (A2); also elsewhere on the board
/MCU/A3: U1401.26 (A3); also elsewhere on the board
/MCU/A4: U1401.29 (A4); also elsewhere on the board
/MCU/A5: U1401.30 (A5); also elsewhere on the board
/MCU/A6: U1401.31 (A6); also elsewhere on the board
/MCU/A7: U1401.32 (A7); also elsewhere on the board
/MCU/A8: U1401.33 (A8); also elsewhere on the board
/MCU/A9: U1401.34 (A9); also elsewhere on the board
/MCU/A10: U1401.22 (A10); also elsewhere on the board
/MCU/A11: U1401.35 (A11); also elsewhere on the board
/MCU/BA0: U1401.20 (BA0); also elsewhere on the board
/MCU/BA1: U1401.21 (BA1); also elsewhere on the board
/MCU/CKE: U1401.37 (CKE); also elsewhere on the board
/MCU/CLK: U1401.38 (CLK); also elsewhere on the board
/MCU/D0: U1401.2 (DQ0); also elsewhere on the board
/MCU/D1: U1401.4 (DQ1); also elsewhere on the board
/MCU/D2: U1401.5 (DQ2); also elsewhere on the board
/MCU/D3: U1401.7 (DQ3); also elsewhere on the board
/MCU/D4: U1401.8 (DQ4); also elsewhere on the board
/MCU/D5: U1401.10 (DQ5); also elsewhere on the board
/MCU/D6: U1401.11 (DQ6); also elsewhere on the board
/MCU/D7: U1401.13 (DQ7); also elsewhere on the board
/MCU/D8: U1401.42 (DQ8); also elsewhere on the board
/MCU/D9: U1401.44 (DQ9); also elsewhere on the board
/MCU/D10: U1401.45 (DQ10); also elsewhere on the board
/MCU/D11: U1401.47 (DQ11); also elsewhere on the board
/MCU/D12: U1401.48 (DQ12); also elsewhere on the board
/MCU/D13: U1401.50 (DQ13); also elsewhere on the board
/MCU/D14: U1401.51 (DQ14); also elsewhere on the board
/MCU/D15: U1401.53 (DQ15); also elsewhere on the board
/MCU/LDQM: U1401.15 (LDQM); also elsewhere on the board
/MCU/UDQM: U1401.39 (UDQM); also elsewhere on the board
/MCU/~CAS: U1401.17 (~CAS); also elsewhere on the board
/MCU/~CS: U1401.19 (~CS); also elsewhere on the board
/MCU/~RAS: U1401.18 (~RAS); also elsewhere on the board
/MCU/~WE: U1401.16 (~WE); also elsewhere on the board
GND: C1401.2, C1402.2, C1403.2, C1404.2, C1405.2, C1406.2, C1407.2, U1401.6 (GNDQ), U1401.12 (GNDQ), U1401.28 (GND), U1401.41 (GND), U1401.46 (GNDQ), U1401.52 (GNDQ), U1401.54 (GND); also elsewhere on the board

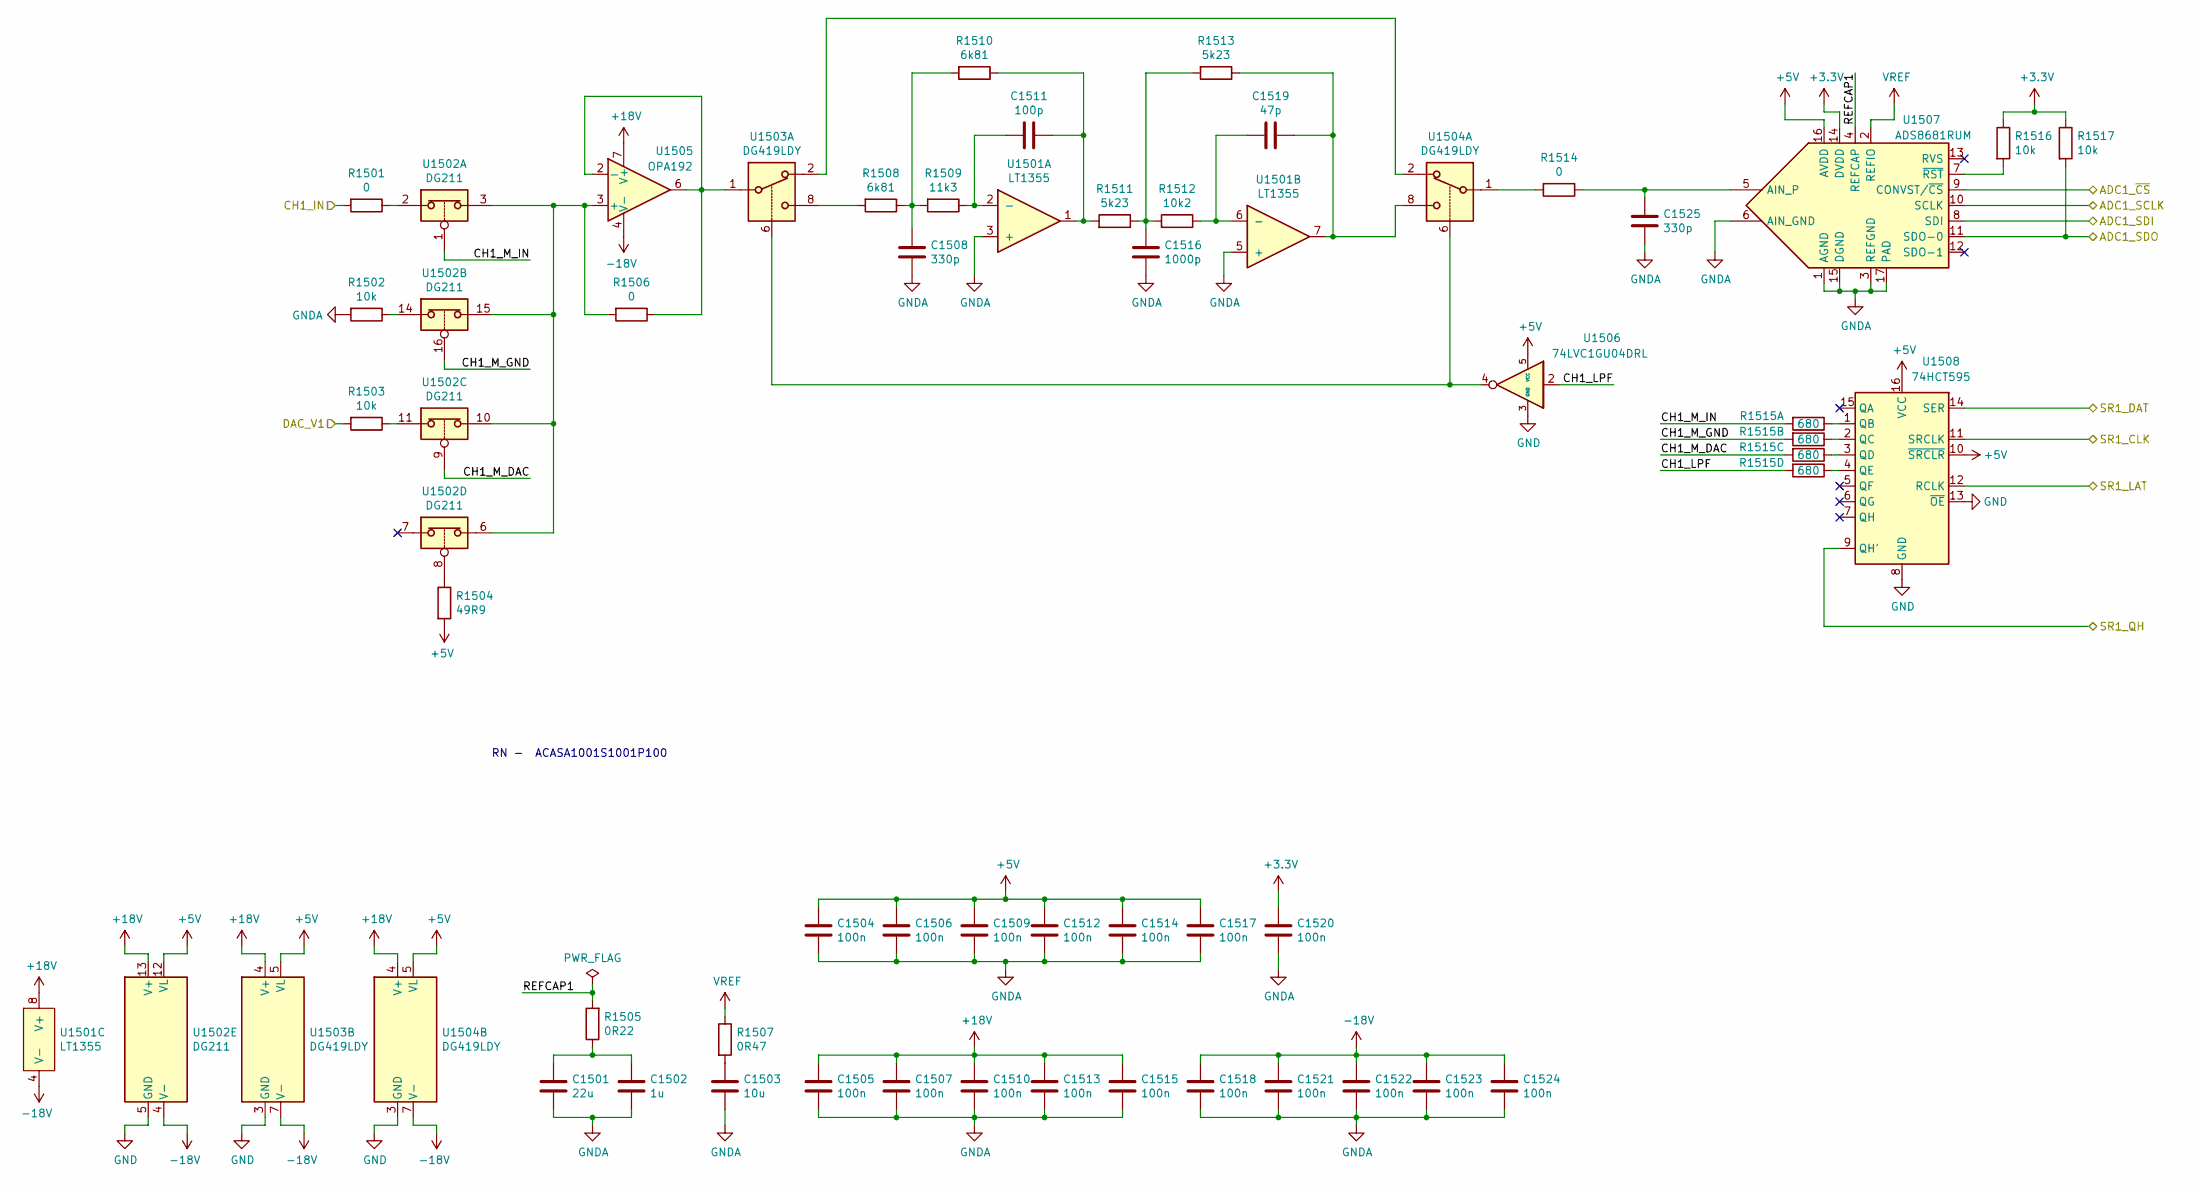
[picture p49: schematic Channel1.sch]

Parts:
C1501: 22u; C_0805_2012Metric_Pad1.18x1.45mm_HandSolder
C1502: 1u; C_0603_1608Metric_Pad1.08x0.95mm_HandSolder
C1503: 10u; C_0805_2012Metric_Pad1.18x1.45mm_HandSolder
C1504, C1505, C1506, C1507, C1509, C1510, C1512, C1513, C1514, C1515, C1517, C1518, C1520, C1521, C1522, C1523, C1524: 100n; C_0603_1608Metric_Pad1.08x0.95mm_HandSolder
C1508, C1525: 330p; C_0603_1608Metric_Pad1.08x0.95mm_HandSolder
C1511: 100p; C_0603_1608Metric_Pad1.08x0.95mm_HandSolder
C1516: 1000p; C_0603_1608Metric_Pad1.08x0.95mm_HandSolder
C1519: 47p; C_0603_1608Metric_Pad1.08x0.95mm_HandSolder
R1501, R1506, R1514: 0; R_0603_1608Metric_Pad0.98x0.95mm_HandSolder
R1502, R1503, R1516, R1517: 10k; R_0603_1608Metric_Pad0.98x0.95mm_HandSolder
R1504: 49R9; R_0603_1608Metric_Pad0.98x0.95mm_HandSolder
R1505: 0R22; R_0603_1608Metric_Pad0.98x0.95mm_HandSolder
R1507: 0R47; R_0603_1608Metric_Pad0.98x0.95mm_HandSolder
R1508, R1510: 6k81; R_0603_1608Metric_Pad0.98x0.95mm_HandSolder
R1509: 11k3; R_0603_1608Metric_Pad0.98x0.95mm_HandSolder
R1511, R1513: 5k23; R_0603_1608Metric_Pad0.98x0.95mm_HandSolder
R1512: 10k2; R_0603_1608Metric_Pad0.98x0.95mm_HandSolder
R1515: 680; R_Array_Convex_4x0603
U1501: LT1355; SOIC-8_3.9x4.9mm_P1.27mm
U1502: DG211; TSSOP-16_4.4x5mm_P0.65mm
U1503, U1504: DG419LDY; SOIC-8_3.9x4.9mm_P1.27mm
U1505: OPA192; SOIC-8_3.9x4.9mm_P1.27mm
U1506: 74LVC1GU04DRL; SOT-553
U1507: ADS8681RUM; QFN-16-1EP_4x4mm_P0.65mm_EP2.7x2.7mm
U1508: 74HCT595; TSSOP-16_4.4x5mm_P0.65mm

Connections:
+3V3: C1520.1, R1516.1, R1517.1, U1507.14 (DVDD); also elsewhere on the board
+5V: C1504.1, C1506.1, C1509.1, C1512.1, C1514.1, C1517.1, R1504.2, U1502.12 (VL), U1503.5 (VL), U1504.5 (VL), U1506.5 (VCC), U1507.16 (AVDD), U1508.10 (~SRCLR), U1508.16 (VCC); also elsewhere on the board
+18V: C1505.1, C1507.1, C1510.1, C1513.1, C1515.1, U1501.8 (V+), U1502.13 (V+), U1503.4 (V+), U1504.4 (V+), U1505.7 (V+); also elsewhere on the board
-18V: C1518.1, C1521.1, C1522.1, C1523.1, C1524.1, U1501.4 (V-), U1502.4 (V-), U1503.7 (V-), U1504.7 (V-), U1505.4 (V-); also elsewhere on the board
/CH1 Connector/CH1_IN: R1501.2; also elsewhere on the board
/Channel 1/ADC1_SCLK: U1507.10 (SCLK); also elsewhere on the board
/Channel 1/ADC1_SDI: U1507.8 (SDI); also elsewhere on the board
/Channel 1/ADC1_SDO: R1517.2, U1507.11 (SDO-0); also elsewhere on the board
/Channel 1/ADC1_~CS: U1507.9 (CONVST/~CS); also elsewhere on the board
/Channel 1/CH1_LPF: R1515.4, U1506.2
/Channel 1/CH1_M_DAC: R1515.3, U1502.9
/Channel 1/CH1_M_GND: R1515.2, U1502.16
/Channel 1/CH1_M_IN: R1515.1, U1502.1
/Channel 1/DAC_V1: R1503.2; also elsewhere on the board
/Channel 1/REFCAP1: R1505.2, U1507.4 (REFCAP)
/Channel 1/SR1_QH: U1508.9 (QH'); also elsewhere on the board
/MCU/SD_CLK: U1508.11 (SRCLK); also elsewhere on the board
/MCU/SD_DAT: U1508.14 (SER); also elsewhere on the board
/MCU/SD_LAT: U1508.12 (RCLK); also elsewhere on the board
GND: C1501.2, C1502.2, C1503.2, C1504.2, C1505.2, C1506.2, C1507.2, C1508.2, C1509.2, C1510.2, C1512.2, C1513.2, C1514.2, C1515.2, C1516.2, C1517.2, C1518.2, C1520.2, C1521.2, C1522.2, C1523.2, C1524.2, C1525.2, R1502.2, U1501.3 (+), U1501.5 (+), U1502.5 (GND), U1503.3 (GND), U1504.3 (GND), U1506.3 (GND), U1507.1 (AGND), U1507.3 (REFGND), U1507.6 (AIN_GND), U1507.15 (DGND), U1507.17 (PAD), U1508.8 (GND), U1508.13 (~OE); also elsewhere on the board
unnamed: C1501.1, C1502.1, R1505.1
unnamed: C1503.1, R1507.2
unnamed: C1508.1, R1508.1, R1509.2, R1510.2
unnamed: C1511.1, R1510.1, R1511.2, U1501.1
unnamed: C1511.2, R1509.1, U1501.2 (-)
unnamed: C1516.1, R1511.1, R1512.2, R1513.2
unnamed: C1519.1, R1513.1, U1501.7, U1504.8
unnamed: C1519.2, R1512.1, U1501.6 (-)
unnamed: C1525.1, R1514.1, U1507.5 (AIN_P)
unnamed: R1501.1, U1502.2
unnamed: R1502.1, U1502.14
unnamed: R1503.1, U1502.11
unnamed: R1504.1, U1502.8
unnamed: R1506.1, U1503.1, U1505.2 (-), U1505.6
unnamed: R1506.2, U1502.3, U1502.6, U1502.10, U1502.15, U1505.3 (+)
unnamed: R1508.2, U1503.8
unnamed: R1514.2, U1504.1
unnamed: R1515.5, U1508.4 (QE)
unnamed: R1515.6, U1508.3 (QD)
unnamed: R1515.7, U1508.2 (QC)
unnamed: R1515.8, U1508.1 (QB)
unnamed: R1516.2, U1507.7 (~RST)
unnamed: U1503.2, U1504.2
unnamed: U1503.6, U1504.6, U1506.4
VREF: R1507.1, U1507.2 (REFIO); also elsewhere on the board

Notes on the sheet:
RN - ACASA1001S1001P100

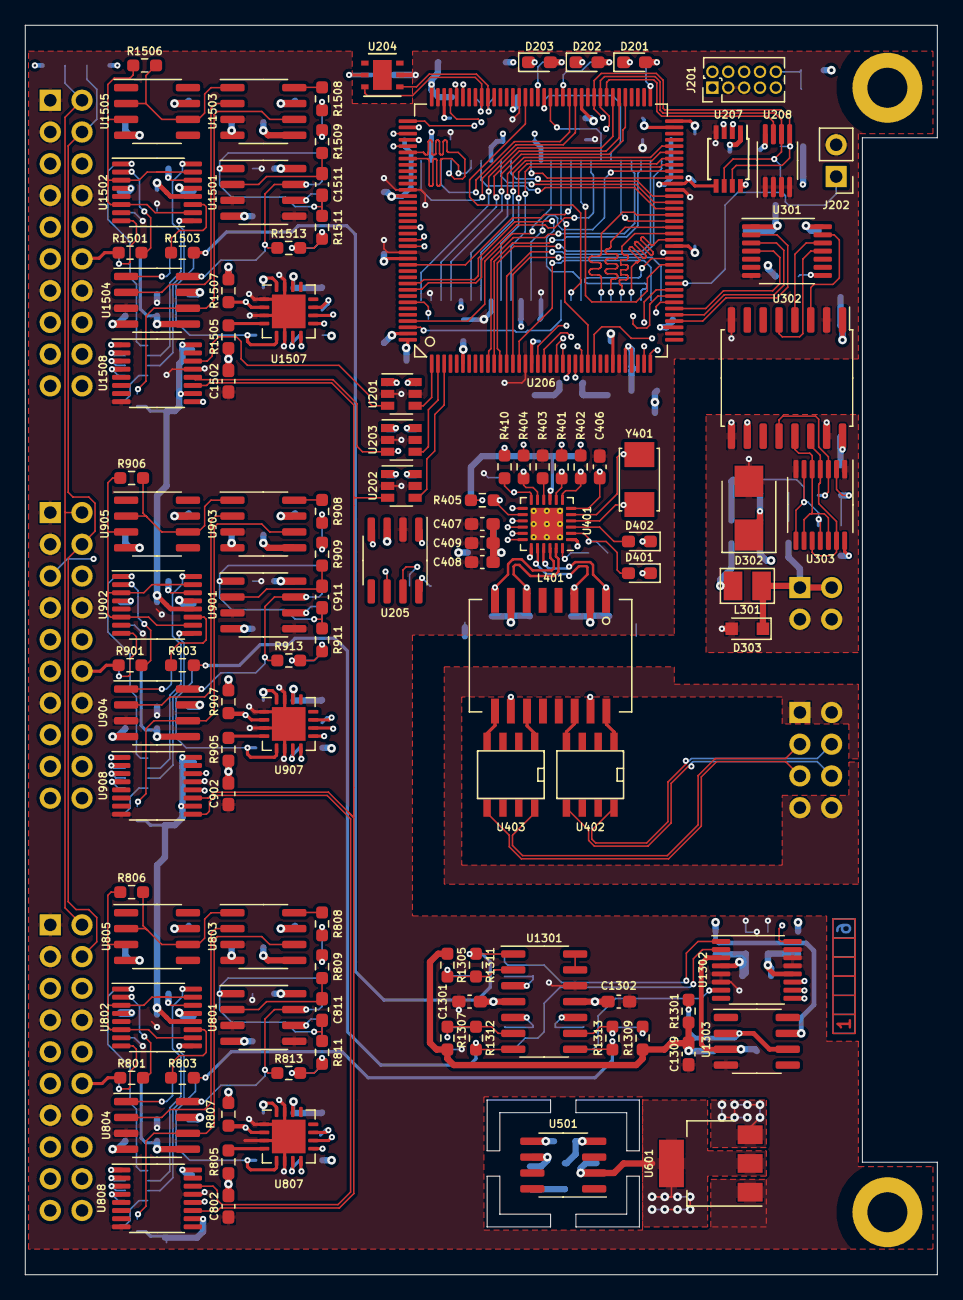
[picture p50: board ETH3CDAQ1_MEASURE.kicad_pcb from above]

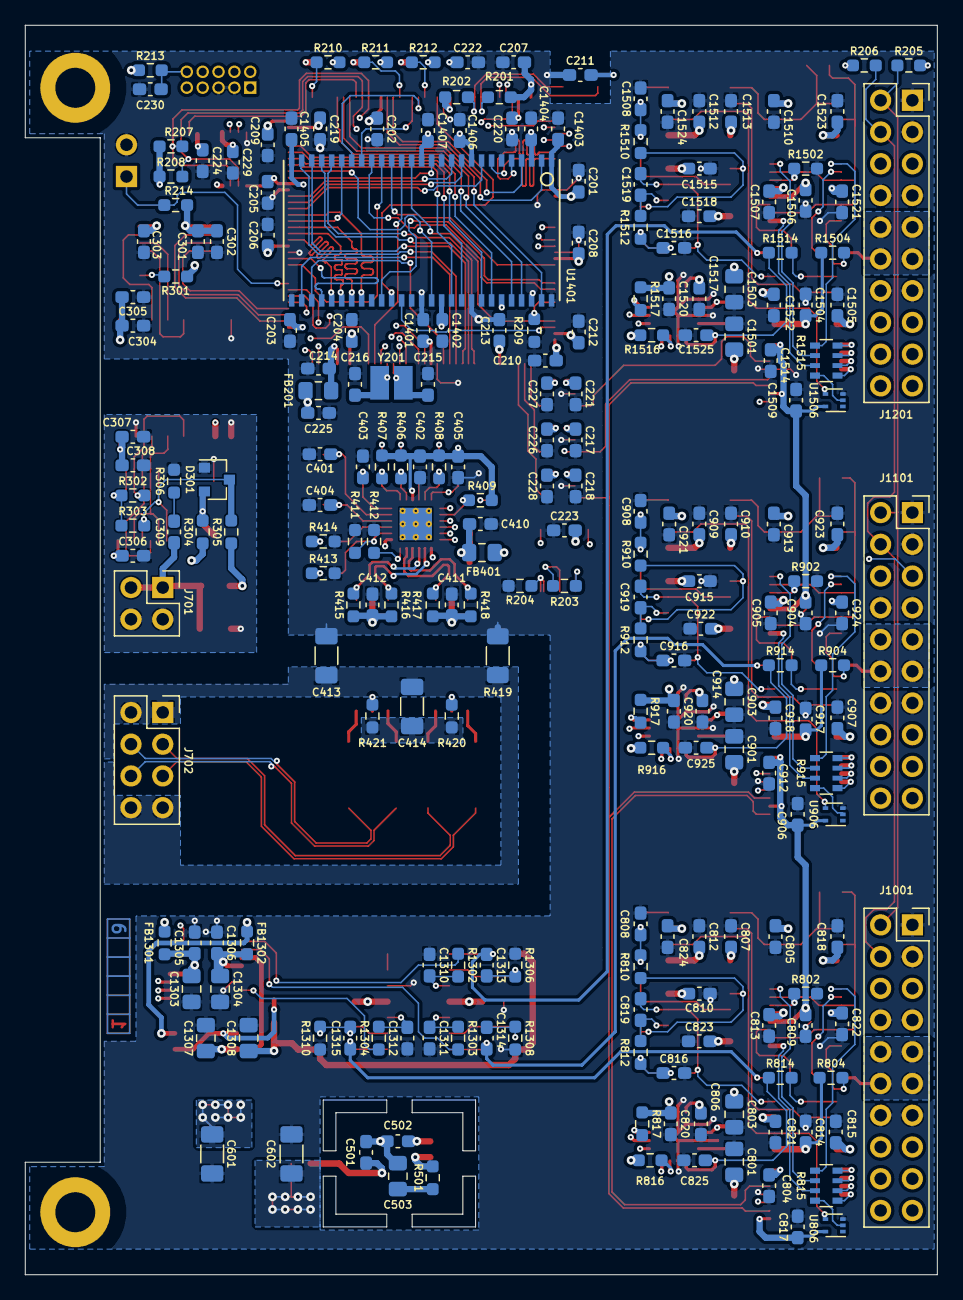
[picture p51: board ETH3CDAQ1_MEASURE.kicad_pcb from below]

Board: 6 copper layers, 73.0 x 100.0 mm, 330 parts (223 on the bottom side), 259 nets.

Other parts of the board:
J701: Conn_02x02_Odd_Even; PinSocket_2x02_P2.54mm_Vertical
J702: Conn_02x04_Odd_Even; PinSocket_2x04_P2.54mm_Vertical

Their connections:
/Connector 1/EXT_TRIG: J701.1, J701.2; also elsewhere on the board
/Connector 1/RX+: J702.3; also elsewhere on the board
/Connector 1/RX-: J702.5; also elsewhere on the board
/Connector 1/TX+: J702.4; also elsewhere on the board
/Connector 1/TX-: J702.6; also elsewhere on the board
Earth: J702.1, J702.2, J702.7, J702.8; also elsewhere on the board
GND_TRIG: J701.3, J701.4; also elsewhere on the board
