BehrensG/ETH3CDAQ1/hardware/project/ETH3CDAQ1_CURRENT_ISO_T2/ETH3CDAQ1_CURRENT_ISO_T2.kicad_pcb

## KiCad design hardware/project/ETH3CDAQ1_CURRENT_ISO_T2/ETH3CDAQ1_CURRENT_ISO_T2.kicad_pcb (2020-12-06)

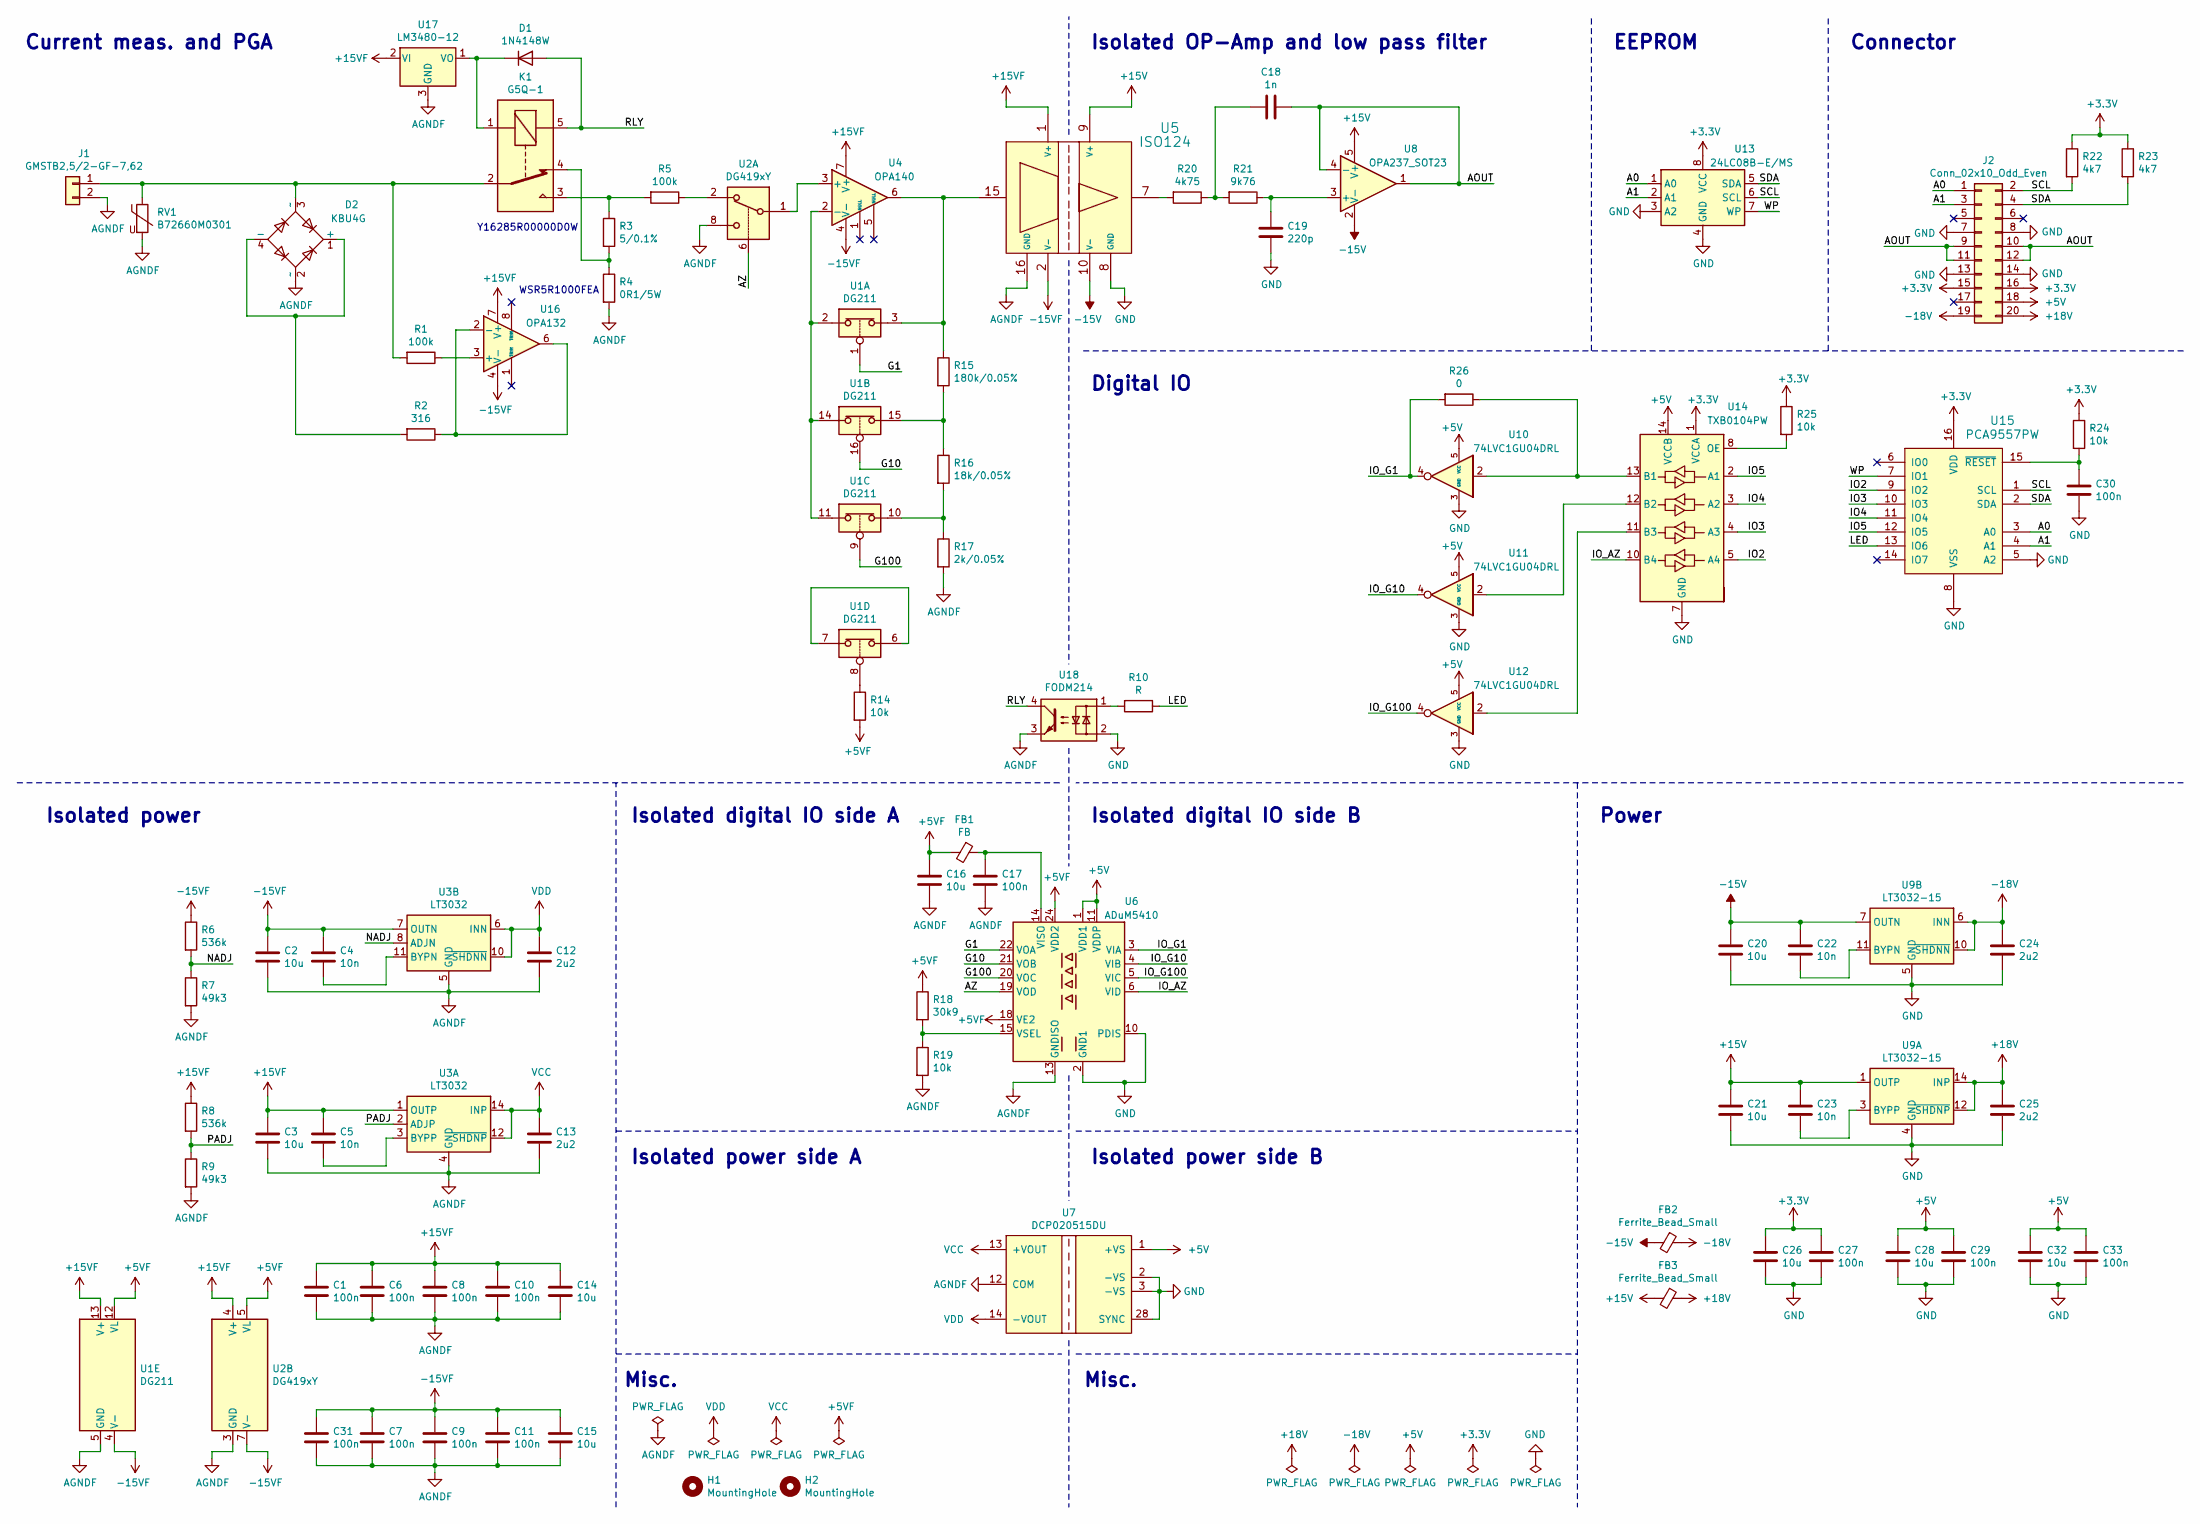
[picture p52: schematic ETH3CDAQ1_CURRENT_ISO_T2.sch]

Parts:
C1, C6, C7, C8, C9, C10, C11, C17, C27, C29, C30, C31, C33: 100n; C_0603_1608Metric_Pad1.08x0.95mm_HandSolder
C2, C3, C14, C15, C16, C20, C21, C26, C28, C32: 10u; C_0603_1608Metric_Pad1.08x0.95mm_HandSolder
C4, C5, C22, C23: 10n; C_0603_1608Metric_Pad1.08x0.95mm_HandSolder
C12, C13, C24, C25: 2u2; C_0603_1608Metric_Pad1.08x0.95mm_HandSolder
C18: 1n; C_0603_1608Metric_Pad1.08x0.95mm_HandSolder
C19: 220p; C_0603_1608Metric_Pad1.08x0.95mm_HandSolder
D1: 1N4148W; D_SOD-123
D2: KBU4G; Diode_Bridge_Vishay_KBU
FB1: FB; R_0603_1608Metric_Pad0.98x0.95mm_HandSolder
FB2, FB3: Ferrite_Bead_Small; R_0603_1608Metric_Pad0.98x0.95mm_HandSolder
H1, H2: MountingHole; MountingHole_2.7mm_M2.5_DIN965_Pad
J1: GMSTB2,5/2-GF-7,62; PhoenixContact_GMSTB_2,5_2-GF-7,62_1x02_P7.62mm_Horizontal_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
J2: Conn_02x10_Odd_Even; PinSocket_2x10_P2.54mm_Vertical
K1: G5Q-1; Relay_SPDT_Omron-G5Q-1
R1, R5: 100k; R_0603_1608Metric_Pad0.98x0.95mm_HandSolder
R2: 316; R_0603_1608Metric_Pad0.98x0.95mm_HandSolder
R3: 5/0.1%; R_2512_6332Metric_Pad1.40x3.35mm_HandSolder
R4: 0R1/5W; WSR5
R6, R8: 536k; R_0603_1608Metric_Pad0.98x0.95mm_HandSolder
R7, R9: 49k3; R_0603_1608Metric_Pad0.98x0.95mm_HandSolder
R10: R; R_0603_1608Metric_Pad0.98x0.95mm_HandSolder
R14, R19, R24, R25: 10k; R_0603_1608Metric_Pad0.98x0.95mm_HandSolder
R15: 180k/0.05%; R_0603_1608Metric_Pad0.98x0.95mm_HandSolder
R16: 18k/0.05%; R_0603_1608Metric_Pad0.98x0.95mm_HandSolder
R17: 2k/0.05%; R_0603_1608Metric_Pad0.98x0.95mm_HandSolder
R18: 30k9; R_0603_1608Metric_Pad0.98x0.95mm_HandSolder
R20: 4k75; R_0603_1608Metric_Pad0.98x0.95mm_HandSolder
R21: 9k76; R_0603_1608Metric_Pad0.98x0.95mm_HandSolder
R22, R23: 4k7; R_0603_1608Metric_Pad0.98x0.95mm_HandSolder
R26: 0; R_0603_1608Metric_Pad0.98x0.95mm_HandSolder
RV1: B72660M0301; 4032
U1: DG211; TSSOP-16_4.4x5mm_P0.65mm
U2: DG419xY; SOIC-8_3.9x4.9mm_P1.27mm
U3: LT3032; Linear_DE14MA
U4: OPA140; SOIC-8_3.9x4.9mm_P1.27mm
U5: ISO124; DVA
U6: ADuM5410; SSOP-24_5.3x8.2mm_P0.65mm
U7: DCP020515DU; DVB
U8: OPA237_SOT23; SOT-23-5_HandSoldering
U9: LT3032-15; Linear_DE14MA
U10, U11, U12: 74LVC1GU04DRL; SOT-553
U13: 24LC08B-E/MS; MSOP-8_3x3mm_P0.65mm
U14: TXB0104PW; TSSOP-14_4.4x5mm_P0.65mm
U15: PCA9557PW; TSSOP-16_4.4x5mm_P0.65mm
U16: OPA132; SOIC-8_3.9x4.9mm_P1.27mm
U17: LM3480-12; SOT-23
U18: FODM214; SOP-4_4.4x2.6mm_P1.27mm

Connections:
+3V3: C26.1, C27.1, J2.15, J2.16, R22.1, R23.1, R24.1, R25.1, U13.8 (VCC), U14.1 (VCCA), U15.16 (VDD)
+5V: C28.1, C29.1, C32.1, C33.1, J2.18, U6.1 (VDD1), U6.11 (VDDP), U7.1 (+VS), U10.5 (VCC), U11.5 (VCC), U12.5 (VCC), U14.14 (VCCB)
+5VF: C16.1, FB1.2, R14.2, R18.1, U1.12 (VL), U2.5 (VL), U6.18 (VE2), U6.24 (VDD2)
+15V: C21.1, C23.1, FB3.2, U5.9 (V+), U8.5 (V+), U9.1 (OUTP)
+15VF: C1.1, C3.1, C5.1, C6.1, C8.1, C10.1, C14.1, R8.1, U1.13 (V+), U2.4 (V+), U3.1 (OUTP), U4.7 (V+), U5.1 (V+), U16.7 (V+), U17.2 (VI)
+18V: C25.1, FB3.1, J2.20, U9.12 (~SHDNP), U9.14 (INP)
-15V: C20.1, C22.1, FB2.2, U5.10 (V-), U8.2 (V-), U9.7 (OUTN)
-15VF: C2.1, C4.1, C7.1, C9.1, C11.1, C15.1, C31.1, R6.1, U1.4 (V-), U2.7 (V-), U3.7 (OUTN), U4.4 (V-), U5.2 (V-), U16.4 (V-)
-18V: C24.1, FB2.1, J2.19, U9.6 (INN), U9.9 (INN), U9.10 (~SHDNN)
/A0: J2.1, U13.1 (A0), U15.3 (A0)
/A1: J2.3, U13.2 (A1), U15.4 (A1)
/AOUT: C18.1, J2.9, J2.10, J2.11, J2.12, U8.1, U8.4 (-)
/AZ: U2.6, U6.19 (VOD)
/G1: U1.1, U6.22 (VOA)
/G10: U1.16, U6.21 (VOB)
/G100: U1.9, U6.20 (VOC)
/IO2: U14.5 (A4), U15.9 (IO2)
/IO3: U14.4 (A3), U15.10 (IO3)
/IO4: U14.3 (A2), U15.11 (IO4)
/IO5: U14.2 (A1), U15.12 (IO5)
/IO_AZ: U6.6 (VID), U14.10 (B4)
/IO_G1: R26.2, U6.3 (VIA), U10.4
/IO_G10: U6.4 (VIB), U11.4
/IO_G100: U6.5 (VIC), U12.4
/LED: R10.1, U15.13 (IO6)
/NADJ: R6.2, R7.1, U3.8 (ADJN)
/PADJ: R8.2, R9.1, U3.2 (ADJP)
/RLY: D1.2 (A), K1.5, U18.4
/SCL: J2.2, R22.2, U13.6 (SCL), U15.1 (SCL)
/SDA: J2.4, R23.2, U13.5 (SDA), U15.2 (SDA)
/WP: U13.7 (WP), U15.7 (IO1)
AGNDF: C1.2, C2.2, C3.2, C6.2, C7.2, C8.2, C9.2, C10.2, C11.2, C12.2, C13.2, C14.2, C15.2, C16.2, C17.2, C31.2, D2.2 (~~), J1.2, R4.2, R7.2, R9.2, R17.2, R19.2, RV1.2, U1.5 (GND), U2.3 (GND), U2.8, U3.4 (GND), U3.5 (GND), U5.16 (GND), U6.13 (GNDISO), U6.16 (GNDISO), U6.23 (GNDISO), U7.12 (COM), U17.3 (GND), U18.3
GND: C19.2, C20.2, C21.2, C24.2, C25.2, C26.2, C27.2, C28.2, C29.2, C30.2, C32.2, C33.2, J2.7, J2.8, J2.13, J2.14, U5.8 (GND), U6.2 (GND1), U6.9 (GND1), U6.10 (PDIS), U6.12 (GND1), U7.2 (-VS), U7.3 (-VS), U7.28 (SYNC), U9.4 (GND), U9.5 (GND), U10.3 (GND), U11.3 (GND), U12.3 (GND), U13.3 (A2), U13.4 (GND), U14.7 (GND), U15.5 (A2), U15.8 (VSS), U18.2
unnamed: C4.2, U3.11 (BYPN)
unnamed: C5.2, U3.3 (BYPP)
unnamed: C17.1, FB1.1, U6.14 (VISO)
unnamed: C18.2, R20.1, R21.2
unnamed: C19.1, R21.1, U8.3 (+)
unnamed: C22.2, U9.11 (BYPN)
unnamed: C23.2, U9.3 (BYPP)
unnamed: C30.1, R24.2, U15.15 (~RESET)
unnamed: D1.1 (K), K1.1, U17.1 (VO)
unnamed: D2.1 (+), D2.4 (-), R2.2
unnamed: D2.3 (~~), J1.1, K1.2, R1.2, RV1.1
unnamed: K1.3, R3.1, R5.2
unnamed: K1.4, R3.2, R4.1
unnamed: R1.1, U16.3 (+)
unnamed: R2.1, U16.2 (-), U16.6
unnamed: R5.1, U2.2
unnamed: R10.2, U18.1
unnamed: R14.1, U1.8
unnamed: R15.1, U1.3, U4.6, U5.15
unnamed: R15.2, R16.1, U1.15
unnamed: R16.2, R17.1, U1.10
unnamed: R18.2, R19.1, U6.15 (VSEL)
unnamed: R20.2, U5.7
unnamed: R25.2, U14.8 (OE)
unnamed: R26.1, U10.2, U14.13 (B1)
unnamed: U1.6, U1.7
unnamed: U1.2, U1.11, U1.14, U4.2 (-)
unnamed: U2.1, U4.3 (+)
unnamed: U11.2, U14.12 (B2)
unnamed: U12.2, U14.11 (B3)
VCC: C13.1, U3.12 (~SHDNP), U3.14 (INP), U7.13 (+VOUT)
VDD: C12.1, U3.6 (INN), U3.9 (INN), U3.10 (~SHDNN), U7.14 (-VOUT)

Notes on the sheet:
Current meas. and PGA
Isolated power
Misc.
Digital IO
EEPROM
Connector
Power
Isolated OP-Amp and low pass filter
Isolated digital IO side B
Isolated digital IO side A
Isolated power side A
Isolated power side B
WSR5R1000FEA
Y16285R00000D0W
