BehrensG/ETH3CDAQ1/hardware/project/ETH3CDAQ1_CURRENT_ISO_T2/ETH3CDAQ1_CURRENT_ISO_T2.kicad_pcb

## KiCad design hardware/project/ETH3CDAQ1_CURRENT_ISO_T2/ETH3CDAQ1_CURRENT_ISO_T2.kicad_pcb (continued)

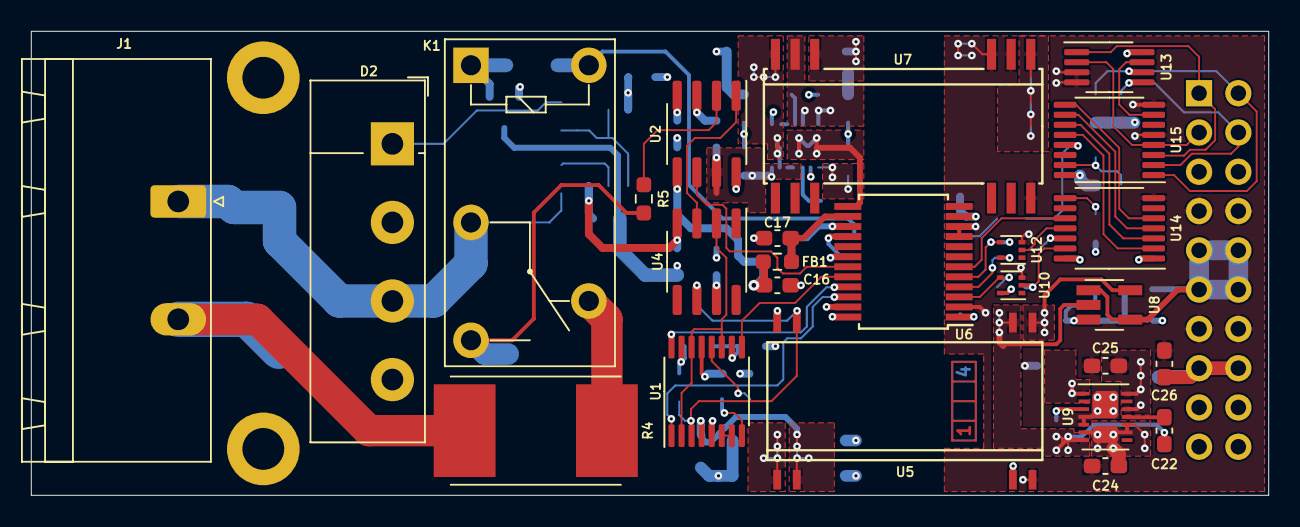
[picture p53: board ETH3CDAQ1_CURRENT_ISO_T2.kicad_pcb from above]

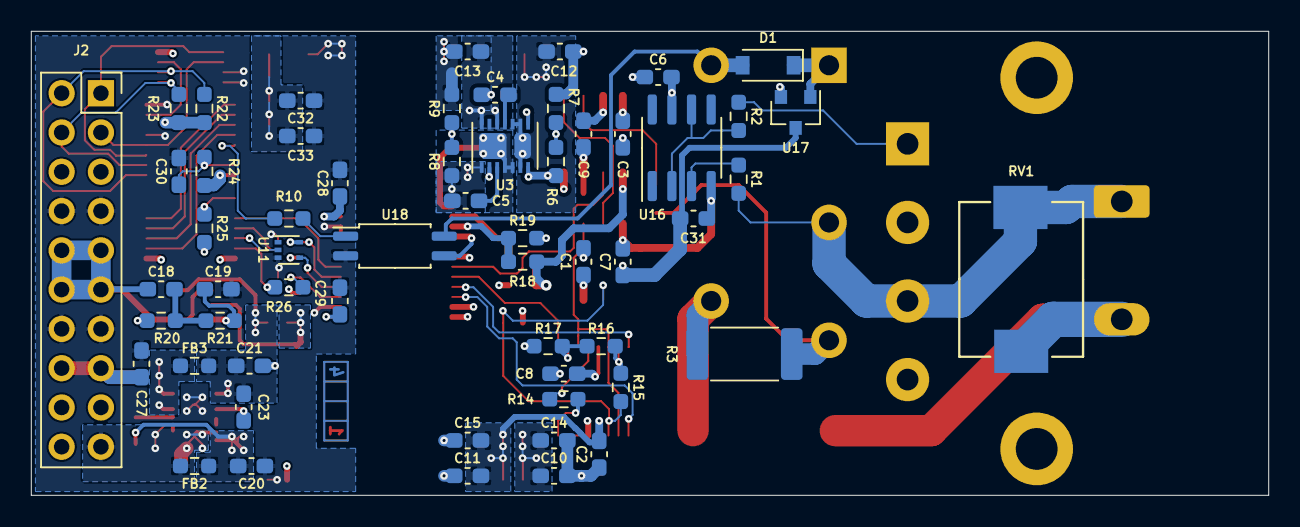
[picture p54: board ETH3CDAQ1_CURRENT_ISO_T2.kicad_pcb from below]

Board: 4 copper layers, 80.0 x 30.0 mm, 85 parts (58 on the bottom side), 65 nets.
