BehrensG/ETH3CDAQ1/software/MCU/ETH3CDAQ1_MCU/Core/Src/main.c

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
/* Includes ------------------------------------------------------------------*/
#include "main.h"
#include "cmsis_os.h"
#include "lwip.h"

/* USER CODE BEGIN Includes */
#include "bsp.h"
#include "led.h"
#include "dwt_delay.h"
#include "DG211.h"
#include "ADS8681.h"
#include "DG211.h"
#include "DAC8564.h"
#include "measure.h"
#include "sdram.h"
#include "module.h"
#include "scpi_server.h"
/* USER CODE END Includes */

typedef StaticQueue_t osStaticMessageQDef_t;

I2C_HandleTypeDef hi2c3;
I2C_HandleTypeDef hi2c4;

SPI_HandleTypeDef hspi3;
SPI_HandleTypeDef hspi5;

SDRAM_HandleTypeDef hsdram2;

/* Definitions for defaultTask */
osThreadId_t defaultTaskHandle;
const osThreadAttr_t defaultTask_attributes = {
  .name = "defaultTask",
  .stack_size = 128 * 4,
  .priority = (osPriority_t) osPriorityNormal,
};
/* Definitions for LEDTask */
osThreadId_t LEDTaskHandle;
const osThreadAttr_t LEDTask_attributes = {
  .name = "LEDTask",
  .stack_size = 128 * 4,
  .priority = (osPriority_t) osPriorityLow,
};
/* Definitions for TriggerTask */
osThreadId_t TriggerTaskHandle;
const osThreadAttr_t TriggerTask_attributes = {
  .name = "TriggerTask",
  .stack_size = 128 * 4,
  .priority = (osPriority_t) osPriorityHigh,
};
/* Definitions for QueueTrigger */
osMessageQueueId_t QueueTriggerHandle;
uint8_t QueueTriggerBuffer[ 1 * sizeof( uint8_t ) ];
osStaticMessageQDef_t QueueTriggerControlBlock;
const osMessageQueueAttr_t QueueTrigger_attributes = {
  .name = "QueueTrigger",
  .cb_mem = &QueueTriggerControlBlock,
  .cb_size = sizeof(QueueTriggerControlBlock),
  .mq_mem = &QueueTriggerBuffer,
  .mq_size = sizeof(QueueTriggerBuffer)
};
/* USER CODE BEGIN PV */

FMC_SDRAM_CommandTypeDef command;
osMessageQueueId_t LEDMessageQueue;

/* USER CODE END PV */

void SystemClock_Config(void);
static void MPU_Config(void);
static void MX_GPIO_Init(void);
static void MX_FMC_Init(void);
static void MX_I2C3_Init(void);
static void MX_I2C4_Init(void);
static void MX_SPI3_Init(void);
static void MX_SPI5_Init(void);
void StartDefaultTask(void *argument);
void StartTaskLEDStatus(void *argument);
void StartTriggerTask(void *argument);

/**
  * @brief  The application entry point.
  * @retval int
  */
int main(void)
{
  /* MPU Configuration--------------------------------------------------------*/
  MPU_Config();

  /* Enable I-Cache---------------------------------------------------------*/
  SCB_EnableICache();

  /* Enable D-Cache---------------------------------------------------------*/
  SCB_EnableDCache();

  /* MCU Configuration--------------------------------------------------------*/

  /* Reset of all peripherals, Initializes the Flash interface and the Systick. */
  HAL_Init();

  /* Configure the system clock */
  SystemClock_Config();

  /* Initialize all configured peripherals */
  MX_GPIO_Init();
  MX_FMC_Init();
  MX_I2C3_Init();
  MX_I2C4_Init();
  MX_SPI3_Init();
  MX_SPI5_Init();
  /* USER CODE BEGIN 2 */
  HAL_Delay(100);
  BSP_Init();
  MX_LWIP_Init();
  SDRAM_Init(&hsdram2, &command);
  DWT_Init();
  DG211_Init();
  DAC8564_Init();
  ADS8681_Init();
  MODULE_Init();
  MEAS_ZeroOffset();
  /* USER CODE END 2 */

  /* Init scheduler */
  osKernelInitialize();

  /* USER CODE BEGIN RTOS_MUTEX */
  /* add mutexes, ... */
  /* USER CODE END RTOS_MUTEX */

  /* USER CODE BEGIN RTOS_SEMAPHORES */
  /* add semaphores, ... */
  /* USER CODE END RTOS_SEMAPHORES */

  /* USER CODE BEGIN RTOS_TIMERS */
  /* start timers, add new ones, ... */
  /* USER CODE END RTOS_TIMERS */

  /* Create the queue(s) */
  /* creation of QueueTrigger */
  QueueTriggerHandle = osMessageQueueNew (1, sizeof(uint8_t), &QueueTrigger_attributes);

  /* USER CODE BEGIN RTOS_QUEUES */
  /* add queues, ... */
  /* USER CODE END RTOS_QUEUES */

  /* Create the thread(s) */
  /* creation of defaultTask */
 // defaultTaskHandle = osThreadNew(StartDefaultTask, NULL, &defaultTask_attributes);

  /* creation of LEDTask */
  LEDTaskHandle = osThreadNew(StartTaskLEDStatus, NULL, &LEDTask_attributes);

  /* creation of TriggerTask */
  TriggerTaskHandle = osThreadNew(StartTriggerTask, NULL, &TriggerTask_attributes);

  /* USER CODE BEGIN RTOS_THREADS */
  scpi_server_init();
  /* USER CODE END RTOS_THREADS */

  /* USER CODE BEGIN RTOS_EVENTS */
  /* add events, ... */
  /* USER CODE END RTOS_EVENTS */

  /* Start scheduler */
  osKernelStart();


  /* We should never get here as control is now taken by the scheduler */
  /* Infinite loop */
  /* USER CODE BEGIN WHILE */
  while (1)
  {
    /* USER CODE END WHILE */

    /* USER CODE BEGIN 3 */
  }
  /* USER CODE END 3 */
}

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
/* USER CODE BEGIN Header_StartDefaultTask */
/**
  * @brief  Function implementing the defaultTask thread.
  * @param  argument: Not used
  * @retval None
  */
/* USER CODE END Header_StartDefaultTask */
void StartDefaultTask(void *argument)
{
  /* init code for LWIP */
  MX_LWIP_Init();
  /* USER CODE BEGIN 5 */

  /* Infinite loop */
  for (;;) {
    osDelay(1000);

  }
  /* USER CODE END 5 */
}

/* USER CODE BEGIN Header_StartTaskLEDStatus */
/**
* @brief Function implementing the LEDStatus thread.
* @param argument: Not used
* @retval None
*/
/* USER CODE END Header_StartTaskLEDStatus */
void StartTaskLEDStatus(void *argument)
{
  /* USER CODE BEGIN StartTaskLEDStatus */

	uint8_t led_color, tmp;
	osStatus_t status;

	led_color = 0;
	tmp = 0;

  /* Infinite loop */
  for(;;)
  {
	  status = osMessageQueueGet(LEDMessageQueue, &led_color, NULL, 0U);

	  if(osOK == status)
	  {
		  tmp = led_color;
	  }
	  else
	  {
		  led_color = tmp;
	  }
	  switch(led_color)
	  {
	  	  case RED: LL_GPIO_TogglePin(LED_RED_GPIO_Port, LED_RED_Pin); break;
	  	  case GREEN: LL_GPIO_TogglePin(LED_GREEN_GPIO_Port, LED_GREEN_Pin); break;
	  	  case BLUE: LL_GPIO_TogglePin(LED_BLUE_GPIO_Port, LED_BLUE_Pin); break;
	  	  default: LL_GPIO_TogglePin(LED_RED_GPIO_Port, LED_RED_Pin); break;
	  }

	  osDelay(pdMS_TO_TICKS(500));
  }
  /* USER CODE END StartTaskLEDStatus */
}

/* USER CODE BEGIN Header_StartTriggerTask */
/**
* @brief Function implementing the TriggerTask thread.
* @param argument: Not used
* @retval None
*/
/* USER CODE END Header_StartTriggerTask */
void StartTriggerTask(void *argument)
{
  /* USER CODE BEGIN StartTriggerTask */
		uint8_t trigger_status = 0;
	  /* Infinite loop */


	  for(;;)
	  {
		  if(osOK == osMessageQueueGet(QueueTriggerHandle, &trigger_status, NULL, 10U))
		  {
				LL_GPIO_TogglePin(LED_RED_GPIO_Port, LED_RED_Pin);
		  }
		  osDelay(pdMS_TO_TICKS(2));
	  }
  /* USER CODE END StartTriggerTask */
}

/* MPU Configuration */

void MPU_Config(void)
{
  MPU_Region_InitTypeDef MPU_InitStruct = {0};

  /* Disables the MPU */
  HAL_MPU_Disable();
  /** Initializes and configures the Region and the memory to be protected
  */
  MPU_InitStruct.Enable = MPU_REGION_ENABLE;
  MPU_InitStruct.Number = MPU_REGION_NUMBER0;
  MPU_InitStruct.BaseAddress = 0x30040000;
  MPU_InitStruct.Size = MPU_REGION_SIZE_32KB;
  MPU_InitStruct.SubRegionDisable = 0x0;
  MPU_InitStruct.TypeExtField = MPU_TEX_LEVEL1;
  MPU_InitStruct.AccessPermission = MPU_REGION_FULL_ACCESS;
  MPU_InitStruct.DisableExec = MPU_INSTRUCTION_ACCESS_DISABLE;
  MPU_InitStruct.IsShareable = MPU_ACCESS_NOT_SHAREABLE;
  MPU_InitStruct.IsCacheable = MPU_ACCESS_NOT_CACHEABLE;
  MPU_InitStruct.IsBufferable = MPU_ACCESS_NOT_BUFFERABLE;

  HAL_MPU_ConfigRegion(&MPU_InitStruct);
  /** Initializes and configures the Region and the memory to be protected
  */
  MPU_InitStruct.Number = MPU_REGION_NUMBER1;
  MPU_InitStruct.Size = MPU_REGION_SIZE_256B;
  MPU_InitStruct.TypeExtField = MPU_TEX_LEVEL0;
  MPU_InitStruct.IsShareable = MPU_ACCESS_SHAREABLE;
  MPU_InitStruct.IsBufferable = MPU_ACCESS_BUFFERABLE;

  HAL_MPU_ConfigRegion(&MPU_InitStruct);
  /* Enables the MPU */
  HAL_MPU_Enable(MPU_PRIVILEGED_DEFAULT);

}
/**
  * @brief  Period elapsed callback in non blocking mode
  * @note   This function is called  when TIM1 interrupt took place, inside
  * HAL_TIM_IRQHandler(). It makes a direct call to HAL_IncTick() to increment
  * a global variable "uwTick" used as application time base.
  * @param  htim : TIM handle
  * @retval None
  */
void HAL_TIM_PeriodElapsedCallback(TIM_HandleTypeDef *htim)
{
  if (htim->Instance == TIM1) {
    HAL_IncTick();
  }
}

/**
  * @brief  This function is executed in case of error occurrence.
  * @retval None
  */
void Error_Handler(void)
{
  /* USER CODE BEGIN Error_Handler_Debug */
  /* User can add his own implementation to report the HAL error return state */
  __disable_irq();
  while (1)
  {
  }
  /* USER CODE END Error_Handler_Debug */
}

#ifdef  USE_FULL_ASSERT
/**
  * @brief  Reports the name of the source file and the source line number
  *         where the assert_param error has occurred.
  * @param  file: pointer to the source file name
  * @param  line: assert_param error line source number
  * @retval None
  */
void assert_failed(uint8_t *file, uint32_t line)
{
  /* USER CODE BEGIN 6 */
  /* User can add his own implementation to report the file name and line number,
     ex: printf("Wrong parameters value: file %s on line %d\r\n", file, line) */
  /* USER CODE END 6 */
}
#endif /* USE_FULL_ASSERT */

/************************ (C) COPYRIGHT STMicroelectronics *****END OF FILE****/
