BehrensG/ETH3CDAQ1/software/MCU/ETH3CDAQ1_MCU/ETH3CDAQ1_MCU.ioc

PD12.GPIO_Label=EEPROM_SCL
PG4.Signal=FMC_A14_BA0
PG8.Signal=FMC_SDCLK
PC12.Signal=SPI3_MOSI
PG6.GPIO_Label=LED_BLUE
PG0.Signal=FMC_A10
PA6.GPIO_Label=TRIG_IN
PG13.Signal=ETH_TXD0
PF6.GPIO_Label=DAC_nSYNC
PF7.Signal=SPI5_SCK
PB6.Signal=FMC_SDNE1
PD0.Signal=FMC_D2_DA2
PD8.Signal=FMC_D13_DA13
PE1.Signal=FMC_NBL1
PF10.GPIO_Label=DAC_LDAC
PB12.GPIO_Label=LED_RED
PE9.Signal=FMC_D6_DA6
PE4.GPIO_Label=SR_CLK
PE2.Signal=GPIO_Output
PA8.Signal=I2C3_SCL
PF3.Signal=FMC_A3
PE10.Signal=FMC_D7_DA7
PD12.Signal=I2C4_SCL
PF14.Signal=FMC_A8
PA4.GPIO_Label=TRIG_EN
PD15.Signal=FMC_D1_DA1
PG5.Signal=FMC_A15_BA1
PD1.Signal=FMC_D3_DA3
PC0.Signal=FMC_SDNWE
PF8.GPIO_Label=SPI5_NOT_USED
PD10.Signal=FMC_D15_DA15
PA8.GPIO_Label=SENS_SCL
PA5.Signal=GPIO_Output
PE14.Signal=FMC_D11_DA11
PE15.Signal=FMC_D12_DA12
PE8.Signal=FMC_D5_DA5
PF13.Signal=FMC_A7
PA4.Signal=GPIO_Output
PB5.Signal=FMC_SDCKE1
PA5.GPIO_Label=TRIG_OUT
PD11.Signal=GPIO_Output
PC12.GPIO_Label=MCU_MOSI
PF9.Signal=SPI5_MOSI
PE3.Signal=GPIO_Output
PF4.Signal=FMC_A4
PG3.GPIO_Label=LED_GREEN
PB0.Signal=GPIO_Output
PC1.Signal=ETH_MDC
PG6.Signal=GPIO_Output
Mcu.UserName=STM32H743ZITx
PG2.Signal=FMC_A12
PC10.Signal=SPI3_SCK
PB0.GPIO_Label=MCU_DEFAULT
PG11.Signal=ETH_TX_EN
PG15.Signal=FMC_SDNCAS
PD13.Signal=I2C4_SDA
PD11.GPIO_Label=EEPROM_WP
PF12.Signal=FMC_A6
PE13.Signal=FMC_D10_DA10
PF7.GPIO_Label=DAC_SCLK
PF11.Signal=FMC_SDNRAS
PC11.GPIO_Label=MCU_MISO
PE4.Signal=GPIO_Output
PD13.GPIO_Label=EEPROM_SDA
PA6.Signal=GPXTI6
PF8.Signal=SPI5_MISO
PF5.Signal=FMC_A5
PF0.Signal=FMC_A0
PC5.Signal=ETH_RXD1
PE7.Signal=FMC_D4_DA4
PE2.GPIO_Label=SR_DAT
PC10.GPIO_Label=MCU_CLK
PC9.GPIO_Label=SENS_SDA
PG3.Signal=GPIO_Output
PG1.Signal=FMC_A11
PC11.Signal=SPI3_MISO
PC4.Signal=ETH_RXD0
PD9.Signal=FMC_D14_DA14
PF6.Signal=GPIO_Output
PF2.Signal=FMC_A2
PF9.GPIO_Label=DAC_DIN
PE11.Signal=FMC_D8_DA8
PA1.Signal=ETH_REF_CLK
PG14.Signal=ETH_TXD1
PF10.Signal=GPIO_Output
PF15.Signal=FMC_A9
PF1.Signal=FMC_A1
PE0.Signal=FMC_NBL0
PE12.Signal=FMC_D9_DA9
PA2.Signal=ETH_MDIO
PD14.Signal=FMC_D0_DA0
PE3.GPIO_Label=SR_LAT
PC9.Signal=I2C3_SDA
PB12.Signal=GPIO_Output
PA7.Signal=ETH_CRS_DV
