BehrensG/ETH3CDAQ1/software/MCU/ETH3CDAQ1_MCU/Core/Inc/main.h

#define SR_DAT_Pin LL_GPIO_PIN_2
#define SR_DAT_GPIO_Port GPIOE
#define SR_LAT_Pin LL_GPIO_PIN_3
#define SR_LAT_GPIO_Port GPIOE
#define SR_CLK_Pin LL_GPIO_PIN_4
#define SR_CLK_GPIO_Port GPIOE
#define DAC_nSYNC_Pin LL_GPIO_PIN_6
#define DAC_nSYNC_GPIO_Port GPIOF
#define DAC_SCLK_Pin LL_GPIO_PIN_7
#define DAC_SCLK_GPIO_Port GPIOF
#define SPI5_NOT_USED_Pin LL_GPIO_PIN_8
#define SPI5_NOT_USED_GPIO_Port GPIOF
#define DAC_DIN_Pin LL_GPIO_PIN_9
#define DAC_DIN_GPIO_Port GPIOF
#define DAC_LDAC_Pin LL_GPIO_PIN_10
#define DAC_LDAC_GPIO_Port GPIOF
#define TRIG_EN_Pin LL_GPIO_PIN_4
#define TRIG_EN_GPIO_Port GPIOA
#define TRIG_OUT_Pin LL_GPIO_PIN_5
#define TRIG_OUT_GPIO_Port GPIOA
#define TRIG_IN_Pin LL_GPIO_PIN_6
#define TRIG_IN_GPIO_Port GPIOA
#define TRIG_IN_EXTI_IRQn EXTI9_5_IRQn
#define MCU_DEFAULT_Pin LL_GPIO_PIN_0
#define MCU_DEFAULT_GPIO_Port GPIOB
#define LED_RED_Pin LL_GPIO_PIN_12
#define LED_RED_GPIO_Port GPIOB
#define EEPROM_WP_Pin LL_GPIO_PIN_11
#define EEPROM_WP_GPIO_Port GPIOD
#define EEPROM_SCL_Pin LL_GPIO_PIN_12
#define EEPROM_SCL_GPIO_Port GPIOD
#define EEPROM_SDA_Pin LL_GPIO_PIN_13
#define EEPROM_SDA_GPIO_Port GPIOD
#define LED_GREEN_Pin LL_GPIO_PIN_3
#define LED_GREEN_GPIO_Port GPIOG
#define LED_BLUE_Pin LL_GPIO_PIN_6
#define LED_BLUE_GPIO_Port GPIOG
#define SENS_SDA_Pin LL_GPIO_PIN_9
#define SENS_SDA_GPIO_Port GPIOC
#define SENS_SCL_Pin LL_GPIO_PIN_8
#define SENS_SCL_GPIO_Port GPIOA
#define MCU_nCS_Pin LL_GPIO_PIN_15
#define MCU_nCS_GPIO_Port GPIOA
#define MCU_CLK_Pin LL_GPIO_PIN_10
#define MCU_CLK_GPIO_Port GPIOC
#define MCU_MISO_Pin LL_GPIO_PIN_11
#define MCU_MISO_GPIO_Port GPIOC
#define MCU_MOSI_Pin LL_GPIO_PIN_12
#define MCU_MOSI_GPIO_Port GPIOC
