BehrensG/ETH3CDAQ1/software/MCU/ETH3CDAQ1_MCU/Core/Src/scpi_def.c

/*-
 * Copyright (c) 2012-2013 Jan Breuer,
 *
 * All Rights Reserved
 *
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
 * THIS SOFTWARE IS PROVIDED BY THE AUTHORS ``AS IS'' AND ANY EXPRESS OR
 * IMPLIED WARRANTIES, INCLUDING, BUT NOT LIMITED TO, THE IMPLIED
 * WARRANTIES OF MERCHANTABILITY AND FITNESS FOR A PARTICULAR PURPOSE ARE
 * DISCLAIMED. IN NO EVENT SHALL THE AUTHORS OR CONTRIBUTORS BE LIABLE
 * FOR ANY DIRECT, INDIRECT, INCIDENTAL, SPECIAL, EXEMPLARY, OR
 * CONSEQUENTIAL DAMAGES (INCLUDING, BUT NOT LIMITED TO, PROCUREMENT OF
 * SUBSTITUTE GOODS OR SERVICES; LOSS OF USE, DATA, OR PROFITS; OR
 * BUSINESS INTERRUPTION) HOWEVER CAUSED AND ON ANY THEORY OF LIABILITY,
 * WHETHER IN CONTRACT, STRICT LIABILITY, OR TORT (INCLUDING NEGLIGENCE
 * OR OTHERWISE) ARISING IN ANY WAY OUT OF THE USE OF THIS SOFTWARE, EVEN
 * IF ADVISED OF THE POSSIBILITY OF SUCH DAMAGE.
 */

/**
 * @file   scpi-def.c
 * @date   Thu Nov 15 10:58:45 UTC 2012
 *
 * @brief  SCPI parser test
 *
 *
 */


#include <stdio.h>
#include <stdlib.h>
#include <string.h>



#include "scpi_def.h"
#include "scpi/scpi.h"
#include "main.h"
#include "cmsis_os.h"

#include "scpi_system.h"
#include "scpi_test.h"
#include "scpi_fetch.h"
#include "scpi_sample.h"
#include "scpi_read.h"
#include "scpi_trigger.h"
#include "scpi_initiate.h"

#include "bsp.h"
#include "dwt_delay.h"
#include "ADS8681.h"
#include "DAC8564.h"
#include "74HC595.h"
#include "measure.h"
#include "samples.h"
#include "module.h"
#include "PCA9557.h"

extern I2C_HandleTypeDef hi2c4;
extern SPI_HandleTypeDef hspi5;
extern SPI_HandleTypeDef hspi3;

extern float global_sdram_meas[CHANNELS][SDRAM_CHx_SAMPLES_MAX];



size_t SCPI_GetChannels(scpi_t* context, scpi_channel_value_t array[])
{
    scpi_parameter_t channel_list_param;
    // scpi_channel_value_t array[MAXROW * MAXCOL]; /* array which holds values in order (2D) */
    size_t chanlst_idx; /* index for channel list */
    size_t arr_idx = 0; /* index for array */
    size_t n, m = 1; /* counters for row (n) and columns (m) */

    /* get channel list */
    if (SCPI_Parameter(context, &channel_list_param, TRUE)) {
        scpi_bool_t is_range;
        int32_t values_from[MAXDIM];
        int32_t values_to[MAXDIM];
        size_t dimensions;

        bool for_stop_row = FALSE; /* true if iteration for rows has to stop */
        bool for_stop_col = FALSE; /* true if iteration for columns has to stop */
        int32_t dir_row = 1; /* direction of counter for rows, +/-1 */
        int32_t dir_col = 1; /* direction of counter for columns, +/-1 */

        /* the next statement is valid usage and it gets only real number of dimensions for the first item (index 0) */
        if (!SCPI_ExprChannelListEntry(context, &channel_list_param, 0, &is_range, NULL, NULL, 0, &dimensions)) {
            chanlst_idx = 0; /* call first index */
            arr_idx = 0; /* set arr_idx to 0 */
            do { /* if valid, iterate over channel_list_param index while res == valid (do-while cause we have to do it once) */
                res = SCPI_ExprChannelListEntry(context, &channel_list_param, chanlst_idx, &is_range, values_from, values_to, 4, &dimensions);
                if (is_range == FALSE) { /* still can have multiple dimensions */
                    if (dimensions == 1) {
                        /* here we have our values
                         * row == values_from[0]
                         * col == 0 (fixed number)
                         * call a function or something */
                        array[arr_idx].row = values_from[0];
                        array[arr_idx].col = 0;
                    } else if (dimensions == 2) {
                        /* here we have our values
                         * row == values_fom[0]
                         * col == values_from[1]
                         * call a function or something */
                        array[arr_idx].row = values_from[0];
                        array[arr_idx].col = values_from[1];
                    } else {
                        return arr_idx = 0;
                    }
                    arr_idx++; /* inkrement array where we want to save our values to, not neccessary otherwise */
                    if (arr_idx >= MAXROW * MAXCOL) {
                        return arr_idx = 0;
                    }
                } else if (is_range == TRUE) {
                    if (values_from[0] > values_to[0]) {
                        dir_row = -1; /* we have to decrement from values_from */
                    } else { /* if (values_from[0] < values_to[0]) */
                        dir_row = +1; /* default, we increment from values_from */
                    }

                    /* iterating over rows, do ilwip nvic gpiot once -> set for_stop_row = false
                     * needed if there is channel list index isn't at end yet */
                    for_stop_row = FALSE;
                    for (n = values_from[0]; for_stop_row == FALSE; n += dir_row) {
                        /* usual case for ranges, 2 dimensions */
                        if (dimensions == 2) {
                            if (values_from[1] > values_to[1]) {
                                dir_col = -1;
                            } else if (values_from[1] < values_to[1]) {
                                dir_col = +1;
                            }
                            /* iterating over columns, do it at least once -> set for_stop_col = false
                             * needed if there is channel list index isn't at end yet */
                            for_stop_col = FALSE;
                            for (m = values_from[1]; for_stop_col == FALSE; m += dir_col) {
                                /* here we have our values
                                 * row == n
                                 * col == m
                                 * call a function or something */
                                array[arr_idx].row = n;
                                array[arr_idx].col = m;
                                arr_idx++;
                                if (arr_idx >= MAXROW * MAXCOL) {
                                    return arr_idx = 0;
                                }
                                if (m == (size_t)values_to[1]) {
                                    /* endpoint reached, stop column for-loop */
                                    for_stop_col = TRUE;
                                }
                            }
                            /* special case for range, example: (@2!1) */
                        } else if (dimensions == 1) {
                            /* here we have values
                             * row == n
                             * col == 0 (fixed number)
                             * call function or sth. */
                            array[arr_idx].row = n;
                            array[arr_idx].col = 0;
                            arr_idx++;
                            if (arr_idx >= MAXROW * MAXCOL) {
                                return arr_idx = 0;
                            }
                        }
                        if (n == (size_t)values_to[0]) {
                            /* endpoint reached, stop row for-loop */
                            for_stop_row = TRUE;
                        }
                    }


                } else {
                    return arr_idx = 0;
                }
                /* increase index */
                chanlst_idx++;
            } while (SCPI_EXPR_OK == SCPI_ExprChannelListEntry(context, &channel_list_param, chanlst_idx, &is_range, values_from, values_to, 4, &dimensions));
            /* while checks, whether incremented index is valid */
        }
        /* do something at the end if needed */
        /* array[arr_idx].row = 0; */
        /* array[arr_idx].col = 0; */
    }
    return arr_idx;
}


scpi_choice_def_t boolean_select[] =
{
    {"OFF", 0},
    {"ON", 1},
	{"0", 0},
	{"1", 1},
    SCPI_CHOICE_LIST_END
};

static scpi_result_t TEST_TSQ(scpi_t * context)
{
	BSP_StatusTypeDef status;
	uint8_t matrix[3] = {CHx_M_IN, CHx_M_DAC, CHx_M_DAC};
	float tmp[3]={0,0,0};
	uint8_t range[3] = {0,0,0};
	char* buffer;
	buffer = (char*)malloc(TCP_PACKGE_SIZE);

	PCA9557_Gain_Select(0, MODULE_GAIN_100);
	DAC8564_Set_Voltage(DAC8564_DAC_A,0.0);
	DAC8564_Set_Voltage(DAC8564_DAC_B,5.0);
	DAC8564_Set_Voltage(DAC8564_DAC_C,6.0);

	DG211_Switch(matrix);
	HAL_Delay(5);

	status=ADS8681_Set_Range(range);

	for (uint32_t x = 0; x < 2000; x++)
	{

		status = MEAS_GetValues(tmp);
		if(BSP_OK == status)
		{
			global_sdram_meas[0][x] = tmp[0];
			global_sdram_meas[1][x] = tmp[1];
			global_sdram_meas[2][x] = tmp[2];

		}
		else
		{
			break;
		}

	}

	buffer = SAMPLES_TCP_Package(&global_sdram_meas[0], 0, 2000);
	SCPI_ResultCharacters(context, buffer, TCP_PACKGE_SIZE);
	//memset(buffer,'\0',TCP_PACKGE_SIZE);
	buffer = SAMPLES_TCP_Package(&global_sdram_meas[1], 0, 2000);
	SCPI_ResultCharacters(context, buffer, TCP_PACKGE_SIZE);
	//memset(buffer,'\0',TCP_PACKGE_SIZE);
	buffer = SAMPLES_TCP_Package(&global_sdram_meas[2], 0, 2000);
	SCPI_ResultCharacters(context, buffer, TCP_PACKGE_SIZE);
	//memset(buffer,'\0',TCP_PACKGE_SIZE);

	return SCPI_RES_OK;
}


/**
 * @brief
 * parses lists
 * channel numbers > 0.
 * no checks yet.
 * valid: (@1), (@3!1:1!3), ...
 * (@1!1:3!2) would be 1!1, 1!2, 2!1, 2!2, 3!1, 3!2.
 * (@3!1:1!3) would be 3!1, 3!2, 3!3, 2!1, 2!2, 2!3, ... 1!3.
 *
 * @param channel_list channel list, compare to SCPI99 Vol 1 Ch. 8.3.2
 */

/**
 * Reimplement IEEE488.2 *TST?
 *
 * Result should be 0 if everything is ok
 * Result should be 1 if something goes wrong
 *
 * Return SCPI_RES_OK
 */
static scpi_result_t My_CoreTstQ(scpi_t * context)
{

    SCPI_ResultInt32(context, 0);

    return SCPI_RES_OK;
}

static scpi_result_t SCPI_Rst(scpi_t * context)
{

	NVIC_SystemReset();
    return SCPI_RES_OK;
}

static scpi_result_t SCPI_IdnQ(scpi_t * context)
{
	int32_t ptr = 0;
	static char info[46] = {'\0'};

    for (uint8_t i = 0; i < 4; i++)
    {
        if (context->idn[i])
        {
        	ptr += snprintf(info + ptr, sizeof(info) - ptr, "%s,", context->idn[i] );
        }
        else{}
    }

    SCPI_ResultCharacters(context, info, 45);
    return SCPI_RES_OK;
}

const scpi_command_t scpi_commands[] = {
    /* IEEE Mandated Commands (SCPI std V1999.0 4.1.1) */
    { .pattern = "*CLS", .callback = SCPI_CoreCls,},
    { .pattern = "*ESE", .callback = SCPI_CoreEse,},
    { .pattern = "*ESE?", .callback = SCPI_CoreEseQ,},
    { .pattern = "*ESR?", .callback = SCPI_CoreEsrQ,},
    { .pattern = "*IDN?", .callback = SCPI_IdnQ,},
    { .pattern = "*OPC", .callback = SCPI_CoreOpc,},
    { .pattern = "*OPC?", .callback = SCPI_CoreOpcQ,},
    { .pattern = "*RST", .callback = SCPI_Rst,},
    { .pattern = "*SRE", .callback = SCPI_CoreSre,},
    { .pattern = "*SRE?", .callback = SCPI_CoreSreQ,},
    { .pattern = "*STB?", .callback = SCPI_CoreStbQ,},
    { .pattern = "*TST?", .callback = My_CoreTstQ,},
    { .pattern = "*WAI", .callback = SCPI_CoreWai,},

    {.pattern = "STATus:QUEStionable[:EVENt]?", .callback = SCPI_StatusQuestionableEventQ,},
    /* {.pattern = "STATus:QUEStionable:CONDition?", .callback = scpi_stub_callback,}, */
    {.pattern = "STATus:QUEStionable:ENABle", .callback = SCPI_StatusQuestionableEnable,},
    {.pattern = "STATus:QUEStionable:ENABle?", .callback = SCPI_StatusQuestionableEnableQ,},

    {.pattern = "STATus:PRESet", .callback = SCPI_StatusPreset,},

    /* Required SCPI commands (SCPI std V1999.0 4.2.1) */
    {.pattern = "SYSTem:ERRor[:NEXT]?", .callback = SCPI_SystemErrorNextQ,},
    {.pattern = "SYSTem:ERRor:COUNt?", .callback = SCPI_SystemErrorCountQ,},
    {.pattern = "SYSTem:VERSion?", .callback = SCPI_SystemVersionQ,},

	{.pattern = "SYSTem:COMMunicate:LAN:IPADdress", .callback = SCPI_SystemCommunicateLANIPAddress,},
	{.pattern = "SYSTem:COMMunicate:LAN:IPADdress?", .callback = SCPI_SystemCommunicateLANIPAddressQ,},
	{.pattern = "SYSTem:COMMunicate:LAN:SMASk", .callback = SCPI_SystemCommunicateLANIPSmask,},
	{.pattern = "SYSTem:COMMunicate:LAN:SMASk?", .callback = SCPI_SystemCommunicateLANIPSmaskQ,},
	{.pattern = "SYSTem:COMMunicate:LAN:GATEway", .callback = SCPI_SystemCommunicateLANGateway,},
	{.pattern = "SYSTem:COMMunicate:LAN:GATEway?", .callback = SCPI_SystemCommunicateLANGatewayQ,},
	{.pattern = "SYSTem:COMMunicate:LAN:MAC", .callback = SCPI_SystemCommunicateLANMAC,},
	{.pattern = "SYSTem:COMMunicate:LAN:MAC?", .callback = SCPI_SystemCommunicateLANMACQ,},
	{.pattern = "SYSTem:COMMunicate:LAN:PORT", .callback = SCPI_SystemCommunicateLANPort,},
	{.pattern = "SYSTem:COMMunicate:LAN:PORT?", .callback = SCPI_SystemCommunicateLANPortQ,},
	{.pattern = "SYSTem:COMMunication:LAN:UPDate", .callback = SCPI_SystemCommunicationLanUpdate,},
	{.pattern = "SYSTem:SERVice:EEPROM", .callback = SCPI_SystemServiceEEPROM,},
	{.pattern = "SYSTem:SERVice:ID", .callback = SCPI_SystemServiceID,},
	{.pattern = "SYSTem:SECure:STATe", .callback = SCPI_SystemSecureState,},
	{.pattern = "SYSTem:SECure:STATe?", .callback = SCPI_SystemSecureStateQ,},
	{.pattern = "SYSTem:TEMPerature?", .callback = SCPI_SystemTemperatureQ,},
	{.pattern = "SYSTem:TEMPerature:UNIT", .callback = SCPI_SystemTemperatureUnit,},
	{.pattern = "SYSTem:TEMPerature:UNIT?", .callback = SCPI_SystemTemperatureUnitQ,},
	{.pattern = "SYSTem:HUMIdity?", .callback = SCPI_SystemHumidityQ,},
	{.pattern = "SYSTem:SERVice:MODule:INIt", .callback = SCPI_SystemServiceModuleInit,},
	{.pattern = "SYSTem:SERVice:MODule:RESET", .callback = SCPI_SystemServiceModuleReset,},
	{.pattern = "SYSTem:MODule?", .callback = SCPI_SystemModuleQ,},

	{.pattern = "FETCh?", .callback = SCPI_FetchQ,},

	{.pattern = "INITiate", .callback = SCPI_Initiate,},

	{.pattern = "SAMPle:COUNt", .callback = SCPI_SampleCount,},
	{.pattern = "SAMPle:COUNt?", .callback = SCPI_SampleCountQ,},

	{.pattern = "SAMPle:TIMer", .callback = SCPI_SampleTimer,},
	{.pattern = "SAMPle:TIMer?", .callback = SCPI_SampleTimerQ,},

	{.pattern = "READ?", .callback = SCPI_ReadQ,},

	{.pattern = "TRIGger:DELay", .callback = SCPI_TriggerDelay,},
	{.pattern = "TRIGger:DELay?", .callback = SCPI_TriggerDelayQ,},
	{.pattern = "TRIGger[:IMMediate]", .callback = SCPI_TriggerImmediate,},
	{.pattern = "TRIGger:SOURce", .callback = SCPI_TriggerSource,},
	{.pattern = "TRIGger:SOURce?", .callback = SCPI_TriggerSourceQ,},
	{.pattern = "TRIGger:SLOPe", .callback = SCPI_TriggerSlope,},
	{.pattern = "TRIGger:SLOPe?", .callback = SCPI_TriggerSlopeQ,},

	{.pattern = "OUTput:TRIGger", .callback = SCPI_TriggerOutput,},
	{.pattern = "OUTput:TRIGger:SLOPe", .callback = SCPI_TriggerOutputSlope,},
	{.pattern = "OUTput:TRIGger:SLOPe?", .callback = SCPI_TriggerOutputSlopeQ,},
	{.pattern = "*TRG", .callback = SCPI_TRG,},

	{.pattern = "TEST:VOLTage?", .callback = SCPI_TestVoltageQ,},
	{.pattern = "TEST:SDRAM?", .callback = SCPI_TestSDRAMQ,},
	{.pattern = "TEST:ADC?", .callback = SCPI_TestADCQ,},

	{.pattern = "TS?", .callback = TEST_TSQ,},

		SCPI_CMD_LIST_END
};

scpi_interface_t scpi_interface = {
    .error = SCPI_Error,
    .write = SCPI_Write,
    .control = SCPI_Control,
    .flush = SCPI_Flush,
    .reset = SCPI_Reset,
};

char scpi_input_buffer[SCPI_INPUT_BUFFER_LENGTH];
scpi_error_t scpi_error_queue_data[SCPI_ERROR_QUEUE_SIZE];

scpi_t scpi_context;
