BehrensG/ETH3CDAQ1/software/MCU/ETH3CDAQ1_MCU/Core/Inc/bsp.h

/*
 * bsp.h
 *
 *  Created on: Jan 2, 2021
 *      Author: grzegorz
 */

#ifndef INC_BSP_H_
#define INC_BSP_H_

#include "stm32h7xx_hal.h"
#include "scpi/scpi.h"


/*************************************** MISC ***************************************/

enum e_led
{
	LED_IDLE,
	LED_BUSY,
	LED_ERROR,
	LED_DEFUALT,
};

#define BLUE 2
#define RED 1
#define GREEN 0

/*************************************** MODULES ***************************************/

//#define NO_MODULE 0

/*************************************** SCPI ***************************************/

#define SCPI_MANUFACTURER_STRING_LENGTH 16
#define SCPI_DEVICE_STRING_LENGTH 16
#define SCPI_SERIALNUMBER_STRING_LENGTH 16
#define SCPI_SOFTWAREVERSION_STRING_LENGTH 16
#define HOSTNAME_LENGTH 20
#define PASSWORD_LENGTH 16
#define PASSWORD "ETH3CDAQ1"

/*************************************** ETHERNET ***************************************/

#define IP_ADDRESS_0 192
#define IP_ADDRESS_1 168
#define IP_ADDRESS_2 0
#define IP_ADDRESS_3 123

#define NETMASK_ADDRESS_0 255
#define NETMASK_ADDRESS_1 255
#define NETMASK_ADDRESS_2 255
#define NETMASK_ADDRESS_3 0

#define GATEWAY_ADDRESS_0 192
#define GATEWAY_ADDRESS_1 168
#define GATEWAY_ADDRESS_2 0
#define GATEWAY_ADDRESS_3 1

#define MAC_0 0x00
#define MAC_1 0x80
#define MAC_2 0xE1
#define MAC_3 0x00
#define MAC_4 0x00
#define MAC_5 0x00

#define TCPIP_DEFAULT_PORT 2000

/*************************************** MCU ***************************************/



#define	SR_INVERT_MASK	0xFF

#define MCU_SERVICE_SECURITY_OFF 0
#define MCU_SERVICE_SECURITY_ON 1

#define MODULE_MAX_NUMBER 24

#define CHANNEL1	0
#define CHANNEL2	1
#define CHANNEL3	2

/*************************************** TLA2528 ***************************************/

#define TLA2528_ADDRESS 			(0x17<<1)
#define TLA2528_SINGLE_REG_READ 	0x10
#define TLA2528_SINGLE_REG_WRITE 	0x08
#define TLA2528_SET_BIT		 		0x18
#define TLA2528_CLEAR_BIT			0x20
#define TLA2528_BLOCK_READ	 		0x30
#define TLA2528_BLOCK_WRITE	 		0x28
#define TLA2528_READ				0x01
#define TLA2528_OSR_CFG_REG			0x03
#define TLA2528_OSR_CHANNEL_SEL_REG	0x11
#define TLA2528_OSR_16				0x04

#define TLA2528_VOLT_LSB			0.0000763

/*************************************** I2C EEPROM ***************************************/



/*************************************** MCU ***************************************/


typedef enum
{
  BSP_OK       				= 0x00U,
  BSP_ERROR    				= 0x01U,
  BSP_BUSY     				= 0x02U,
  BSP_TIMEOUT  				= 0x03U,
  BSP_ADC_CONFIG_ERROR 		= 0x04U,
  BSP_EEPROM_EMPTY 			= 0x05U,
  BSP_EEPROM_MAX_SIZE 		= 0x06U,
  BSP_EEPROM_NO_CONNECTION 	= 0x07U,
  BSP_EEPROM_WRITE_ERROR 	= 0x08U,
  BSP_EEPROM_READ_ERROR 	= 0x09U,
  BSP_MODULE_MISSING		= 0x0AU
} BSP_StatusTypeDef;



#define	SR_INVERT_MASK	0xFF

#define MCU_SERVICE_SECURITY_OFF 0
#define MCU_SERVICE_SECURITY_ON 1

#define MODULE_MAX_NUMBER 24
#define EEPROM_CFG_SIZE 254

#define SDRAM_CHx_SAMPLES_MAX 1000000
#define CHANNELS 3



#pragma pack(push, 1)

// size 64
typedef struct bsp_scpi_info
{
	char manufacturer[SCPI_MANUFACTURER_STRING_LENGTH];
	char device[SCPI_DEVICE_STRING_LENGTH];
	char serial_number[SCPI_SERIALNUMBER_STRING_LENGTH];
	char software_version[SCPI_SOFTWAREVERSION_STRING_LENGTH];

}bsp_scpi_info_t;


// size 20
typedef struct bsp_ip4_lan
{
	uint8_t ip[4];
	uint8_t netmask[4];
	uint8_t gateway[4];
	uint8_t MAC[6];
	uint16_t port;

}bsp_ip4_lan_t;


typedef struct bsp_adc_calib
{
	float gain;
	float offset;
	uint8_t valid;

}bsp_adc_calib_t;

typedef struct bsp_module_eeporm_list
{
	uint32_t serial;
	uint8_t channel;

}bsp_module_eeporm_list_t;

typedef struct bsp_calibration_date
{
	uint8_t day;
	uint8_t month;
	uint16_t year;
	uint8_t hour;
	uint8_t minute;
	uint8_t second;

}bsp_calibration_date_t;

typedef union bsp_eeprom_union
{
	struct data
	{
		// Size 20
		bsp_ip4_lan_t ip4;
		// Size 64
		bsp_scpi_info_t info;
		// Size 24
		bsp_adc_calib_t calibration[3];
		// Size 19
		int8_t password[PASSWORD_LENGTH];
		// Known module serial numbers. Will be updated when the calibration of the modules was done.
		// Size 120
		bsp_module_eeporm_list_t modules[MODULE_MAX_NUMBER];

		// Size 7
		bsp_calibration_date_t date;

	}structure;
	uint8_t bytes[EEPROM_CFG_SIZE];

}bsp_eeprom_union_t;

#pragma pack(pop)

// size 17
typedef struct bsp_security
{
	scpi_bool_t status;

}bsp_security_t;

typedef struct bsp_trigger
{

	uint8_t in_slope;
	uint8_t out_slope;
	uint32_t delay;
	uint8_t source;
	uint32_t count;

}bsp_trigger_t;

typedef struct bsp_temperature
{
	uint8_t unit;

}bsp_temperature_t;


typedef struct bsp_module
{
	uint8_t mounted;
	uint8_t valid;

}bsp_module_t;

typedef struct bsp_adc
{
	float zero_offset;
	uint8_t range;
}bsp_adc_t;

typedef struct bsp_sdram
{
	uint32_t index;
	uint32_t size;
}bsp_sdram_t;

typedef struct bsp_samples
{
	uint32_t count;
	uint32_t timer;
}bsp_samples_t;

struct _bsp
{
	bsp_eeprom_union_t eeprom;
	bsp_trigger_t trigger;
	bsp_security_t security;
	bsp_temperature_t temperature;
	bsp_ip4_lan_t ip4;
	bsp_module_t module[3];
	bsp_adc_t adc[3];
	bsp_sdram_t sdram[3];
	bsp_samples_t samples;

	uint8_t default_cfg;

}bsp;

enum trigger_enum
{
	TRG_IMM = 1,
	TRG_EXT = 2,
	TRG_BUS = 3,
	TRG_OUT = 4
};

enum trigger_slope_enum
{
	POS = 1,
	NEG = 2
};


BSP_StatusTypeDef BSP_Init();



#endif /* INC_BSP_H_ */
