BehrensG/ETH3CDAQ1/software/MCU/ETH3CDAQ1_MCU/Core/Src/bsp.c

/*
 * bsp.c
 *
 *  Created on: Jun 11, 2021
 *      Author: grzegorz
 */
#include <string.h>

#include "bsp.h"
#include "ADS8681.h"
#include "scpi_def.h"
#include "eeprom.h"

static void BSP_Init_Common()
{

	bsp.samples.count = 1;
	bsp.samples.timer = 1;

	bsp.sdram[0].index = 0;
	bsp.sdram[0].size = 0;
	bsp.sdram[1].index = 0;
	bsp.sdram[1].size = 0;
	bsp.sdram[2].index = 0;
	bsp.sdram[2].size = 0;

	bsp.adc[0].zero_offset = 0.0;
	bsp.adc[0].range = ADS8681_RANGE_3VREF;
	bsp.adc[1].zero_offset = 0.0;
	bsp.adc[1].range = ADS8681_RANGE_3VREF;
	bsp.adc[2].zero_offset = 0.0;
	bsp.adc[2].range = ADS8681_RANGE_3VREF;

	bsp.trigger.delay = 0;
	bsp.trigger.in_slope = POS;
	bsp.trigger.out_slope = POS;
	bsp.trigger.source = TRG_IMM;
	bsp.trigger.count = 0;

}


static void BSP_Init_DefualtEEPROM()
{
	bsp.eeprom.structure.ip4.MAC[0] = MAC_0;
	bsp.eeprom.structure.ip4.MAC[1] = MAC_1;
	bsp.eeprom.structure.ip4.MAC[2] = MAC_2;
	bsp.eeprom.structure.ip4.MAC[3] = MAC_3;
	bsp.eeprom.structure.ip4.MAC[4] = MAC_4;
	bsp.eeprom.structure.ip4.MAC[5] = MAC_5;

	bsp.eeprom.structure.ip4.gateway[0] = GATEWAY_ADDRESS_0;
	bsp.eeprom.structure.ip4.gateway[1] = GATEWAY_ADDRESS_1;
	bsp.eeprom.structure.ip4.gateway[2] = GATEWAY_ADDRESS_2;
	bsp.eeprom.structure.ip4.gateway[3] = GATEWAY_ADDRESS_3;

	bsp.eeprom.structure.ip4.ip[0] = IP_ADDRESS_0;
	bsp.eeprom.structure.ip4.ip[1] = IP_ADDRESS_1;
	bsp.eeprom.structure.ip4.ip[2] = IP_ADDRESS_2;
	bsp.eeprom.structure.ip4.ip[3] = IP_ADDRESS_3;

	bsp.eeprom.structure.ip4.netmask[0] = NETMASK_ADDRESS_0;
	bsp.eeprom.structure.ip4.netmask[1] = NETMASK_ADDRESS_1;
	bsp.eeprom.structure.ip4.netmask[2] = NETMASK_ADDRESS_2;
	bsp.eeprom.structure.ip4.netmask[3] = NETMASK_ADDRESS_3;

	for (uint8_t x = 0; x < MODULE_MAX_NUMBER; x++)
	{
		bsp.eeprom.structure.modules[x].serial = 0;
	}


	bsp.eeprom.structure.calibration[0].gain = (float)1.0;
	bsp.eeprom.structure.calibration[0].offset = (float)0.0;
	bsp.eeprom.structure.calibration[0].valid = TRUE;
	bsp.eeprom.structure.calibration[1].gain = (float)1.0;
	bsp.eeprom.structure.calibration[1].offset = (float)0.0;
	bsp.eeprom.structure.calibration[1].valid = TRUE;
	bsp.eeprom.structure.calibration[2].gain = (float)1.0;
	bsp.eeprom.structure.calibration[2].offset = (float)0.0;
	bsp.eeprom.structure.calibration[2].valid = TRUE;

	strncpy(bsp.eeprom.structure.password, PASSWORD, PASSWORD_LENGTH);
	strncpy(bsp.eeprom.structure.info.manufacturer, SCPI_IDN1, SCPI_MANUFACTURER_STRING_LENGTH);
	strncpy(bsp.eeprom.structure.info.device, SCPI_IDN2, SCPI_DEVICE_STRING_LENGTH);
	strncpy(bsp.eeprom.structure.info.serial_number, SCPI_IDN4, SCPI_SERIALNUMBER_STRING_LENGTH);
	strncpy(bsp.eeprom.structure.info.software_version, SCPI_IDN3, SCPI_SOFTWAREVERSION_STRING_LENGTH);

}

static void BSP_Init_IP4Current()
{
	bsp.ip4.MAC[0] = bsp.eeprom.structure.ip4.MAC[0];
	bsp.ip4.MAC[1] = bsp.eeprom.structure.ip4.MAC[1];
	bsp.ip4.MAC[2] = bsp.eeprom.structure.ip4.MAC[2];
	bsp.ip4.MAC[3] = bsp.eeprom.structure.ip4.MAC[3];
	bsp.ip4.MAC[4] = bsp.eeprom.structure.ip4.MAC[4];
	bsp.ip4.MAC[5] = bsp.eeprom.structure.ip4.MAC[5];

	bsp.ip4.gateway[0] = bsp.eeprom.structure.ip4.gateway[0];
	bsp.ip4.gateway[1] = bsp.eeprom.structure.ip4.gateway[1];
	bsp.ip4.gateway[2] = bsp.eeprom.structure.ip4.gateway[2];
	bsp.ip4.gateway[3] = bsp.eeprom.structure.ip4.gateway[3];

	bsp.ip4.ip[0] = bsp.eeprom.structure.ip4.ip[0];
	bsp.ip4.ip[1] = bsp.eeprom.structure.ip4.ip[1];
	bsp.ip4.ip[2] = bsp.eeprom.structure.ip4.ip[2];
	bsp.ip4.ip[3] = bsp.eeprom.structure.ip4.ip[3];

	bsp.ip4.netmask[0] = bsp.eeprom.structure.ip4.netmask[0];
	bsp.ip4.netmask[1] = bsp.eeprom.structure.ip4.netmask[1];
	bsp.ip4.netmask[2] = bsp.eeprom.structure.ip4.netmask[2];
	bsp.ip4.netmask[3] = bsp.eeprom.structure.ip4.netmask[3];
}

BSP_StatusTypeDef BSP_Init()
{
	BSP_StatusTypeDef eeprom_status;

	BSP_Init_Common();

	if(!((LL_GPIO_ReadInputPort(MCU_DEFAULT_GPIO_Port))& MCU_DEFAULT_Pin))
	{
		BSP_Init_DefualtEEPROM();
		BSP_Init_IP4Current();
		bsp.default_cfg = 1;
	}
	else
	{
		eeprom_status = EEPROM_Status();

		switch (eeprom_status)
		{
			case BSP_EEPROM_EMPTY:
			{
				BSP_Init_DefualtEEPROM();
				eeprom_status = EEPROM_Write(&bsp.eeprom, EEPROM_CFG_SIZE);
				eeprom_status = EEPROM_Read(&bsp.eeprom, EEPROM_CFG_SIZE);
				if(BSP_OK == eeprom_status)
				{
					BSP_Init_IP4Current();
					bsp.default_cfg = 0;
				}; break;
			}
			case BSP_OK:
			{
				eeprom_status = EEPROM_Read(&bsp.eeprom, EEPROM_CFG_SIZE);
				if(BSP_OK == eeprom_status)
				{
					BSP_Init_IP4Current();
					bsp.default_cfg = 0;
				}; break;
			}
			default:
			{
				BSP_Init_DefualtEEPROM();
				BSP_Init_IP4Current();
				bsp.default_cfg = 1;
			}; break;
		}

	}

	return eeprom_status;
}
