BehrensG/ETH3CDAQ1/software/MCU/ETH3CDAQ1_MCU/Core/Inc/scpi_initiate.h

/*
 * scpi_initiate.h
 *
 *  Created on: 21.06.2021
 *      Author: BehrensG
 */

#ifndef INC_SCPI_INITIATE_H_
#define INC_SCPI_INITIATE_H_

#include "scpi/scpi.h"

scpi_result_t SCPI_Initiate(scpi_t * context);

#endif /* INC_SCPI_INITIATE_H_ */
