BehrensG/ETH3CDAQ1/software/MCU/ETH3CDAQ1_MCU/Core/Inc/scpi_read.h

/*
 * scpi_read.h
 *
 *  Created on: Jun 13, 2021
 *      Author: grzegorz
 */

#ifndef INC_SCPI_READ_H_
#define INC_SCPI_READ_H_

#include "scpi/scpi.h"

scpi_result_t SCPI_ReadQ(scpi_t * context);

#endif /* INC_SCPI_READ_H_ */
