BehrensG/ETH3CDAQ1/software/MCU/ETH3CDAQ1_MCU/Core/Inc/scpi_fetch.h

/*
 * scpi_fetch.h
 *
 *  Created on: Jun 11, 2021
 *      Author: grzegorz
 */

#ifndef INC_SCPI_FETCH_H_
#define INC_SCPI_FETCH_H_

#include "scpi/scpi.h"

scpi_result_t SCPI_FetchQ(scpi_t * context);

#endif /* INC_SCPI_FETCH_H_ */
