BehrensG/ETH3CDAQ1/software/MCU/ETH3CDAQ1_MCU/Core/Inc/scpi_test.h

/*
 * scpi_test.h
 *
 *  Created on: Jan 5, 2021
 *      Author: grzegorz
 */

#ifndef INC_SCPI_TEST_H_
#define INC_SCPI_TEST_H_

scpi_result_t SCPI_TestVoltageQ(scpi_t * context);
scpi_result_t SCPI_TestSDRAMQ(scpi_t * context);
scpi_result_t SCPI_TestADCQ(scpi_t * context);

#endif /* INC_SCPI_TEST_H_ */
