BehrensG/ETH3CDAQ1/(commit log)

2020-11-12 Schematic design
    [Channel1.sch, Channels.sch, Connector.sch, ETH3CDAQ1.kicad_pcb, ETH3CDAQ1.sch, Ethernet.sch, MCU.sch, Power.sch]
2020-11-15 Schematic design.
    [Channel1.sch, Channel2.sch, Channel3.sch, Connector.sch, ETH3CDAQ1.kicad_pcb, ETH3CDAQ1_BASE.kicad_pcb, ETH3CDAQ1_BASE.sch, Power.sch]
2020-11-17 PCB layout
    [Channel1.sch, Channel2.sch, Channel3.sch, Connector.sch, ETH3CDAQ1_BASE.kicad_pcb, ETH3CDAQ1_BASE.sch, Power.sch]
2020-11-18 PCB layout.
    [Channel1.sch, Channel2.sch, Channel3.sch, Connector.sch, ETH3CDAQ1_BASE.kicad_pcb, ETH3CDAQ1_BASE.sch, Power.sch]
2020-11-18 Measurement module development.
    [Channel1.sch, Connectors.sch, ETH3CDAQ1_BASE.kicad_pcb, ETH3CDAQ1_MEASURE.kicad_pcb, ETH3CDAQ1_MEASURE.sch, Ethernet.sch, MCU.sch, SDRAM.sch]
2020-11-19 Meas. module schematic design.
    [Channel1.sch, Connectors.sch, DAC.sch, ETH3CDAQ1_MEASURE.sch, Ethernet.sch, MCU.sch, Power.sch, SDRAM.sch]
2020-11-22 PCB design
    [Channel1.sch, Channel2.sch, Channel3.sch, DAC.sch, ETH3CDAQ1_BASE.kicad_pcb, ETH3CDAQ1_MEASURE.kicad_pcb, ETH3CDAQ1_MEASURE.sch]
2020-11-27 Small modification
    [ETH3CDAQ1_MEASURE.kicad_pcb]
2020-11-27 Started development of first current measurement module. Added CAN to the DAQ module.
    [CH1_CONN.sch, CH2_CONN.sch, CH3_CONN.sch, Channel1.sch, Channel2.sch, Channel3.sch, Connector1.sch, DAC.sch]
2020-11-28 Voltage front-end development
    [Channel1.sch, Channel2.sch, Channel3.sch, ETH3CDAQ1_BASE.kicad_pcb, ETH3CDAQ1_BASE.sch, ETH3CDAQ1_CURRENT_ISO_T1.sch, ETH3CDAQ1_MEASURE.kicad_pcb, ETH3CDAQ1_VOLTAGE_ISO_T1.kicad_pcb]
2020-11-29 Voltage module done.
    [ETH3CDAQ1_VOLTAGE_ISO_T1.kicad_pcb, ETH3CDAQ1_VOLTAGE_ISO_T1.sch]
2020-11-30 Current module development.
    [ETH3CDAQ1_CURRENT_ISO_T2.kicad_pcb, ETH3CDAQ1_CURRENT_ISO_T2.sch]
2020-11-30 Modifications in PCBs.
    [ETH3CDAQ1_CURRENT_ISO_T2.kicad_pcb, ETH3CDAQ1_MEASURE.kicad_pcb, ETH3CDAQ1_VOLTAGE_ISO_T1.kicad_pcb]
2020-12-01 Current module development
    [ETH3CDAQ1_CURRENT_ISO_T1.sch]
2020-12-03 Added selftest circuit in the base PCB.
    [Channel1.sch, Channel2.sch, Channel3.sch, Connector.sch, ETH3CDAQ1_BASE.kicad_pcb, ETH3CDAQ1_BASE.sch, ETH3CDAQ1_MEASURE.kicad_pcb, Power.sch]
2020-12-04 PCB design.
    [ETH3CDAQ1_CURRENT_ISO_T2.kicad_pcb]
2020-12-04 Revert "PCB design"
    This reverts commit 7e60bb31762e39c58652df4eecb6f638629803d3.
    [ETH3CDAQ1_CURRENT_ISO_T1.kicad_pcb]
2020-12-04 Revert "Revert "PCB design""
    This reverts commit e51338887ee5d44a68eac03a1fbbc2a91ecb03d8.
    [ETH3CDAQ1_CURRENT_ISO_T1.kicad_pcb]
2020-12-06 PCB design done
    [ETH3CDAQ1_BASE.kicad_pcb, ETH3CDAQ1_CURRENT_ISO_T1.kicad_pcb, ETH3CDAQ1_CURRENT_ISO_T2.kicad_pcb, ETH3CDAQ1_MEASURE.kicad_pcb]
2020-12-07 Modifications in PCB and schematic in the base module.
    [ETH3CDAQ1_BASE.kicad_pcb, ETH3CDAQ1_BASE.sch, Selftest.sch]
2020-12-07 Base module PCB modifications.
    [ETH3CDAQ1_BASE.kicad_pcb]
2020-12-11 Modification in PCBs. Created BOM files.
    [CH1_CONN.sch, CH2_CONN.sch, CH3_CONN.sch, Channel1.sch, Channel2.sch, Channel3.sch, Connector1.sch, DAC.sch]
2020-12-12 Modification in measurement module PCB.
    [ETH3CDAQ1_BASE.kicad_pcb, ETH3CDAQ1_CURRENT_ISO_T1.csv, ETH3CDAQ1_CURRENT_ISO_T1.kicad_pcb, ETH3CDAQ1_CURRENT_ISO_T1.ods, ETH3CDAQ1_MEASURE.ods]
2020-12-14 Development of new measurement module. High precision ADC.
    [ADC1.sch, ADC2.sch, ADC3.sch, CH1_CONN.sch, CH2_CONN.sch, CH3_CONN.sch, Connector.sch, ETH3CADC1.kicad_pcb]
2020-12-16 PCB modifications
    [ADC1.sch, ETH3CADC1.kicad_pcb, ETH3CDAQ1_BASE.kicad_pcb, Ethernet.sch, MCU.sch]
2020-12-23 Fixed mistake with DG419. Never use DG419Lxx variant.
    [ADC1.sch, ADC2.sch, ADC3.sch, Channel1.sch, Channel2.sch, Channel3.sch, ETH3CDAQ1_BASE.csv, ETH3CDAQ1_BASE.ods]
2020-12-27 STM32H7+FreeRTOS+LwIP works, thanks to this guide https://community.st.com/s/article/How-to-create-project-for-STM32H7-with-Ethernet-and-LwIP-stack-working. Add a 100ms delay before LWiP Init functio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
    [Channel1.sch, Channel2.sch, Channel3.sch]
2020-12-29 SDRAM works, thanks to the website https://medium.com/@pjinwoo123/stm32h7-external-sdram-evaluation-board-cc72444898d8 . Modified the code to work with SDRAM BANK2. SCPI library works.
    [ADC1.sch, CH1_CONN.sch, CH2_CONN.sch, CH3_CONN.sch, Connector.sch, ETH3CADC1.kicad_pcb, ETH3CADC1.sch, Ethernet.sch]
2021-01-02 Changed 24LC08 to 24LC024. Added fixes to ethernetif.c to solve the problem with D Cache and RX deadlock. The fixes are also in ethernetif_fix.c, because code generator will overwrite ethernetif.c.
    [ETH3CDAQ1_CURRENT_ISO_T1.kicad_pcb, ETH3CDAQ1_CURRENT_ISO_T1.sch, MCU.sch]
2021-01-05 Added SDRAM to the linker file.
    [ADC1.sch, ETH3CADC1.kicad_pcb, ETH3CADC1.sch, ETH3CDAQ1_VOLTAGE_ISO_T1.kicad_pcb, ETH3CDAQ1_VOLTAGE_ISO_T1.sch, Ethernet.sch, FPGA1.sch, MCU.sch]
2021-01-10 PCB and software development.
    [ADC1.sch, ETH3CADC1.kicad_pcb, ETH3CDAQ1_BASE.kicad_pcb, ETH3CDAQ1_MEASURE.sch, FPGA1.sch, MCU.sch, Selftest.sch]
2021-01-15 DAC SPI connection works. Changed ethernetif_fix.c
2021-02-22 Software development.
    [ADC1.sch, ADC2.sch, ADC3.sch, CH1_CONN.sch, CH2_CONN.sch, CH3_CONN.sch, Connector.sch, ETH3CADC1.csv]
2021-06-05 Software development for ADC control.
2021-06-18 EEPROM function doesn't work for base board and modules.
    [PCA9557.c, PCA9557.h, bsp.c, ee24Config.h, main.c, module.c, module.h, scpi_def.c]
2021-06-23 Fixed problems with the EEPROM functions.
    [PCA9557.c, ee24Config.h, main.c, module.c, scpi_server.c, scpi_system.c]
2021-06-24 Fixed module gain control function.
    [PCA9557.c, module.h, scpi_def.c]
